airpocket-soundman/tab5-tang-primer20k-carrier/site/img/render_bottom.png

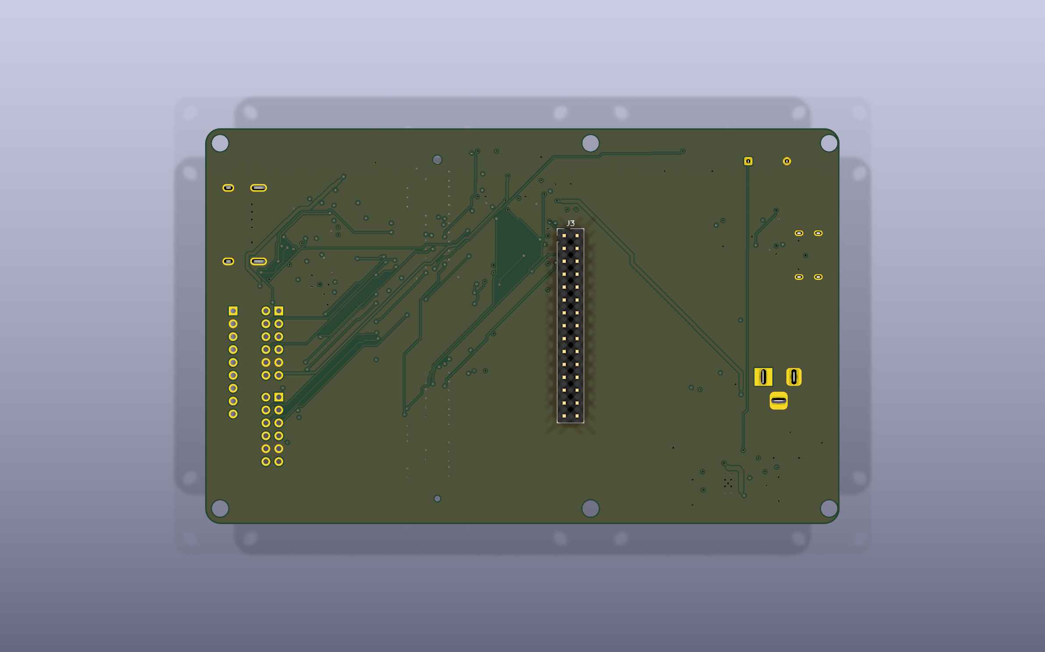
site/img/render_bottom.png
