airpocket-soundman/tab5-tang-primer20k-carrier/site/img/render_top_r2.png

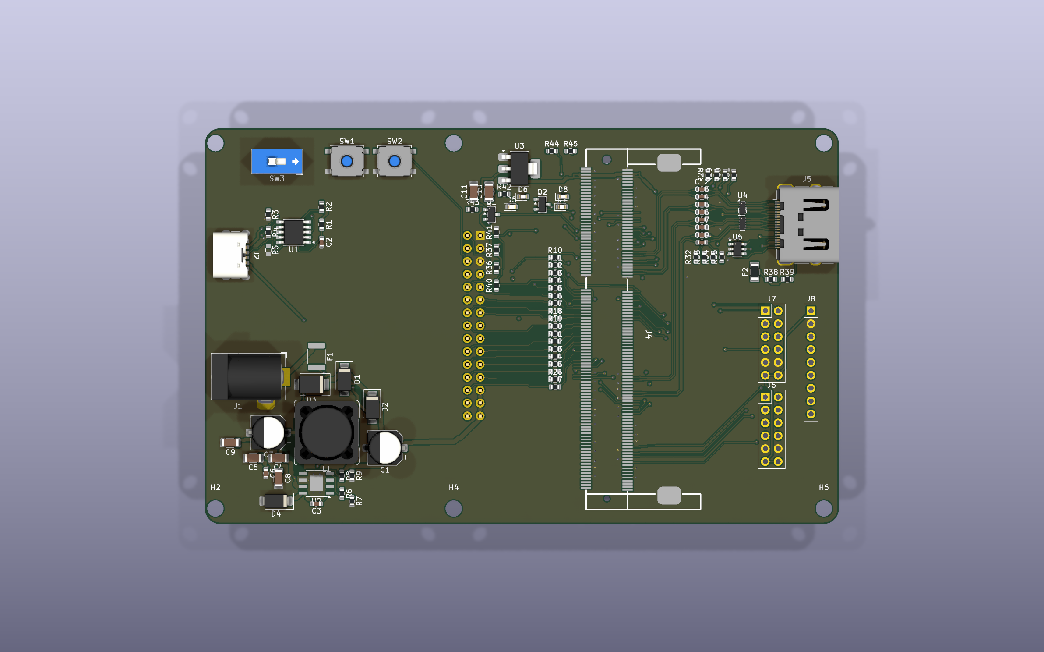
site/img/render_top_r2.png
