airpocket-soundman/tab5-tang-primer20k-carrier/spark/single-sided-r4/full/README.md

# Spark フル版：片面SMT・スイッチ省略 r4

2026-10-26。125×78mm、4層、HDMI・USB PD12V・バレル12Vを維持。
SMTは全て表面。J3（Tab5接続、LCSC C56496）は別購入・手はんだ、PCBA BOM/CPLから除外。
主電源SW3とFPGA専用停止SW3はどちらも搭載しない。外部給電が有効なら電源回路が動作する。

PCBA見積もり候補は101点・43行。J1/JP1等THTの実装受理は業者確認が必要。
U11/R53〜R58/C25/C26はr3の主電源追加部品であり、r4にはない。
部品はLCSC優先。Tab5、Tang Primer 20K Coreはユーザー購入。

設計側PCB DRC0、未接続0、ERCエラー0。ERC警告163件（ライブラリシンボル不一致160件＋孤立ピンラベル3件）。通信・電源の32項目適合、回路図ピン照合一致。
EasyEDA反映とEasyEDA内での実計算は完了。Full207ケース、Lite221ケース。両版PCB DRC0、回路図fatal0/warn13（件数のみ取得、未分類）。
製造業者の部品受理・配置プレビュー・DFMは未承認。コピーされた旧版の検証結果をr4の再計算結果として扱わない。

見積もりデータはdesign/manufacturing以下。BOM/CPLのJ3除外・集合一致を確認済み。
元設計、r2/r3、表面移設の試行は保存し、r4と混用しない。

設計側の電源過渡解析をr4で再実行。Full6件は6件完走・数値範囲内。Liteはスイッチ動作ケースを除く20件が完走し18件が数値範囲内。Liteの50mA負荷と低速LDOループ感度ケースは範囲外であり、通常のローカル3.3V負荷は10mA以内・外部3.3V負荷なしを前提とする。平均化電源モデルであり、物理・熱・実スイッチングの実証ではない。
