airpocket-soundman/tab5-tang-primer20k-carrier/spark/single-sided-r4/quotation-2026-10-26/README.txt

Stars / Spark r4：片面SMT、スイッチ省略。見積もり専用 2026-10-26

Full 125×78mm：4層、PCBA候補101点/43行。
Lite A 99×78mm：4層、PCBA候補103点/43行。
SMTは表面のみ。裏面SMT部品なし。
J3（Tab5用ピンヘッダー）はPCBAから除外。C56496をLCSC別購入し手はんだ。
J3の裏向き嵌合方向は維持。手はんだによる裏面THT取付は、両面SMTではない。
主電源スイッチと旧FPGA専用停止SW3はいずれも省略。
r3のU11/R53〜R58/C25/C26は非搭載ではなくこの設計に存在しない。

JLCPCBには各版の内側gerbers.zip、jlc-bom.csv、jlc-cpl.csvを一組でアップロード。
部品表のLCSC Part #列を部品番号列に明示的に割り当てる。自動マッチで変更された品番は未承認。
SMT片面、表面実装を指定。J1/JP1のTHTを含む全品の受理・工程は業者に確認する。
J1/JP1が実装不可なら同じLCSC部品の別購入・手はんだが必要。
Tab5、Tang Primer 20K Core、ケーブルはPCBA見積もりに含まない。
数量・板厚・銅厚・表面処理・送料・税はこの一式では確定しない。

両版で設計側PCB DRC0/未接続0、ERCエラー0、ERC警告はFull163件／Lite164件（ライブラリシンボル不一致160／161件＋孤立ピンラベル各3件）、通信・電源32項目適合。
EasyEDA反映・同側実計算完了（Full207/Lite221件）。両版PCB DRC0、回路図fatal0/warn13（未分類）。最終製造リリースではない。
r3両面実装の見積もり一式と公開済みの旧ファイルを混ぜないこと。
