airpocket-soundman/tab5-tang-primer20k-carrier/docs/reference/tang-primer-20k/Readme.txt

#####
For Tang_Primer_20K_Dock_Lite: Version 3710 & 3711 share the same schematic.
If you have the version 3710, please also refer to the schematic version 3711.
The new version contains a number of bug fixes.

#####
For Tang_Primer_20K_Dock:
Version 3714 an upgraded version with minor refinements.
Version 3710 & 3711 & 3712 & 3713 share the same schematic.
If you have the version 3710, 3711, 3712, 3713,  
please also refer to the schematic version 3713.
The new version contains a number of bug fixes.
The older version 3708 or 3709 is archived in the old folder.
