airpocket-soundman/tab5-tang-primer20k-carrier/spark/MAIN_POWER_REQUIREMENT.md

# 主電源仕様の訂正（2026-10-26）

ユーザー確認：必要なのはオルタネート式の主電源ON/OFF。外部給電だけを切り、Tab5の内蔵バッテリー動作は停止させない。FPGA専用停止スイッチは要求されていない。

## 対象

- フル125×78mm、廉価版A99×78mmの両方。
- USB PD12VとDCジャック12Vの両入力に対して有効。
- 入力の保護・逆流防止/OR合流後、Tab5 HVINとFPGA用降圧回路へ分岐する前を主電源の制御対象とする。
- 主電源ON：Tab5 HVINとCore用5V/キャリア局所3.3Vへ外部給電。
- 主電源OFF：上記への外部給電を停止。Tab5の内蔵バッテリーと本体電源操作は変更しない。
- 押すごとにON/OFF状態を保持するオルタネート動作。既存のDIPスイッチによるBUCK_EN接地は代用にならない。
- 独立したFPGA停止SW3は削除・置換対象。リセット/ユーザーボタンとBUS ARMは別機能として保持する。

## 変更時の確認

主電源の接点/電力スイッチは12V DC、Tab5+Coreの合計負荷、突入電流、接触抵抗、開閉寿命に適合させる。小信号スイッチの100mA等の定格をそのまま主電流に適用しない。LCSCを優先し、PCBA可否とメーカー図面によるランド/機構を照合する。

Tab5がバッテリーで動作しCoreが無給電の状態で、通信・側帯信号からFPGAへ逆給電しないことを再確認する。既存の電源監視・バス分離・ARMの安全側初期状態を維持する。USB-Cへの逆流防止も保持する。

KiCadで回路/基板変更とシミュレーション、EasyEDAへの反映、EasyEDA内で同条件再計算・照合の順序を維持する。以前のSW3停止試験を新しい主電源の検証済み結果として再利用しない。

Linux/GPU/外部メモリ研究の目的・独立ソフト/ビットストリーム・GPIO割当は維持。電源切替時の通信断はソフトウェア側の既存タイムアウト/リセット要求との整合を確認する。外部DDR3は透過的な主記憶増設ではない。

**状態：要求確定。公開中のepro2/BOMは旧SW3構成であり、この変更は未反映。新しい主電源の品番・配置・解析が確定するまで発注対象にしない。**
