airpocket-soundman/tab5-tang-primer20k-carrier/fpga/validation/npu-ddr-4e20-2026-11-07/report.md

# NPU DDR core diagnostic checkpoint (2026-11-07)

The integrated core wires the packet endpoint and DDR Conv loader through one held-toggle arbiter, unchanged MEMV1 bridge/adapter, and shared4KiB write/read staging RAMs. Only the Conv loader owns staging while conv_busy; the SYS endpoint serializes host commands and rejects overlapping work. Controller reset/PLLhold and physical DDR wrapper preserve the established MEMV1 design. Memory-ready synchronizes through2 SYS stages and256-cycle settle, resets loader/arbiter andUSERoperation state on loss, increments generation (physical reset only resets generation), and clears bound token. A3-SYS configuration reset initializes the framer even if physical reset remains high during FPGA SRAM configuration.

The pin-level test uses the actual framer/core/arbiter/bridge/adapter/RAM/kernel at SYS≈27MHz/USER≈99.56MHz and a native DDR model with correct APP_ROW_PAD1 inverse mapping and ready stalls.64 commands passed: max2032B write/1024B read CRC,16KiB row crossing, last16B of128MiB and overrun rejection, IC16+3 Conv DMA and complete INT32/guard validation, bad/truncated writes with no effects, memory-not-ready caps/status, token binding, calibration loss during host and Conv requests, stale partial rejection after rebind, fresh upload/recompute, generation preservation across ARM, and physical reset recovery. No DDR PHY or board behavior is inferred from simulation.

The first Gowin Education implementation fits:10366 logic,5779 registers,38/46 BSRAM,5/24 DSP. It generates USERcode4E20 and the .fs, but is **not timing-qualified**. With only the3 explicitly related clocks and no exceptions, reports show1408 setup/107 hold violations across vendor/internal resets, held metadata bundles and first CDC stages. Same-domain TNS is0, reported SYS Fmax42.333MHz andUSER109.382MHz. This is a diagnostic checkpoint, not sign-off.

First30 setup paths classify vendor internal12, our held-response11, our held-request7. First30 hold paths are vendor internal3, held-response26, first-sampler1. Recovery first30 include25 vendor reset boundaries,2 vendor internal,3 other CDC. Removal first30 are positive USER same-domain paths. Exact nodes/slacks are in timing-classification.json. No blanket asynchronous-clock waiver has been added. Held payloads have protocol-derived stability windows (response≥2SYS periods, request≥3USER periods) that may justify specific max-delay/hold exceptions after endpoint review; vendor reset/CDC requires separate review.

All8 tested RTL hashes match the implemented source snapshot (proof-source-match.json). Keep vendor encrypted source out of Git; record its pinned hash and reference instead. Programming and controlled128MiB/Conv hardware golden qualification are owned by the parent task and were not performed here.
