airpocket-soundman/tab5-tang-primer20k-carrier/spark/design/easyeda/schematic-netlist.txt

{
    "version": "2.0.0",
    "components": {
        "51bfc0e5166a1c40": {
            "props": {
                "Add into BOM": "yes",
                "Convert to PCB": "yes",
                "Name": "Connector_Barrel_Jack",
                "Device": "44e7ae05c9875e8f",
                "Designator": "J1",
                "Footprint": "60f63300c7161e95",
                "Value": "MJ-179PH",
                "UserDocLink": "",
                "Description": "",
                "ki_keywords": "",
                "ki_fp_filters": "",
                "Symbol": "a6304a09a2937aa2",
                "Comment": "Akizuki106568 manual assembly; center positive stabilized12V only; manufacturer slot drawing adapted; pad2/3 grounded",
                "Origin Footprint": "carrier:BarrelJack_MJ179PH_Akizuki106568",
                "Unique ID": "51bfc0e5166a1c40",
                "Manufacturer": "",
                "Manufacturer Part": "",
                "Supplier": "Akizuki",
                "Supplier Part": "1",
                "LCSC": "",
                "Group ID": "",
                "Channel ID": "$2ie37",
                "Reuse Block": "",
                "DeviceName": "Connector_Barrel_Jack",
                "FootprintName": "carrier:BarrelJack_MJ179PH_Akizuki106568"
            },
            "pinInfoMap": {
                "1": {
                    "name": "",
                    "number": "1",
                    "net": "DC_RAW",
                    "props": {
                        "Pin Number": "1"
                    }
                },
                "2": {
                    "name": "",
                    "number": "2",
                    "net": "GND",
                    "props": {
                        "Pin Number": "2"
                    }
                }
            }
        },
        "09f31a4987c8a883": {
            "props": {
                "Add into BOM": "yes",
                "Convert to PCB": "yes",
                "Name": "Device_Polyfuse",
                "Device": "4e1f7fc7f8494827",
                "Designator": "F1",
                "Footprint": "28b242f2aa997a49",
                "Value": "PTC 3A hold",
                "UserDocLink": "",
                "Description": "",
                "ki_keywords": "",
                "ki_fp_filters": "",
                "Symbol": "c382bbec9e75422f",
                "LCSC": "C47002391",
                "Origin Footprint": "Fuse:Fuse_1812_4532Metric",
                "Unique ID": "09f31a4987c8a883",
                "Manufacturer": "",
                "Manufacturer Part": "",
                "Supplier": "LCSC",
                "Supplier Part": "C47002391",
                "Comment": "",
                "Group ID": "",
                "Channel ID": "$2ie47",
                "Reuse Block": "",
                "DeviceName": "Device_Polyfuse",
                "FootprintName": "Fuse_1812_4532Metric"
            },
            "pinInfoMap": {
                "1": {
                    "name": "",
                    "number": "1",
                    "net": "DC_RAW",
                    "props": {
                        "Pin Number": "1"
                    }
                },
                "2": {
                    "name": "",
                    "number": "2",
                    "net": "DC_IN",
                    "props": {
                        "Pin Number": "2"
                    }
                }
            }
        },
        "6eb2f7ba7a12821c": {
            "props": {
                "Add into BOM": "yes",
                "Convert to PCB": "yes",
                "Name": "Device_D_Schottky",
                "Device": "d3ddc644d9a554ad",
                "Designator": "D1",
                "Footprint": "4ee42137ec565186",
                "Value": "SS54",
                "UserDocLink": "",
                "Description": "",
                "ki_keywords": "",
                "ki_fp_filters": "",
                "Symbol": "cfe2022f371c70b2",
                "LCSC": "C22452",
                "Comment": "reverse-polarity + OR (DC jack)",
                "Origin Footprint": "Diode_SMD:D_SMA",
                "Unique ID": "6eb2f7ba7a12821c",
                "Manufacturer": "",
                "Manufacturer Part": "",
                "Supplier": "LCSC",
                "Supplier Part": "C22452",
                "Group ID": "",
                "Channel ID": "$2ie57",
                "Reuse Block": "",
                "DeviceName": "Device_D_Schottky",
                "FootprintName": "D_SMA"
            },
            "pinInfoMap": {
                "1": {
                    "name": "K",
                    "number": "1",
                    "net": "VIN",
                    "props": {
                        "Pin Number": "1"
                    }
                },
                "2": {
                    "name": "A",
                    "number": "2",
                    "net": "DC_IN",
                    "props": {
                        "Pin Number": "2"
                    }
                }
            }
        },
        "cca08e5caf06c018": {
            "props": {
                "Add into BOM": "yes",
                "Convert to PCB": "yes",
                "Name": "Device_D_Schottky",
                "Device": "d3ddc644d9a554ad",
                "Designator": "D2",
                "Footprint": "4ee42137ec565186",
                "Value": "SS54",
                "UserDocLink": "",
                "Description": "",
                "ki_keywords": "",
                "ki_fp_filters": "",
                "Symbol": "cfe2022f371c70b2",
                "LCSC": "C22452",
                "Comment": "OR (USB-C PD)",
                "Origin Footprint": "Diode_SMD:D_SMA",
                "Unique ID": "cca08e5caf06c018",
                "Manufacturer": "",
                "Manufacturer Part": "",
                "Supplier": "LCSC",
                "Supplier Part": "C22452",
                "Group ID": "",
                "Channel ID": "$2ie68",
                "Reuse Block": "",
                "DeviceName": "Device_D_Schottky",
                "FootprintName": "D_SMA"
            },
            "pinInfoMap": {
                "1": {
                    "name": "K",
                    "number": "1",
                    "net": "VIN",
                    "props": {
                        "Pin Number": "1"
                    }
                },
                "2": {
                    "name": "A",
                    "number": "2",
                    "net": "VBUS_PD",
                    "props": {
                        "Pin Number": "2"
                    }
                }
            }
        },
        "81689f1d3303caec": {
            "props": {
                "Add into BOM": "yes",
                "Convert to PCB": "yes",
                "Name": "Device_D_TVS",
                "Device": "151271085e469eeb",
                "Designator": "D3",
                "Footprint": "fbf593d40eae07ec",
                "Value": "SMBJ15A",
                "UserDocLink": "",
                "Description": "",
                "ki_keywords": "",
                "ki_fp_filters": "",
                "Symbol": "69e249b4c76e0e9e",
                "LCSC": "C699013",
                "Comment": "YANGJIE 15V standoff, 24.4V specified clamp; regulated 12V PoC input only",
                "Origin Footprint": "Diode_SMD:D_SMB",
                "Unique ID": "81689f1d3303caec",
                "Manufacturer": "",
                "Manufacturer Part": "",
                "Supplier": "LCSC",
                "Supplier Part": "C699013",
                "Group ID": "",
                "Channel ID": "$2ie79",
                "Reuse Block": "",
                "DeviceName": "Device_D_TVS",
                "FootprintName": "D_SMB"
            },
            "pinInfoMap": {
                "1": {
                    "name": "A1",
                    "number": "1",
                    "net": "VIN",
                    "props": {
                        "Pin Number": "1"
                    }
                },
                "2": {
                    "name": "A2",
                    "number": "2",
                    "net": "GND",
                    "props": {
                        "Pin Number": "2"
                    }
                }
            }
        },
        "b4693cfd16d534cd": {
            "props": {
                "Add into BOM": "yes",
                "Convert to PCB": "yes",
                "Name": "Device_C_Polarized",
                "Device": "570abc226590f959",
                "Designator": "C1",
                "Footprint": "32cfff82c648e20e",
                "Value": "100u/35V",
                "UserDocLink": "",
                "Description": "",
                "ki_keywords": "",
                "ki_fp_filters": "",
                "Symbol": "c8039e3260078d75",
                "LCSC": "C2983388",
                "Origin Footprint": "Capacitor_SMD:CP_Elec_6.3x7.7",
                "Unique ID": "b4693cfd16d534cd",
                "Manufacturer": "",
                "Manufacturer Part": "",
                "Supplier": "LCSC",
                "Supplier Part": "C2983388",
                "Comment": "",
                "Group ID": "",
                "Channel ID": "$2ie90",
                "Reuse Block": "",
                "DeviceName": "Device_C_Polarized",
                "FootprintName": "CP_Elec_6.3x7.7"
            },
            "pinInfoMap": {
                "1": {
                    "name": "",
                    "number": "1",
                    "net": "VIN",
                    "props": {
                        "Pin Number": "1"
                    }
                },
                "2": {
                    "name": "",
                    "number": "2",
                    "net": "GND",
                    "props": {
                        "Pin Number": "2"
                    }
                }
            }
        },
        "1fb9863844ab5169": {
            "props": {
                "Add into BOM": "yes",
                "Convert to PCB": "yes",
                "Name": "Connector_USB_C_Receptacle_PowerOnly_6P",
                "Device": "6003b3d87a38ea01",
                "Designator": "J2",
                "Footprint": "c9dfdb5aba9e1038",
                "Value": "USB-C PD in",
                "UserDocLink": "",
                "Description": "",
                "ki_keywords": "",
                "ki_fp_filters": "",
                "Symbol": "84d8338b97269fd0",
                "LCSC": "C5246813",
                "Comment": "power-only USB-C 6P receptacle",
                "Origin Footprint": "Connector_USB:USB_C_Receptacle_GCT_USB4125-xx-x-0190_6P_TopMnt_Horizontal",
                "Unique ID": "1fb9863844ab5169",
                "Manufacturer": "",
                "Manufacturer Part": "",
                "Supplier": "LCSC",
                "Supplier Part": "C5246813",
                "Group ID": "",
                "Channel ID": "$2ie100",
                "Reuse Block": "",
                "DeviceName": "Connector_USB_C_Receptacle_PowerOnly_6P",
                "FootprintName": "USB_C_Receptacle_GCT_USB4125-xx-x-0190_6P_TopMnt_Horizontal"
            },
            "pinInfoMap": {
                "A5": {
                    "name": "CC1",
                    "number": "A5",
                    "net": "CC1",
                    "props": {
                        "Pin Number": "A5"
                    }
                },
                "A9": {
                    "name": "VBUS",
                    "number": "A9",
                    "net": "VBUS_PD",
                    "props": {
                        "Pin Number": "A9"
                    }
                },
                "A12": {
                    "name": "GND",
                    "number": "A12",
                    "net": "GND",
                    "props": {
                        "Pin Number": "A12"
                    }
                },
                "B5": {
                    "name": "CC2",
                    "number": "B5",
                    "net": "CC2",
                    "props": {
                        "Pin Number": "B5"
                    }
                },
                "B9": {
                    "name": "VBUS",
                    "number": "B9",
                    "net": "VBUS_PD",
                    "props": {
                        "Pin Number": "B9"
                    }
                },
                "B12": {
                    "name": "GND",
                    "number": "B12",
                    "net": "GND",
                    "props": {
                        "Pin Number": "B12"
                    }
                },
                "SH": {
                    "name": "SHIELD",
                    "number": "SH",
                    "net": "GND",
                    "props": {
                        "Pin Number": "SH"
                    }
                }
            }
        },
        "1bdc0ab44f99f92d": {
            "props": {
                "Add into BOM": "yes",
                "Convert to PCB": "yes",
                "Name": "Interface_USB_CH224K",
                "Device": "f4e13c3352c916ae",
                "Designator": "U1",
                "Value": "CH224K",
                "UserDocLink": "",
                "Description": "",
                "ki_keywords": "",
                "ki_fp_filters": "",
                "Origin Footprint": "Package_SO:SSOP-10-1EP_3.9x4.9mm_P1mm_EP2.1x3.3mm",
                "Symbol": "a7267d86b78a6465",
                "LCSC": "C970725",
                "Comment": "PD sink, 12V request: CFG1=0 CFG2=0 CFG3=1(internal PU)",
                "Unique ID": "1bdc0ab44f99f92d",
                "Manufacturer": "",
                "Manufacturer Part": "",
                "Supplier": "LCSC",
                "Supplier Part": "C970725",
                "Footprint": "530feb5bd26552e7",
                "Group ID": "",
                "Channel ID": "$2ie111",
                "Reuse Block": "",
                "DeviceName": "Interface_USB_CH224K",
                "FootprintName": "SSOP-10-1EP_3.9x4.9mm_P1mm_EP2.1x3.3mm"
            },
            "pinInfoMap": {
                "1": {
                    "name": "VDD",
                    "number": "1",
                    "net": "PD_VDD",
                    "props": {
                        "Pin Number": "1"
                    }
                },
                "2": {
                    "name": "CFG2",
                    "number": "2",
                    "net": "PD_CFG2",
                    "props": {
                        "Pin Number": "2"
                    }
                },
                "3": {
                    "name": "CFG3",
                    "number": "3",
                    "net": "PD_CFG3",
                    "props": {
                        "Pin Number": "3"
                    }
                },
                "4": {
                    "name": "DP",
                    "number": "4",
                    "net": "",
                    "props": {
                        "Pin Number": "4"
                    }
                },
                "5": {
                    "name": "DM",
                    "number": "5",
                    "net": "",
                    "props": {
                        "Pin Number": "5"
                    }
                },
                "6": {
                    "name": "CC2",
                    "number": "6",
                    "net": "CC2",
                    "props": {
                        "Pin Number": "6"
                    }
                },
                "7": {
                    "name": "CC1",
                    "number": "7",
                    "net": "CC1",
                    "props": {
                        "Pin Number": "7"
                    }
                },
                "8": {
                    "name": "VBUS",
                    "number": "8",
                    "net": "PD_VBUS_S",
                    "props": {
                        "Pin Number": "8"
                    }
                },
                "9": {
                    "name": "CFG1",
                    "number": "9",
                    "net": "PD_CFG1",
                    "props": {
                        "Pin Number": "9"
                    }
                },
                "10": {
                    "name": "PG",
                    "number": "10",
                    "net": "PD_PG",
                    "props": {
                        "Pin Number": "10"
                    }
                },
                "11": {
                    "name": "GND",
                    "number": "11",
                    "net": "GND",
                    "props": {
                        "Pin Number": "11"
                    }
                }
            }
        },
        "353b166cc2dee846": {
            "props": {
                "Add into BOM": "yes",
                "Convert to PCB": "yes",
                "Name": "Device_R",
                "Device": "dce15ae5d8c4adea",
                "Designator": "R1",
                "Footprint": "840d5114b71a38b1",
                "Value": "10k",
                "UserDocLink": "",
                "Description": "",
                "ki_keywords": "",
                "ki_fp_filters": "",
                "Symbol": "1a6aa3fb7f7fd24f",
                "LCSC": "C25804",
                "Origin Footprint": "Resistor_SMD:R_0603_1608Metric",
                "Unique ID": "353b166cc2dee846",
                "Manufacturer": "",
                "Manufacturer Part": "",
                "Supplier": "LCSC",
                "Supplier Part": "C25804",
                "Comment": "",
                "Group ID": "",
                "Channel ID": "$2ie122",
                "Reuse Block": "",
                "DeviceName": "Device_R",
                "FootprintName": "R_0603_1608Metric"
            },
            "pinInfoMap": {
                "1": {
                    "name": "",
                    "number": "1",
                    "net": "VBUS_PD",
                    "props": {
                        "Pin Number": "1"
                    }
                },
                "2": {
                    "name": "",
                    "number": "2",
                    "net": "PD_VDD",
                    "props": {
                        "Pin Number": "2"
                    }
                }
            }
        },
        "a2c5d49bc5dde298": {
            "props": {
                "Add into BOM": "yes",
                "Convert to PCB": "yes",
                "Name": "Device_C",
                "Device": "ce3f9b769b7a157b",
                "Designator": "C2",
                "Footprint": "6f3d185220f7d357",
                "Value": "1u/50V",
                "UserDocLink": "",
                "Description": "",
                "ki_keywords": "",
                "ki_fp_filters": "",
                "Symbol": "e542132018ff745e",
                "LCSC": "C15849",
                "Origin Footprint": "Capacitor_SMD:C_0603_1608Metric",
                "Unique ID": "a2c5d49bc5dde298",
                "Manufacturer": "",
                "Manufacturer Part": "",
                "Supplier": "LCSC",
                "Supplier Part": "C15849",
                "Comment": "",
                "Group ID": "",
                "Channel ID": "$2ie132",
                "Reuse Block": "",
                "DeviceName": "Device_C",
                "FootprintName": "C_0603_1608Metric"
            },
            "pinInfoMap": {
                "1": {
                    "name": "",
                    "number": "1",
                    "net": "PD_VDD",
                    "props": {
                        "Pin Number": "1"
                    }
                },
                "2": {
                    "name": "",
                    "number": "2",
                    "net": "GND",
                    "props": {
                        "Pin Number": "2"
                    }
                }
            }
        },
        "6f63fc6711cfa315": {
            "props": {
                "Add into BOM": "yes",
                "Convert to PCB": "yes",
                "Name": "Device_R",
                "Device": "dce15ae5d8c4adea",
                "Designator": "R2",
                "Footprint": "840d5114b71a38b1",
                "Value": "1k",
                "UserDocLink": "",
                "Description": "",
                "ki_keywords": "",
                "ki_fp_filters": "",
                "Symbol": "1a6aa3fb7f7fd24f",
                "LCSC": "C21190",
                "Origin Footprint": "Resistor_SMD:R_0603_1608Metric",
                "Unique ID": "6f63fc6711cfa315",
                "Manufacturer": "",
                "Manufacturer Part": "",
                "Supplier": "LCSC",
                "Supplier Part": "C21190",
                "Comment": "",
                "Group ID": "",
                "Channel ID": "$2ie142",
                "Reuse Block": "",
                "DeviceName": "Device_R",
                "FootprintName": "R_0603_1608Metric"
            },
            "pinInfoMap": {
                "1": {
                    "name": "",
                    "number": "1",
                    "net": "VBUS_PD",
                    "props": {
                        "Pin Number": "1"
                    }
                },
                "2": {
                    "name": "",
                    "number": "2",
                    "net": "PD_VBUS_S",
                    "props": {
                        "Pin Number": "2"
                    }
                }
            }
        },
        "fe89d0632cfce75f": {
            "props": {
                "Add into BOM": "yes",
                "Convert to PCB": "yes",
                "Name": "Device_R",
                "Device": "dce15ae5d8c4adea",
                "Designator": "R3",
                "Footprint": "840d5114b71a38b1",
                "Value": "0R",
                "UserDocLink": "",
                "Description": "",
                "ki_keywords": "",
                "ki_fp_filters": "",
                "Symbol": "1a6aa3fb7f7fd24f",
                "LCSC": "C21189",
                "Comment": "CFG1 low (fit)",
                "Origin Footprint": "Resistor_SMD:R_0603_1608Metric",
                "Unique ID": "fe89d0632cfce75f",
                "Manufacturer": "",
                "Manufacturer Part": "",
                "Supplier": "LCSC",
                "Supplier Part": "C21189",
                "Group ID": "",
                "Channel ID": "$2ie152",
                "Reuse Block": "",
                "DeviceName": "Device_R",
                "FootprintName": "R_0603_1608Metric"
            },
            "pinInfoMap": {
                "1": {
                    "name": "",
                    "number": "1",
                    "net": "PD_CFG1",
                    "props": {
                        "Pin Number": "1"
                    }
                },
                "2": {
                    "name": "",
                    "number": "2",
                    "net": "GND",
                    "props": {
                        "Pin Number": "2"
                    }
                }
            }
        },
        "fdc86a4b576d9e98": {
            "props": {
                "Add into BOM": "no",
                "Convert to PCB": "yes",
                "Name": "Device_R",
                "Device": "dce15ae5d8c4adea",
                "Designator": "R4",
                "Footprint": "840d5114b71a38b1",
                "Value": "0R",
                "UserDocLink": "",
                "Description": "",
                "ki_keywords": "",
                "ki_fp_filters": "",
                "Symbol": "1a6aa3fb7f7fd24f",
                "LCSC": "C21189",
                "Comment": "Must remain DNP: CFG3 internal pull-up for 12V request",
                "Origin Footprint": "Resistor_SMD:R_0603_1608Metric",
                "Unique ID": "fdc86a4b576d9e98",
                "Manufacturer": "",
                "Manufacturer Part": "",
                "Supplier": "LCSC",
                "Supplier Part": "C21189",
                "Group ID": "",
                "Channel ID": "$2ie163",
                "Reuse Block": "",
                "DeviceName": "Device_R",
                "FootprintName": "R_0603_1608Metric"
            },
            "pinInfoMap": {
                "1": {
                    "name": "",
                    "number": "1",
                    "net": "PD_CFG3",
                    "props": {
                        "Pin Number": "1"
                    }
                },
                "2": {
                    "name": "",
                    "number": "2",
                    "net": "GND",
                    "props": {
                        "Pin Number": "2"
                    }
                }
            }
        },
        "9cdd622c9eeecfe7": {
            "props": {
                "Add into BOM": "yes",
                "Convert to PCB": "yes",
                "Name": "Device_R",
                "Device": "dce15ae5d8c4adea",
                "Designator": "R5",
                "Footprint": "840d5114b71a38b1",
                "Value": "0R",
                "UserDocLink": "",
                "Description": "",
                "ki_keywords": "",
                "ki_fp_filters": "",
                "Symbol": "1a6aa3fb7f7fd24f",
                "LCSC": "C21189",
                "Comment": "Fitted: CFG2 low, CFG1 low, CFG3 high -> 12V",
                "Origin Footprint": "Resistor_SMD:R_0603_1608Metric",
                "Unique ID": "9cdd622c9eeecfe7",
                "Manufacturer": "",
                "Manufacturer Part": "",
                "Supplier": "LCSC",
                "Supplier Part": "C21189",
                "Group ID": "",
                "Channel ID": "$2ie174",
                "Reuse Block": "",
                "DeviceName": "Device_R",
                "FootprintName": "R_0603_1608Metric"
            },
            "pinInfoMap": {
                "1": {
                    "name": "",
                    "number": "1",
                    "net": "PD_CFG2",
                    "props": {
                        "Pin Number": "1"
                    }
                },
                "2": {
                    "name": "",
                    "number": "2",
                    "net": "GND",
                    "props": {
                        "Pin Number": "2"
                    }
                }
            }
        },
        "48f0ae2437312dae": {
            "props": {
                "Add into BOM": "yes",
                "Convert to PCB": "yes",
                "Name": "Regulator_Switching_TPS5430DDA",
                "Device": "3eb9113f27af965f",
                "Designator": "U2",
                "Value": "TPS5430DDAR",
                "UserDocLink": "",
                "Description": "",
                "ki_keywords": "",
                "ki_fp_filters": "",
                "Origin Footprint": "Package_SO:TI_SO-PowerPAD-8_ThermalVias",
                "Symbol": "860f7642b2115685",
                "LCSC": "C9864",
                "Unique ID": "48f0ae2437312dae",
                "Manufacturer": "",
                "Manufacturer Part": "",
                "Supplier": "LCSC",
                "Supplier Part": "C9864",
                "Footprint": "aba8afa3fc1c660b",
                "Comment": "",
                "Group ID": "",
                "Channel ID": "$2ie185",
                "Reuse Block": "",
                "DeviceName": "Regulator_Switching_TPS5430DDA",
                "FootprintName": "TI_SO-PowerPAD-8_ThermalVias"
            },
            "pinInfoMap": {
                "1": {
                    "name": "BOOT",
                    "number": "1",
                    "net": "BUCK_BOOT",
                    "props": {
                        "Pin Number": "1"
                    }
                },
                "2": {
                    "name": "NC",
                    "number": "2",
                    "net": "",
                    "props": {
                        "Pin Number": "2"
                    }
                },
                "3": {
                    "name": "NC",
                    "number": "3",
                    "net": "",
                    "props": {
                        "Pin Number": "3"
                    }
                },
                "4": {
                    "name": "VSENSE",
                    "number": "4",
                    "net": "BUCK_FB",
                    "props": {
                        "Pin Number": "4"
                    }
                },
                "5": {
                    "name": "EN",
                    "number": "5",
                    "net": "BUCK_EN",
                    "props": {
                        "Pin Number": "5"
                    }
                },
                "6": {
                    "name": "GND",
                    "number": "6",
                    "net": "GND",
                    "props": {
                        "Pin Number": "6"
                    }
                },
                "7": {
                    "name": "VIN",
                    "number": "7",
                    "net": "VIN",
                    "props": {
                        "Pin Number": "7"
                    }
                },
                "8": {
                    "name": "PH",
                    "number": "8",
                    "net": "BUCK_PH",
                    "props": {
                        "Pin Number": "8"
                    }
                },
                "9": {
                    "name": "GNDPAD",
                    "number": "9",
                    "net": "GND",
                    "props": {
                        "Pin Number": "9"
                    }
                }
            }
        },
        "cc82bf2c2e22e605": {
            "props": {
                "Add into BOM": "yes",
                "Convert to PCB": "yes",
                "Name": "Device_C",
                "Device": "ce3f9b769b7a157b",
                "Designator": "C3",
                "Footprint": "6f3d185220f7d357",
                "Value": "10n",
                "UserDocLink": "",
                "Description": "",
                "ki_keywords": "",
                "ki_fp_filters": "",
                "Symbol": "e542132018ff745e",
                "LCSC": "C57112",
                "Origin Footprint": "Capacitor_SMD:C_0603_1608Metric",
                "Unique ID": "cc82bf2c2e22e605",
                "Manufacturer": "",
                "Manufacturer Part": "",
                "Supplier": "LCSC",
                "Supplier Part": "C57112",
                "Comment": "",
                "Group ID": "",
                "Channel ID": "$2ie195",
                "Reuse Block": "",
                "DeviceName": "Device_C",
                "FootprintName": "C_0603_1608Metric"
            },
            "pinInfoMap": {
                "1": {
                    "name": "",
                    "number": "1",
                    "net": "BUCK_BOOT",
                    "props": {
                        "Pin Number": "1"
                    }
                },
                "2": {
                    "name": "",
                    "number": "2",
                    "net": "BUCK_PH",
                    "props": {
                        "Pin Number": "2"
                    }
                }
            }
        },
        "d450ceac7adb81c3": {
            "props": {
                "Add into BOM": "yes",
                "Convert to PCB": "yes",
                "Name": "Device_L",
                "Device": "4dd5693372706ba6",
                "Designator": "L1",
                "Footprint": "41f10aa4d5b7be1d",
                "Value": "15u/4A",
                "UserDocLink": "",
                "Description": "",
                "ki_keywords": "",
                "ki_fp_filters": "",
                "Symbol": "64ce33953119c3cd",
                "LCSC": "C2041333",
                "Origin Footprint": "Inductor_SMD:L_Bourns_SRR1260",
                "Unique ID": "d450ceac7adb81c3",
                "Manufacturer": "",
                "Manufacturer Part": "",
                "Supplier": "LCSC",
                "Supplier Part": "C2041333",
                "Comment": "",
                "Group ID": "",
                "Channel ID": "$2ie205",
                "Reuse Block": "",
                "DeviceName": "Device_L",
                "FootprintName": "L_Bourns_SRR1260"
            },
            "pinInfoMap": {
                "1": {
                    "name": "1",
                    "number": "1",
                    "net": "BUCK_PH",
                    "props": {
                        "Pin Number": "1"
                    }
                },
                "2": {
                    "name": "2",
                    "number": "2",
                    "net": "+5V",
                    "props": {
                        "Pin Number": "2"
                    }
                }
            }
        },
        "6a4368da87585c93": {
            "props": {
                "Add into BOM": "yes",
                "Convert to PCB": "yes",
                "Name": "Device_D_Schottky",
                "Device": "d3ddc644d9a554ad",
                "Designator": "D4",
                "Footprint": "4ee42137ec565186",
                "Value": "SS54",
                "UserDocLink": "",
                "Description": "",
                "ki_keywords": "",
                "ki_fp_filters": "",
                "Symbol": "cfe2022f371c70b2",
                "LCSC": "C22452",
                "Comment": "catch diode",
                "Origin Footprint": "Diode_SMD:D_SMA",
                "Unique ID": "6a4368da87585c93",
                "Manufacturer": "",
                "Manufacturer Part": "",
                "Supplier": "LCSC",
                "Supplier Part": "C22452",
                "Group ID": "",
                "Channel ID": "$2ie215",
                "Reuse Block": "",
                "DeviceName": "Device_D_Schottky",
                "FootprintName": "D_SMA"
            },
            "pinInfoMap": {
                "1": {
                    "name": "K",
                    "number": "1",
                    "net": "BUCK_PH",
                    "props": {
                        "Pin Number": "1"
                    }
                },
                "2": {
                    "name": "A",
                    "number": "2",
                    "net": "GND",
                    "props": {
                        "Pin Number": "2"
                    }
                }
            }
        },
        "e06ccd13940482ac": {
            "props": {
                "Add into BOM": "yes",
                "Convert to PCB": "yes",
                "Name": "Device_R",
                "Device": "dce15ae5d8c4adea",
                "Designator": "R6",
                "Footprint": "840d5114b71a38b1",
                "Value": "10k",
                "UserDocLink": "",
                "Description": "",
                "ki_keywords": "",
                "ki_fp_filters": "",
                "Symbol": "1a6aa3fb7f7fd24f",
                "LCSC": "C25804",
                "Origin Footprint": "Resistor_SMD:R_0603_1608Metric",
                "Unique ID": "e06ccd13940482ac",
                "Manufacturer": "",
                "Manufacturer Part": "",
                "Supplier": "LCSC",
                "Supplier Part": "C25804",
                "Comment": "",
                "Group ID": "",
                "Channel ID": "$2ie226",
                "Reuse Block": "",
                "DeviceName": "Device_R",
                "FootprintName": "R_0603_1608Metric"
            },
            "pinInfoMap": {
                "1": {
                    "name": "",
                    "number": "1",
                    "net": "+5V",
                    "props": {
                        "Pin Number": "1"
                    }
                },
                "2": {
                    "name": "",
                    "number": "2",
                    "net": "BUCK_FB",
                    "props": {
                        "Pin Number": "2"
                    }
                }
            }
        },
        "ba2c6d155e7fd301": {
            "props": {
                "Add into BOM": "yes",
                "Convert to PCB": "yes",
                "Name": "Device_R",
                "Device": "dce15ae5d8c4adea",
                "Designator": "R7",
                "Footprint": "840d5114b71a38b1",
                "Value": "3.24k",
                "UserDocLink": "",
                "Description": "",
                "ki_keywords": "",
                "ki_fp_filters": "",
                "Symbol": "1a6aa3fb7f7fd24f",
                "LCSC": "C22994",
                "Comment": "Vout = 1.221*(1+10k/3.24k) = 4.99V; R7 C22994 1%",
                "Origin Footprint": "Resistor_SMD:R_0603_1608Metric",
                "Unique ID": "ba2c6d155e7fd301",
                "Manufacturer": "",
                "Manufacturer Part": "",
                "Supplier": "LCSC",
                "Supplier Part": "C22994",
                "Group ID": "",
                "Channel ID": "$2ie236",
                "Reuse Block": "",
                "DeviceName": "Device_R",
                "FootprintName": "R_0603_1608Metric"
            },
            "pinInfoMap": {
                "1": {
                    "name": "",
                    "number": "1",
                    "net": "BUCK_FB",
                    "props": {
                        "Pin Number": "1"
                    }
                },
                "2": {
                    "name": "",
                    "number": "2",
                    "net": "GND",
                    "props": {
                        "Pin Number": "2"
                    }
                }
            }
        },
        "86d447fa2a9c8586": {
            "props": {
                "Add into BOM": "yes",
                "Convert to PCB": "yes",
                "Name": "Device_R",
                "Device": "dce15ae5d8c4adea",
                "Designator": "R8",
                "Footprint": "840d5114b71a38b1",
                "Value": "100k",
                "UserDocLink": "",
                "Description": "",
                "ki_keywords": "",
                "ki_fp_filters": "",
                "Symbol": "1a6aa3fb7f7fd24f",
                "LCSC": "C25803",
                "Origin Footprint": "Resistor_SMD:R_0603_1608Metric",
                "Unique ID": "86d447fa2a9c8586",
                "Manufacturer": "",
                "Manufacturer Part": "",
                "Supplier": "LCSC",
                "Supplier Part": "C25803",
                "Comment": "",
                "Group ID": "",
                "Channel ID": "$2ie247",
                "Reuse Block": "",
                "DeviceName": "Device_R",
                "FootprintName": "R_0603_1608Metric"
            },
            "pinInfoMap": {
                "1": {
                    "name": "",
                    "number": "1",
                    "net": "VIN",
                    "props": {
                        "Pin Number": "1"
                    }
                },
                "2": {
                    "name": "",
                    "number": "2",
                    "net": "BUCK_EN",
                    "props": {
                        "Pin Number": "2"
                    }
                }
            }
        },
        "1e1ffada38203b9e": {
            "props": {
                "Add into BOM": "yes",
                "Convert to PCB": "yes",
                "Name": "Device_R",
                "Device": "dce15ae5d8c4adea",
                "Designator": "R9",
                "Footprint": "840d5114b71a38b1",
                "Value": "15k",
                "UserDocLink": "",
                "Description": "",
                "ki_keywords": "",
                "ki_fp_filters": "",
                "Symbol": "1a6aa3fb7f7fd24f",
                "LCSC": "C22809",
                "Comment": "External EN divider ~9.4V threshold; stays off at default USB 5V/9V",
                "Origin Footprint": "Resistor_SMD:R_0603_1608Metric",
                "Unique ID": "1e1ffada38203b9e",
                "Manufacturer": "",
                "Manufacturer Part": "",
                "Supplier": "LCSC",
                "Supplier Part": "C22809",
                "Group ID": "",
                "Channel ID": "$2ie257",
                "Reuse Block": "",
                "DeviceName": "Device_R",
                "FootprintName": "R_0603_1608Metric"
            },
            "pinInfoMap": {
                "1": {
                    "name": "",
                    "number": "1",
                    "net": "BUCK_EN",
                    "props": {
                        "Pin Number": "1"
                    }
                },
                "2": {
                    "name": "",
                    "number": "2",
                    "net": "GND",
                    "props": {
                        "Pin Number": "2"
                    }
                }
            }
        },
        "3a68d3ddabf48558": {
            "props": {
                "Add into BOM": "yes",
                "Convert to PCB": "yes",
                "Name": "Device_C",
                "Device": "e2de8376d481116b",
                "Designator": "C4",
                "Footprint": "97ec37459fa64236",
                "Value": "10u/50V",
                "UserDocLink": "",
                "Description": "",
                "ki_keywords": "",
                "ki_fp_filters": "",
                "Symbol": "e542132018ff745e",
                "LCSC": "C13585",
                "Origin Footprint": "Capacitor_SMD:C_1206_3216Metric",
                "Unique ID": "3a68d3ddabf48558",
                "Manufacturer": "",
                "Manufacturer Part": "",
                "Supplier": "LCSC",
                "Supplier Part": "C13585",
                "Comment": "",
                "Group ID": "",
                "Channel ID": "$2ie268",
                "Reuse Block": "",
                "DeviceName": "Device_C",
                "FootprintName": "C_1206_3216Metric"
            },
            "pinInfoMap": {
                "1": {
                    "name": "",
                    "number": "1",
                    "net": "VIN",
                    "props": {
                        "Pin Number": "1"
                    }
                },
                "2": {
                    "name": "",
                    "number": "2",
                    "net": "GND",
                    "props": {
                        "Pin Number": "2"
                    }
                }
            }
        },
        "ddba3c46cf8b8e66": {
            "props": {
                "Add into BOM": "yes",
                "Convert to PCB": "yes",
                "Name": "Device_C",
                "Device": "e2de8376d481116b",
                "Designator": "C5",
                "Footprint": "97ec37459fa64236",
                "Value": "10u/50V",
                "UserDocLink": "",
                "Description": "",
                "ki_keywords": "",
                "ki_fp_filters": "",
                "Symbol": "e542132018ff745e",
                "LCSC": "C13585",
                "Origin Footprint": "Capacitor_SMD:C_1206_3216Metric",
                "Unique ID": "ddba3c46cf8b8e66",
                "Manufacturer": "",
                "Manufacturer Part": "",
                "Supplier": "LCSC",
                "Supplier Part": "C13585",
                "Comment": "",
                "Group ID": "",
                "Channel ID": "$2ie278",
                "Reuse Block": "",
                "DeviceName": "Device_C",
                "FootprintName": "C_1206_3216Metric"
            },
            "pinInfoMap": {
                "1": {
                    "name": "",
                    "number": "1",
                    "net": "VIN",
                    "props": {
                        "Pin Number": "1"
                    }
                },
                "2": {
                    "name": "",
                    "number": "2",
                    "net": "GND",
                    "props": {
                        "Pin Number": "2"
                    }
                }
            }
        },
        "ab4a8fe24fad9fe4": {
            "props": {
                "Add into BOM": "yes",
                "Convert to PCB": "yes",
                "Name": "Device_C",
                "Device": "ce3f9b769b7a157b",
                "Designator": "C6",
                "Footprint": "6f3d185220f7d357",
                "Value": "100n/50V",
                "UserDocLink": "",
                "Description": "",
                "ki_keywords": "",
                "ki_fp_filters": "",
                "Symbol": "e542132018ff745e",
                "LCSC": "C14663",
                "Origin Footprint": "Capacitor_SMD:C_0603_1608Metric",
                "Unique ID": "ab4a8fe24fad9fe4",
                "Manufacturer": "",
                "Manufacturer Part": "",
                "Supplier": "LCSC",
                "Supplier Part": "C14663",
                "Comment": "",
                "Group ID": "",
                "Channel ID": "$2ie288",
                "Reuse Block": "",
                "DeviceName": "Device_C",
                "FootprintName": "C_0603_1608Metric"
            },
            "pinInfoMap": {
                "1": {
                    "name": "",
                    "number": "1",
                    "net": "VIN",
                    "props": {
                        "Pin Number": "1"
                    }
                },
                "2": {
                    "name": "",
                    "number": "2",
                    "net": "GND",
                    "props": {
                        "Pin Number": "2"
                    }
                }
            }
        },
        "48d2dd422533522c": {
            "props": {
                "Add into BOM": "yes",
                "Convert to PCB": "yes",
                "Name": "Device_C_Polarized",
                "Device": "4136f69f9f5c1f34",
                "Designator": "C7",
                "Footprint": "a8a722055b3c5af7",
                "Value": "220u/10V POSCAP",
                "UserDocLink": "",
                "Description": "",
                "ki_keywords": "",
                "ki_fp_filters": "",
                "Symbol": "c8039e3260078d75",
                "LCSC": "C242173",
                "Comment": "Panasonic 10TPB220M, 220uF 10V ESR max40mohm; TI reference output capacitor",
                "Origin Footprint": "Capacitor_Tantalum_SMD:CP_EIA-7343-40_Kemet-Y",
                "Unique ID": "48d2dd422533522c",
                "Manufacturer": "",
                "Manufacturer Part": "",
                "Supplier": "LCSC",
                "Supplier Part": "C242173",
                "Group ID": "",
                "Channel ID": "$2ie298",
                "Reuse Block": "",
                "DeviceName": "Device_C_Polarized",
                "FootprintName": "CP_EIA-7343-40_Kemet-Y"
            },
            "pinInfoMap": {
                "1": {
                    "name": "",
                    "number": "1",
                    "net": "+5V",
                    "props": {
                        "Pin Number": "1"
                    }
                },
                "2": {
                    "name": "",
                    "number": "2",
                    "net": "GND",
                    "props": {
                        "Pin Number": "2"
                    }
                }
            }
        },
        "80f3708378e3d903": {
            "props": {
                "Add into BOM": "no",
                "Convert to PCB": "yes",
                "Name": "Device_C",
                "Device": "e2de8376d481116b",
                "Designator": "C8",
                "Footprint": "97ec37459fa64236",
                "Value": "47u/10V",
                "UserDocLink": "",
                "Description": "",
                "ki_keywords": "",
                "ki_fp_filters": "",
                "Symbol": "e542132018ff745e",
                "LCSC": "C96123",
                "Origin Footprint": "Capacitor_SMD:C_1206_3216Metric",
                "Unique ID": "80f3708378e3d903",
                "Manufacturer": "",
                "Manufacturer Part": "",
                "Supplier": "LCSC",
                "Supplier Part": "C96123",
                "Comment": "",
                "Group ID": "",
                "Channel ID": "$2ie309",
                "Reuse Block": "",
                "DeviceName": "Device_C",
                "FootprintName": "C_1206_3216Metric"
            },
            "pinInfoMap": {
                "1": {
                    "name": "",
                    "number": "1",
                    "net": "+5V",
                    "props": {
                        "Pin Number": "1"
                    }
                },
                "2": {
                    "name": "",
                    "number": "2",
                    "net": "GND",
                    "props": {
                        "Pin Number": "2"
                    }
                }
            }
        },
        "7ddfd2f632a8b17d": {
            "props": {
                "Add into BOM": "no",
                "Convert to PCB": "yes",
                "Name": "Device_C",
                "Device": "e2de8376d481116b",
                "Designator": "C9",
                "Footprint": "97ec37459fa64236",
                "Value": "47u/10V",
                "UserDocLink": "",
                "Description": "",
                "ki_keywords": "",
                "ki_fp_filters": "",
                "Symbol": "e542132018ff745e",
                "LCSC": "C96123",
                "Origin Footprint": "Capacitor_SMD:C_1206_3216Metric",
                "Unique ID": "7ddfd2f632a8b17d",
                "Manufacturer": "",
                "Manufacturer Part": "",
                "Supplier": "LCSC",
                "Supplier Part": "C96123",
                "Comment": "",
                "Group ID": "",
                "Channel ID": "$2ie319",
                "Reuse Block": "",
                "DeviceName": "Device_C",
                "FootprintName": "C_1206_3216Metric"
            },
            "pinInfoMap": {
                "1": {
                    "name": "",
                    "number": "1",
                    "net": "+5V",
                    "props": {
                        "Pin Number": "1"
                    }
                },
                "2": {
                    "name": "",
                    "number": "2",
                    "net": "GND",
                    "props": {
                        "Pin Number": "2"
                    }
                }
            }
        },
        "66797bcd97f4f6c2": {
            "props": {
                "Add into BOM": "yes",
                "Convert to PCB": "yes",
                "Name": "Regulator_Linear_AMS1117-3.3",
                "Device": "9ade793103da79fa",
                "Designator": "U3",
                "Value": "TLV1117LV33DCYR",
                "UserDocLink": "",
                "Description": "",
                "ki_keywords": "",
                "ki_fp_filters": "",
                "Origin Footprint": "Package_TO_SOT_SMD:SOT-223-3_TabPin2",
                "Symbol": "8436192d2714f167",
                "LCSC": "C15578",
                "Comment": "TI TLV1117LV33: ceramic-output stable, pin-compatible SOT-223",
                "Unique ID": "66797bcd97f4f6c2",
                "Manufacturer": "",
                "Manufacturer Part": "",
                "Supplier": "LCSC",
                "Supplier Part": "C15578",
                "Footprint": "bba72ce0ed319fc5",
                "Group ID": "",
                "Channel ID": "$2ie329",
                "Reuse Block": "",
                "DeviceName": "Regulator_Linear_AMS1117-3.3",
                "FootprintName": "SOT-223-3_TabPin2"
            },
            "pinInfoMap": {
                "1": {
                    "name": "GND",
                    "number": "1",
                    "net": "GND",
                    "props": {
                        "Pin Number": "1"
                    }
                },
                "2": {
                    "name": "VO",
                    "number": "2",
                    "net": "+3V3",
                    "props": {
                        "Pin Number": "2"
                    }
                },
                "3": {
                    "name": "VI",
                    "number": "3",
                    "net": "+5V",
                    "props": {
                        "Pin Number": "3"
                    }
                }
            }
        },
        "3e75135af30e0f04": {
            "props": {
                "Add into BOM": "yes",
                "Convert to PCB": "yes",
                "Name": "Device_C",
                "Device": "e2de8376d481116b",
                "Designator": "C10",
                "Footprint": "97ec37459fa64236",
                "Value": "10u/16V",
                "UserDocLink": "",
                "Description": "",
                "ki_keywords": "",
                "ki_fp_filters": "",
                "Symbol": "e542132018ff745e",
                "LCSC": "C13585",
                "Origin Footprint": "Capacitor_SMD:C_1206_3216Metric",
                "Unique ID": "3e75135af30e0f04",
                "Manufacturer": "",
                "Manufacturer Part": "",
                "Supplier": "LCSC",
                "Supplier Part": "C13585",
                "Comment": "",
                "Group ID": "",
                "Channel ID": "$2ie340",
                "Reuse Block": "",
                "DeviceName": "Device_C",
                "FootprintName": "C_1206_3216Metric"
            },
            "pinInfoMap": {
                "1": {
                    "name": "",
                    "number": "1",
                    "net": "+5V",
                    "props": {
                        "Pin Number": "1"
                    }
                },
                "2": {
                    "name": "",
                    "number": "2",
                    "net": "GND",
                    "props": {
                        "Pin Number": "2"
                    }
                }
            }
        },
        "20764de07767b3a1": {
            "props": {
                "Add into BOM": "yes",
                "Convert to PCB": "yes",
                "Name": "Device_C",
                "Device": "e2de8376d481116b",
                "Designator": "C11",
                "Footprint": "97ec37459fa64236",
                "Value": "22u/10V",
                "UserDocLink": "",
                "Description": "",
                "ki_keywords": "",
                "ki_fp_filters": "",
                "Symbol": "e542132018ff745e",
                "LCSC": "C12891",
                "Origin Footprint": "Capacitor_SMD:C_1206_3216Metric",
                "Unique ID": "20764de07767b3a1",
                "Manufacturer": "",
                "Manufacturer Part": "",
                "Supplier": "LCSC",
                "Supplier Part": "C12891",
                "Comment": "",
                "Group ID": "",
                "Channel ID": "$2ie350",
                "Reuse Block": "",
                "DeviceName": "Device_C",
                "FootprintName": "C_1206_3216Metric"
            },
            "pinInfoMap": {
                "1": {
                    "name": "",
                    "number": "1",
                    "net": "+3V3",
                    "props": {
                        "Pin Number": "1"
                    }
                },
                "2": {
                    "name": "",
                    "number": "2",
                    "net": "GND",
                    "props": {
                        "Pin Number": "2"
                    }
                }
            }
        },
        "bd3ee0abdb58119f": {
            "props": {
                "Add into BOM": "yes",
                "Convert to PCB": "yes",
                "Name": "Connector_Generic_Conn_02x15_Odd_Even",
                "Device": "6117c0ae8f3ebad9",
                "Designator": "J3",
                "Footprint": "99bab940c4f22b22",
                "Value": "M5-BUS (to Tab5)",
                "UserDocLink": "",
                "Description": "",
                "ki_keywords": "",
                "ki_fp_filters": "",
                "Symbol": "fe5ebfb932b901f4",
                "Comment": "User confirmed 2026-10-24: rear view, battery left, pin1 GND on left; mirrored-column footprint",
                "Origin Footprint": "carrier:PinHeader_2x15_Tab5_Bottom",
                "Unique ID": "bd3ee0abdb58119f",
                "Manufacturer": "",
                "Manufacturer Part": "",
                "Supplier": "Akizuki",
                "Supplier Part": "1",
                "LCSC": "",
                "Group ID": "",
                "Channel ID": "$2ie360",
                "Reuse Block": "",
                "DeviceName": "Connector_Generic_Conn_02x15_Odd_Even",
                "FootprintName": "PinHeader_2x15_Tab5_Bottom"
            },
            "pinInfoMap": {
                "1": {
                    "name": "Pin_1",
                    "number": "1",
                    "net": "GND",
                    "props": {
                        "Pin Number": "1"
                    }
                },
                "2": {
                    "name": "Pin_2",
                    "number": "2",
                    "net": "M_CLK",
                    "props": {
                        "Pin Number": "2"
                    }
                },
                "3": {
                    "name": "Pin_3",
                    "number": "3",
                    "net": "GND",
                    "props": {
                        "Pin Number": "3"
                    }
                },
                "4": {
                    "name": "Pin_4",
                    "number": "4",
                    "net": "M_AUX0",
                    "props": {
                        "Pin Number": "4"
                    }
                },
                "5": {
                    "name": "Pin_5",
                    "number": "5",
                    "net": "GND",
                    "props": {
                        "Pin Number": "5"
                    }
                },
                "6": {
                    "name": "Pin_6",
                    "number": "6",
                    "net": "TAB_RST",
                    "props": {
                        "Pin Number": "6"
                    }
                },
                "7": {
                    "name": "Pin_7",
                    "number": "7",
                    "net": "M_D0",
                    "props": {
                        "Pin Number": "7"
                    }
                },
                "8": {
                    "name": "Pin_8",
                    "number": "8",
                    "net": "M_RDY",
                    "props": {
                        "Pin Number": "8"
                    }
                },
                "9": {
                    "name": "Pin_9",
                    "number": "9",
                    "net": "M_D1",
                    "props": {
                        "Pin Number": "9"
                    }
                },
                "10": {
                    "name": "Pin_10",
                    "number": "10",
                    "net": "M_AUX1",
                    "props": {
                        "Pin Number": "10"
                    }
                },
                "11": {
                    "name": "Pin_11",
                    "number": "11",
                    "net": "M_D2",
                    "props": {
                        "Pin Number": "11"
                    }
                },
                "12": {
                    "name": "Pin_12",
                    "number": "12",
                    "net": "TAB_3V3",
                    "props": {
                        "Pin Number": "12"
                    }
                },
                "13": {
                    "name": "Pin_13",
                    "number": "13",
                    "net": "M_EXT38",
                    "props": {
                        "Pin Number": "13"
                    }
                },
                "14": {
                    "name": "Pin_14",
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
            "props": {
                "Add into BOM": "yes",
                "Convert to PCB": "yes",
                "Name": "Device_R",
                "Device": "dce15ae5d8c4adea",
                "Designator": "R10",
                "Footprint": "840d5114b71a38b1",
                "Value": "680R",
                "UserDocLink": "",
                "Description": "",
                "ki_keywords": "",
                "ki_fp_filters": "",
                "Symbol": "1a6aa3fb7f7fd24f",
                "LCSC": "C23228",
                "Comment": "Initial PoC1MHz; DATA setup/hold>=250ns; DIR deadtime>=500ns; weak drive/SLOW. New full-size routing must be re-evaluated.",
                "Origin Footprint": "Resistor_SMD:R_0603_1608Metric",
                "Unique ID": "41bc0941336b1513",
                "Manufacturer": "",
                "Manufacturer Part": "",
                "Supplier": "LCSC",
                "Supplier Part": "C23228",
                "Group ID": "",
                "Channel ID": "$2ie370",
                "Reuse Block": "",
                "DeviceName": "Device_R",
                "FootprintName": "R_0603_1608Metric"
            },
            "pinInfoMap": {
                "1": {
                    "name": "",
                    "number": "1",
                    "net": "ISO_CLK",
                    "props": {
                        "Pin Number": "1"
                    }
                },
                "2": {
                    "name": "",
                    "number": "2",
                    "net": "F_CLK",
                    "props": {
                        "Pin Number": "2"
                    }
                }
            }
        },
        "763cf8d5648cb4fd": {
            "props": {
                "Add into BOM": "yes",
                "Convert to PCB": "yes",
                "Name": "Device_R",
                "Device": "dce15ae5d8c4adea",
                "Designator": "R11",
                "Footprint": "840d5114b71a38b1",
                "Value": "680R",
                "UserDocLink": "",
                "Description": "",
                "ki_keywords": "",
                "ki_fp_filters": "",
                "Symbol": "1a6aa3fb7f7fd24f",
                "LCSC": "C23228",
                "Comment": "Initial PoC1MHz; DATA setup/hold>=250ns; DIR deadtime>=500ns; weak drive/SLOW. New full-size routing must be re-evaluated.",
                "Origin Footprint": "Resistor_SMD:R_0603_1608Metric",
                "Unique ID": "763cf8d5648cb4fd",
                "Manufacturer": "",
                "Manufacturer Part": "",
                "Supplier": "LCSC",
                "Supplier Part": "C23228",
                "Group ID": "",
                "Channel ID": "$2ie381",
                "Reuse Block": "",
                "DeviceName": "Device_R",
                "FootprintName": "R_0603_1608Metric"
            },
            "pinInfoMap": {
                "1": {
                    "name": "",
                    "number": "1",
                    "net": "ISO_AUX0",
                    "props": {
                        "Pin Number": "1"
                    }
                },
                "2": {
                    "name": "",
                    "number": "2",
                    "net": "F_AUX0",
                    "props": {
                        "Pin Number": "2"
                    }
                }
            }
        },
        "15ac9218146e0f4b": {
            "props": {
                "Add into BOM": "yes",
                "Convert to PCB": "yes",
                "Name": "Device_R",
                "Device": "dce15ae5d8c4adea",
                "Designator": "R12",
                "Footprint": "840d5114b71a38b1",
                "Value": "680R",
                "UserDocLink": "",
                "Description": "",
                "ki_keywords": "",
                "ki_fp_filters": "",
                "Symbol": "1a6aa3fb7f7fd24f",
                "LCSC": "C23228",
                "Comment": "Initial PoC1MHz; DATA setup/hold>=250ns; DIR deadtime>=500ns; weak drive/SLOW. New full-size routing must be re-evaluated.",
                "Origin Footprint": "Resistor_SMD:R_0603_1608Metric",
                "Unique ID": "15ac9218146e0f4b",
                "Manufacturer": "",
                "Manufacturer Part": "",
                "Supplier": "LCSC",
                "Supplier Part": "C23228",
                "Group ID": "",
                "Channel ID": "$2ie392",
                "Reuse Block": "",
                "DeviceName": "Device_R",
                "FootprintName": "R_0603_1608Metric"
            },
            "pinInfoMap": {
                "1": {
                    "name": "",
                    "number": "1",
                    "net": "ISO_RDY",
                    "props": {
                        "Pin Number": "1"
                    }
                },
                "2": {
                    "name": "",
                    "number": "2",
                    "net": "F_RDY",
                    "props": {
                        "Pin Number": "2"
                    }
                }
            }
        },
        "ff4077a9ca69db92": {
            "props": {
                "Add into BOM": "yes",
                "Convert to PCB": "yes",
                "Name": "Device_R",
                "Device": "dce15ae5d8c4adea",
                "Designator": "R13",
                "Footprint": "840d5114b71a38b1",
                "Value": "680R",
                "UserDocLink": "",
                "Description": "",
                "ki_keywords": "",
                "ki_fp_filters": "",
                "Symbol": "1a6aa3fb7f7fd24f",
                "LCSC": "C23228",
                "Comment": "Initial PoC1MHz; DATA setup/hold>=250ns; DIR deadtime>=500ns; weak drive/SLOW. New full-size routing must be re-evaluated.",
                "Origin Footprint": "Resistor_SMD:R_0603_1608Metric",
                "Unique ID": "ff4077a9ca69db92",
                "Manufacturer": "",
                "Manufacturer Part": "",
                "Supplier": "LCSC",
                "Supplier Part": "C23228",
                "Group ID": "",
                "Channel ID": "$2ie403",
                "Reuse Block": "",
                "DeviceName": "Device_R",
                "FootprintName": "R_0603_1608Metric"
            },
            "pinInfoMap": {
                "1": {
                    "name": "",
                    "number": "1",
                    "net": "ISO_D0",
                    "props": {
                        "Pin Number": "1"
                    }
                },
                "2": {
                    "name": "",
                    "number": "2",
                    "net": "F_D0",
                    "props": {
                        "Pin Number": "2"
                    }
                }
            }
        },
        "8b54177fc4d64d35": {
            "props": {
                "Add into BOM": "yes",
                "Convert to PCB": "yes",
                "Name": "Device_R",
                "Device": "dce15ae5d8c4adea",
                "Designator": "R14",
                "Footprint": "840d5114b71a38b1",
                "Value": "680R",
                "UserDocLink": "",
                "Description": "",
                "ki_keywords": "",
                "ki_fp_filters": "",
                "Symbol": "1a6aa3fb7f7fd24f",
                "LCSC": "C23228",
                "Comment": "Initial PoC1MHz; DATA setup/hold>=250ns; DIR deadtime>=500ns; weak drive/SLOW. New full-size routing must be re-evaluated.",
                "Origin Footprint": "Resistor_SMD:R_0603_1608Metric",
                "Unique ID": "8b54177fc4d64d35",
                "Manufacturer": "",
                "Manufacturer Part": "",
                "Supplier": "LCSC",
                "Supplier Part": "C23228",
                "Group ID": "",
                "Channel ID": "$2ie414",
                "Reuse Block": "",
                "DeviceName": "Device_R",
                "FootprintName": "R_0603_1608Metric"
            },
            "pinInfoMap": {
                "1": {
                    "name": "",
                    "number": "1",
                    "net": "ISO_AUX1",
                    "props": {
                        "Pin Number": "1"
                    }
                },
                "2": {
                    "name": "",
                    "number": "2",
                    "net": "F_AUX1",
                    "props": {
                        "Pin Number": "2"
                    }
                }
            }
        },
        "feece054417b9159": {
            "props": {
                "Add into BOM": "yes",
                "Convert to PCB": "yes",
                "Name": "Device_R",
                "Device": "dce15ae5d8c4adea",
                "Designator": "R15",
                "Footprint": "840d5114b71a38b1",
                "Value": "680R",
                "UserDocLink": "",
                "Description": "",
                "ki_keywords": "",
                "ki_fp_filters": "",
                "Symbol": "1a6aa3fb7f7fd24f",
                "LCSC": "C23228",
                "Comment": "Initial PoC1MHz; DATA setup/hold>=250ns; DIR deadtime>=500ns; weak drive/SLOW. New full-size routing must be re-evaluated.",
                "Origin Footprint": "Resistor_SMD:R_0603_1608Metric",
                "Unique ID": "feece054417b9159",
                "Manufacturer": "",
                "Manufacturer Part": "",
                "Supplier": "LCSC",
                "Supplier Part": "C23228",
                "Group ID": "",
                "Channel ID": "$2ie425",
                "Reuse Block": "",
                "DeviceName": "Device_R",
                "FootprintName": "R_0603_1608Metric"
            },
            "pinInfoMap": {
                "1": {
                    "name": "",
                    "number": "1",
                    "net": "ISO_D1",
                    "props": {
                        "Pin Number": "1"
                    }
                },
                "2": {
                    "name": "",
                    "number": "2",
                    "net": "F_D1",
                    "props": {
                        "Pin Number": "2"
                    }
                }
            }
        },
        "3c543c7c58e1cc80": {
            "props": {
                "Add into BOM": "yes",
                "Convert to PCB": "yes",
                "Name": "Device_R",
                "Device": "dce15ae5d8c4adea",
                "Designator": "R16",
                "Footprint": "840d5114b71a38b1",
                "Value": "680R",
                "UserDocLink": "",
                "Description": "",
                "ki_keywords": "",
                "ki_fp_filters": "",
                "Symbol": "1a6aa3fb7f7fd24f",
                "LCSC": "C23228",
                "Comment": "Initial PoC1MHz; DATA setup/hold>=250ns; DIR deadtime>=500ns; weak drive/SLOW. New full-size routing must be re-evaluated.",
                "Origin Footprint": "Resistor_SMD:R_0603_1608Metric",
                "Unique ID": "3c543c7c58e1cc80",
                "Manufacturer": "",
                "Manufacturer Part": "",
                "Supplier": "LCSC",
                "Supplier Part": "C23228",
                "Group ID": "",
                "Channel ID": "$2ie436",
                "Reuse Block": "",
                "DeviceName": "Device_R",
                "FootprintName": "R_0603_1608Metric"
            },
            "pinInfoMap": {
                "1": {
                    "name": "",
                    "number": "1",
                    "net": "ISO_D2",
                    "props": {
                        "Pin Number": "1"
                    }
                },
                "2": {
                    "name": "",
                    "number": "2",
                    "net": "F_D2",
                    "props": {
                        "Pin Number": "2"
                    }
                }
            }
        },
        "6346d187b4e0bc9c": {
            "props": {
                "Add into BOM": "no",
                "Convert to PCB": "yes",
                "Name": "Device_R",
                "Device": "dce15ae5d8c4adea",
                "Designator": "R17",
                "Footprint": "840d5114b71a38b1",
                "Value": "0R",
                "UserDocLink": "",
                "Description": "",
                "ki_keywords": "",
                "ki_fp_filters": "",
                "Symbol": "1a6aa3fb7f7fd24f",
                "LCSC": "C21189",
                "Comment": "16-bit extension (DNP): connects G37 to FPGA",
                "Origin Footprint": "Resistor_SMD:R_0603_1608Metric",
                "Unique ID": "6346d187b4e0bc9c",
                "Manufacturer": "",
                "Manufacturer Part": "",
                "Supplier": "LCSC",
                "Supplier Part": "C21189",
                "Group ID": "",
                "Channel ID": "$2ie447",
                "Reuse Block": "",
                "DeviceName": "Device_R",
                "FootprintName": "R_0603_1608Metric"
            },
            "pinInfoMap": {
                "1": {
                    "name": "",
                    "number": "1",
                    "net": "M_EXT37",
                    "props": {
                        "Pin Number": "1"
                    }
                },
                "2": {
                    "name": "",
                    "number": "2",
                    "net": "F_EXT37",
                    "props": {
                        "Pin Number": "2"
                    }
                }
            }
        },
        "5f673669f0d56d8f": {
            "props": {
                "Add into BOM": "no",
                "Convert to PCB": "yes",
                "Name": "Device_R",
                "Device": "dce15ae5d8c4adea",
                "Designator": "R18",
                "Footprint": "840d5114b71a38b1",
                "Value": "0R",
                "UserDocLink": "",
                "Description": "",
                "ki_keywords": "",
                "ki_fp_filters": "",
                "Symbol": "1a6aa3fb7f7fd24f",
                "LCSC": "C21189",
                "Comment": "16-bit extension (DNP): connects G38 to FPGA",
                "Origin Footprint": "Resistor_SMD:R_0603_1608Metric",
                "Unique ID": "5f673669f0d56d8f",
                "Manufacturer": "",
                "Manufacturer Part": "",
                "Supplier": "LCSC",
                "Supplier Part": "C21189",
                "Group ID": "",
                "Channel ID": "$2ie458",
                "Reuse Block": "",
                "DeviceName": "Device_R",
                "FootprintName": "R_0603_1608Metric"
            },
            "pinInfoMap": {
                "1": {
                    "name": "",
                    "number": "1",
                    "net": "M_EXT38",
                    "props": {
                        "Pin Number": "1"
                    }
                },
                "2": {
                    "name": "",
                    "number": "2",
                    "net": "F_EXT38",
                    "props": {
                        "Pin Number": "2"
                    }
                }
            }
        },
        "a32210a39874d8f8": {
            "props": {
                "Add into BOM": "yes",
                "Convert to PCB": "yes",
                "Name": "Device_R",
                "Device": "dce15ae5d8c4adea",
                "Designator": "R19",
                "Footprint": "840d5114b71a38b1",
                "Value": "680R",
                "UserDocLink": "",
                "Description": "",
                "ki_keywords": "",
                "ki_fp_filters": "",
                "Symbol": "1a6aa3fb7f7fd24f",
                "LCSC": "C23228",
                "Comment": "Initial PoC1MHz; DATA setup/hold>=250ns; DIR deadtime>=500ns; weak drive/SLOW. New full-size routing must be re-evaluated.",
                "Origin Footprint": "Resistor_SMD:R_0603_1608Metric",
                "Unique ID": "a32210a39874d8f8",
                "Manufacturer": "",
                "Manufacturer Part": "",
                "Supplier": "LCSC",
                "Supplier Part": "C23228",
                "Group ID": "",
                "Channel ID": "$2ie469",
                "Reuse Block": "",
                "DeviceName": "Device_R",
                "FootprintName": "R_0603_1608Metric"
            },
            "pinInfoMap": {
                "1": {
                    "name": "",
                    "number": "1",
                    "net": "ISO_AUX2",
                    "props": {
                        "Pin Number": "1"
                    }
                },
                "2": {
                    "name": "",
                    "number": "2",
                    "net": "F_AUX2",
                    "props": {
                        "Pin Number": "2"
                    }
                }
            }
        },
        "13e77c54ede4b306": {
            "props": {
                "Add into BOM": "yes",
                "Convert to PCB": "yes",
                "Name": "Device_R",
                "Device": "dce15ae5d8c4adea",
                "Designator": "R20",
                "Footprint": "840d5114b71a38b1",
                "Value": "680R",
                "UserDocLink": "",
                "Description": "",
                "ki_keywords": "",
                "ki_fp_filters": "",
                "Symbol": "1a6aa3fb7f7fd24f",
                "LCSC": "C23228",
                "Comment": "Initial PoC1MHz; DATA setup/hold>=250ns; DIR deadtime>=500ns; weak drive/SLOW. New full-size routing must be re-evaluated.",
                "Origin Footprint": "Resistor_SMD:R_0603_1608Metric",
                "Unique ID": "13e77c54ede4b306",
                "Manufacturer": "",
                "Manufacturer Part": "",
                "Supplier": "LCSC",
                "Supplier Part": "C23228",
                "Group ID": "",
                "Channel ID": "$2ie480",
                "Reuse Block": "",
                "DeviceName": "Device_R",
                "FootprintName": "R_0603_1608Metric"
            },
            "pinInfoMap": {
                "1": {
                    "name": "",
                    "number": "1",
                    "net": "ISO_AUX3",
                    "props": {
                        "Pin Number": "1"
                    }
                },
                "2": {
                    "name": "",
                    "number": "2",
                    "net": "F_AUX3",
                    "props": {
                        "Pin Number": "2"
                    }
                }
            }
        },
        "c77b08197b178948": {
            "props": {
                "Add into BOM": "yes",
                "Convert to PCB": "yes",
                "Name": "Device_R",
                "Device": "dce15ae5d8c4adea",
                "Designator": "R21",
                "Footprint": "840d5114b71a38b1",
                "Value": "680R",
                "UserDocLink": "",
                "Description": "",
                "ki_keywords": "",
                "ki_fp_filters": "",
                "Symbol": "1a6aa3fb7f7fd24f",
                "LCSC": "C23228",
                "Comment": "Initial PoC1MHz; DATA setup/hold>=250ns; DIR deadtime>=500ns; weak drive/SLOW. New full-size routing must be re-evaluated.",
                "Origin Footprint": "Resistor_SMD:R_0603_1608Metric",
                "Unique ID": "c77b08197b178948",
                "Manufacturer": "",
                "Manufacturer Part": "",
                "Supplier": "LCSC",
                "Supplier Part": "C23228",
                "Group ID": "",
                "Channel ID": "$2ie491",
                "Reuse Block": "",
                "DeviceName": "Device_R",
                "FootprintName": "R_0603_1608Metric"
            },
            "pinInfoMap": {
                "1": {
                    "name": "",
                    "number": "1",
                    "net": "ISO_D4",
                    "props": {
                        "Pin Number": "1"
                    }
                },
                "2": {
                    "name": "",
                    "number": "2",
                    "net": "F_D4",
                    "props": {
                        "Pin Number": "2"
                    }
                }
            }
        },
        "fa394caafc8878d8": {
            "props": {
                "Add into BOM": "yes",
                "Convert to PCB": "yes",
                "Name": "Device_R",
                "Device": "dce15ae5d8c4adea",
                "Designator": "R22",
                "Footprint": "840d5114b71a38b1",
                "Value": "680R",
                "UserDocLink": "",
                "Description": "",
                "ki_keywords": "",
                "ki_fp_filters": "",
                "Symbol": "1a6aa3fb7f7fd24f",
                "LCSC": "C23228",
                "Comment": "Initial PoC1MHz; DATA setup/hold>=250ns; DIR deadtime>=500ns; weak drive/SLOW. New full-size routing must be re-evaluated.",
                "Origin Footprint": "Resistor_SMD:R_0603_1608Metric",
                "Unique ID": "fa394caafc8878d8",
                "Manufacturer": "",
                "Manufacturer Part": "",
                "Supplier": "LCSC",
                "Supplier Part": "C23228",
                "Group ID": "",
                "Channel ID": "$2ie502",
                "Reuse Block": "",
                "DeviceName": "Device_R",
                "FootprintName": "R_0603_1608Metric"
            },
            "pinInfoMap": {
                "1": {
                    "name": "",
                    "number": "1",
                    "net": "ISO_D3",
                    "props": {
                        "Pin Number": "1"
                    }
                },
                "2": {
                    "name": "",
                    "number": "2",
                    "net": "F_D3",
                    "props": {
                        "Pin Number": "2"
                    }
                }
            }
        },
        "d92c635076b33213": {
            "props": {
                "Add into BOM": "yes",
                "Convert to PCB": "yes",
                "Name": "Device_R",
                "Device": "dce15ae5d8c4adea",
                "Designator": "R23",
                "Footprint": "840d5114b71a38b1",
                "Value": "680R",
                "UserDocLink": "",
                "Description": "",
                "ki_keywords": "",
                "ki_fp_filters": "",
                "Symbol": "1a6aa3fb7f7fd24f",
                "LCSC": "C23228",
                "Comment": "Initial PoC1MHz; DATA setup/hold>=250ns; DIR deadtime>=500ns; weak drive/SLOW. New full-size routing must be re-evaluated.",
                "Origin Footprint": "Resistor_SMD:R_0603_1608Metric",
                "Unique ID": "d92c635076b33213",
                "Manufacturer": "",
                "Manufacturer Part": "",
                "Supplier": "LCSC",
                "Supplier Part": "C23228",
                "Group ID": "",
                "Channel ID": "$2ie513",
                "Reuse Block": "",
                "DeviceName": "Device_R",
                "FootprintName": "R_0603_1608Metric"
            },
            "pinInfoMap": {
                "1": {
                    "name": "",
                    "number": "1",
                    "net": "ISO_D6",
                    "props": {
                        "Pin Number": "1"
                    }
                },
                "2": {
                    "name": "",
                    "number": "2",
                    "net": "F_D6",
                    "props": {
                        "Pin Number": "2"
                    }
                }
            }
        },
        "f7952e9f9cd6773b": {
            "props": {
                "Add into BOM": "yes",
                "Convert to PCB": "yes",
                "Name": "Device_R",
                "Device": "dce15ae5d8c4adea",
                "Designator": "R24",
                "Footprint": "840d5114b71a38b1",
                "Value": "680R",
                "UserDocLink": "",
                "Description": "",
                "ki_keywords": "",
                "ki_fp_filters": "",
                "Symbol": "1a6aa3fb7f7fd24f",
                "LCSC": "C23228",
                "Comment": "Initial PoC1MHz; DATA setup/hold>=250ns; DIR deadtime>=500ns; weak drive/SLOW. New full-size routing must be re-evaluated.",
                "Origin Footprint": "Resistor_SMD:R_0603_1608Metric",
                "Unique ID": "f7952e9f9cd6773b",
                "Manufacturer": "",
                "Manufacturer Part": "",
                "Supplier": "LCSC",
                "Supplier Part": "C23228",
                "Group ID": "",
                "Channel ID": "$2ie524",
                "Reuse Block": "",
                "DeviceName": "Device_R",
                "FootprintName": "R_0603_1608Metric"
            },
            "pinInfoMap": {
                "1": {
                    "name": "",
                    "number": "1",
                    "net": "ISO_D5",
                    "props": {
                        "Pin Number": "1"
                    }
                },
                "2": {
                    "name": "",
                    "number": "2",
                    "net": "F_D5",
                    "props": {
                        "Pin Number": "2"
                    }
                }
            }
        },
        "6f4c4beafd605d3e": {
            "props": {
                "Add into BOM": "no",
                "Convert to PCB": "yes",
                "Name": "Device_R",
                "Device": "dce15ae5d8c4adea",
                "Designator": "R25",
                "Footprint": "840d5114b71a38b1",
                "Value": "0R",
                "UserDocLink": "",
                "Description": "",
                "ki_keywords": "",
                "ki_fp_filters": "",
                "Symbol": "1a6aa3fb7f7fd24f",
                "LCSC": "C21189",
                "Comment": "16-bit extension (DNP): connects G35 to FPGA",
                "Origin Footprint": "Resistor_SMD:R_0603_1608Metric",
                "Unique ID": "6f4c4beafd605d3e",
                "Manufacturer": "",
                "Manufacturer Part": "",
                "Supplier": "LCSC",
                "Supplier Part": "C21189",
                "Group ID": "",
                "Channel ID": "$2ie535",
                "Reuse Block": "",
                "DeviceName": "Device_R",
                "FootprintName": "R_0603_1608Metric"
            },
            "pinInfoMap": {
                "1": {
                    "name": "",
                    "number": "1",
                    "net": "M_EXT35",
                    "props": {
                        "Pin Number": "1"
                    }
                },
                "2": {
                    "name": "",
                    "number": "2",
                    "net": "F_EXT35",
                    "props": {
                        "Pin Number": "2"
                    }
                }
            }
        },
        "09b823a69019dbbf": {
            "props": {
                "Add into BOM": "yes",
                "Convert to PCB": "yes",
                "Name": "Device_R",
                "Device": "dce15ae5d8c4adea",
                "Designator": "R26",
                "Footprint": "840d5114b71a38b1",
                "Value": "680R",
                "UserDocLink": "",
                "Description": "",
                "ki_keywords": "",
                "ki_fp_filters": "",
                "Symbol": "1a6aa3fb7f7fd24f",
                "LCSC": "C23228",
                "Comment": "Initial PoC1MHz; DATA setup/hold>=250ns; DIR deadtime>=500ns; weak drive/SLOW. New full-size routing must be re-evaluated.",
                "Origin Footprint": "Resistor_SMD:R_0603_1608Metric",
                "Unique ID": "09b823a69019dbbf",
                "Manufacturer": "",
                "Manufacturer Part": "",
                "Supplier": "LCSC",
                "Supplier Part": "C23228",
                "Group ID": "",
                "Channel ID": "$2ie546",
                "Reuse Block": "",
                "DeviceName": "Device_R",
                "FootprintName": "R_0603_1608Metric"
            },
            "pinInfoMap": {
                "1": {
                    "name": "",
                    "number": "1",
                    "net": "ISO_D7",
                    "props": {
                        "Pin Number": "1"
                    }
                },
                "2": {
                    "name": "",
                    "number": "2",
                    "net": "F_D7",
                    "props": {
                        "Pin Number": "2"
                    }
                }
            }
        },
        "28145adf450505d9": {
            "props": {
                "Add into BOM": "yes",
                "Convert to PCB": "yes",
                "Name": "Device_R",
                "Device": "dce15ae5d8c4adea",
                "Designator": "R27",
                "Footprint": "840d5114b71a38b1",
                "Value": "680R",
                "UserDocLink": "",
                "Description": "",
                "ki_keywords": "",
                "ki_fp_filters": "",
                "Symbol": "1a6aa3fb7f7fd24f",
                "LCSC": "C23228",
                "Comment": "Initial PoC1MHz; DATA setup/hold>=250ns; DIR deadtime>=500ns; weak drive/SLOW. New full-size routing must be re-evaluated.",
                "Origin Footprint": "Resistor_SMD:R_0603_1608Metric",
                "Unique ID": "28145adf450505d9",
                "Manufacturer": "",
                "Manufacturer Part": "",
                "Supplier": "LCSC",
                "Supplier Part": "C23228",
                "Group ID": "",
                "Channel ID": "$2ie557",
                "Reuse Block": "",
                "DeviceName": "Device_R",
                "FootprintName": "R_0603_1608Metric"
            },
            "pinInfoMap": {
                "1": {
                    "name": "",
                    "number": "1",
                    "net": "ISO_DIR",
                    "props": {
                        "Pin Number": "1"
                    }
                },
                "2": {
                    "name": "",
                    "number": "2",
                    "net": "F_DIR",
                    "props": {
                        "Pin Number": "2"
                    }
                }
            }
        },
        "7aadee231938cadd": {
            "props": {
                "Add into BOM": "yes",
                "Convert to PCB": "yes",
                "Name": "carrier_CORE_SODIMM_204",
                "Device": "d140a4ca5761c1b8",
                "Designator": "J4",
                "Value": "SOCKET XDAP-4042044-20401",
                "UserDocLink": "",
                "Description": "",
                "Origin Footprint": "carrier:DDR3_XDAP_4042044_20401",
                "Symbol": "e5fb635bce2fc6d3",
                "LCSC": "C22471982",
                "Comment": "PCBA mandatory; socket only, Core module supplied by user; confirm stock/fixture",
                "Unique ID": "7aadee231938cadd",
                "Manufacturer": "",
                "Manufacturer Part": "",
                "Supplier": "LCSC",
                "Supplier Part": "C22471982",
                "Footprint": "fbfc54e418ec90c6",
                "Group ID": "",
                "Channel ID": "$2ie568",
                "Reuse Block": "",
                "DeviceName": "carrier_CORE_SODIMM_204",
                "FootprintName": "DDR3_XDAP_4042044_20401"
            },
            "pinInfoMap": {
                "1": {
                    "name": "~",
                    "number": "1",
                    "net": "",
                    "props": {
                        "Pin Number": "1"
                    }
                },
                "2": {
                    "name": "GND",
                    "number": "2",
                    "net": "GND",
                    "props": {
                        "Pin Number": "2"
                    }
                },
                "3": {
                    "name": "GND",
                    "number": "3",
                    "net": "GND",
                    "props": {
                        "Pin Number": "3"
                    }
                },
                "4": {
                    "name": "+5V",
                    "number": "4",
                    "net": "+5V",
                    "props": {
                        "Pin Number": "4"
                    }
                },
                "5": {
                    "name": "+5V",
                    "number": "5",
                    "net": "+5V",
                    "props": {
                        "Pin Number": "5"
                    }
                },
                "6": {
                    "name": "+5V",
                    "number": "6",
                    "net": "+5V",
                    "props": {
                        "Pin Number": "6"
                    }
                },
                "7": {
                    "name": "+5V",
                    "number": "7",
                    "net": "+5V",
                    "props": {
                        "Pin Number": "7"
                    }
                },
                "8": {
                    "name": "GND",
                    "number": "8",
                    "net": "GND",
                    "props": {
                        "Pin Number": "8"
                    }
                },
                "9": {
                    "name": "GND",
                    "number": "9",
                    "net": "GND",
                    "props": {
                        "Pin Number": "9"
                    }
                },
                "10": {
                    "name": "~",
                    "number": "10",
                    "net": "",
                    "props": {
                        "Pin Number": "10"
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
                    }
                },
                "199": {
                    "name": "~",
                    "number": "199",
                    "net": "",
                    "props": {
                        "Pin Number": "199"
                    }
                },
                "200": {
                    "name": "~",
                    "number": "200",
                    "net": "",
                    "props": {
                        "Pin Number": "200"
                    }
                },
                "201": {
                    "name": "~",
                    "number": "201",
                    "net": "",
                    "props": {
                        "Pin Number": "201"
                    }
                },
                "202": {
                    "name": "~",
                    "number": "202",
                    "net": "",
                    "props": {
                        "Pin Number": "202"
                    }
                },
                "203": {
                    "name": "~",
                    "number": "203",
                    "net": "",
                    "props": {
                        "Pin Number": "203"
                    }
                },
                "204": {
                    "name": "~",
                    "number": "204",
                    "net": "",
                    "props": {
                        "Pin Number": "204"
                    }
                }
            }
        },
        "188f82074eb8ca32": {
            "props": {
                "Add into BOM": "yes",
                "Convert to PCB": "yes",
                "Name": "Connector_HDMI_A",
                "Device": "f808a2c671484bea",
                "Designator": "J5",
                "Footprint": "3c1de87666fa1f98",
                "Value": "HDMI OUT",
                "UserDocLink": "",
                "Description": "",
                "ki_keywords": "",
                "ki_fp_filters": "",
                "Symbol": "6d1242dbcf4b53dc",
                "LCSC": "C916313",
                "Comment": "MOLEX 2086581001; PCBA required including four through-hole shell tabs; no customer HDMI soldering. Confirm full connector assembly in supplier preview.",
                "Origin Footprint": "Connector_Video:HDMI_A_Molex_208658-1001_Horizontal",
                "Unique ID": "188f82074eb8ca32",
                "Manufacturer": "",
                "Manufacturer Part": "",
                "Supplier": "LCSC",
                "Supplier Part": "C916313",
                "Group ID": "",
                "Channel ID": "$2ie579",
                "Reuse Block": "",
                "DeviceName": "Connector_HDMI_A",
                "FootprintName": "HDMI_A_Molex_208658-1001_Horizontal"
            },
            "pinInfoMap": {
                "1": {
                    "name": "D2+",
                    "number": "1",
                    "net": "HDMI_D2P_C",
                    "props": {
                        "Pin Number": "1"
                    }
                },
                "2": {
                    "name": "D2S",
                    "number": "2",
                    "net": "GND",
                    "props": {
                        "Pin Number": "2"
                    }
                },
                "3": {
                    "name": "D2-",
                    "number": "3",
                    "net": "HDMI_D2N_C",
                    "props": {
                        "Pin Number": "3"
                    }
                },
                "4": {
                    "name": "D1+",
                    "number": "4",
                    "net": "HDMI_D1P_C",
                    "props": {
                        "Pin Number": "4"
                    }
                },
                "5": {
                    "name": "D1S",
                    "number": "5",
                    "net": "GND",
                    "props": {
                        "Pin Number": "5"
                    }
                },
                "6": {
                    "name": "D1-",
                    "number": "6",
                    "net": "HDMI_D1N_C",
                    "props": {
                        "Pin Number": "6"
                    }
                },
                "7": {
                    "name": "D0+",
                    "number": "7",
                    "net": "HDMI_D0P_C",
                    "props": {
                        "Pin Number": "7"
                    }
                },
                "8": {
                    "name": "D0S",
                    "number": "8",
                    "net": "GND",
                    "props": {
                        "Pin Number": "8"
                    }
                },
                "9": {
                    "name": "D0-",
                    "number": "9",
                    "net": "HDMI_D0N_C",
                    "props": {
                        "Pin Number": "9"
                    }
                },
                "10": {
                    "name": "CK+",
                    "number": "10",
                    "net": "HDMI_CKP_C",
                    "props": {
                        "Pin Number": "10"
                    }
                },
                "11": {
                    "name": "CKS",
                    "number": "11",
                    "net": "GND",
                    "props": {
                        "Pin Number": "11"
                    }
                },
                "12": {
                    "name": "CK-",
                    "number": "12",
                    "net": "HDMI_CKN_C",
                    "props": {
                        "Pin Number": "12"
                    }
                },
                "13": {
                    "name": "CEC",
                    "number": "13",
                    "net": "",
                    "props": {
                        "Pin Number": "13"
                    }
                },
                "14": {
                    "name": "UTILITY",
                    "number": "14",
                    "net": "",
                    "props": {
                        "Pin Number": "14"
                    }
                },
                "15": {
                    "name": "SCL",
                    "number": "15",
                    "net": "HDMI_SCL",
                    "props": {
                        "Pin Number": "15"
                    }
                },
                "16": {
                    "name": "SDA",
                    "number": "16",
                    "net": "HDMI_SDA",
                    "props": {
                        "Pin Number": "16"
                    }
                },
                "17": {
                    "name": "GND",
                    "number": "17",
                    "net": "GND",
                    "props": {
                        "Pin Number": "17"
                    }
                },
                "18": {
                    "name": "+5V",
                    "number": "18",
                    "net": "HDMI_5V",
                    "props": {
                        "Pin Number": "18"
                    }
                },
                "19": {
                    "name": "HPD",
                    "number": "19",
                    "net": "HDMI_HPD",
                    "props": {
                        "Pin Number": "19"
                    }
                },
                "SH": {
                    "name": "SH",
                    "number": "SH",
                    "net": "GND",
                    "props": {
                        "Pin Number": "SH"
                    }
                }
            }
        },
        "26a39bcafcc8ce7c": {
            "props": {
                "Add into BOM": "yes",
                "Convert to PCB": "yes",
                "Name": "Device_C",
                "Device": "80ad6ef38a551d91",
                "Designator": "C12",
                "Footprint": "54d616aeae33209b",
                "Value": "100n",
                "UserDocLink": "",
                "Description": "",
                "ki_keywords": "",
                "ki_fp_filters": "",
                "Symbol": "e542132018ff745e",
                "LCSC": "C1525",
                "Comment": "100nF AC coupling; low-profile 0402 under Core",
                "Origin Footprint": "Capacitor_SMD:C_0402_1005Metric",
                "Unique ID": "26a39bcafcc8ce7c",
                "Manufacturer": "",
                "Manufacturer Part": "",
                "Supplier": "LCSC",
                "Supplier Part": "C1525",
                "Group ID": "",
                "Channel ID": "$2ie590",
                "Reuse Block": "",
                "DeviceName": "Device_C",
                "FootprintName": "C_0402_1005Metric"
            },
            "pinInfoMap": {
                "1": {
                    "name": "",
                    "number": "1",
                    "net": "HDMI_D2P",
                    "props": {
                        "Pin Number": "1"
                    }
                },
                "2": {
                    "name": "",
                    "number": "2",
                    "net": "HDMI_D2P_C",
                    "props": {
                        "Pin Number": "2"
                    }
                }
            }
        },
        "d9f908b8ca857374": {
            "props": {
                "Add into BOM": "yes",
                "Convert to PCB": "yes",
                "Name": "Device_R",
                "Device": "dce15ae5d8c4adea",
                "Designator": "R28",
                "Footprint": "840d5114b71a38b1",
                "Value": "499R",
                "UserDocLink": "",
                "Description": "",
                "ki_keywords": "",
                "ki_fp_filters": "",
                "Symbol": "1a6aa3fb7f7fd24f",
                "LCSC": "C23065",
                "Origin Footprint": "Resistor_SMD:R_0603_1608Metric",
                "Unique ID": "d9f908b8ca857374",
                "Manufacturer": "",
                "Manufacturer Part": "",
                "Supplier": "LCSC",
                "Supplier Part": "C23065",
                "Comment": "",
                "Group ID": "",
                "Channel ID": "$2ie601",
                "Reuse Block": "",
                "DeviceName": "Device_R",
                "FootprintName": "R_0603_1608Metric"
            },
            "pinInfoMap": {
                "1": {
                    "name": "",
                    "number": "1",
                    "net": "HDMI_D2P_C",
                    "props": {
                        "Pin Number": "1"
                    }
                },
                "2": {
                    "name": "",
                    "number": "2",
                    "net": "GND",
                    "props": {
                        "Pin Number": "2"
                    }
                }
            }
        },
        "e7ba3aba9f9889c8": {
            "props": {
                "Add into BOM": "yes",
                "Convert to PCB": "yes",
                "Name": "Device_C",
                "Device": "80ad6ef38a551d91",
                "Designator": "C13",
                "Footprint": "54d616aeae33209b",
                "Value": "100n",
                "UserDocLink": "",
                "Description": "",
                "ki_keywords": "",
                "ki_fp_filters": "",
                "Symbol": "e542132018ff745e",
                "LCSC": "C1525",
                "Comment": "100nF AC coupling; low-profile 0402 under Core",
                "Origin Footprint": "Capacitor_SMD:C_0402_1005Metric",
                "Unique ID": "e7ba3aba9f9889c8",
                "Manufacturer": "",
                "Manufacturer Part": "",
                "Supplier": "LCSC",
                "Supplier Part": "C1525",
                "Group ID": "",
                "Channel ID": "$2ie611",
                "Reuse Block": "",
                "DeviceName": "Device_C",
                "FootprintName": "C_0402_1005Metric"
            },
            "pinInfoMap": {
                "1": {
                    "name": "",
                    "number": "1",
                    "net": "HDMI_D2N",
                    "props": {
                        "Pin Number": "1"
                    }
                },
                "2": {
                    "name": "",
                    "number": "2",
                    "net": "HDMI_D2N_C",
                    "props": {
                        "Pin Number": "2"
                    }
                }
            }
        },
        "9e71ce6b7342da3b": {
            "props": {
                "Add into BOM": "yes",
                "Convert to PCB": "yes",
                "Name": "Device_R",
                "Device": "dce15ae5d8c4adea",
                "Designator": "R29",
                "Footprint": "840d5114b71a38b1",
                "Value": "499R",
                "UserDocLink": "",
                "Description": "",
                "ki_keywords": "",
                "ki_fp_filters": "",
                "Symbol": "1a6aa3fb7f7fd24f",
                "LCSC": "C23065",
                "Origin Footprint": "Resistor_SMD:R_0603_1608Metric",
                "Unique ID": "9e71ce6b7342da3b",
                "Manufacturer": "",
                "Manufacturer Part": "",
                "Supplier": "LCSC",
                "Supplier Part": "C23065",
                "Comment": "",
                "Group ID": "",
                "Channel ID": "$2ie622",
                "Reuse Block": "",
                "DeviceName": "Device_R",
                "FootprintName": "R_0603_1608Metric"
            },
            "pinInfoMap": {
                "1": {
                    "name": "",
                    "number": "1",
                    "net": "HDMI_D2N_C",
                    "props": {
                        "Pin Number": "1"
                    }
                },
                "2": {
                    "name": "",
                    "number": "2",
                    "net": "GND",
                    "props": {
                        "Pin Number": "2"
                    }
                }
            }
        },
        "00361082df9d4549": {
            "props": {
                "Add into BOM": "yes",
                "Convert to PCB": "yes",
                "Name": "Device_C",
                "Device": "80ad6ef38a551d91",
                "Designator": "C14",
                "Footprint": "54d616aeae33209b",
                "Value": "100n",
                "UserDocLink": "",
                "Description": "",
                "ki_keywords": "",
                "ki_fp_filters": "",
                "Symbol": "e542132018ff745e",
                "LCSC": "C1525",
                "Comment": "100nF AC coupling; low-profile 0402 under Core",
                "Origin Footprint": "Capacitor_SMD:C_0402_1005Metric",
                "Unique ID": "00361082df9d4549",
                "Manufacturer": "",
                "Manufacturer Part": "",
                "Supplier": "LCSC",
                "Supplier Part": "C1525",
                "Group ID": "",
                "Channel ID": "$2ie632",
                "Reuse Block": "",
                "DeviceName": "Device_C",
                "FootprintName": "C_0402_1005Metric"
            },
            "pinInfoMap": {
                "1": {
                    "name": "",
                    "number": "1",
                    "net": "HDMI_D1P",
                    "props": {
                        "Pin Number": "1"
                    }
                },
                "2": {
                    "name": "",
                    "number": "2",
                    "net": "HDMI_D1P_C",
                    "props": {
                        "Pin Number": "2"
                    }
                }
            }
        },
        "8a972535593efa61": {
            "props": {
                "Add into BOM": "yes",
                "Convert to PCB": "yes",
                "Name": "Device_R",
                "Device": "0321cd83d4108517",
                "Designator": "R30",
                "Footprint": "4e6ea46832b30652",
                "Value": "499R",
                "UserDocLink": "",
                "Description": "",
                "ki_keywords": "",
                "ki_fp_filters": "",
                "Symbol": "1a6aa3fb7f7fd24f",
                "LCSC": "C4125",
                "Origin Footprint": "Resistor_SMD:R_0402_1005Metric",
                "Unique ID": "8a972535593efa61",
                "Manufacturer": "",
                "Manufacturer Part": "",
                "Supplier": "LCSC",
                "Supplier Part": "C4125",
                "Comment": "",
                "Group ID": "",
                "Channel ID": "$2ie643",
                "Reuse Block": "",
                "DeviceName": "Device_R",
                "FootprintName": "R_0402_1005Metric"
            },
            "pinInfoMap": {
                "1": {
                    "name": "",
                    "number": "1",
                    "net": "HDMI_D1P_C",
                    "props": {
                        "Pin Number": "1"
                    }
                },
                "2": {
                    "name": "",
                    "number": "2",
                    "net": "GND",
                    "props": {
                        "Pin Number": "2"
                    }
                }
            }
        },
        "86bb77bda672094d": {
            "props": {
                "Add into BOM": "yes",
                "Convert to PCB": "yes",
                "Name": "Device_C",
                "Device": "80ad6ef38a551d91",
                "Designator": "C15",
                "Footprint": "54d616aeae33209b",
                "Value": "100n",
                "UserDocLink": "",
                "Description": "",
                "ki_keywords": "",
                "ki_fp_filters": "",
                "Symbol": "e542132018ff745e",
                "LCSC": "C1525",
                "Comment": "100nF AC coupling; low-profile 0402 under Core",
                "Origin Footprint": "Capacitor_SMD:C_0402_1005Metric",
                "Unique ID": "86bb77bda672094d",
                "Manufacturer": "",
                "Manufacturer Part": "",
                "Supplier": "LCSC",
                "Supplier Part": "C1525",
                "Group ID": "",
                "Channel ID": "$2ie653",
                "Reuse Block": "",
                "DeviceName": "Device_C",
                "FootprintName": "C_0402_1005Metric"
            },
            "pinInfoMap": {
                "1": {
                    "name": "",
                    "number": "1",
                    "net": "HDMI_D1N",
                    "props": {
                        "Pin Number": "1"
                    }
                },
                "2": {
                    "name": "",
                    "number": "2",
                    "net": "HDMI_D1N_C",
                    "props": {
                        "Pin Number": "2"
                    }
                }
            }
        },
        "b304d0fb6138316f": {
            "props": {
                "Add into BOM": "yes",
                "Convert to PCB": "yes",
                "Name": "Device_R",
                "Device": "0321cd83d4108517",
                "Designator": "R31",
                "Footprint": "4e6ea46832b30652",
                "Value": "499R",
                "UserDocLink": "",
                "Description": "",
                "ki_keywords": "",
                "ki_fp_filters": "",
                "Symbol": "1a6aa3fb7f7fd24f",
                "LCSC": "C4125",
                "Origin Footprint": "Resistor_SMD:R_0402_1005Metric",
                "Unique ID": "b304d0fb6138316f",
                "Manufacturer": "",
                "Manufacturer Part": "",
                "Supplier": "LCSC",
                "Supplier Part": "C4125",
                "Comment": "",
                "Group ID": "",
                "Channel ID": "$2ie664",
                "Reuse Block": "",
                "DeviceName": "Device_R",
                "FootprintName": "R_0402_1005Metric"
            },
            "pinInfoMap": {
                "1": {
                    "name": "",
                    "number": "1",
                    "net": "HDMI_D1N_C",
                    "props": {
                        "Pin Number": "1"
                    }
                },
                "2": {
                    "name": "",
                    "number": "2",
                    "net": "GND",
                    "props": {
                        "Pin Number": "2"
                    }
                }
            }
        },
        "c8e923f96b539988": {
            "props": {
                "Add into BOM": "yes",
                "Convert to PCB": "yes",
                "Name": "Device_C",
                "Device": "80ad6ef38a551d91",
                "Designator": "C16",
                "Footprint": "54d616aeae33209b",
                "Value": "100n",
                "UserDocLink": "",
                "Description": "",
                "ki_keywords": "",
                "ki_fp_filters": "",
                "Symbol": "e542132018ff745e",
                "LCSC": "C1525",
                "Comment": "100nF AC coupling; low-profile 0402 under Core",
                "Origin Footprint": "Capacitor_SMD:C_0402_1005Metric",
                "Unique ID": "c8e923f96b539988",
                "Manufacturer": "",
                "Manufacturer Part": "",
                "Supplier": "LCSC",
                "Supplier Part": "C1525",
                "Group ID": "",
                "Channel ID": "$2ie674",
                "Reuse Block": "",
                "DeviceName": "Device_C",
                "FootprintName": "C_0402_1005Metric"
            },
            "pinInfoMap": {
                "1": {
                    "name": "",
                    "number": "1",
                    "net": "HDMI_D0P",
                    "props": {
                        "Pin Number": "1"
                    }
                },
                "2": {
                    "name": "",
                    "number": "2",
                    "net": "HDMI_D0P_C",
                    "props": {
                        "Pin Number": "2"
                    }
                }
            }
        },
        "94189e0415d5623f": {
            "props": {
                "Add into BOM": "yes",
                "Convert to PCB": "yes",
                "Name": "Device_R",
                "Device": "dce15ae5d8c4adea",
                "Designator": "R32",
                "Footprint": "840d5114b71a38b1",
                "Value": "499R",
                "UserDocLink": "",
                "Description": "",
                "ki_keywords": "",
                "ki_fp_filters": "",
                "Symbol": "1a6aa3fb7f7fd24f",
                "LCSC": "C23065",
                "Origin Footprint": "Resistor_SMD:R_0603_1608Metric",
                "Unique ID": "94189e0415d5623f",
                "Manufacturer": "",
                "Manufacturer Part": "",
                "Supplier": "LCSC",
                "Supplier Part": "C23065",
                "Comment": "",
                "Group ID": "",
                "Channel ID": "$2ie685",
                "Reuse Block": "",
                "DeviceName": "Device_R",
                "FootprintName": "R_0603_1608Metric"
            },
            "pinInfoMap": {
                "1": {
                    "name": "",
                    "number": "1",
                    "net": "HDMI_D0P_C",
                    "props": {
                        "Pin Number": "1"
                    }
                },
                "2": {
                    "name": "",
                    "number": "2",
                    "net": "GND",
                    "props": {
                        "Pin Number": "2"
                    }
                }
            }
        },
        "48700c84863a802e": {
            "props": {
                "Add into BOM": "yes",
                "Convert to PCB": "yes",
                "Name": "Device_C",
                "Device": "80ad6ef38a551d91",
                "Designator": "C17",
                "Footprint": "54d616aeae33209b",
                "Value": "100n",
                "UserDocLink": "",
                "Description": "",
                "ki_keywords": "",
                "ki_fp_filters": "",
                "Symbol": "e542132018ff745e",
                "LCSC": "C1525",
                "Comment": "100nF AC coupling; low-profile 0402 under Core",
                "Origin Footprint": "Capacitor_SMD:C_0402_1005Metric",
                "Unique ID": "48700c84863a802e",
                "Manufacturer": "",
                "Manufacturer Part": "",
                "Supplier": "LCSC",
                "Supplier Part": "C1525",
                "Group ID": "",
                "Channel ID": "$2ie695",
                "Reuse Block": "",
                "DeviceName": "Device_C",
                "FootprintName": "C_0402_1005Metric"
            },
            "pinInfoMap": {
                "1": {
                    "name": "",
                    "number": "1",
                    "net": "HDMI_D0N",
                    "props": {
                        "Pin Number": "1"
                    }
                },
                "2": {
                    "name": "",
                    "number": "2",
                    "net": "HDMI_D0N_C",
                    "props": {
                        "Pin Number": "2"
                    }
                }
            }
        },
        "e0ee0f05e2f0b4da": {
            "props": {
                "Add into BOM": "yes",
                "Convert to PCB": "yes",
                "Name": "Device_R",
                "Device": "dce15ae5d8c4adea",
                "Designator": "R33",
                "Footprint": "840d5114b71a38b1",
                "Value": "499R",
                "UserDocLink": "",
                "Description": "",
                "ki_keywords": "",
                "ki_fp_filters": "",
                "Symbol": "1a6aa3fb7f7fd24f",
                "LCSC": "C23065",
                "Origin Footprint": "Resistor_SMD:R_0603_1608Metric",
                "Unique ID": "e0ee0f05e2f0b4da",
                "Manufacturer": "",
                "Manufacturer Part": "",
                "Supplier": "LCSC",
                "Supplier Part": "C23065",
                "Comment": "",
                "Group ID": "",
                "Channel ID": "$2ie706",
                "Reuse Block": "",
                "DeviceName": "Device_R",
                "FootprintName": "R_0603_1608Metric"
            },
            "pinInfoMap": {
                "1": {
                    "name": "",
                    "number": "1",
                    "net": "HDMI_D0N_C",
                    "props": {
                        "Pin Number": "1"
                    }
                },
                "2": {
                    "name": "",
                    "number": "2",
                    "net": "GND",
                    "props": {
                        "Pin Number": "2"
                    }
                }
            }
        },
        "d9d0285421fe3ef0": {
            "props": {
                "Add into BOM": "yes",
                "Convert to PCB": "yes",
                "Name": "Device_C",
                "Device": "80ad6ef38a551d91",
                "Designator": "C18",
                "Footprint": "54d616aeae33209b",
                "Value": "100n",
                "UserDocLink": "",
                "Description": "",
                "ki_keywords": "",
                "ki_fp_filters": "",
                "Symbol": "e542132018ff745e",
                "LCSC": "C1525",
                "Comment": "100nF AC coupling; low-profile 0402 under Core",
                "Origin Footprint": "Capacitor_SMD:C_0402_1005Metric",
                "Unique ID": "d9d0285421fe3ef0",
                "Manufacturer": "",
                "Manufacturer Part": "",
                "Supplier": "LCSC",
                "Supplier Part": "C1525",
                "Group ID": "",
                "Channel ID": "$2ie716",
                "Reuse Block": "",
                "DeviceName": "Device_C",
                "FootprintName": "C_0402_1005Metric"
            },
            "pinInfoMap": {
                "1": {
                    "name": "",
                    "number": "1",
                    "net": "HDMI_CKP",
                    "props": {
                        "Pin Number": "1"
                    }
                },
                "2": {
                    "name": "",
                    "number": "2",
                    "net": "HDMI_CKP_C",
                    "props": {
                        "Pin Number": "2"
                    }
                }
            }
        },
        "c7fcac2dc179deab": {
            "props": {
                "Add into BOM": "yes",
                "Convert to PCB": "yes",
                "Name": "Device_R",
                "Device": "dce15ae5d8c4adea",
                "Designator": "R34",
                "Footprint": "840d5114b71a38b1",
                "Value": "499R",
                "UserDocLink": "",
                "Description": "",
                "ki_keywords": "",
                "ki_fp_filters": "",
                "Symbol": "1a6aa3fb7f7fd24f",
                "LCSC": "C23065",
                "Origin Footprint": "Resistor_SMD:R_0603_1608Metric",
                "Unique ID": "c7fcac2dc179deab",
                "Manufacturer": "",
                "Manufacturer Part": "",
                "Supplier": "LCSC",
                "Supplier Part": "C23065",
                "Comment": "",
                "Group ID": "",
                "Channel ID": "$2ie727",
                "Reuse Block": "",
                "DeviceName": "Device_R",
                "FootprintName": "R_0603_1608Metric"
            },
            "pinInfoMap": {
                "1": {
                    "name": "",
                    "number": "1",
                    "net": "HDMI_CKP_C",
                    "props": {
                        "Pin Number": "1"
                    }
                },
                "2": {
                    "name": "",
                    "number": "2",
                    "net": "GND",
                    "props": {
                        "Pin Number": "2"
                    }
                }
            }
        },
        "9b75bd895f0e39d2": {
            "props": {
                "Add into BOM": "yes",
                "Convert to PCB": "yes",
                "Name": "Device_C",
                "Device": "80ad6ef38a551d91",
                "Designator": "C19",
                "Footprint": "54d616aeae33209b",
                "Value": "100n",
                "UserDocLink": "",
                "Description": "",
                "ki_keywords": "",
                "ki_fp_filters": "",
                "Symbol": "e542132018ff745e",
                "LCSC": "C1525",
                "Comment": "100nF AC coupling; low-profile 0402 under Core",
                "Origin Footprint": "Capacitor_SMD:C_0402_1005Metric",
                "Unique ID": "9b75bd895f0e39d2",
                "Manufacturer": "",
                "Manufacturer Part": "",
                "Supplier": "LCSC",
                "Supplier Part": "C1525",
                "Group ID": "",
                "Channel ID": "$2ie737",
                "Reuse Block": "",
                "DeviceName": "Device_C",
                "FootprintName": "C_0402_1005Metric"
            },
            "pinInfoMap": {
                "1": {
                    "name": "",
                    "number": "1",
                    "net": "HDMI_CKN",
                    "props": {
                        "Pin Number": "1"
                    }
                },
                "2": {
                    "name": "",
                    "number": "2",
                    "net": "HDMI_CKN_C",
                    "props": {
                        "Pin Number": "2"
                    }
                }
            }
        },
        "ed5ed49cac6cc905": {
            "props": {
                "Add into BOM": "yes",
                "Convert to PCB": "yes",
                "Name": "Device_R",
                "Device": "dce15ae5d8c4adea",
                "Designator": "R35",
                "Footprint": "840d5114b71a38b1",
                "Value": "499R",
                "UserDocLink": "",
                "Description": "",
                "ki_keywords": "",
                "ki_fp_filters": "",
                "Symbol": "1a6aa3fb7f7fd24f",
                "LCSC": "C23065",
                "Origin Footprint": "Resistor_SMD:R_0603_1608Metric",
                "Unique ID": "ed5ed49cac6cc905",
                "Manufacturer": "",
                "Manufacturer Part": "",
                "Supplier": "LCSC",
                "Supplier Part": "C23065",
                "Comment": "",
                "Group ID": "",
                "Channel ID": "$2ie748",
                "Reuse Block": "",
                "DeviceName": "Device_R",
                "FootprintName": "R_0603_1608Metric"
            },
            "pinInfoMap": {
                "1": {
                    "name": "",
                    "number": "1",
                    "net": "HDMI_CKN_C",
                    "props": {
                        "Pin Number": "1"
                    }
                },
                "2": {
                    "name": "",
                    "number": "2",
                    "net": "GND",
                    "props": {
                        "Pin Number": "2"
                    }
                }
            }
        },
        "bac468049775df37": {
            "props": {
                "Add into BOM": "yes",
                "Convert to PCB": "yes",
                "Name": "carrier_RCLAMP0524P",
                "Device": "377772efd65c625c",
                "Designator": "U4",
                "Value": "RCLAMP0524P",
                "UserDocLink": "",
                "Description": "",
                "Origin Footprint": "carrier:DFN2510-10L_RCLAMP0524P",
                "Symbol": "13e1ce75e56fdcd5",
                "LCSC": "C293965",
                "Comment": "TMDS ESD array (DOWO DFN2510-10L): I/O 1,2,4,5, GND 3,8; the line is routed as continuous copper through strapped pads",
                "Unique ID": "bac468049775df37",
                "Manufacturer": "",
                "Manufacturer Part": "",
                "Supplier": "LCSC",
                "Supplier Part": "C293965",
                "Footprint": "093388a99cbe07a4",
                "Group ID": "",
                "Channel ID": "$2ie758",
                "Reuse Block": "",
                "DeviceName": "carrier_RCLAMP0524P",
                "FootprintName": "DFN2510-10L_RCLAMP0524P"
            },
            "pinInfoMap": {
                "1": {
                    "name": "IO1",
                    "number": "1",
                    "net": "HDMI_D2P_C",
                    "props": {
                        "Pin Number": "1"
                    }
                },
                "2": {
                    "name": "IO2",
                    "number": "2",
                    "net": "HDMI_D2N_C",
                    "props": {
                        "Pin Number": "2"
                    }
                },
                "3": {
                    "name": "GND",
                    "number": "3",
                    "net": "GND",
                    "props": {
                        "Pin Number": "3"
                    }
                },
                "4": {
                    "name": "IO3",
                    "number": "4",
                    "net": "HDMI_D1P_C",
                    "props": {
                        "Pin Number": "4"
                    }
                },
                "5": {
                    "name": "IO4",
                    "number": "5",
                    "net": "HDMI_D1N_C",
                    "props": {
                        "Pin Number": "5"
                    }
                },
                "6": {
                    "name": "NC",
                    "number": "6",
                    "net": "HDMI_D1N_C",
                    "props": {
                        "Pin Number": "6"
                    }
                },
                "7": {
                    "name": "NC",
                    "number": "7",
                    "net": "HDMI_D1P_C",
                    "props": {
                        "Pin Number": "7"
                    }
                },
                "8": {
                    "name": "GND",
                    "number": "8",
                    "net": "GND",
                    "props": {
                        "Pin Number": "8"
                    }
                },
                "9": {
                    "name": "NC",
                    "number": "9",
                    "net": "HDMI_D2N_C",
                    "props": {
                        "Pin Number": "9"
                    }
                },
                "10": {
                    "name": "NC",
                    "number": "10",
                    "net": "HDMI_D2P_C",
                    "props": {
                        "Pin Number": "10"
                    }
                }
            }
        },
        "adf583383e4d69d4": {
            "props": {
                "Add into BOM": "yes",
                "Convert to PCB": "yes",
                "Name": "carrier_RCLAMP0524P",
                "Device": "377772efd65c625c",
                "Designator": "U5",
                "Value": "RCLAMP0524P",
                "UserDocLink": "",
                "Description": "",
                "Origin Footprint": "carrier:DFN2510-10L_RCLAMP0524P",
                "Symbol": "13e1ce75e56fdcd5",
                "LCSC": "C293965",
                "Comment": "TMDS ESD array (DOWO DFN2510-10L): I/O 1,2,4,5, GND 3,8; the line is routed as continuous copper through strapped pads",
                "Unique ID": "adf583383e4d69d4",
                "Manufacturer": "",
                "Manufacturer Part": "",
                "Supplier": "LCSC",
                "Supplier Part": "C293965",
                "Footprint": "093388a99cbe07a4",
                "Group ID": "",
                "Channel ID": "$2ie769",
                "Reuse Block": "",
                "DeviceName": "carrier_RCLAMP0524P",
                "FootprintName": "DFN2510-10L_RCLAMP0524P"
            },
            "pinInfoMap": {
                "1": {
                    "name": "IO1",
                    "number": "1",
                    "net": "HDMI_D0P_C",
                    "props": {
                        "Pin Number": "1"
                    }
                },
                "2": {
                    "name": "IO2",
                    "number": "2",
                    "net": "HDMI_D0N_C",
                    "props": {
                        "Pin Number": "2"
                    }
                },
                "3": {
                    "name": "GND",
                    "number": "3",
                    "net": "GND",
                    "props": {
                        "Pin Number": "3"
                    }
                },
                "4": {
                    "name": "IO3",
                    "number": "4",
                    "net": "HDMI_CKP_C",
                    "props": {
                        "Pin Number": "4"
                    }
                },
                "5": {
                    "name": "IO4",
                    "number": "5",
                    "net": "HDMI_CKN_C",
                    "props": {
                        "Pin Number": "5"
                    }
                },
                "6": {
                    "name": "NC",
                    "number": "6",
                    "net": "HDMI_CKN_C",
                    "props": {
                        "Pin Number": "6"
                    }
                },
                "7": {
                    "name": "NC",
                    "number": "7",
                    "net": "HDMI_CKP_C",
                    "props": {
                        "Pin Number": "7"
                    }
                },
                "8": {
                    "name": "GND",
                    "number": "8",
                    "net": "GND",
                    "props": {
                        "Pin Number": "8"
                    }
                },
                "9": {
                    "name": "NC",
                    "number": "9",
                    "net": "HDMI_D0N_C",
                    "props": {
                        "Pin Number": "9"
                    }
                },
                "10": {
                    "name": "NC",
                    "number": "10",
                    "net": "HDMI_D0P_C",
                    "props": {
                        "Pin Number": "10"
                    }
                }
            }
        },
        "124c013cfc851acc": {
            "props": {
                "Add into BOM": "yes",
                "Convert to PCB": "yes",
                "Name": "carrier_RCLAMP0524P",
                "Device": "377772efd65c625c",
                "Designator": "U6",
                "Value": "RCLAMP0524P",
                "UserDocLink": "",
                "Description": "",
                "Origin Footprint": "carrier:DFN2510-10L_RCLAMP0524P",
                "Symbol": "13e1ce75e56fdcd5",
                "LCSC": "C293965",
                "Comment": "Independent ground-referenced ESD channels, no shared VCC steering; NC counterpart lands externally copper strapped",
                "Unique ID": "124c013cfc851acc",
                "Manufacturer": "",
                "Manufacturer Part": "",
                "Supplier": "LCSC",
                "Supplier Part": "C293965",
                "Footprint": "093388a99cbe07a4",
                "Group ID": "",
                "Channel ID": "$2ie780",
                "Reuse Block": "",
                "DeviceName": "carrier_RCLAMP0524P",
                "FootprintName": "DFN2510-10L_RCLAMP0524P"
            },
            "pinInfoMap": {
                "1": {
                    "name": "IO1",
                    "number": "1",
                    "net": "HDMI_SDA",
                    "props": {
                        "Pin Number": "1"
                    }
                },
                "2": {
                    "name": "IO2",
                    "number": "2",
                    "net": "HDMI_5V",
                    "props": {
                        "Pin Number": "2"
                    }
                },
                "3": {
                    "name": "GND",
                    "number": "3",
                    "net": "GND",
                    "props": {
                        "Pin Number": "3"
                    }
                },
                "4": {
                    "name": "IO3",
                    "number": "4",
                    "net": "HDMI_SCL",
                    "props": {
                        "Pin Number": "4"
                    }
                },
                "5": {
                    "name": "IO4",
                    "number": "5",
                    "net": "HDMI_HPD",
                    "props": {
                        "Pin Number": "5"
                    }
                },
                "6": {
                    "name": "NC",
                    "number": "6",
                    "net": "HDMI_HPD",
                    "props": {
                        "Pin Number": "6"
                    }
                },
                "7": {
                    "name": "NC",
                    "number": "7",
                    "net": "HDMI_SCL",
                    "props": {
                        "Pin Number": "7"
                    }
                },
                "8": {
                    "name": "GND",
                    "number": "8",
                    "net": "GND",
                    "props": {
                        "Pin Number": "8"
                    }
                },
                "9": {
                    "name": "NC",
                    "number": "9",
                    "net": "HDMI_5V",
                    "props": {
                        "Pin Number": "9"
                    }
                },
                "10": {
                    "name": "NC",
                    "number": "10",
                    "net": "HDMI_SDA",
                    "props": {
                        "Pin Number": "10"
                    }
                }
            }
        },
        "dce76cdd9f7f4243": {
            "props": {
                "Add into BOM": "yes",
                "Convert to PCB": "yes",
                "Name": "Device_Polyfuse",
                "Device": "bdeee2451ba7b267",
                "Designator": "F2",
                "Footprint": "a328ed0a74d50ff4",
                "Value": "PTC 500mA",
                "UserDocLink": "",
                "Description": "",
                "ki_keywords": "",
                "ki_fp_filters": "",
                "Symbol": "c382bbec9e75422f",
                "LCSC": "C315893",
                "Origin Footprint": "Fuse:Fuse_1206_3216Metric",
                "Unique ID": "dce76cdd9f7f4243",
                "Manufacturer": "",
                "Manufacturer Part": "",
                "Supplier": "LCSC",
                "Supplier Part": "C315893",
                "Comment": "",
                "Group ID": "",
                "Channel ID": "$2ie791",
                "Reuse Block": "",
                "DeviceName": "Device_Polyfuse",
                "FootprintName": "Fuse_1206_3216Metric"
            },
            "pinInfoMap": {
                "1": {
                    "name": "",
                    "number": "1",
                    "net": "+5V",
                    "props": {
                        "Pin Number": "1"
                    }
                },
                "2": {
                    "name": "",
                    "number": "2",
                    "net": "HDMI_5V",
                    "props": {
                        "Pin Number": "2"
                    }
                }
            }
        },
        "f76c01de5337d462": {
            "props": {
                "Add into BOM": "yes",
                "Convert to PCB": "yes",
                "Name": "Transistor_FET_2N7002",
                "Device": "c5fa771d650c604c",
                "Designator": "Q1",
                "Value": "2N7002",
                "UserDocLink": "",
                "Description": "",
                "ki_keywords": "",
                "Origin Footprint": "Package_TO_SOT_SMD:SOT-23",
                "Symbol": "a27019e8d6d9a301",
                "LCSC": "C8545",
                "Comment": "DDC level shifter (pin1=G pin2=S pin3=D)",
                "Unique ID": "f76c01de5337d462",
                "Manufacturer": "",
                "Manufacturer Part": "",
                "Supplier": "LCSC",
                "Supplier Part": "C8545",
                "Footprint": "0053beec1f9b605e",
                "Group ID": "",
                "Channel ID": "$2ie801",
                "Reuse Block": "",
                "DeviceName": "Transistor_FET_2N7002",
                "FootprintName": "SOT-23"
            },
            "pinInfoMap": {
                "1": {
                    "name": "G",
                    "number": "1",
                    "net": "+3V3",
                    "props": {
                        "Pin Number": "1"
                    }
                },
                "2": {
                    "name": "S",
                    "number": "2",
                    "net": "F_HSCL",
                    "props": {
                        "Pin Number": "2"
                    }
                },
                "3": {
                    "name": "D",
                    "number": "3",
                    "net": "HDMI_SCL",
                    "props": {
                        "Pin Number": "3"
                    }
                }
            }
        },
        "4c27cd76e8dbac26": {
            "props": {
                "Add into BOM": "yes",
                "Convert to PCB": "yes",
                "Name": "Transistor_FET_2N7002",
                "Device": "c5fa771d650c604c",
                "Designator": "Q2",
                "Value": "2N7002",
                "UserDocLink": "",
                "Description": "",
                "ki_keywords": "",
                "Origin Footprint": "Package_TO_SOT_SMD:SOT-23",
                "Symbol": "a27019e8d6d9a301",
                "LCSC": "C8545",
                "Unique ID": "4c27cd76e8dbac26",
                "Comment": "",
                "Manufacturer": "",
                "Manufacturer Part": "",
                "Supplier": "LCSC",
                "Supplier Part": "C8545",
                "Footprint": "0053beec1f9b605e",
                "Group ID": "",
                "Channel ID": "$2ie812",
                "Reuse Block": "",
                "DeviceName": "Transistor_FET_2N7002",
                "FootprintName": "SOT-23"
            },
            "pinInfoMap": {
                "1": {
                    "name": "G",
                    "number": "1",
                    "net": "+3V3",
                    "props": {
                        "Pin Number": "1"
                    }
                },
                "2": {
                    "name": "S",
                    "number": "2",
                    "net": "F_HSDA",
                    "props": {
                        "Pin Number": "2"
                    }
                },
                "3": {
                    "name": "D",
                    "number": "3",
                    "net": "HDMI_SDA",
                    "props": {
                        "Pin Number": "3"
                    }
                }
            }
        },
        "ee084f684bde39fa": {
            "props": {
                "Add into BOM": "yes",
                "Convert to PCB": "yes",
                "Name": "Device_R",
                "Device": "dce15ae5d8c4adea",
                "Designator": "R36",
                "Footprint": "840d5114b71a38b1",
                "Value": "10k",
                "UserDocLink": "",
                "Description": "",
                "ki_keywords": "",
                "ki_fp_filters": "",
                "Symbol": "1a6aa3fb7f7fd24f",
                "LCSC": "C25804",
                "Origin Footprint": "Resistor_SMD:R_0603_1608Metric",
                "Unique ID": "ee084f684bde39fa",
                "Manufacturer": "",
                "Manufacturer Part": "",
                "Supplier": "LCSC",
                "Supplier Part": "C25804",
                "Comment": "",
                "Group ID": "",
                "Channel ID": "$2ie822",
                "Reuse Block": "",
                "DeviceName": "Device_R",
                "FootprintName": "R_0603_1608Metric"
            },
            "pinInfoMap": {
                "1": {
                    "name": "",
                    "number": "1",
                    "net": "+3V3",
                    "props": {
                        "Pin Number": "1"
                    }
                },
                "2": {
                    "name": "",
                    "number": "2",
                    "net": "F_HSCL",
                    "props": {
                        "Pin Number": "2"
                    }
                }
            }
        },
        "0e69257913149112": {
            "props": {
                "Add into BOM": "yes",
                "Convert to PCB": "yes",
                "Name": "Device_R",
                "Device": "dce15ae5d8c4adea",
                "Designator": "R37",
                "Footprint": "840d5114b71a38b1",
                "Value": "10k",
                "UserDocLink": "",
                "Description": "",
                "ki_keywords": "",
                "ki_fp_filters": "",
                "Symbol": "1a6aa3fb7f7fd24f",
                "LCSC": "C25804",
                "Origin Footprint": "Resistor_SMD:R_0603_1608Metric",
                "Unique ID": "0e69257913149112",
                "Manufacturer": "",
                "Manufacturer Part": "",
                "Supplier": "LCSC",
                "Supplier Part": "C25804",
                "Comment": "",
                "Group ID": "",
                "Channel ID": "$2ie832",
                "Reuse Block": "",
                "DeviceName": "Device_R",
                "FootprintName": "R_0603_1608Metric"
            },
            "pinInfoMap": {
                "1": {
                    "name": "",
                    "number": "1",
                    "net": "+3V3",
                    "props": {
                        "Pin Number": "1"
                    }
                },
                "2": {
                    "name": "",
                    "number": "2",
                    "net": "F_HSDA",
                    "props": {
                        "Pin Number": "2"
                    }
                }
            }
        },
        "2eb3813281b987ab": {
            "props": {
                "Add into BOM": "yes",
                "Convert to PCB": "yes",
                "Name": "Device_R",
                "Device": "dce15ae5d8c4adea",
                "Designator": "R38",
                "Footprint": "840d5114b71a38b1",
                "Value": "2.2k",
                "UserDocLink": "",
                "Description": "",
                "ki_keywords": "",
                "ki_fp_filters": "",
                "Symbol": "1a6aa3fb7f7fd24f",
                "LCSC": "C4190",
                "Origin Footprint": "Resistor_SMD:R_0603_1608Metric",
                "Unique ID": "2eb3813281b987ab",
                "Manufacturer": "",
                "Manufacturer Part": "",
                "Supplier": "LCSC",
                "Supplier Part": "C4190",
                "Comment": "",
                "Group ID": "",
                "Channel ID": "$2ie842",
                "Reuse Block": "",
                "DeviceName": "Device_R",
                "FootprintName": "R_0603_1608Metric"
            },
            "pinInfoMap": {
                "1": {
                    "name": "",
                    "number": "1",
                    "net": "HDMI_5V",
                    "props": {
                        "Pin Number": "1"
                    }
                },
                "2": {
                    "name": "",
                    "number": "2",
                    "net": "HDMI_SCL",
                    "props": {
                        "Pin Number": "2"
                    }
                }
            }
        },
        "61aee2c7162d13e5": {
            "props": {
                "Add into BOM": "yes",
                "Convert to PCB": "yes",
                "Name": "Device_R",
                "Device": "dce15ae5d8c4adea",
                "Designator": "R39",
                "Footprint": "840d5114b71a38b1",
                "Value": "2.2k",
                "UserDocLink": "",
                "Description": "",
                "ki_keywords": "",
                "ki_fp_filters": "",
                "Symbol": "1a6aa3fb7f7fd24f",
                "LCSC": "C4190",
                "Origin Footprint": "Resistor_SMD:R_0603_1608Metric",
                "Unique ID": "61aee2c7162d13e5",
                "Manufacturer": "",
                "Manufacturer Part": "",
                "Supplier": "LCSC",
                "Supplier Part": "C4190",
                "Comment": "",
                "Group ID": "",
                "Channel ID": "$2ie852",
                "Reuse Block": "",
                "DeviceName": "Device_R",
                "FootprintName": "R_0603_1608Metric"
            },
            "pinInfoMap": {
                "1": {
                    "name": "",
                    "number": "1",
                    "net": "HDMI_5V",
                    "props": {
                        "Pin Number": "1"
                    }
                },
                "2": {
                    "name": "",
                    "number": "2",
                    "net": "HDMI_SDA",
                    "props": {
                        "Pin Number": "2"
                    }
                }
            }
        },
        "5d7d37af6db8001c": {
            "props": {
                "Add into BOM": "yes",
                "Convert to PCB": "yes",
                "Name": "Device_R",
                "Device": "dce15ae5d8c4adea",
                "Designator": "R40",
                "Footprint": "840d5114b71a38b1",
                "Value": "47k",
                "UserDocLink": "",
                "Description": "",
                "ki_keywords": "",
                "ki_fp_filters": "",
                "Symbol": "1a6aa3fb7f7fd24f",
                "LCSC": "C25819",
                "Origin Footprint": "Resistor_SMD:R_0603_1608Metric",
                "Unique ID": "5d7d37af6db8001c",
                "Manufacturer": "",
                "Manufacturer Part": "",
                "Supplier": "LCSC",
                "Supplier Part": "C25819",
                "Comment": "",
                "Group ID": "",
                "Channel ID": "$2ie862",
                "Reuse Block": "",
                "DeviceName": "Device_R",
                "FootprintName": "R_0603_1608Metric"
            },
            "pinInfoMap": {
                "1": {
                    "name": "",
                    "number": "1",
                    "net": "HDMI_HPD",
                    "props": {
                        "Pin Number": "1"
                    }
                },
                "2": {
                    "name": "",
                    "number": "2",
                    "net": "HPD_B",
                    "props": {
                        "Pin Number": "2"
                    }
                }
            }
        },
        "e262797b4e338b99": {
            "props": {
                "Add into BOM": "yes",
                "Convert to PCB": "yes",
                "Name": "Device_R",
                "Device": "dce15ae5d8c4adea",
                "Designator": "R41",
                "Footprint": "840d5114b71a38b1",
                "Value": "100k",
                "UserDocLink": "",
                "Description": "",
                "ki_keywords": "",
                "ki_fp_filters": "",
                "Symbol": "1a6aa3fb7f7fd24f",
                "LCSC": "C25803",
                "Origin Footprint": "Resistor_SMD:R_0603_1608Metric",
                "Unique ID": "e262797b4e338b99",
                "Manufacturer": "",
                "Manufacturer Part": "",
                "Supplier": "LCSC",
                "Supplier Part": "C25803",
                "Comment": "",
                "Group ID": "",
                "Channel ID": "$2ie872",
                "Reuse Block": "",
                "DeviceName": "Device_R",
                "FootprintName": "R_0603_1608Metric"
            },
            "pinInfoMap": {
                "1": {
                    "name": "",
                    "number": "1",
                    "net": "HPD_B",
                    "props": {
                        "Pin Number": "1"
                    }
                },
                "2": {
                    "name": "",
                    "number": "2",
                    "net": "GND",
                    "props": {
                        "Pin Number": "2"
                    }
                }
            }
        },
        "be1703a8306ee88a": {
            "props": {
                "Add into BOM": "no",
                "Convert to PCB": "yes",
                "Name": "Connector_Generic_Conn_02x06_Odd_Even",
                "Device": "8d22143d6372a5fd",
                "Designator": "J6",
                "Footprint": "2eb7b89d891135ec",
                "Value": "PMOD1",
                "UserDocLink": "",
                "Description": "",
                "ki_keywords": "",
                "ki_fp_filters": "",
                "Symbol": "736951769b91f623",
                "Comment": "2x6 PMOD-style, 3.3V. Pads only: pin header is hand-fitted later (DNP)",
                "Origin Footprint": "Connector_PinHeader_2.54mm:PinHeader_2x06_P2.54mm_Vertical",
                "Unique ID": "be1703a8306ee88a",
                "Manufacturer": "",
                "Manufacturer Part": "",
                "Supplier": "",
                "Supplier Part": "1",
                "LCSC": "",
                "Group ID": "",
                "Channel ID": "$2ie882",
                "Reuse Block": "",
                "DeviceName": "Connector_Generic_Conn_02x06_Odd_Even",
                "FootprintName": "PinHeader_2x06_P2.54mm_Vertical"
            },
            "pinInfoMap": {
                "1": {
                    "name": "Pin_1",
                    "number": "1",
                    "net": "P1_0",
                    "props": {
                        "Pin Number": "1"
                    }
                },
                "2": {
                    "name": "Pin_2",
                    "number": "2",
                    "net": "P1_4",
                    "props": {
                        "Pin Number": "2"
                    }
                },
                "3": {
                    "name": "Pin_3",
                    "number": "3",
                    "net": "P1_1",
                    "props": {
                        "Pin Number": "3"
                    }
                },
                "4": {
                    "name": "Pin_4",
                    "number": "4",
                    "net": "P1_5",
                    "props": {
                        "Pin Number": "4"
                    }
                },
                "5": {
                    "name": "Pin_5",
                    "number": "5",
                    "net": "P1_2",
                    "props": {
                        "Pin Number": "5"
                    }
                },
                "6": {
                    "name": "Pin_6",
                    "number": "6",
                    "net": "P1_6",
                    "props": {
                        "Pin Number": "6"
                    }
                },
                "7": {
                    "name": "Pin_7",
                    "number": "7",
                    "net": "P1_3",
                    "props": {
                        "Pin Number": "7"
                    }
                },
                "8": {
                    "name": "Pin_8",
                    "number": "8",
                    "net": "P1_7",
                    "props": {
                        "Pin Number": "8"
                    }
                },
                "9": {
                    "name": "Pin_9",
                    "number": "9",
                    "net": "GND",
                    "props": {
                        "Pin Number": "9"
                    }
                },
                "10": {
                    "name": "Pin_10",
                    "number": "10",
                    "net": "GND",
                    "props": {
                        "Pin Number": "10"
                    }
                },
                "11": {
                    "name": "Pin_11",
                    "number": "11",
                    "net": "+3V3",
                    "props": {
                        "Pin Number": "11"
                    }
                },
                "12": {
                    "name": "Pin_12",
                    "number": "12",
                    "net": "+3V3",
                    "props": {
                        "Pin Number": "12"
                    }
                }
            }
        },
        "adeb8d5268617f3b": {
            "props": {
                "Add into BOM": "no",
                "Convert to PCB": "yes",
                "Name": "Connector_Generic_Conn_02x06_Odd_Even",
                "Device": "8d22143d6372a5fd",
                "Designator": "J7",
                "Footprint": "2eb7b89d891135ec",
                "Value": "PMOD2",
                "UserDocLink": "",
                "Description": "",
                "ki_keywords": "",
                "ki_fp_filters": "",
                "Symbol": "736951769b91f623",
                "Comment": "2x6 PMOD-style, 3.3V. Pads only: pin header is hand-fitted later (DNP)",
                "Origin Footprint": "Connector_PinHeader_2.54mm:PinHeader_2x06_P2.54mm_Vertical",
                "Unique ID": "adeb8d5268617f3b",
                "Manufacturer": "",
                "Manufacturer Part": "",
                "Supplier": "",
                "Supplier Part": "1",
                "LCSC": "",
                "Group ID": "",
                "Channel ID": "$2ie892",
                "Reuse Block": "",
                "DeviceName": "Connector_Generic_Conn_02x06_Odd_Even",
                "FootprintName": "PinHeader_2x06_P2.54mm_Vertical"
            },
            "pinInfoMap": {
                "1": {
                    "name": "Pin_1",
                    "number": "1",
                    "net": "P2_0",
                    "props": {
                        "Pin Number": "1"
                    }
                },
                "2": {
                    "name": "Pin_2",
                    "number": "2",
                    "net": "P2_4",
                    "props": {
                        "Pin Number": "2"
                    }
                },
                "3": {
                    "name": "Pin_3",
                    "number": "3",
                    "net": "P2_1",
                    "props": {
                        "Pin Number": "3"
                    }
                },
                "4": {
                    "name": "Pin_4",
                    "number": "4",
                    "net": "P2_5",
                    "props": {
                        "Pin Number": "4"
                    }
                },
                "5": {
                    "name": "Pin_5",
                    "number": "5",
                    "net": "P2_2",
                    "props": {
                        "Pin Number": "5"
                    }
                },
                "6": {
                    "name": "Pin_6",
                    "number": "6",
                    "net": "P2_6",
                    "props": {
                        "Pin Number": "6"
                    }
                },
                "7": {
                    "name": "Pin_7",
                    "number": "7",
                    "net": "P2_3",
                    "props": {
                        "Pin Number": "7"
                    }
                },
                "8": {
                    "name": "Pin_8",
                    "number": "8",
                    "net": "P2_7",
                    "props": {
                        "Pin Number": "8"
                    }
                },
                "9": {
                    "name": "Pin_9",
                    "number": "9",
                    "net": "GND",
                    "props": {
                        "Pin Number": "9"
                    }
                },
                "10": {
                    "name": "Pin_10",
                    "number": "10",
                    "net": "GND",
                    "props": {
                        "Pin Number": "10"
                    }
                },
                "11": {
                    "name": "Pin_11",
                    "number": "11",
                    "net": "+3V3",
                    "props": {
                        "Pin Number": "11"
                    }
                },
                "12": {
                    "name": "Pin_12",
                    "number": "12",
                    "net": "+3V3",
                    "props": {
                        "Pin Number": "12"
                    }
                }
            }
        },
        "3520350cb8a16ddf": {
            "props": {
                "Add into BOM": "yes",
                "Convert to PCB": "yes",
                "Name": "Device_R",
                "Device": "dce15ae5d8c4adea",
                "Designator": "R42",
                "Footprint": "840d5114b71a38b1",
                "Value": "1k",
                "UserDocLink": "",
                "Description": "",
                "ki_keywords": "",
                "ki_fp_filters": "",
                "Symbol": "1a6aa3fb7f7fd24f",
                "LCSC": "C21190",
                "Origin Footprint": "Resistor_SMD:R_0603_1608Metric",
                "Unique ID": "3520350cb8a16ddf",
                "Manufacturer": "",
                "Manufacturer Part": "",
                "Supplier": "LCSC",
                "Supplier Part": "C21190",
                "Comment": "",
                "Group ID": "",
                "Channel ID": "$2ie902",
                "Reuse Block": "",
                "DeviceName": "Device_R",
                "FootprintName": "R_0603_1608Metric"
            },
            "pinInfoMap": {
                "1": {
                    "name": "",
                    "number": "1",
                    "net": "F_LED0",
                    "props": {
                        "Pin Number": "1"
                    }
                },
                "2": {
                    "name": "",
                    "number": "2",
                    "net": "LED0_A",
                    "props": {
                        "Pin Number": "2"
                    }
                }
            }
        },
        "aa27cf4c2f614704": {
            "props": {
                "Add into BOM": "yes",
                "Convert to PCB": "yes",
                "Name": "Device_LED",
                "Device": "3534cf68855993ec",
                "Designator": "D5",
                "Footprint": "c4db38d9333cd4a8",
                "Value": "LED",
                "UserDocLink": "",
                "Description": "",
                "Sim.Pins": "",
                "ki_keywords": "",
                "ki_fp_filters": "",
                "Symbol": "c925bb8d865ba2bd",
                "LCSC": "C2286",
                "Origin Footprint": "LED_SMD:LED_0603_1608Metric",
                "Unique ID": "aa27cf4c2f614704",
                "Manufacturer": "",
                "Manufacturer Part": "",
                "Supplier": "LCSC",
                "Supplier Part": "C2286",
                "Comment": "",
                "Group ID": "",
                "Channel ID": "$2ie912",
                "Reuse Block": "",
                "DeviceName": "Device_LED",
                "FootprintName": "LED_0603_1608Metric"
            },
            "pinInfoMap": {
                "1": {
                    "name": "K",
                    "number": "1",
                    "net": "GND",
                    "props": {
                        "Pin Number": "1"
                    }
                },
                "2": {
                    "name": "A",
                    "number": "2",
                    "net": "LED0_A",
                    "props": {
                        "Pin Number": "2"
                    }
                }
            }
        },
        "1ad54b734ffff27e": {
            "props": {
                "Add into BOM": "yes",
                "Convert to PCB": "yes",
                "Name": "Device_R",
                "Device": "dce15ae5d8c4adea",
                "Designator": "R43",
                "Footprint": "840d5114b71a38b1",
                "Value": "1k",
                "UserDocLink": "",
                "Description": "",
                "ki_keywords": "",
                "ki_fp_filters": "",
                "Symbol": "1a6aa3fb7f7fd24f",
                "LCSC": "C21190",
                "Origin Footprint": "Resistor_SMD:R_0603_1608Metric",
                "Unique ID": "1ad54b734ffff27e",
                "Manufacturer": "",
                "Manufacturer Part": "",
                "Supplier": "LCSC",
                "Supplier Part": "C21190",
                "Comment": "",
                "Group ID": "",
                "Channel ID": "$2ie922",
                "Reuse Block": "",
                "DeviceName": "Device_R",
                "FootprintName": "R_0603_1608Metric"
            },
            "pinInfoMap": {
                "1": {
                    "name": "",
                    "number": "1",
                    "net": "F_LED1",
                    "props": {
                        "Pin Number": "1"
                    }
                },
                "2": {
                    "name": "",
                    "number": "2",
                    "net": "LED1_A",
                    "props": {
                        "Pin Number": "2"
                    }
                }
            }
        },
        "0b466d7a0d9696a1": {
            "props": {
                "Add into BOM": "yes",
                "Convert to PCB": "yes",
                "Name": "Device_LED",
                "Device": "3534cf68855993ec",
                "Designator": "D6",
                "Footprint": "c4db38d9333cd4a8",
                "Value": "LED",
                "UserDocLink": "",
                "Description": "",
                "Sim.Pins": "",
                "ki_keywords": "",
                "ki_fp_filters": "",
                "Symbol": "c925bb8d865ba2bd",
                "LCSC": "C2286",
                "Origin Footprint": "LED_SMD:LED_0603_1608Metric",
                "Unique ID": "0b466d7a0d9696a1",
                "Manufacturer": "",
                "Manufacturer Part": "",
                "Supplier": "LCSC",
                "Supplier Part": "C2286",
                "Comment": "",
                "Group ID": "",
                "Channel ID": "$2ie932",
                "Reuse Block": "",
                "DeviceName": "Device_LED",
                "FootprintName": "LED_0603_1608Metric"
            },
            "pinInfoMap": {
                "1": {
                    "name": "K",
                    "number": "1",
                    "net": "GND",
                    "props": {
                        "Pin Number": "1"
                    }
                },
                "2": {
                    "name": "A",
                    "number": "2",
                    "net": "LED1_A",
                    "props": {
                        "Pin Number": "2"
                    }
                }
            }
        },
        "3f1747bc7cd0165c": {
            "props": {
                "Add into BOM": "yes",
                "Convert to PCB": "yes",
                "Name": "Device_R",
                "Device": "dce15ae5d8c4adea",
                "Designator": "R44",
                "Footprint": "840d5114b71a38b1",
                "Value": "1k",
                "UserDocLink": "",
                "Description": "",
                "ki_keywords": "",
                "ki_fp_filters": "",
                "Symbol": "1a6aa3fb7f7fd24f",
                "LCSC": "C21190",
                "Origin Footprint": "Resistor_SMD:R_0603_1608Metric",
                "Unique ID": "3f1747bc7cd0165c",
                "Manufacturer": "",
                "Manufacturer Part": "",
                "Supplier": "LCSC",
                "Supplier Part": "C21190",
                "Comment": "",
                "Group ID": "",
                "Channel ID": "$2ie942",
                "Reuse Block": "",
                "DeviceName": "Device_R",
                "FootprintName": "R_0603_1608Metric"
            },
            "pinInfoMap": {
                "1": {
                    "name": "",
                    "number": "1",
                    "net": "F_LED2",
                    "props": {
                        "Pin Number": "1"
                    }
                },
                "2": {
                    "name": "",
                    "number": "2",
                    "net": "LED2_A",
                    "props": {
                        "Pin Number": "2"
                    }
                }
            }
        },
        "61ba849a9213f6b6": {
            "props": {
                "Add into BOM": "yes",
                "Convert to PCB": "yes",
                "Name": "Device_LED",
                "Device": "3534cf68855993ec",
                "Designator": "D7",
                "Footprint": "c4db38d9333cd4a8",
                "Value": "LED",
                "UserDocLink": "",
                "Description": "",
                "Sim.Pins": "",
                "ki_keywords": "",
                "ki_fp_filters": "",
                "Symbol": "c925bb8d865ba2bd",
                "LCSC": "C2286",
                "Origin Footprint": "LED_SMD:LED_0603_1608Metric",
                "Unique ID": "61ba849a9213f6b6",
                "Manufacturer": "",
                "Manufacturer Part": "",
                "Supplier": "LCSC",
                "Supplier Part": "C2286",
                "Comment": "",
                "Group ID": "",
                "Channel ID": "$2ie952",
                "Reuse Block": "",
                "DeviceName": "Device_LED",
                "FootprintName": "LED_0603_1608Metric"
            },
            "pinInfoMap": {
                "1": {
                    "name": "K",
                    "number": "1",
                    "net": "GND",
                    "props": {
                        "Pin Number": "1"
                    }
                },
                "2": {
                    "name": "A",
                    "number": "2",
                    "net": "LED2_A",
                    "props": {
                        "Pin Number": "2"
                    }
                }
            }
        },
        "fe3640da4f52432f": {
            "props": {
                "Add into BOM": "yes",
                "Convert to PCB": "yes",
                "Name": "Device_R",
                "Device": "dce15ae5d8c4adea",
                "Designator": "R45",
                "Footprint": "840d5114b71a38b1",
                "Value": "1k",
                "UserDocLink": "",
                "Description": "",
                "ki_keywords": "",
                "ki_fp_filters": "",
                "Symbol": "1a6aa3fb7f7fd24f",
                "LCSC": "C21190",
                "Origin Footprint": "Resistor_SMD:R_0603_1608Metric",
                "Unique ID": "fe3640da4f52432f",
                "Manufacturer": "",
                "Manufacturer Part": "",
                "Supplier": "LCSC",
                "Supplier Part": "C21190",
                "Comment": "",
                "Group ID": "",
                "Channel ID": "$2ie962",
                "Reuse Block": "",
                "DeviceName": "Device_R",
                "FootprintName": "R_0603_1608Metric"
            },
            "pinInfoMap": {
                "1": {
                    "name": "",
                    "number": "1",
                    "net": "F_LED3",
                    "props": {
                        "Pin Number": "1"
                    }
                },
                "2": {
                    "name": "",
                    "number": "2",
                    "net": "LED3_A",
                    "props": {
                        "Pin Number": "2"
                    }
                }
            }
        },
        "d726a396729c3148": {
            "props": {
                "Add into BOM": "yes",
                "Convert to PCB": "yes",
                "Name": "Device_LED",
                "Device": "3534cf68855993ec",
                "Designator": "D8",
                "Footprint": "c4db38d9333cd4a8",
                "Value": "LED",
                "UserDocLink": "",
                "Description": "",
                "Sim.Pins": "",
                "ki_keywords": "",
                "ki_fp_filters": "",
                "Symbol": "c925bb8d865ba2bd",
                "LCSC": "C2286",
                "Origin Footprint": "LED_SMD:LED_0603_1608Metric",
                "Unique ID": "d726a396729c3148",
                "Manufacturer": "",
                "Manufacturer Part": "",
                "Supplier": "LCSC",
                "Supplier Part": "C2286",
                "Comment": "",
                "Group ID": "",
                "Channel ID": "$2ie972",
                "Reuse Block": "",
                "DeviceName": "Device_LED",
                "FootprintName": "LED_0603_1608Metric"
            },
            "pinInfoMap": {
                "1": {
                    "name": "K",
                    "number": "1",
                    "net": "GND",
                    "props": {
                        "Pin Number": "1"
                    }
                },
                "2": {
                    "name": "A",
                    "number": "2",
                    "net": "LED3_A",
                    "props": {
                        "Pin Number": "2"
                    }
                }
            }
        },
        "c39dab7994ba8bcb": {
            "props": {
                "Add into BOM": "yes",
                "Convert to PCB": "yes",
                "Name": "Switch_SW_Push",
                "Device": "0ea6fc68aff78d13",
                "Designator": "SW1",
                "Footprint": "b6a370204b09708a",
                "Value": "TS-1102S-B-D-B",
                "UserDocLink": "",
                "Description": "",
                "ki_keywords": "",
                "Symbol": "138c6a4349212977",
                "LCSC": "C480272",
                "Comment": "PCBA SMT; XKB C480272 H5.5mm; manufacturer12x5.9mm lands; confirm contact grouping and mechanical fit in assembly preview",
                "Origin Footprint": "carrier:SW_XKB_TS1102S_C480272",
                "Unique ID": "c39dab7994ba8bcb",
                "Manufacturer": "",
                "Manufacturer Part": "",
                "Supplier": "LCSC",
                "Supplier Part": "C480272",
                "Group ID": "",
                "Channel ID": "$2ie982",
                "Reuse Block": "",
                "DeviceName": "Switch_SW_Push",
                "FootprintName": "carrier:SW_XKB_TS1102S_C480272"
            },
            "pinInfoMap": {
                "1": {
                    "name": "1",
                    "number": "1",
                    "net": "F_BTN0",
                    "props": {
                        "Pin Number": "1"
                    }
                },
                "2": {
                    "name": "2",
                    "number": "2",
                    "net": "GND",
                    "props": {
                        "Pin Number": "2"
                    }
                }
            }
        },
        "5cf9f4a776b330ee": {
            "props": {
                "Add into BOM": "yes",
                "Convert to PCB": "yes",
                "Name": "Switch_SW_Push",
                "Device": "0ea6fc68aff78d13",
                "Designator": "SW2",
                "Footprint": "b6a370204b09708a",
                "Value": "TS-1102S-B-D-B",
                "UserDocLink": "",
                "Description": "",
                "ki_keywords": "",
                "Symbol": "138c6a4349212977",
                "LCSC": "C480272",
                "Comment": "PCBA SMT; XKB C480272 H5.5mm; manufacturer12x5.9mm lands; confirm contact grouping and mechanical fit in assembly preview",
                "Origin Footprint": "carrier:SW_XKB_TS1102S_C480272",
                "Unique ID": "5cf9f4a776b330ee",
                "Manufacturer": "",
                "Manufacturer Part": "",
                "Supplier": "LCSC",
                "Supplier Part": "C480272",
                "Group ID": "",
                "Channel ID": "$2ie993",
                "Reuse Block": "",
                "DeviceName": "Switch_SW_Push",
                "FootprintName": "carrier:SW_XKB_TS1102S_C480272"
            },
            "pinInfoMap": {
                "1": {
                    "name": "1",
                    "number": "1",
                    "net": "TAB_RST",
                    "props": {
                        "Pin Number": "1"
                    }
                },
                "2": {
                    "name": "2",
                    "number": "2",
                    "net": "GND",
                    "props": {
                        "Pin Number": "2"
                    }
                }
            }
        },
        "2f7d3d657bff299d": {
            "props": {
                "Add into BOM": "yes",
                "Convert to PCB": "yes",
                "Name": "Switch_SW_DIP_x02",
                "Device": "2b81f478099cc7f2",
                "Designator": "SW3",
                "Footprint": "92866978dfd9f852",
                "Value": "KSD22",
                "UserDocLink": "",
                "Description": "",
                "ki_keywords": "",
                "ki_fp_filters": "",
                "Symbol": "8363c9a792119534",
                "Comment": "Akizuki108922 manual assembly; local logical poles1-4/2-3, second pole NC; closed first pole stops FPGA power, open runs. Not a load power switch.",
                "Origin Footprint": "carrier:SW_OTAX_KSD22_Akizuki108922",
                "Unique ID": "2f7d3d657bff299d",
                "Manufacturer": "",
                "Manufacturer Part": "",
                "Supplier": "Akizuki",
                "Supplier Part": "1",
                "LCSC": "",
                "Group ID": "",
                "Channel ID": "$2ie1004",
                "Reuse Block": "",
                "DeviceName": "Switch_SW_DIP_x02",
                "FootprintName": "carrier:SW_OTAX_KSD22_Akizuki108922"
            },
            "pinInfoMap": {
                "1": {
                    "name": "",
                    "number": "1",
                    "net": "BUCK_EN",
                    "props": {
                        "Pin Number": "1"
                    }
                },
                "2": {
                    "name": "",
                    "number": "2",
                    "net": "",
                    "props": {
                        "Pin Number": "2"
                    }
                },
                "3": {
                    "name": "",
                    "number": "3",
                    "net": "",
                    "props": {
                        "Pin Number": "3"
                    }
                },
                "4": {
                    "name": "",
                    "number": "4",
                    "net": "GND",
                    "props": {
                        "Pin Number": "4"
                    }
                }
            }
        },
        "5c2e899d33916bcd": {
            "props": {
                "Add into BOM": "no",
                "Convert to PCB": "yes",
                "Name": "Connector_Generic_Conn_01x09",
                "Device": "423c3be88280e7f2",
                "Designator": "J8",
                "Footprint": "ef635161a1783f83",
                "Value": "GPIO pads",
                "UserDocLink": "",
                "Description": "",
                "ki_keywords": "",
                "ki_fp_filters": "",
                "Symbol": "dbd1cff496725850",
                "Comment": "spare FPGA I/O (3.3V, bank 7): pads only, hand-fit a header or wires later",
                "Origin Footprint": "Connector_PinHeader_2.54mm:PinHeader_1x09_P2.54mm_Vertical",
                "Unique ID": "5c2e899d33916bcd",
                "Manufacturer": "",
                "Manufacturer Part": "",
                "Supplier": "",
                "Supplier Part": "1",
                "LCSC": "",
                "Group ID": "",
                "Channel ID": "$2ie1014",
                "Reuse Block": "",
                "DeviceName": "Connector_Generic_Conn_01x09",
                "FootprintName": "PinHeader_1x09_P2.54mm_Vertical"
            },
            "pinInfoMap": {
                "1": {
                    "name": "Pin_1",
                    "number": "1",
                    "net": "+3V3",
                    "props": {
                        "Pin Number": "1"
                    }
                },
                "2": {
                    "name": "Pin_2",
                    "number": "2",
                    "net": "GND",
                    "props": {
                        "Pin Number": "2"
                    }
                },
                "3": {
                    "name": "Pin_3",
                    "number": "3",
                    "net": "GPIO0",
                    "props": {
                        "Pin Number": "3"
                    }
                },
                "4": {
                    "name": "Pin_4",
                    "number": "4",
                    "net": "GPIO1",
                    "props": {
                        "Pin Number": "4"
                    }
                },
                "5": {
                    "name": "Pin_5",
                    "number": "5",
                    "net": "GPIO2",
                    "props": {
                        "Pin Number": "5"
                    }
                },
                "6": {
                    "name": "Pin_6",
                    "number": "6",
                    "net": "GPIO3",
                    "props": {
                        "Pin Number": "6"
                    }
                },
                "7": {
                    "name": "Pin_7",
                    "number": "7",
                    "net": "GPIO4",
                    "props": {
                        "Pin Number": "7"
                    }
                },
                "8": {
                    "name": "Pin_8",
                    "number": "8",
                    "net": "GPIO5",
                    "props": {
                        "Pin Number": "8"
                    }
                },
                "9": {
                    "name": "Pin_9",
                    "number": "9",
                    "net": "GPIO6",
                    "props": {
                        "Pin Number": "9"
                    }
                }
            }
        },
        "42baa21c67f8a3af": {
            "props": {
                "Add into BOM": "no",
                "Convert to PCB": "yes",
                "Name": "Mechanical_MountingHole",
                "Device": "ff6797d8e34ee6cf",
                "Designator": "H1",
                "Footprint": "f2382a3a65e883d1",
                "Value": "M3",
                "UserDocLink": "",
                "Description": "",
                "ki_keywords": "",
                "ki_fp_filters": "",
                "Symbol": "fbf1bfb48cd14bfd",
                "Origin Footprint": "MountingHole:MountingHole_3.2mm_M3",
                "Unique ID": "42baa21c67f8a3af",
                "Manufacturer": "",
                "Manufacturer Part": "",
                "Supplier": "",
                "Supplier Part": "1",
                "LCSC": "",
                "Comment": "",
                "Group ID": "",
                "Channel ID": "$2ie1024",
                "Reuse Block": "",
                "DeviceName": "Mechanical_MountingHole",
                "FootprintName": "MountingHole_3.2mm_M3"
            },
            "pinInfoMap": {}
        },
        "b7e18a508253e952": {
            "props": {
                "Add into BOM": "no",
                "Convert to PCB": "yes",
                "Name": "Mechanical_MountingHole",
                "Device": "ff6797d8e34ee6cf",
                "Designator": "H2",
                "Footprint": "f2382a3a65e883d1",
                "Value": "M3",
                "UserDocLink": "",
                "Description": "",
                "ki_keywords": "",
                "ki_fp_filters": "",
                "Symbol": "fbf1bfb48cd14bfd",
                "Origin Footprint": "MountingHole:MountingHole_3.2mm_M3",
                "Unique ID": "b7e18a508253e952",
                "Manufacturer": "",
                "Manufacturer Part": "",
                "Supplier": "",
                "Supplier Part": "1",
                "LCSC": "",
                "Comment": "",
                "Group ID": "",
                "Channel ID": "$2ie1033",
                "Reuse Block": "",
                "DeviceName": "Mechanical_MountingHole",
                "FootprintName": "MountingHole_3.2mm_M3"
            },
            "pinInfoMap": {}
        },
        "0c3ab7284e9cbe73": {
            "props": {
                "Add into BOM": "no",
                "Convert to PCB": "yes",
                "Name": "Mechanical_MountingHole",
                "Device": "ff6797d8e34ee6cf",
                "Designator": "H3",
                "Footprint": "f2382a3a65e883d1",
                "Value": "M3",
                "UserDocLink": "",
                "Description": "",
                "ki_keywords": "",
                "ki_fp_filters": "",
                "Symbol": "fbf1bfb48cd14bfd",
                "Origin Footprint": "MountingHole:MountingHole_3.2mm_M3",
                "Unique ID": "0c3ab7284e9cbe73",
                "Manufacturer": "",
                "Manufacturer Part": "",
                "Supplier": "",
                "Supplier Part": "1",
                "LCSC": "",
                "Comment": "",
                "Group ID": "",
                "Channel ID": "$2ie1042",
                "Reuse Block": "",
                "DeviceName": "Mechanical_MountingHole",
                "FootprintName": "MountingHole_3.2mm_M3"
            },
            "pinInfoMap": {}
        },
        "a89bd88a2d6d819d": {
            "props": {
                "Add into BOM": "no",
                "Convert to PCB": "yes",
                "Name": "Mechanical_MountingHole",
                "Device": "ff6797d8e34ee6cf",
                "Designator": "H4",
                "Footprint": "f2382a3a65e883d1",
                "Value": "M3",
                "UserDocLink": "",
                "Description": "",
                "ki_keywords": "",
                "ki_fp_filters": "",
                "Symbol": "fbf1bfb48cd14bfd",
                "Origin Footprint": "MountingHole:MountingHole_3.2mm_M3",
                "Unique ID": "a89bd88a2d6d819d",
                "Manufacturer": "",
                "Manufacturer Part": "",
                "Supplier": "",
                "Supplier Part": "1",
                "LCSC": "",
                "Comment": "",
                "Group ID": "",
                "Channel ID": "$2ie1051",
                "Reuse Block": "",
                "DeviceName": "Mechanical_MountingHole",
                "FootprintName": "MountingHole_3.2mm_M3"
            },
            "pinInfoMap": {}
        },
        "4dda69b6b957e2c3": {
            "props": {
                "Add into BOM": "no",
                "Convert to PCB": "yes",
                "Name": "Mechanical_MountingHole",
                "Device": "ff6797d8e34ee6cf",
                "Designator": "H5",
                "Footprint": "f2382a3a65e883d1",
                "Value": "M3",
                "UserDocLink": "",
                "Description": "",
                "ki_keywords": "",
                "ki_fp_filters": "",
                "Symbol": "fbf1bfb48cd14bfd",
                "Origin Footprint": "MountingHole:MountingHole_3.2mm_M3",
                "Unique ID": "4dda69b6b957e2c3",
                "Manufacturer": "",
                "Manufacturer Part": "",
                "Supplier": "",
                "Supplier Part": "1",
                "LCSC": "",
                "Comment": "",
                "Group ID": "",
                "Channel ID": "$2ie1060",
                "Reuse Block": "",
                "DeviceName": "Mechanical_MountingHole",
                "FootprintName": "MountingHole_3.2mm_M3"
            },
            "pinInfoMap": {}
        },
        "6434c3db7291b230": {
            "props": {
                "Add into BOM": "no",
                "Convert to PCB": "yes",
                "Name": "Mechanical_MountingHole",
                "Device": "ff6797d8e34ee6cf",
                "Designator": "H6",
                "Footprint": "f2382a3a65e883d1",
                "Value": "M3",
                "UserDocLink": "",
                "Description": "",
                "ki_keywords": "",
                "ki_fp_filters": "",
                "Symbol": "fbf1bfb48cd14bfd",
                "Origin Footprint": "MountingHole:MountingHole_3.2mm_M3",
                "Unique ID": "6434c3db7291b230",
                "Manufacturer": "",
                "Manufacturer Part": "",
                "Supplier": "",
                "Supplier Part": "1",
                "LCSC": "",
                "Comment": "",
                "Group ID": "",
                "Channel ID": "$2ie1069",
                "Reuse Block": "",
                "DeviceName": "Mechanical_MountingHole",
                "FootprintName": "MountingHole_3.2mm_M3"
            },
            "pinInfoMap": {}
        },
        "4ec783ed4741de1f": {
            "props": {
                "Add into BOM": "yes",
                "Convert to PCB": "yes",
                "Name": "carrier_SN74CB3Q3245",
                "Device": "e3ac1cf8f4001451",
                "Designator": "U7",
                "Value": "SN74CB3Q3245PWR",
                "UserDocLink": "",
                "Description": "",
                "ki_keywords": "",
                "ki_fp_filters": "",
                "Origin Footprint": "Package_SO:TSSOP-20_4.4x6.5mm_P0.65mm",
                "Symbol": "d4a9fdb35c70c187",
                "LCSC": "C470961",
                "Comment": "Ioff protected 8-bit passive bus switch; OE pulled high by default",
                "Unique ID": "4ec783ed4741de1f",
                "Manufacturer": "",
                "Manufacturer Part": "",
                "Supplier": "LCSC",
                "Supplier Part": "C470961",
                "Footprint": "02a93bd6fb50955c",
                "Group ID": "",
                "Channel ID": "$2ie1078",
                "Reuse Block": "",
                "DeviceName": "carrier_SN74CB3Q3245",
                "FootprintName": "TSSOP-20_4.4x6.5mm_P0.65mm"
            },
            "pinInfoMap": {
                "1": {
                    "name": "NC",
                    "number": "1",
                    "net": "",
                    "props": {
                        "Pin Number": "1"
                    }
                },
                "2": {
                    "name": "A1",
                    "number": "2",
                    "net": "M_CLK",
                    "props": {
                        "Pin Number": "2"
                    }
                },
                "3": {
                    "name": "A2",
                    "number": "3",
                    "net": "M_AUX0",
                    "props": {
                        "Pin Number": "3"
                    }
                },
                "4": {
                    "name": "A3",
                    "number": "4",
                    "net": "M_RDY",
                    "props": {
                        "Pin Number": "4"
                    }
                },
                "5": {
                    "name": "A4",
                    "number": "5",
                    "net": "M_D0",
                    "props": {
                        "Pin Number": "5"
                    }
                },
                "6": {
                    "name": "A5",
                    "number": "6",
                    "net": "M_AUX1",
                    "props": {
                        "Pin Number": "6"
                    }
                },
                "7": {
                    "name": "A6",
                    "number": "7",
                    "net": "M_D1",
                    "props": {
                        "Pin Number": "7"
                    }
                },
                "8": {
                    "name": "A7",
                    "number": "8",
                    "net": "M_D2",
                    "props": {
                        "Pin Number": "8"
                    }
                },
                "9": {
                    "name": "A8",
                    "number": "9",
                    "net": "M_AUX2",
                    "props": {
                        "Pin Number": "9"
                    }
                },
                "10": {
                    "name": "GND",
                    "number": "10",
                    "net": "GND",
                    "props": {
                        "Pin Number": "10"
                    }
                },
                "11": {
                    "name": "B8",
                    "number": "11",
                    "net": "ISO_AUX2",
                    "props": {
                        "Pin Number": "11"
                    }
                },
                "12": {
                    "name": "B7",
                    "number": "12",
                    "net": "ISO_D2",
                    "props": {
                        "Pin Number": "12"
                    }
                },
                "13": {
                    "name": "B6",
                    "number": "13",
                    "net": "ISO_D1",
                    "props": {
                        "Pin Number": "13"
                    }
                },
                "14": {
                    "name": "B5",
                    "number": "14",
                    "net": "ISO_AUX1",
                    "props": {
                        "Pin Number": "14"
                    }
                },
                "15": {
                    "name": "B4",
                    "number": "15",
                    "net": "ISO_D0",
                    "props": {
                        "Pin Number": "15"
                    }
                },
                "16": {
                    "name": "B3",
                    "number": "16",
                    "net": "ISO_RDY",
                    "props": {
                        "Pin Number": "16"
                    }
                },
                "17": {
                    "name": "B2",
                    "number": "17",
                    "net": "ISO_AUX0",
                    "props": {
                        "Pin Number": "17"
                    }
                },
                "18": {
                    "name": "B1",
                    "number": "18",
                    "net": "ISO_CLK",
                    "props": {
                        "Pin Number": "18"
                    }
                },
                "19": {
                    "name": "~OE~",
                    "number": "19",
                    "net": "BUS_OE_N",
                    "props": {
                        "Pin Number": "19"
                    }
                },
                "20": {
                    "name": "VCC",
                    "number": "20",
                    "net": "+3V3",
                    "props": {
                        "Pin Number": "20"
                    }
                }
            }
        },
        "97d7532320e593d5": {
            "props": {
                "Add into BOM": "yes",
                "Convert to PCB": "yes",
                "Name": "Device_C",
                "Device": "ce3f9b769b7a157b",
                "Designator": "C20",
                "Footprint": "6f3d185220f7d357",
                "Value": "100n",
                "UserDocLink": "",
                "Description": "",
                "ki_keywords": "",
                "ki_fp_filters": "",
                "Symbol": "e542132018ff745e",
                "LCSC": "C14663",
                "Origin Footprint": "Capacitor_SMD:C_0603_1608Metric",
                "Unique ID": "97d7532320e593d5",
                "Manufacturer": "",
                "Manufacturer Part": "",
                "Supplier": "LCSC",
                "Supplier Part": "C14663",
                "Comment": "",
                "Group ID": "",
                "Channel ID": "$2ie1089",
                "Reuse Block": "",
                "DeviceName": "Device_C",
                "FootprintName": "C_0603_1608Metric"
            },
            "pinInfoMap": {
                "1": {
                    "name": "",
                    "number": "1",
                    "net": "+3V3",
                    "props": {
                        "Pin Number": "1"
                    }
                },
                "2": {
                    "name": "",
                    "number": "2",
                    "net": "GND",
                    "props": {
                        "Pin Number": "2"
                    }
                }
            }
        },
        "484e3008dca2bfa8": {
            "props": {
                "Add into BOM": "yes",
                "Convert to PCB": "yes",
                "Name": "carrier_SN74CB3Q3245",
                "Device": "e3ac1cf8f4001451",
                "Designator": "U8",
                "Value": "SN74CB3Q3245PWR",
                "UserDocLink": "",
                "Description": "",
                "ki_keywords": "",
                "ki_fp_filters": "",
                "Origin Footprint": "Package_SO:TSSOP-20_4.4x6.5mm_P0.65mm",
                "Symbol": "d4a9fdb35c70c187",
                "LCSC": "C470961",
                "Comment": "Ioff protected 8-bit passive bus switch; OE pulled high by default",
                "Unique ID": "484e3008dca2bfa8",
                "Manufacturer": "",
                "Manufacturer Part": "",
                "Supplier": "LCSC",
                "Supplier Part": "C470961",
                "Footprint": "02a93bd6fb50955c",
                "Group ID": "",
                "Channel ID": "$2ie1099",
                "Reuse Block": "",
                "DeviceName": "carrier_SN74CB3Q3245",
                "FootprintName": "TSSOP-20_4.4x6.5mm_P0.65mm"
            },
            "pinInfoMap": {
                "1": {
                    "name": "NC",
                    "number": "1",
                    "net": "",
                    "props": {
                        "Pin Number": "1"
                    }
                },
                "2": {
                    "name": "A1",
                    "number": "2",
                    "net": "M_AUX3",
                    "props": {
                        "Pin Number": "2"
                    }
                },
                "3": {
                    "name": "A2",
                    "number": "3",
                    "net": "M_D4",
                    "props": {
                        "Pin Number": "3"
                    }
                },
                "4": {
                    "name": "A3",
                    "number": "4",
                    "net": "M_D3",
                    "props": {
                        "Pin Number": "4"
                    }
                },
                "5": {
                    "name": "A4",
                    "number": "5",
                    "net": "M_D6",
                    "props": {
                        "Pin Number": "5"
                    }
                },
                "6": {
                    "name": "A5",
                    "number": "6",
                    "net": "M_D5",
                    "props": {
                        "Pin Number": "6"
                    }
                },
                "7": {
                    "name": "A6",
                    "number": "7",
                    "net": "M_D7",
                    "props": {
                        "Pin Number": "7"
                    }
                },
                "8": {
                    "name": "A7",
                    "number": "8",
                    "net": "M_DIR",
                    "props": {
                        "Pin Number": "8"
                    }
                },
                "9": {
                    "name": "A8",
                    "number": "9",
                    "net": "",
                    "props": {
                        "Pin Number": "9"
                    }
                },
                "10": {
                    "name": "GND",
                    "number": "10",
                    "net": "GND",
                    "props": {
                        "Pin Number": "10"
                    }
                },
                "11": {
                    "name": "B8",
                    "number": "11",
                    "net": "",
                    "props": {
                        "Pin Number": "11"
                    }
                },
                "12": {
                    "name": "B7",
                    "number": "12",
                    "net": "ISO_DIR",
                    "props": {
                        "Pin Number": "12"
                    }
                },
                "13": {
                    "name": "B6",
                    "number": "13",
                    "net": "ISO_D7",
                    "props": {
                        "Pin Number": "13"
                    }
                },
                "14": {
                    "name": "B5",
                    "number": "14",
                    "net": "ISO_D5",
                    "props": {
                        "Pin Number": "14"
                    }
                },
                "15": {
                    "name": "B4",
                    "number": "15",
                    "net": "ISO_D6",
                    "props": {
                        "Pin Number": "15"
                    }
                },
                "16": {
                    "name": "B3",
                    "number": "16",
                    "net": "ISO_D3",
                    "props": {
                        "Pin Number": "16"
                    }
                },
                "17": {
                    "name": "B2",
                    "number": "17",
                    "net": "ISO_D4",
                    "props": {
                        "Pin Number": "17"
                    }
                },
                "18": {
                    "name": "B1",
                    "number": "18",
                    "net": "ISO_AUX3",
                    "props": {
                        "Pin Number": "18"
                    }
                },
                "19": {
                    "name": "~OE~",
                    "number": "19",
                    "net": "BUS_OE_N",
                    "props": {
                        "Pin Number": "19"
                    }
                },
                "20": {
                    "name": "VCC",
                    "number": "20",
                    "net": "+3V3",
                    "props": {
                        "Pin Number": "20"
                    }
                }
            }
        },
        "0259cc883dd91c7a": {
            "props": {
                "Add into BOM": "yes",
                "Convert to PCB": "yes",
                "Name": "Device_C",
                "Device": "ce3f9b769b7a157b",
                "Designator": "C21",
                "Footprint": "6f3d185220f7d357",
                "Value": "100n",
                "UserDocLink": "",
                "Description": "",
                "ki_keywords": "",
                "ki_fp_filters": "",
                "Symbol": "e542132018ff745e",
                "LCSC": "C14663",
                "Origin Footprint": "Capacitor_SMD:C_0603_1608Metric",
                "Unique ID": "0259cc883dd91c7a",
                "Manufacturer": "",
                "Manufacturer Part": "",
                "Supplier": "LCSC",
                "Supplier Part": "C14663",
                "Comment": "",
                "Group ID": "",
                "Channel ID": "$2ie1110",
                "Reuse Block": "",
                "DeviceName": "Device_C",
                "FootprintName": "C_0603_1608Metric"
            },
            "pinInfoMap": {
                "1": {
                    "name": "",
                    "number": "1",
                    "net": "+3V3",
                    "props": {
                        "Pin Number": "1"
                    }
                },
                "2": {
                    "name": "",
                    "number": "2",
                    "net": "GND",
                    "props": {
                        "Pin Number": "2"
                    }
                }
            }
        },
        "2dbbb3175ebf36d7": {
            "props": {
                "Add into BOM": "yes",
                "Convert to PCB": "yes",
                "Name": "Power_Supervisor_TPS3839DBZ",
                "Device": "7cbedc7226c6b4ab",
                "Designator": "U9",
                "Value": "TPS3839G33DBZR",
                "UserDocLink": "",
                "Description": "",
                "ki_keywords": "",
                "ki_fp_filters": "",
                "Origin Footprint": "Package_TO_SOT_SMD:SOT-23",
                "Symbol": "d96fb6d9bc567782",
                "LCSC": "C485802",
                "Comment": "3.08V / 4.38V supervisor, 200ms typical release delay",
                "Unique ID": "2dbbb3175ebf36d7",
                "Manufacturer": "",
                "Manufacturer Part": "",
                "Supplier": "LCSC",
                "Supplier Part": "C485802",
                "Footprint": "0053beec1f9b605e",
                "Group ID": "",
                "Channel ID": "$2ie1120",
                "Reuse Block": "",
                "DeviceName": "Power_Supervisor_TPS3839DBZ",
                "FootprintName": "SOT-23"
            },
            "pinInfoMap": {
                "1": {
                    "name": "GND",
                    "number": "1",
                    "net": "GND",
                    "props": {
                        "Pin Number": "1"
                    }
                },
                "2": {
                    "name": "~RESET~",
                    "number": "2",
                    "net": "TAB_PGOOD",
                    "props": {
                        "Pin Number": "2"
                    }
                },
                "3": {
                    "name": "VDD",
                    "number": "3",
                    "net": "TAB_3V3",
                    "props": {
                        "Pin Number": "3"
                    }
                }
            }
        },
        "7f35450ac3171d20": {
            "props": {
                "Add into BOM": "yes",
                "Convert to PCB": "yes",
                "Name": "Device_C",
                "Device": "ce3f9b769b7a157b",
                "Designator": "C22",
                "Footprint": "6f3d185220f7d357",
                "Value": "100n",
                "UserDocLink": "",
                "Description": "",
                "ki_keywords": "",
                "ki_fp_filters": "",
                "Symbol": "e542132018ff745e",
                "LCSC": "C14663",
                "Origin Footprint": "Capacitor_SMD:C_0603_1608Metric",
                "Unique ID": "7f35450ac3171d20",
                "Manufacturer": "",
                "Manufacturer Part": "",
                "Supplier": "LCSC",
                "Supplier Part": "C14663",
                "Comment": "",
                "Group ID": "",
                "Channel ID": "$2ie1131",
                "Reuse Block": "",
                "DeviceName": "Device_C",
                "FootprintName": "C_0603_1608Metric"
            },
            "pinInfoMap": {
                "1": {
                    "name": "",
                    "number": "1",
                    "net": "TAB_3V3",
                    "props": {
                        "Pin Number": "1"
                    }
                },
                "2": {
                    "name": "",
                    "number": "2",
                    "net": "GND",
                    "props": {
                        "Pin Number": "2"
                    }
                }
            }
        },
        "c69de7c088414df5": {
            "props": {
                "Add into BOM": "yes",
                "Convert to PCB": "yes",
                "Name": "Power_Supervisor_TPS3839DBZ",
                "Device": "7cbedc7226c6b4ab",
                "Designator": "U10",
                "Value": "TPS3839K50DBZR",
                "UserDocLink": "",
                "Description": "",
                "ki_keywords": "",
                "ki_fp_filters": "",
                "Origin Footprint": "Package_TO_SOT_SMD:SOT-23",
                "Symbol": "d96fb6d9bc567782",
                "LCSC": "C702204",
                "Comment": "3.08V / 4.38V supervisor, 200ms typical release delay",
                "Unique ID": "c69de7c088414df5",
                "Manufacturer": "",
                "Manufacturer Part": "",
                "Supplier": "LCSC",
                "Supplier Part": "C702204",
                "Footprint": "0053beec1f9b605e",
                "Group ID": "",
                "Channel ID": "$2ie1141",
                "Reuse Block": "",
                "DeviceName": "Power_Supervisor_TPS3839DBZ",
                "FootprintName": "SOT-23"
            },
            "pinInfoMap": {
                "1": {
                    "name": "GND",
                    "number": "1",
                    "net": "GND",
                    "props": {
                        "Pin Number": "1"
                    }
                },
                "2": {
                    "name": "~RESET~",
                    "number": "2",
                    "net": "CORE_PGOOD",
                    "props": {
                        "Pin Number": "2"
                    }
                },
                "3": {
                    "name": "VDD",
                    "number": "3",
                    "net": "+5V",
                    "props": {
                        "Pin Number": "3"
                    }
                }
            }
        },
        "8bc5c1e1749a19fa": {
            "props": {
                "Add into BOM": "yes",
                "Convert to PCB": "yes",
                "Name": "Device_C",
                "Device": "ce3f9b769b7a157b",
                "Designator": "C23",
                "Footprint": "6f3d185220f7d357",
                "Value": "100n",
                "UserDocLink": "",
                "Description": "",
                "ki_keywords": "",
                "ki_fp_filters": "",
                "Symbol": "e542132018ff745e",
                "LCSC": "C14663",
                "Origin Footprint": "Capacitor_SMD:C_0603_1608Metric",
                "Unique ID": "8bc5c1e1749a19fa",
                "Manufacturer": "",
                "Manufacturer Part": "",
                "Supplier": "LCSC",
                "Supplier Part": "C14663",
                "Comment": "",
                "Group ID": "",
                "Channel ID": "$2ie1152",
                "Reuse Block": "",
                "DeviceName": "Device_C",
                "FootprintName": "C_0603_1608Metric"
            },
            "pinInfoMap": {
                "1": {
                    "name": "",
                    "number": "1",
                    "net": "+5V",
                    "props": {
                        "Pin Number": "1"
                    }
                },
                "2": {
                    "name": "",
                    "number": "2",
                    "net": "GND",
                    "props": {
                        "Pin Number": "2"
                    }
                }
            }
        },
        "4fe8deccf3ecd12b": {
            "props": {
                "Add into BOM": "yes",
                "Convert to PCB": "yes",
                "Name": "Connector_Generic_Conn_01x02",
                "Device": "a4c5f2e12c5dd624",
                "Designator": "JP1",
                "Footprint": "70f4f5fcb23ea21a",
                "Value": "BUS ARM (open by default)",
                "UserDocLink": "",
                "Description": "",
                "ki_keywords": "",
                "ki_fp_filters": "",
                "Symbol": "5af65e52a68eae03",
                "Comment": "Fit shunt only after firmware GPIO ownership has been checked",
                "Origin Footprint": "Connector_PinHeader_2.54mm:PinHeader_1x02_P2.54mm_Vertical",
                "Unique ID": "4fe8deccf3ecd12b",
                "Manufacturer": "",
                "Manufacturer Part": "",
                "Supplier": "Akizuki",
                "Supplier Part": "1",
                "LCSC": "",
                "Group ID": "",
                "Channel ID": "$2ie1162",
                "Reuse Block": "",
                "DeviceName": "Connector_Generic_Conn_01x02",
                "FootprintName": "PinHeader_1x02_P2.54mm_Vertical"
            },
            "pinInfoMap": {
                "1": {
                    "name": "Pin_1",
                    "number": "1",
                    "net": "TAB_PGOOD",
                    "props": {
                        "Pin Number": "1"
                    }
                },
                "2": {
                    "name": "Pin_2",
                    "number": "2",
                    "net": "BUS_ARM",
                    "props": {
                        "Pin Number": "2"
                    }
                }
            }
        },
        "200f6e823ef85d95": {
            "props": {
                "Add into BOM": "yes",
                "Convert to PCB": "yes",
                "Name": "Transistor_FET_2N7002",
                "Device": "c5fa771d650c604c",
                "Designator": "Q3",
                "Value": "2N7002",
                "UserDocLink": "",
                "Description": "",
                "ki_keywords": "",
                "Origin Footprint": "Package_TO_SOT_SMD:SOT-23",
                "Symbol": "a27019e8d6d9a301",
                "LCSC": "C8545",
                "Unique ID": "200f6e823ef85d95",
                "Comment": "",
                "Manufacturer": "",
                "Manufacturer Part": "",
                "Supplier": "LCSC",
                "Supplier Part": "C8545",
                "Footprint": "0053beec1f9b605e",
                "Group ID": "",
                "Channel ID": "$2ie1172",
                "Reuse Block": "",
                "DeviceName": "Transistor_FET_2N7002",
                "FootprintName": "SOT-23"
            },
            "pinInfoMap": {
                "1": {
                    "name": "G",
                    "number": "1",
                    "net": "BUS_ARM",
                    "props": {
                        "Pin Number": "1"
                    }
                },
                "2": {
                    "name": "S",
                    "number": "2",
                    "net": "BUS_OE_MID",
                    "props": {
                        "Pin Number": "2"
                    }
                },
                "3": {
                    "name": "D",
                    "number": "3",
                    "net": "BUS_OE_N",
                    "props": {
                        "Pin Number": "3"
                    }
                }
            }
        },
        "2147c8f490bf262b": {
            "props": {
                "Add into BOM": "yes",
                "Convert to PCB": "yes",
                "Name": "Transistor_FET_2N7002",
                "Device": "c5fa771d650c604c",
                "Designator": "Q4",
                "Value": "2N7002",
                "UserDocLink": "",
                "Description": "",
                "ki_keywords": "",
                "Origin Footprint": "Package_TO_SOT_SMD:SOT-23",
                "Symbol": "a27019e8d6d9a301",
                "LCSC": "C8545",
                "Unique ID": "2147c8f490bf262b",
                "Comment": "",
                "Manufacturer": "",
                "Manufacturer Part": "",
                "Supplier": "LCSC",
                "Supplier Part": "C8545",
                "Footprint": "0053beec1f9b605e",
                "Group ID": "",
                "Channel ID": "$2ie1182",
                "Reuse Block": "",
                "DeviceName": "Transistor_FET_2N7002",
                "FootprintName": "SOT-23"
            },
            "pinInfoMap": {
                "1": {
                    "name": "G",
                    "number": "1",
                    "net": "CORE_PGOOD",
                    "props": {
                        "Pin Number": "1"
                    }
                },
                "2": {
                    "name": "S",
                    "number": "2",
                    "net": "GND",
                    "props": {
                        "Pin Number": "2"
                    }
                },
                "3": {
                    "name": "D",
                    "number": "3",
                    "net": "BUS_OE_MID",
                    "props": {
                        "Pin Number": "3"
                    }
                }
            }
        },
        "9e0eccf13a6f31a8": {
            "props": {
                "Add into BOM": "yes",
                "Convert to PCB": "yes",
                "Name": "Device_R",
                "Device": "dce15ae5d8c4adea",
                "Designator": "R46",
                "Footprint": "840d5114b71a38b1",
                "Value": "22k",
                "UserDocLink": "",
                "Description": "",
                "ki_keywords": "",
                "ki_fp_filters": "",
                "Symbol": "1a6aa3fb7f7fd24f",
                "LCSC": "C31850",
                "Origin Footprint": "Resistor_SMD:R_0603_1608Metric",
                "Unique ID": "9e0eccf13a6f31a8",
                "Manufacturer": "",
                "Manufacturer Part": "",
                "Supplier": "LCSC",
                "Supplier Part": "C31850",
                "Comment": "",
                "Group ID": "",
                "Channel ID": "$2ie1192",
                "Reuse Block": "",
                "DeviceName": "Device_R",
                "FootprintName": "R_0603_1608Metric"
            },
            "pinInfoMap": {
                "1": {
                    "name": "",
                    "number": "1",
                    "net": "+3V3",
                    "props": {
                        "Pin Number": "1"
                    }
                },
                "2": {
                    "name": "",
                    "number": "2",
                    "net": "BUS_OE_N",
                    "props": {
                        "Pin Number": "2"
                    }
                }
            }
        },
        "1887dacec97403d3": {
            "props": {
                "Add into BOM": "yes",
                "Convert to PCB": "yes",
                "Name": "Device_R",
                "Device": "dce15ae5d8c4adea",
                "Designator": "R47",
                "Footprint": "840d5114b71a38b1",
                "Value": "100k",
                "UserDocLink": "",
                "Description": "",
                "ki_keywords": "",
                "ki_fp_filters": "",
                "Symbol": "1a6aa3fb7f7fd24f",
                "LCSC": "C25803",
                "Origin Footprint": "Resistor_SMD:R_0603_1608Metric",
                "Unique ID": "1887dacec97403d3",
                "Manufacturer": "",
                "Manufacturer Part": "",
                "Supplier": "LCSC",
                "Supplier Part": "C25803",
                "Comment": "",
                "Group ID": "",
                "Channel ID": "$2ie1202",
                "Reuse Block": "",
                "DeviceName": "Device_R",
                "FootprintName": "R_0603_1608Metric"
            },
            "pinInfoMap": {
                "1": {
                    "name": "",
                    "number": "1",
                    "net": "BUS_ARM",
                    "props": {
                        "Pin Number": "1"
                    }
                },
                "2": {
                    "name": "",
                    "number": "2",
                    "net": "GND",
                    "props": {
                        "Pin Number": "2"
                    }
                }
            }
        },
        "e174b74f1d9ac547": {
            "props": {
                "Add into BOM": "yes",
                "Convert to PCB": "yes",
                "Name": "Device_R",
                "Device": "dce15ae5d8c4adea",
                "Designator": "R48",
                "Footprint": "840d5114b71a38b1",
                "Value": "100k",
                "UserDocLink": "",
                "Description": "",
                "ki_keywords": "",
                "ki_fp_filters": "",
                "Symbol": "1a6aa3fb7f7fd24f",
                "LCSC": "C25803",
                "Origin Footprint": "Resistor_SMD:R_0603_1608Metric",
                "Unique ID": "e174b74f1d9ac547",
                "Manufacturer": "",
                "Manufacturer Part": "",
                "Supplier": "LCSC",
                "Supplier Part": "C25803",
                "Comment": "",
                "Group ID": "",
                "Channel ID": "$2ie1212",
                "Reuse Block": "",
                "DeviceName": "Device_R",
                "FootprintName": "R_0603_1608Metric"
            },
            "pinInfoMap": {
                "1": {
                    "name": "",
                    "number": "1",
                    "net": "CORE_PGOOD",
                    "props": {
                        "Pin Number": "1"
                    }
                },
                "2": {
                    "name": "",
                    "number": "2",
                    "net": "GND",
                    "props": {
                        "Pin Number": "2"
                    }
                }
            }
        },
        "c2db9f210f8adeb4": {
            "props": {
                "Add into BOM": "yes",
                "Convert to PCB": "yes",
                "Name": "Transistor_BJT_MMBT3904",
                "Device": "940aa97c7a5dec6c",
                "Designator": "Q5",
                "Value": "MMBT3904",
                "UserDocLink": "",
                "Description": "",
                "Sim.Device": "",
                "Sim.Pins": "",
                "ki_keywords": "",
                "Origin Footprint": "Package_TO_SOT_SMD:SOT-23",
                "Symbol": "c5a57aa8147574f0",
                "LCSC": "C20526",
                "Comment": "Active-low HPD; input only, invert and debounce >=10ms; R52 limits off-bank charge injection, no hotplug guarantee",
                "Unique ID": "c2db9f210f8adeb4",
                "Manufacturer": "",
                "Manufacturer Part": "",
                "Supplier": "LCSC",
                "Supplier Part": "C20526",
                "Footprint": "0053beec1f9b605e",
                "Group ID": "",
                "Channel ID": "$2ie1222",
                "Reuse Block": "",
                "DeviceName": "Transistor_BJT_MMBT3904",
                "FootprintName": "SOT-23"
            },
            "pinInfoMap": {
                "1": {
                    "name": "B",
                    "number": "1",
                    "net": "HPD_B",
                    "props": {
                        "Pin Number": "1"
                    }
                },
                "2": {
                    "name": "E",
                    "number": "2",
                    "net": "GND",
                    "props": {
                        "Pin Number": "2"
                    }
                },
                "3": {
                    "name": "C",
                    "number": "3",
                    "net": "HPD_BUF",
                    "props": {
                        "Pin Number": "3"
                    }
                }
            }
        },
        "f8fa280bb9d4afdb": {
            "props": {
                "Add into BOM": "yes",
                "Convert to PCB": "yes",
                "Name": "Device_R",
                "Device": "dce15ae5d8c4adea",
                "Designator": "R51",
                "Footprint": "840d5114b71a38b1",
                "Value": "47k",
                "UserDocLink": "",
                "Description": "",
                "ki_keywords": "",
                "ki_fp_filters": "",
                "Symbol": "1a6aa3fb7f7fd24f",
                "LCSC": "C25819",
                "Comment": "Active-low HPD; input only, invert and debounce >=10ms; R52 limits off-bank charge injection, no hotplug guarantee",
                "Origin Footprint": "Resistor_SMD:R_0603_1608Metric",
                "Unique ID": "f8fa280bb9d4afdb",
                "Manufacturer": "",
                "Manufacturer Part": "",
                "Supplier": "LCSC",
                "Supplier Part": "C25819",
                "Group ID": "",
                "Channel ID": "$2ie1233",
                "Reuse Block": "",
                "DeviceName": "Device_R",
                "FootprintName": "R_0603_1608Metric"
            },
            "pinInfoMap": {
                "1": {
                    "name": "",
                    "number": "1",
                    "net": "+3V3",
                    "props": {
                        "Pin Number": "1"
                    }
                },
                "2": {
                    "name": "",
                    "number": "2",
                    "net": "HPD_BUF",
                    "props": {
                        "Pin Number": "2"
                    }
                }
            }
        },
        "780e728bcbe3c478": {
            "props": {
                "Add into BOM": "yes",
                "Convert to PCB": "yes",
                "Name": "Device_R",
                "Device": "dce15ae5d8c4adea",
                "Designator": "R52",
                "Footprint": "840d5114b71a38b1",
                "Value": "10k",
                "UserDocLink": "",
                "Description": "",
                "ki_keywords": "",
                "ki_fp_filters": "",
                "Symbol": "1a6aa3fb7f7fd24f",
                "LCSC": "C25804",
                "Comment": "Active-low HPD; input only, invert and debounce >=10ms; R52 limits off-bank charge injection, no hotplug guarantee",
                "Origin Footprint": "Resistor_SMD:R_0603_1608Metric",
                "Unique ID": "780e728bcbe3c478",
                "Manufacturer": "",
                "Manufacturer Part": "",
                "Supplier": "LCSC",
                "Supplier Part": "C25804",
                "Group ID": "",
                "Channel ID": "$2ie1244",
                "Reuse Block": "",
                "DeviceName": "Device_R",
                "FootprintName": "R_0603_1608Metric"
            },
            "pinInfoMap": {
                "1": {
                    "name": "",
                    "number": "1",
                    "net": "HPD_BUF",
                    "props": {
                        "Pin Number": "1"
                    }
                },
                "2": {
                    "name": "",
                    "number": "2",
                    "net": "F_HPD",
                    "props": {
                        "Pin Number": "2"
                    }
                }
            }
        },
        "7c674fedd66d7165": {
            "props": {
                "Add into BOM": "yes",
                "Convert to PCB": "yes",
                "Name": "Device_C",
                "Device": "ce3f9b769b7a157b",
                "Designator": "C24",
                "Footprint": "6f3d185220f7d357",
                "Value": "100n",
                "UserDocLink": "",
                "Description": "",
                "ki_keywords": "",
                "ki_fp_filters": "",
                "Symbol": "e542132018ff745e",
                "LCSC": "C14663",
                "Comment": "Active-low HPD; input only, invert and debounce >=10ms; R52 limits off-bank charge injection, no hotplug guarantee",
                "Origin Footprint": "Capacitor_SMD:C_0603_1608Metric",
                "Unique ID": "7c674fedd66d7165",
                "Manufacturer": "",
                "Manufacturer Part": "",
                "Supplier": "LCSC",
                "Supplier Part": "C14663",
                "Group ID": "",
                "Channel ID": "$2ie1255",
                "Reuse Block": "",
                "DeviceName": "Device_C",
                "FootprintName": "C_0603_1608Metric"
            },
            "pinInfoMap": {
                "1": {
                    "name": "",
                    "number": "1",
                    "net": "HPD_BUF",
                    "props": {
                        "Pin Number": "1"
                    }
                },
                "2": {
                    "name": "",
                    "number": "2",
                    "net": "GND",
                    "props": {
                        "Pin Number": "2"
                    }
                }
            }
        }
    },
    "designRule": {
        "trackPhysics": {
            "copperThickness1oz": {
                "name": "copperThickness1oz",
                "isDefault": true,
                "unit": "mm",
                "strokeValue": {
                    "common": {
                        "min": 0.127,
                        "max": 2.54,
                        "default": 0.254
                    }
                }
            },
            "copperThickness2oz": {
                "name": "copperThickness2oz",
                "isDefault": false,
                "unit": "mm",
                "strokeValue": {
                    "common": {
                        "min": 0.203,
                        "max": 2.54,
                        "default": 0.254
                    }
                }
            }
        },
        "netRule": {
            "DC_RAW": {
                "net": "DC_RAW",
                "ruleMap": {
                    "TrackPhysics": ""
                }
            },
            "GND": {
                "net": "GND",
                "ruleMap": {
                    "TrackPhysics": ""
                }
            },
            "DC_IN": {
                "net": "DC_IN",
                "ruleMap": {
                    "TrackPhysics": ""
                }
            },
            "VIN": {
                "net": "VIN",
                "ruleMap": {
                    "TrackPhysics": ""
                }
            },
            "VBUS_PD": {
                "net": "VBUS_PD",
                "ruleMap": {
                    "TrackPhysics": ""
                }
            },
            "CC1": {
                "net": "CC1",
                "ruleMap": {
                    "TrackPhysics": ""
                }
            },
            "CC2": {
                "net": "CC2",
                "ruleMap": {
                    "TrackPhysics": ""
                }
            },
            "PD_VDD": {
                "net": "PD_VDD",
                "ruleMap": {
                    "TrackPhysics": ""
                }
            },
            "PD_CFG2": {
                "net": "PD_CFG2",
                "ruleMap": {
                    "TrackPhysics": ""
                }
            },
            "PD_CFG3": {
                "net": "PD_CFG3",
                "ruleMap": {
                    "TrackPhysics": ""
                }
            },
            "PD_VBUS_S": {
                "net": "PD_VBUS_S",
                "ruleMap": {
                    "TrackPhysics": ""
                }
            },
            "PD_CFG1": {
                "net": "PD_CFG1",
                "ruleMap": {
                    "TrackPhysics": ""
                }
            },
            "PD_PG": {
                "net": "PD_PG",
                "ruleMap": {
                    "TrackPhysics": ""
                }
            },
            "BUCK_BOOT": {
                "net": "BUCK_BOOT",
                "ruleMap": {
                    "TrackPhysics": ""
                }
            },
            "BUCK_FB": {
                "net": "BUCK_FB",
                "ruleMap": {
                    "TrackPhysics": ""
                }
            },
            "BUCK_EN": {
                "net": "BUCK_EN",
                "ruleMap": {
                    "TrackPhysics": ""
                }
            },
            "BUCK_PH": {
                "net": "BUCK_PH",
                "ruleMap": {
                    "TrackPhysics": ""
                }
            },
            "+5V": {
                "net": "+5V",
                "ruleMap": {
                    "TrackPhysics": ""
                }
            },
            "+3V3": {
                "net": "+3V3",
                "ruleMap": {
                    "TrackPhysics": ""
                }
            },
            "M_CLK": {
                "net": "M_CLK",
                "ruleMap": {
                    "TrackPhysics": ""
                }
            },
            "M_AUX0": {
                "net": "M_AUX0",
                "ruleMap": {
                    "TrackPhysics": ""
                }
            },
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
                "net": "HDMI_5V",
                "ruleMap": {
                    "TrackPhysics": ""
                }
            },
            "HDMI_HPD": {
                "net": "HDMI_HPD",
                "ruleMap": {
                    "TrackPhysics": ""
                }
            },
            "HPD_B": {
                "net": "HPD_B",
                "ruleMap": {
                    "TrackPhysics": ""
                }
            },
            "LED0_A": {
                "net": "LED0_A",
                "ruleMap": {
                    "TrackPhysics": ""
                }
            },
            "LED1_A": {
                "net": "LED1_A",
                "ruleMap": {
                    "TrackPhysics": ""
                }
            },
            "LED2_A": {
                "net": "LED2_A",
                "ruleMap": {
                    "TrackPhysics": ""
                }
            },
            "LED3_A": {
                "net": "LED3_A",
                "ruleMap": {
                    "TrackPhysics": ""
                }
            },
            "BUS_OE_N": {
                "net": "BUS_OE_N",
                "ruleMap": {
                    "TrackPhysics": ""
                }
            },
            "TAB_PGOOD": {
                "net": "TAB_PGOOD",
                "ruleMap": {
                    "TrackPhysics": ""
                }
            },
            "CORE_PGOOD": {
                "net": "CORE_PGOOD",
                "ruleMap": {
                    "TrackPhysics": ""
                }
            },
            "BUS_ARM": {
                "net": "BUS_ARM",
                "ruleMap": {
                    "TrackPhysics": ""
                }
            },
            "BUS_OE_MID": {
                "net": "BUS_OE_MID",
                "ruleMap": {
                    "TrackPhysics": ""
                }
            },
            "HPD_BUF": {
                "net": "HPD_BUF",
                "ruleMap": {
                    "TrackPhysics": ""
                }
            }
        }
    },
    "differentialPair": {},
    "netClass": {},
    "equalLengthNetGroup": {}
}
