airpocket-soundman/tab5-tang-primer20k-carrier/spark/lcsc-lite-a/design/easyeda/schematic-netlist.txt

{
    "version": "2.0.0",
    "components": {
        "51bfc0e5166a1c40": {
            "props": {
                "Add into BOM": "yes",
                "Convert to PCB": "yes",
                "Name": "Connector_Barrel_Jack",
                "Device": "862f151d03c1fbf0",
                "Designator": "J1",
                "Footprint": "4ee42137ec565186",
                "Value": "DC-005-5A-2.0",
                "UserDocLink": "",
                "Description": "",
                "ki_keywords": "",
                "ki_fp_filters": "",
                "Symbol": "3c0563bbbba26127",
                "LCSC": "C381116",
                "Comment": "LCSC/JLC wave-solder candidate; stabilized12V center positive; XKB drawing A1; actual plug fit pending.",
                "Origin Footprint": "carrier:BarrelJack_XKB_C381116",
                "Unique ID": "51bfc0e5166a1c40",
                "Manufacturer": "",
                "Manufacturer Part": "",
                "Supplier": "LCSC",
                "Supplier Part": "C381116",
                "Group ID": "",
                "Channel ID": "$2ie37",
                "Reuse Block": "",
                "DeviceName": "Connector_Barrel_Jack",
                "FootprintName": ""
            },
            "pinInfoMap": {
                "1": {
                    "name": "",
                    "number": "1",
                    "net": "DC_RAW",
                    "props": {
                        "Pin Number": "1"
                    }
                },
                "2": {
                    "name": "",
                    "number": "2",
                    "net": "GND",
                    "props": {
                        "Pin Number": "2"
                    }
                }
            }
        },
        "09f31a4987c8a883": {
            "props": {
                "Add into BOM": "yes",
                "Convert to PCB": "yes",
                "Name": "Device_Polyfuse",
                "Device": "95a54720ae1b5189",
                "Designator": "F1",
                "Footprint": "c5c3dbc7f1f36107",
                "Value": "PTC 3A hold",
                "UserDocLink": "",
                "Description": "",
                "ki_keywords": "",
                "ki_fp_filters": "",
                "Symbol": "cf0d6468d29abfde",
                "LCSC": "C47002391",
                "Origin Footprint": "Fuse:Fuse_1812_4532Metric",
                "Unique ID": "09f31a4987c8a883",
                "Manufacturer": "",
                "Manufacturer Part": "",
                "Supplier": "LCSC",
                "Supplier Part": "C47002391",
                "Comment": "",
                "Group ID": "",
                "Channel ID": "$2ie48",
                "Reuse Block": "",
                "DeviceName": "Device_Polyfuse",
                "FootprintName": ""
            },
            "pinInfoMap": {
                "1": {
                    "name": "",
                    "number": "1",
                    "net": "DC_RAW",
                    "props": {
                        "Pin Number": "1"
                    }
                },
                "2": {
                    "name": "",
                    "number": "2",
                    "net": "DC_IN",
                    "props": {
                        "Pin Number": "2"
                    }
                }
            }
        },
        "6eb2f7ba7a12821c": {
            "props": {
                "Add into BOM": "yes",
                "Convert to PCB": "yes",
                "Name": "Device_D_Schottky",
                "Device": "dd92a8eb8c09e9ce",
                "Designator": "D1",
                "Footprint": "fbfc54e418ec90c6",
                "Value": "SS54",
                "UserDocLink": "",
                "Description": "",
                "ki_keywords": "",
                "ki_fp_filters": "",
                "Symbol": "a06d08477ba03a8f",
                "LCSC": "C22452",
                "Comment": "reverse-polarity + OR (DC jack)",
                "Origin Footprint": "Diode_SMD:D_SMA",
                "Unique ID": "6eb2f7ba7a12821c",
                "Manufacturer": "",
                "Manufacturer Part": "",
                "Supplier": "LCSC",
                "Supplier Part": "C22452",
                "Group ID": "",
                "Channel ID": "$2ie58",
                "Reuse Block": "",
                "DeviceName": "Device_D_Schottky",
                "FootprintName": ""
            },
            "pinInfoMap": {
                "1": {
                    "name": "K",
                    "number": "1",
                    "net": "VIN",
                    "props": {
                        "Pin Number": "1"
                    }
                },
                "2": {
                    "name": "A",
                    "number": "2",
                    "net": "DC_IN",
                    "props": {
                        "Pin Number": "2"
                    }
                }
            }
        },
        "cca08e5caf06c018": {
            "props": {
                "Add into BOM": "yes",
                "Convert to PCB": "yes",
                "Name": "Device_D_Schottky",
                "Device": "dd92a8eb8c09e9ce",
                "Designator": "D2",
                "Footprint": "fbfc54e418ec90c6",
                "Value": "SS54",
                "UserDocLink": "",
                "Description": "",
                "ki_keywords": "",
                "ki_fp_filters": "",
                "Symbol": "a06d08477ba03a8f",
                "LCSC": "C22452",
                "Comment": "OR (USB-C PD)",
                "Origin Footprint": "Diode_SMD:D_SMA",
                "Unique ID": "cca08e5caf06c018",
                "Manufacturer": "",
                "Manufacturer Part": "",
                "Supplier": "LCSC",
                "Supplier Part": "C22452",
                "Group ID": "",
                "Channel ID": "$2ie69",
                "Reuse Block": "",
                "DeviceName": "Device_D_Schottky",
                "FootprintName": ""
            },
            "pinInfoMap": {
                "1": {
                    "name": "K",
                    "number": "1",
                    "net": "VIN",
                    "props": {
                        "Pin Number": "1"
                    }
                },
                "2": {
                    "name": "A",
                    "number": "2",
                    "net": "VBUS_PD",
                    "props": {
                        "Pin Number": "2"
                    }
                }
            }
        },
        "81689f1d3303caec": {
            "props": {
                "Add into BOM": "yes",
                "Convert to PCB": "yes",
                "Name": "Device_D_TVS",
                "Device": "7a09f6d310541666",
                "Designator": "D3",
                "Footprint": "3c1de87666fa1f98",
                "Value": "SMBJ15A",
                "UserDocLink": "",
                "Description": "",
                "ki_keywords": "",
                "ki_fp_filters": "",
                "Symbol": "c9120501c068baa9",
                "LCSC": "C699013",
                "Comment": "YANGJIE 15V standoff, 24.4V specified clamp; regulated 12V PoC input only",
                "Origin Footprint": "Diode_SMD:D_SMB",
                "Unique ID": "81689f1d3303caec",
                "Manufacturer": "",
                "Manufacturer Part": "",
                "Supplier": "LCSC",
                "Supplier Part": "C699013",
                "Group ID": "",
                "Channel ID": "$2ie80",
                "Reuse Block": "",
                "DeviceName": "Device_D_TVS",
                "FootprintName": ""
            },
            "pinInfoMap": {
                "1": {
                    "name": "A1",
                    "number": "1",
                    "net": "VIN",
                    "props": {
                        "Pin Number": "1"
                    }
                },
                "2": {
                    "name": "A2",
                    "number": "2",
                    "net": "GND",
                    "props": {
                        "Pin Number": "2"
                    }
                }
            }
        },
        "b4693cfd16d534cd": {
            "props": {
                "Add into BOM": "yes",
                "Convert to PCB": "yes",
                "Name": "Device_C_Polarized",
                "Device": "f7400a66cc9c75be",
                "Designator": "C1",
                "Footprint": "bba72ce0ed319fc5",
                "Value": "100u/35V",
                "UserDocLink": "",
                "Description": "",
                "ki_keywords": "",
                "ki_fp_filters": "",
                "Symbol": "6a9cae473b642193",
                "LCSC": "C2983388",
                "Origin Footprint": "Capacitor_SMD:CP_Elec_6.3x7.7",
                "Unique ID": "b4693cfd16d534cd",
                "Manufacturer": "",
                "Manufacturer Part": "",
                "Supplier": "LCSC",
                "Supplier Part": "C2983388",
                "Comment": "",
                "Group ID": "",
                "Channel ID": "$2ie91",
                "Reuse Block": "",
                "DeviceName": "Device_C_Polarized",
                "FootprintName": ""
            },
            "pinInfoMap": {
                "1": {
                    "name": "",
                    "number": "1",
                    "net": "VIN",
                    "props": {
                        "Pin Number": "1"
                    }
                },
                "2": {
                    "name": "",
                    "number": "2",
                    "net": "GND",
                    "props": {
                        "Pin Number": "2"
                    }
                }
            }
        },
        "1fb9863844ab5169": {
            "props": {
                "Add into BOM": "yes",
                "Convert to PCB": "yes",
                "Name": "Connector_USB_C_Receptacle_PowerOnly_6P",
                "Device": "4c023161f7259f14",
                "Designator": "J2",
                "Footprint": "3df54365c32f8022",
                "Value": "USB-C PD in",
                "UserDocLink": "",
                "Description": "",
                "ki_keywords": "",
                "ki_fp_filters": "",
                "Symbol": "326ae8e8ffd38493",
                "LCSC": "C5246813",
                "Comment": "power-only USB-C 6P receptacle",
                "Origin Footprint": "Connector_USB:USB_C_Receptacle_GCT_USB4125-xx-x-0190_6P_TopMnt_Horizontal",
                "Unique ID": "1fb9863844ab5169",
                "Manufacturer": "",
                "Manufacturer Part": "",
                "Supplier": "LCSC",
                "Supplier Part": "C5246813",
                "Group ID": "",
                "Channel ID": "$2ie101",
                "Reuse Block": "",
                "DeviceName": "Connector_USB_C_Receptacle_PowerOnly_6P",
                "FootprintName": ""
            },
            "pinInfoMap": {
                "A5": {
                    "name": "CC1",
                    "number": "A5",
                    "net": "CC1",
                    "props": {
                        "Pin Number": "A5"
                    }
                },
                "A9": {
                    "name": "VBUS",
                    "number": "A9",
                    "net": "VBUS_PD",
                    "props": {
                        "Pin Number": "A9"
                    }
                },
                "A12": {
                    "name": "GND",
                    "number": "A12",
                    "net": "GND",
                    "props": {
                        "Pin Number": "A12"
                    }
                },
                "B5": {
                    "name": "CC2",
                    "number": "B5",
                    "net": "CC2",
                    "props": {
                        "Pin Number": "B5"
                    }
                },
                "B9": {
                    "name": "VBUS",
                    "number": "B9",
                    "net": "VBUS_PD",
                    "props": {
                        "Pin Number": "B9"
                    }
                },
                "B12": {
                    "name": "GND",
                    "number": "B12",
                    "net": "GND",
                    "props": {
                        "Pin Number": "B12"
                    }
                },
                "SH": {
                    "name": "SHIELD",
                    "number": "SH",
                    "net": "GND",
                    "props": {
                        "Pin Number": "SH"
                    }
                }
            }
        },
        "1bdc0ab44f99f92d": {
            "props": {
                "Add into BOM": "yes",
                "Convert to PCB": "yes",
                "Name": "Interface_USB_CH224K",
                "Device": "d56e8c5bc29d454f",
                "Designator": "U1",
                "Value": "CH224K",
                "UserDocLink": "",
                "Description": "",
                "ki_keywords": "",
                "ki_fp_filters": "",
                "Origin Footprint": "Package_SO:SSOP-10-1EP_3.9x4.9mm_P1mm_EP2.1x3.3mm",
                "Symbol": "f23b648fd187166e",
                "LCSC": "C970725",
                "Comment": "PD sink, 12V request: CFG1=0 CFG2=0 CFG3=1(internal PU)",
                "Unique ID": "1bdc0ab44f99f92d",
                "Manufacturer": "",
                "Manufacturer Part": "",
                "Supplier": "LCSC",
                "Supplier Part": "C970725",
                "Footprint": "7ccc08febcc03fef",
                "Group ID": "",
                "Channel ID": "$2ie112",
                "Reuse Block": "",
                "DeviceName": "Interface_USB_CH224K",
                "FootprintName": ""
            },
            "pinInfoMap": {
                "1": {
                    "name": "VDD",
                    "number": "1",
                    "net": "PD_VDD",
                    "props": {
                        "Pin Number": "1"
                    }
                },
                "2": {
                    "name": "CFG2",
                    "number": "2",
                    "net": "PD_CFG2",
                    "props": {
                        "Pin Number": "2"
                    }
                },
                "3": {
                    "name": "CFG3",
                    "number": "3",
                    "net": "PD_CFG3",
                    "props": {
                        "Pin Number": "3"
                    }
                },
                "4": {
                    "name": "DP",
                    "number": "4",
                    "net": "",
                    "props": {
                        "Pin Number": "4"
                    }
                },
                "5": {
                    "name": "DM",
                    "number": "5",
                    "net": "",
                    "props": {
                        "Pin Number": "5"
                    }
                },
                "6": {
                    "name": "CC2",
                    "number": "6",
                    "net": "CC2",
                    "props": {
                        "Pin Number": "6"
                    }
                },
                "7": {
                    "name": "CC1",
                    "number": "7",
                    "net": "CC1",
                    "props": {
                        "Pin Number": "7"
                    }
                },
                "8": {
                    "name": "VBUS",
                    "number": "8",
                    "net": "PD_VBUS_S",
                    "props": {
                        "Pin Number": "8"
                    }
                },
                "9": {
                    "name": "CFG1",
                    "number": "9",
                    "net": "PD_CFG1",
                    "props": {
                        "Pin Number": "9"
                    }
                },
                "10": {
                    "name": "PG",
                    "number": "10",
                    "net": "PD_PG",
                    "props": {
                        "Pin Number": "10"
                    }
                },
                "11": {
                    "name": "GND",
                    "number": "11",
                    "net": "GND",
                    "props": {
                        "Pin Number": "11"
                    }
                }
            }
        },
        "353b166cc2dee846": {
            "props": {
                "Add into BOM": "yes",
                "Convert to PCB": "yes",
                "Name": "Device_R",
                "Device": "a97793246ea6c736",
                "Designator": "R1",
                "Footprint": "0053beec1f9b605e",
                "Value": "10k",
                "UserDocLink": "",
                "Description": "",
                "ki_keywords": "",
                "ki_fp_filters": "",
                "Symbol": "39525148de9e2e86",
                "LCSC": "C25804",
                "Origin Footprint": "Resistor_SMD:R_0603_1608Metric",
                "Unique ID": "353b166cc2dee846",
                "Manufacturer": "",
                "Manufacturer Part": "",
                "Supplier": "LCSC",
                "Supplier Part": "C25804",
                "Comment": "",
                "Group ID": "",
                "Channel ID": "$2ie123",
                "Reuse Block": "",
                "DeviceName": "Device_R",
                "FootprintName": ""
            },
            "pinInfoMap": {
                "1": {
                    "name": "",
                    "number": "1",
                    "net": "VBUS_PD",
                    "props": {
                        "Pin Number": "1"
                    }
                },
                "2": {
                    "name": "",
                    "number": "2",
                    "net": "PD_VDD",
                    "props": {
                        "Pin Number": "2"
                    }
                }
            }
        },
        "a2c5d49bc5dde298": {
            "props": {
                "Add into BOM": "yes",
                "Convert to PCB": "yes",
                "Name": "Device_C",
                "Device": "473c964471ccd458",
                "Designator": "C2",
                "Footprint": "530feb5bd26552e7",
                "Value": "1u/50V",
                "UserDocLink": "",
                "Description": "",
                "ki_keywords": "",
                "ki_fp_filters": "",
                "Symbol": "ab503096c520ae9c",
                "LCSC": "C15849",
                "Origin Footprint": "Capacitor_SMD:C_0603_1608Metric",
                "Unique ID": "a2c5d49bc5dde298",
                "Manufacturer": "",
                "Manufacturer Part": "",
                "Supplier": "LCSC",
                "Supplier Part": "C15849",
                "Comment": "",
                "Group ID": "",
                "Channel ID": "$2ie133",
                "Reuse Block": "",
                "DeviceName": "Device_C",
                "FootprintName": ""
            },
            "pinInfoMap": {
                "1": {
                    "name": "",
                    "number": "1",
                    "net": "PD_VDD",
                    "props": {
                        "Pin Number": "1"
                    }
                },
                "2": {
                    "name": "",
                    "number": "2",
                    "net": "GND",
                    "props": {
                        "Pin Number": "2"
                    }
                }
            }
        },
        "6f63fc6711cfa315": {
            "props": {
                "Add into BOM": "yes",
                "Convert to PCB": "yes",
                "Name": "Device_R",
                "Device": "a97793246ea6c736",
                "Designator": "R2",
                "Footprint": "0053beec1f9b605e",
                "Value": "1k",
                "UserDocLink": "",
                "Description": "",
                "ki_keywords": "",
                "ki_fp_filters": "",
                "Symbol": "39525148de9e2e86",
                "LCSC": "C21190",
                "Origin Footprint": "Resistor_SMD:R_0603_1608Metric",
                "Unique ID": "6f63fc6711cfa315",
                "Manufacturer": "",
                "Manufacturer Part": "",
                "Supplier": "LCSC",
                "Supplier Part": "C21190",
                "Comment": "",
                "Group ID": "",
                "Channel ID": "$2ie143",
                "Reuse Block": "",
                "DeviceName": "Device_R",
                "FootprintName": ""
            },
            "pinInfoMap": {
                "1": {
                    "name": "",
                    "number": "1",
                    "net": "VBUS_PD",
                    "props": {
                        "Pin Number": "1"
                    }
                },
                "2": {
                    "name": "",
                    "number": "2",
                    "net": "PD_VBUS_S",
                    "props": {
                        "Pin Number": "2"
                    }
                }
            }
        },
        "fe89d0632cfce75f": {
            "props": {
                "Add into BOM": "yes",
                "Convert to PCB": "yes",
                "Name": "Device_R",
                "Device": "a97793246ea6c736",
                "Designator": "R3",
                "Footprint": "0053beec1f9b605e",
                "Value": "0R",
                "UserDocLink": "",
                "Description": "",
                "ki_keywords": "",
                "ki_fp_filters": "",
                "Symbol": "39525148de9e2e86",
                "LCSC": "C21189",
                "Comment": "CFG1 low (fit)",
                "Origin Footprint": "Resistor_SMD:R_0603_1608Metric",
                "Unique ID": "fe89d0632cfce75f",
                "Manufacturer": "",
                "Manufacturer Part": "",
                "Supplier": "LCSC",
                "Supplier Part": "C21189",
                "Group ID": "",
                "Channel ID": "$2ie153",
                "Reuse Block": "",
                "DeviceName": "Device_R",
                "FootprintName": ""
            },
            "pinInfoMap": {
                "1": {
                    "name": "",
                    "number": "1",
                    "net": "PD_CFG1",
                    "props": {
                        "Pin Number": "1"
                    }
                },
                "2": {
                    "name": "",
                    "number": "2",
                    "net": "GND",
                    "props": {
                        "Pin Number": "2"
                    }
                }
            }
        },
        "fdc86a4b576d9e98": {
            "props": {
                "Add into BOM": "no",
                "Convert to PCB": "yes",
                "Name": "Device_R",
                "Device": "a97793246ea6c736",
                "Designator": "R4",
                "Footprint": "840d5114b71a38b1",
                "Value": "0R",
                "UserDocLink": "",
                "Description": "",
                "ki_keywords": "",
                "ki_fp_filters": "",
                "Symbol": "39525148de9e2e86",
                "LCSC": "C21189",
                "Comment": "Must remain DNP: CFG3 internal pull-up for 12V request",
                "Origin Footprint": "Resistor_SMD:R_0603_1608Metric",
                "Unique ID": "fdc86a4b576d9e98",
                "Manufacturer": "",
                "Manufacturer Part": "",
                "Supplier": "LCSC",
                "Supplier Part": "C21189",
                "Group ID": "",
                "Channel ID": "$2ie164",
                "Reuse Block": "",
                "DeviceName": "Device_R",
                "FootprintName": ""
            },
            "pinInfoMap": {
                "1": {
                    "name": "",
                    "number": "1",
                    "net": "PD_CFG3",
                    "props": {
                        "Pin Number": "1"
                    }
                },
                "2": {
                    "name": "",
                    "number": "2",
                    "net": "GND",
                    "props": {
                        "Pin Number": "2"
                    }
                }
            }
        },
        "9cdd622c9eeecfe7": {
            "props": {
                "Add into BOM": "yes",
                "Convert to PCB": "yes",
                "Name": "Device_R",
                "Device": "a97793246ea6c736",
                "Designator": "R5",
                "Footprint": "0053beec1f9b605e",
                "Value": "0R",
                "UserDocLink": "",
                "Description": "",
                "ki_keywords": "",
                "ki_fp_filters": "",
                "Symbol": "39525148de9e2e86",
                "LCSC": "C21189",
                "Comment": "Fitted: CFG2 low, CFG1 low, CFG3 high -> 12V",
                "Origin Footprint": "Resistor_SMD:R_0603_1608Metric",
                "Unique ID": "9cdd622c9eeecfe7",
                "Manufacturer": "",
                "Manufacturer Part": "",
                "Supplier": "LCSC",
                "Supplier Part": "C21189",
                "Group ID": "",
                "Channel ID": "$2ie175",
                "Reuse Block": "",
                "DeviceName": "Device_R",
                "FootprintName": ""
            },
            "pinInfoMap": {
                "1": {
                    "name": "",
                    "number": "1",
                    "net": "PD_CFG2",
                    "props": {
                        "Pin Number": "1"
                    }
                },
                "2": {
                    "name": "",
                    "number": "2",
                    "net": "GND",
                    "props": {
                        "Pin Number": "2"
                    }
                }
            }
        },
        "48f0ae2437312dae": {
            "props": {
                "Add into BOM": "yes",
                "Convert to PCB": "yes",
                "Name": "Regulator_Switching_TPS5430DDA",
                "Device": "582a7af7c0977a5b",
                "Designator": "U2",
                "Value": "TPS5430DDAR",
                "UserDocLink": "",
                "Description": "",
                "ki_keywords": "",
                "ki_fp_filters": "",
                "Origin Footprint": "Package_SO:TI_SO-PowerPAD-8_ThermalVias",
                "Symbol": "92d412882a960e86",
                "LCSC": "C9864",
                "Unique ID": "48f0ae2437312dae",
                "Manufacturer": "",
                "Manufacturer Part": "",
                "Supplier": "LCSC",
                "Supplier Part": "C9864",
                "Footprint": "029edec69c75e6d9",
                "Comment": "",
                "Group ID": "",
                "Channel ID": "$2ie186",
                "Reuse Block": "",
                "DeviceName": "Regulator_Switching_TPS5430DDA",
                "FootprintName": ""
            },
            "pinInfoMap": {
                "1": {
                    "name": "BOOT",
                    "number": "1",
                    "net": "BUCK_BOOT",
                    "props": {
                        "Pin Number": "1"
                    }
                },
                "2": {
                    "name": "NC",
                    "number": "2",
                    "net": "",
                    "props": {
                        "Pin Number": "2"
                    }
                },
                "3": {
                    "name": "NC",
                    "number": "3",
                    "net": "",
                    "props": {
                        "Pin Number": "3"
                    }
                },
                "4": {
                    "name": "VSENSE",
                    "number": "4",
                    "net": "BUCK_FB",
                    "props": {
                        "Pin Number": "4"
                    }
                },
                "5": {
                    "name": "EN",
                    "number": "5",
                    "net": "BUCK_EN",
                    "props": {
                        "Pin Number": "5"
                    }
                },
                "6": {
                    "name": "GND",
                    "number": "6",
                    "net": "GND",
                    "props": {
                        "Pin Number": "6"
                    }
                },
                "7": {
                    "name": "VIN",
                    "number": "7",
                    "net": "VIN",
                    "props": {
                        "Pin Number": "7"
                    }
                },
                "8": {
                    "name": "PH",
                    "number": "8",
                    "net": "BUCK_PH",
                    "props": {
                        "Pin Number": "8"
                    }
                },
                "9": {
                    "name": "GNDPAD",
                    "number": "9",
                    "net": "GND",
                    "props": {
                        "Pin Number": "9"
                    }
                }
            }
        },
        "cc82bf2c2e22e605": {
            "props": {
                "Add into BOM": "yes",
                "Convert to PCB": "yes",
                "Name": "Device_C",
                "Device": "473c964471ccd458",
                "Designator": "C3",
                "Footprint": "530feb5bd26552e7",
                "Value": "10n",
                "UserDocLink": "",
                "Description": "",
                "ki_keywords": "",
                "ki_fp_filters": "",
                "Symbol": "ab503096c520ae9c",
                "LCSC": "C57112",
                "Origin Footprint": "Capacitor_SMD:C_0603_1608Metric",
                "Unique ID": "cc82bf2c2e22e605",
                "Manufacturer": "",
                "Manufacturer Part": "",
                "Supplier": "LCSC",
                "Supplier Part": "C57112",
                "Comment": "",
                "Group ID": "",
                "Channel ID": "$2ie196",
                "Reuse Block": "",
                "DeviceName": "Device_C",
                "FootprintName": ""
            },
            "pinInfoMap": {
                "1": {
                    "name": "",
                    "number": "1",
                    "net": "BUCK_BOOT",
                    "props": {
                        "Pin Number": "1"
                    }
                },
                "2": {
                    "name": "",
                    "number": "2",
                    "net": "BUCK_PH",
                    "props": {
                        "Pin Number": "2"
                    }
                }
            }
        },
        "d450ceac7adb81c3": {
            "props": {
                "Add into BOM": "yes",
                "Convert to PCB": "yes",
                "Name": "Device_L",
                "Device": "b40b9a74952bb32b",
                "Designator": "L1",
                "Footprint": "97ec37459fa64236",
                "Value": "15u MS1040-150M",
                "UserDocLink": "",
                "Description": "",
                "ki_keywords": "",
                "ki_fp_filters": "",
                "Symbol": "5173208219b29a92",
                "LCSC": "C380054",
                "Origin Footprint": "carrier:L_COILMX_MS1040",
                "Unique ID": "d450ceac7adb81c3",
                "Manufacturer": "",
                "Manufacturer Part": "",
                "Supplier": "LCSC",
                "Supplier Part": "C380054",
                "Comment": "",
                "Group ID": "",
                "Channel ID": "$2ie206",
                "Reuse Block": "",
                "DeviceName": "Device_L",
                "FootprintName": ""
            },
            "pinInfoMap": {
                "1": {
                    "name": "1",
                    "number": "1",
                    "net": "BUCK_PH",
                    "props": {
                        "Pin Number": "1"
                    }
                },
                "2": {
                    "name": "2",
                    "number": "2",
                    "net": "+5V",
                    "props": {
                        "Pin Number": "2"
                    }
                }
            }
        },
        "6a4368da87585c93": {
            "props": {
                "Add into BOM": "yes",
                "Convert to PCB": "yes",
                "Name": "Device_D_Schottky",
                "Device": "dd92a8eb8c09e9ce",
                "Designator": "D4",
                "Footprint": "fbfc54e418ec90c6",
                "Value": "SS54",
                "UserDocLink": "",
                "Description": "",
                "ki_keywords": "",
                "ki_fp_filters": "",
                "Symbol": "a06d08477ba03a8f",
                "LCSC": "C22452",
                "Comment": "catch diode",
                "Origin Footprint": "Diode_SMD:D_SMA",
                "Unique ID": "6a4368da87585c93",
                "Manufacturer": "",
                "Manufacturer Part": "",
                "Supplier": "LCSC",
                "Supplier Part": "C22452",
                "Group ID": "",
                "Channel ID": "$2ie216",
                "Reuse Block": "",
                "DeviceName": "Device_D_Schottky",
                "FootprintName": ""
            },
            "pinInfoMap": {
                "1": {
                    "name": "K",
                    "number": "1",
                    "net": "BUCK_PH",
                    "props": {
                        "Pin Number": "1"
                    }
                },
                "2": {
                    "name": "A",
                    "number": "2",
                    "net": "GND",
                    "props": {
                        "Pin Number": "2"
                    }
                }
            }
        },
        "e06ccd13940482ac": {
            "props": {
                "Add into BOM": "yes",
                "Convert to PCB": "yes",
                "Name": "Device_R",
                "Device": "a97793246ea6c736",
                "Designator": "R6",
                "Footprint": "0053beec1f9b605e",
                "Value": "10k",
                "UserDocLink": "",
                "Description": "",
                "ki_keywords": "",
                "ki_fp_filters": "",
                "Symbol": "39525148de9e2e86",
                "LCSC": "C25804",
                "Origin Footprint": "Resistor_SMD:R_0603_1608Metric",
                "Unique ID": "e06ccd13940482ac",
                "Manufacturer": "",
                "Manufacturer Part": "",
                "Supplier": "LCSC",
                "Supplier Part": "C25804",
                "Comment": "",
                "Group ID": "",
                "Channel ID": "$2ie227",
                "Reuse Block": "",
                "DeviceName": "Device_R",
                "FootprintName": ""
            },
            "pinInfoMap": {
                "1": {
                    "name": "",
                    "number": "1",
                    "net": "+5V",
                    "props": {
                        "Pin Number": "1"
                    }
                },
                "2": {
                    "name": "",
                    "number": "2",
                    "net": "BUCK_FB",
                    "props": {
                        "Pin Number": "2"
                    }
                }
            }
        },
        "ba2c6d155e7fd301": {
            "props": {
                "Add into BOM": "yes",
                "Convert to PCB": "yes",
                "Name": "Device_R",
                "Device": "a97793246ea6c736",
                "Designator": "R7",
                "Footprint": "840d5114b71a38b1",
                "Value": "3.3k",
                "UserDocLink": "",
                "Description": "",
                "ki_keywords": "",
                "ki_fp_filters": "",
                "Symbol": "39525148de9e2e86",
                "LCSC": "C22978",
                "Comment": "3.3k parallel (100k+100k): Req 3246.433 ohm, nominal buck 4.982V",
                "Origin Footprint": "Resistor_SMD:R_0603_1608Metric",
                "Unique ID": "ba2c6d155e7fd301",
                "Manufacturer": "",
                "Manufacturer Part": "",
                "Supplier": "LCSC",
                "Supplier Part": "C22978",
                "Group ID": "",
                "Channel ID": "$2ie237",
                "Reuse Block": "",
                "DeviceName": "Device_R",
                "FootprintName": ""
            },
            "pinInfoMap": {
                "1": {
                    "name": "",
                    "number": "1",
                    "net": "BUCK_FB",
                    "props": {
                        "Pin Number": "1"
                    }
                },
                "2": {
                    "name": "",
                    "number": "2",
                    "net": "GND",
                    "props": {
                        "Pin Number": "2"
                    }
                }
            }
        },
        "86d447fa2a9c8586": {
            "props": {
                "Add into BOM": "yes",
                "Convert to PCB": "yes",
                "Name": "Device_R",
                "Device": "a97793246ea6c736",
                "Designator": "R8",
                "Footprint": "0053beec1f9b605e",
                "Value": "100k",
                "UserDocLink": "",
                "Description": "",
                "ki_keywords": "",
                "ki_fp_filters": "",
                "Symbol": "39525148de9e2e86",
                "LCSC": "C25803",
                "Origin Footprint": "Resistor_SMD:R_0603_1608Metric",
                "Unique ID": "86d447fa2a9c8586",
                "Manufacturer": "",
                "Manufacturer Part": "",
                "Supplier": "LCSC",
                "Supplier Part": "C25803",
                "Comment": "",
                "Group ID": "",
                "Channel ID": "$2ie248",
                "Reuse Block": "",
                "DeviceName": "Device_R",
                "FootprintName": ""
            },
            "pinInfoMap": {
                "1": {
                    "name": "",
                    "number": "1",
                    "net": "VIN",
                    "props": {
                        "Pin Number": "1"
                    }
                },
                "2": {
                    "name": "",
                    "number": "2",
                    "net": "BUCK_EN",
                    "props": {
                        "Pin Number": "2"
                    }
                }
            }
        },
        "1e1ffada38203b9e": {
            "props": {
                "Add into BOM": "yes",
                "Convert to PCB": "yes",
                "Name": "Device_R",
                "Device": "a97793246ea6c736",
                "Designator": "R9",
                "Footprint": "0053beec1f9b605e",
                "Value": "15k",
                "UserDocLink": "",
                "Description": "",
                "ki_keywords": "",
                "ki_fp_filters": "",
                "Symbol": "39525148de9e2e86",
                "LCSC": "C22809",
                "Comment": "External EN divider ~9.4V threshold; stays off at default USB 5V/9V",
                "Origin Footprint": "Resistor_SMD:R_0603_1608Metric",
                "Unique ID": "1e1ffada38203b9e",
                "Manufacturer": "",
                "Manufacturer Part": "",
                "Supplier": "LCSC",
                "Supplier Part": "C22809",
                "Group ID": "",
                "Channel ID": "$2ie258",
                "Reuse Block": "",
                "DeviceName": "Device_R",
                "FootprintName": ""
            },
            "pinInfoMap": {
                "1": {
                    "name": "",
                    "number": "1",
                    "net": "BUCK_EN",
                    "props": {
                        "Pin Number": "1"
                    }
                },
                "2": {
                    "name": "",
                    "number": "2",
                    "net": "GND",
                    "props": {
                        "Pin Number": "2"
                    }
                }
            }
        },
        "3a68d3ddabf48558": {
            "props": {
                "Add into BOM": "yes",
                "Convert to PCB": "yes",
                "Name": "Device_C",
                "Device": "7ab8921c883b569b",
                "Designator": "C4",
                "Footprint": "02a93bd6fb50955c",
                "Value": "10u/50V",
                "UserDocLink": "",
                "Description": "",
                "ki_keywords": "",
                "ki_fp_filters": "",
                "Symbol": "ab503096c520ae9c",
                "LCSC": "C13585",
                "Origin Footprint": "Capacitor_SMD:C_1206_3216Metric",
                "Unique ID": "3a68d3ddabf48558",
                "Manufacturer": "",
                "Manufacturer Part": "",
                "Supplier": "LCSC",
                "Supplier Part": "C13585",
                "Comment": "",
                "Group ID": "",
                "Channel ID": "$2ie269",
                "Reuse Block": "",
                "DeviceName": "Device_C",
                "FootprintName": ""
            },
            "pinInfoMap": {
                "1": {
                    "name": "",
                    "number": "1",
                    "net": "VIN",
                    "props": {
                        "Pin Number": "1"
                    }
                },
                "2": {
                    "name": "",
                    "number": "2",
                    "net": "GND",
                    "props": {
                        "Pin Number": "2"
                    }
                }
            }
        },
        "ddba3c46cf8b8e66": {
            "props": {
                "Add into BOM": "yes",
                "Convert to PCB": "yes",
                "Name": "Device_C",
                "Device": "7ab8921c883b569b",
                "Designator": "C5",
                "Footprint": "ef635161a1783f83",
                "Value": "10u/50V",
                "UserDocLink": "",
                "Description": "",
                "ki_keywords": "",
                "ki_fp_filters": "",
                "Symbol": "ab503096c520ae9c",
                "LCSC": "C13585",
                "Origin Footprint": "Capacitor_SMD:C_1206_3216Metric",
                "Unique ID": "ddba3c46cf8b8e66",
                "Manufacturer": "",
                "Manufacturer Part": "",
                "Supplier": "LCSC",
                "Supplier Part": "C13585",
                "Comment": "",
                "Group ID": "",
                "Channel ID": "$2ie279",
                "Reuse Block": "",
                "DeviceName": "Device_C",
                "FootprintName": ""
            },
            "pinInfoMap": {
                "1": {
                    "name": "",
                    "number": "1",
                    "net": "VIN",
                    "props": {
                        "Pin Number": "1"
                    }
                },
                "2": {
                    "name": "",
                    "number": "2",
                    "net": "GND",
                    "props": {
                        "Pin Number": "2"
                    }
                }
            }
        },
        "ab4a8fe24fad9fe4": {
            "props": {
                "Add into BOM": "yes",
                "Convert to PCB": "yes",
                "Name": "Device_C",
                "Device": "473c964471ccd458",
                "Designator": "C6",
                "Footprint": "530feb5bd26552e7",
                "Value": "100n/50V",
                "UserDocLink": "",
                "Description": "",
                "ki_keywords": "",
                "ki_fp_filters": "",
                "Symbol": "ab503096c520ae9c",
                "LCSC": "C14663",
                "Origin Footprint": "Capacitor_SMD:C_0603_1608Metric",
                "Unique ID": "ab4a8fe24fad9fe4",
                "Manufacturer": "",
                "Manufacturer Part": "",
                "Supplier": "LCSC",
                "Supplier Part": "C14663",
                "Comment": "",
                "Group ID": "",
                "Channel ID": "$2ie289",
                "Reuse Block": "",
                "DeviceName": "Device_C",
                "FootprintName": ""
            },
            "pinInfoMap": {
                "1": {
                    "name": "",
                    "number": "1",
                    "net": "VIN",
                    "props": {
                        "Pin Number": "1"
                    }
                },
                "2": {
                    "name": "",
                    "number": "2",
                    "net": "GND",
                    "props": {
                        "Pin Number": "2"
                    }
                }
            }
        },
        "48d2dd422533522c": {
            "props": {
                "Add into BOM": "yes",
                "Convert to PCB": "yes",
                "Name": "Device_C_Polarized",
                "Device": "96c1146475a069e4",
                "Designator": "C7",
                "Footprint": "26088700070e789c",
                "Value": "220u/10V POSCAP",
                "UserDocLink": "",
                "Description": "",
                "ki_keywords": "",
                "ki_fp_filters": "",
                "Symbol": "6a9cae473b642193",
                "LCSC": "C242173",
                "Comment": "Panasonic 10TPB220M, 220uF 10V ESR max40mohm; TI reference output capacitor",
                "Origin Footprint": "Capacitor_Tantalum_SMD:CP_EIA-7343-40_Kemet-Y",
                "Unique ID": "48d2dd422533522c",
                "Manufacturer": "",
                "Manufacturer Part": "",
                "Supplier": "LCSC",
                "Supplier Part": "C242173",
                "Group ID": "",
                "Channel ID": "$2ie299",
                "Reuse Block": "",
                "DeviceName": "Device_C_Polarized",
                "FootprintName": ""
            },
            "pinInfoMap": {
                "1": {
                    "name": "",
                    "number": "1",
                    "net": "+5V",
                    "props": {
                        "Pin Number": "1"
                    }
                },
                "2": {
                    "name": "",
                    "number": "2",
                    "net": "GND",
                    "props": {
                        "Pin Number": "2"
                    }
                }
            }
        },
        "80f3708378e3d903": {
            "props": {
                "Add into BOM": "no",
                "Convert to PCB": "yes",
                "Name": "Device_C",
                "Device": "7ab8921c883b569b",
                "Designator": "C8",
                "Footprint": "02a93bd6fb50955c",
                "Value": "47u/10V",
                "UserDocLink": "",
                "Description": "",
                "ki_keywords": "",
                "ki_fp_filters": "",
                "Symbol": "ab503096c520ae9c",
                "LCSC": "C96123",
                "Origin Footprint": "Capacitor_SMD:C_1206_3216Metric",
                "Unique ID": "80f3708378e3d903",
                "Manufacturer": "",
                "Manufacturer Part": "",
                "Supplier": "LCSC",
                "Supplier Part": "C96123",
                "Comment": "",
                "Group ID": "",
                "Channel ID": "$2ie310",
                "Reuse Block": "",
                "DeviceName": "Device_C",
                "FootprintName": ""
            },
            "pinInfoMap": {
                "1": {
                    "name": "",
                    "number": "1",
                    "net": "+5V",
                    "props": {
                        "Pin Number": "1"
                    }
                },
                "2": {
                    "name": "",
                    "number": "2",
                    "net": "GND",
                    "props": {
                        "Pin Number": "2"
                    }
                }
            }
        },
        "7ddfd2f632a8b17d": {
            "props": {
                "Add into BOM": "no",
                "Convert to PCB": "yes",
                "Name": "Device_C",
                "Device": "7ab8921c883b569b",
                "Designator": "C9",
                "Footprint": "02a93bd6fb50955c",
                "Value": "47u/10V",
                "UserDocLink": "",
                "Description": "",
                "ki_keywords": "",
                "ki_fp_filters": "",
                "Symbol": "ab503096c520ae9c",
                "LCSC": "C96123",
                "Origin Footprint": "Capacitor_SMD:C_1206_3216Metric",
                "Unique ID": "7ddfd2f632a8b17d",
                "Manufacturer": "",
                "Manufacturer Part": "",
                "Supplier": "LCSC",
                "Supplier Part": "C96123",
                "Comment": "",
                "Group ID": "",
                "Channel ID": "$2ie320",
                "Reuse Block": "",
                "DeviceName": "Device_C",
                "FootprintName": ""
            },
            "pinInfoMap": {
                "1": {
                    "name": "",
                    "number": "1",
                    "net": "+5V",
                    "props": {
                        "Pin Number": "1"
                    }
                },
                "2": {
                    "name": "",
                    "number": "2",
                    "net": "GND",
                    "props": {
                        "Pin Number": "2"
                    }
                }
            }
        },
        "66797bcd97f4f6c2": {
            "props": {
                "Add into BOM": "yes",
                "Convert to PCB": "yes",
                "Name": "Regulator_Linear_XC6206PxxxMR",
                "Device": "5ed4305352aca178",
                "Designator": "U3",
                "Value": "XC6206P332MR-G",
                "UserDocLink": "",
                "Description": "",
                "ki_keywords": "",
                "ki_fp_filters": "",
                "Origin Footprint": "Package_TO_SOT_SMD:SOT-23",
                "Symbol": "be6f014fffe36af0",
                "LCSC": "C5446",
                "Comment": "3.3V local logic only; no external 3V3 loads; design limit 50mA",
                "Unique ID": "66797bcd97f4f6c2",
                "Manufacturer": "",
                "Manufacturer Part": "",
                "Supplier": "LCSC",
                "Supplier Part": "C5446",
                "Footprint": "b6a370204b09708a",
                "Group ID": "",
                "Channel ID": "$2ie330",
                "Reuse Block": "",
                "DeviceName": "Regulator_Linear_XC6206PxxxMR",
                "FootprintName": ""
            },
            "pinInfoMap": {
                "1": {
                    "name": "GND",
                    "number": "1",
                    "net": "GND",
                    "props": {
                        "Pin Number": "1"
                    }
                },
                "2": {
                    "name": "VO",
                    "number": "2",
                    "net": "+3V3",
                    "props": {
                        "Pin Number": "2"
                    }
                },
                "3": {
                    "name": "VI",
                    "number": "3",
                    "net": "+5V",
                    "props": {
                        "Pin Number": "3"
                    }
                }
            }
        },
        "3e75135af30e0f04": {
            "props": {
                "Add into BOM": "yes",
                "Convert to PCB": "yes",
                "Name": "Device_C",
                "Device": "7ab8921c883b569b",
                "Designator": "C10",
                "Footprint": "02a93bd6fb50955c",
                "Value": "10u/16V",
                "UserDocLink": "",
                "Description": "",
                "ki_keywords": "",
                "ki_fp_filters": "",
                "Symbol": "ab503096c520ae9c",
                "LCSC": "C13585",
                "Origin Footprint": "Capacitor_SMD:C_1206_3216Metric",
                "Unique ID": "3e75135af30e0f04",
                "Manufacturer": "",
                "Manufacturer Part": "",
                "Supplier": "LCSC",
                "Supplier Part": "C13585",
                "Comment": "",
                "Group ID": "",
                "Channel ID": "$2ie341",
                "Reuse Block": "",
                "DeviceName": "Device_C",
                "FootprintName": ""
            },
            "pinInfoMap": {
                "1": {
                    "name": "",
                    "number": "1",
                    "net": "+5V",
                    "props": {
                        "Pin Number": "1"
                    }
                },
                "2": {
                    "name": "",
                    "number": "2",
                    "net": "GND",
                    "props": {
                        "Pin Number": "2"
                    }
                }
            }
        },
        "20764de07767b3a1": {
            "props": {
                "Add into BOM": "yes",
                "Convert to PCB": "yes",
                "Name": "Device_C",
                "Device": "7ab8921c883b569b",
                "Designator": "C11",
                "Footprint": "02a93bd6fb50955c",
                "Value": "22u/10V",
                "UserDocLink": "",
                "Description": "",
                "ki_keywords": "",
                "ki_fp_filters": "",
                "Symbol": "ab503096c520ae9c",
                "LCSC": "C12891",
                "Origin Footprint": "Capacitor_SMD:C_1206_3216Metric",
                "Unique ID": "20764de07767b3a1",
                "Manufacturer": "",
                "Manufacturer Part": "",
                "Supplier": "LCSC",
                "Supplier Part": "C12891",
                "Comment": "",
                "Group ID": "",
                "Channel ID": "$2ie351",
                "Reuse Block": "",
                "DeviceName": "Device_C",
                "FootprintName": ""
            },
            "pinInfoMap": {
                "1": {
                    "name": "",
                    "number": "1",
                    "net": "+3V3",
                    "props": {
                        "Pin Number": "1"
                    }
                },
                "2": {
                    "name": "",
                    "number": "2",
                    "net": "GND",
                    "props": {
                        "Pin Number": "2"
                    }
                }
            }
        },
        "bd3ee0abdb58119f": {
            "props": {
                "Add into BOM": "yes",
                "Convert to PCB": "yes",
                "Name": "Connector_Generic_Conn_02x15_Odd_Even",
                "Device": "68c3218396bbe90d",
                "Designator": "J3",
                "Footprint": "e8c1ed82eae21c7c",
                "Value": "2.54-2*15P",
                "UserDocLink": "",
                "Description": "",
                "ki_keywords": "",
                "ki_fp_filters": "",
                "Symbol": "4b98b40c8e329859",
                "LCSC": "C56496",
                "Comment": "Bottom2x15 male; LCSC/JLC wave-solder candidate;6mm mating,3mm tails,2.54mm insulator. Preserve mirrored pinout; physical fit pending.",
                "Origin Footprint": "carrier:PinHeader_2x15_Tab5_Bottom",
                "Unique ID": "bd3ee0abdb58119f",
                "Manufacturer": "",
                "Manufacturer Part": "",
                "Supplier": "LCSC",
                "Supplier Part": "C56496",
                "Group ID": "",
                "Channel ID": "$2ie361",
                "Reuse Block": "",
                "DeviceName": "Connector_Generic_Conn_02x15_Odd_Even",
                "FootprintName": ""
            },
            "pinInfoMap": {
                "1": {
                    "name": "Pin_1",
                    "number": "1",
                    "net": "GND",
                    "props": {
                        "Pin Number": "1"
                    }
                },
                "2": {
                    "name": "Pin_2",
                    "number": "2",
                    "net": "M_CLK",
                    "props": {
                        "Pin Number": "2"
                    }
                },
                "3": {
                    "name": "Pin_3",
                    "number": "3",
                    "net": "GND",
                    "props": {
                        "Pin Number": "3"
                    }
                },
                "4": {
                    "name": "Pin_4",
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
                    "number": "21",
                    "net": "M_D5",
                    "props": {
                        "Pin Number": "21"
                    }
                },
                "22": {
                    "name": "Pin_22",
                    "number": "22",
                    "net": "M_D6",
                    "props": {
                        "Pin Number": "22"
                    }
                },
                "23": {
                    "name": "Pin_23",
                    "number": "23",
                    "net": "M_D7",
                    "props": {
                        "Pin Number": "23"
                    }
                },
                "24": {
                    "name": "Pin_24",
                    "number": "24",
                    "net": "M_EXT35",
                    "props": {
                        "Pin Number": "24"
                    }
                },
                "25": {
                    "name": "Pin_25",
                    "number": "25",
                    "net": "VIN",
                    "props": {
                        "Pin Number": "25"
                    }
                },
                "26": {
                    "name": "Pin_26",
                    "number": "26",
                    "net": "M_DIR",
                    "props": {
                        "Pin Number": "26"
                    }
                },
                "27": {
                    "name": "Pin_27",
                    "number": "27",
                    "net": "VIN",
                    "props": {
                        "Pin Number": "27"
                    }
                },
                "28": {
                    "name": "Pin_28",
                    "number": "28",
                    "net": "",
                    "props": {
                        "Pin Number": "28"
                    }
                },
                "29": {
                    "name": "Pin_29",
                    "number": "29",
                    "net": "VIN",
                    "props": {
                        "Pin Number": "29"
                    }
                },
                "30": {
                    "name": "Pin_30",
                    "number": "30",
                    "net": "",
                    "props": {
                        "Pin Number": "30"
                    }
                }
            }
        },
        "41bc0941336b1513": {
            "props": {
                "Add into BOM": "yes",
                "Convert to PCB": "yes",
                "Name": "Device_R",
                "Device": "a97793246ea6c736",
                "Designator": "R10",
                "Footprint": "0053beec1f9b605e",
                "Value": "680R",
                "UserDocLink": "",
                "Description": "",
                "ki_keywords": "",
                "ki_fp_filters": "",
                "Symbol": "39525148de9e2e86",
                "LCSC": "C23228",
                "Comment": "PoC 1MHz, 680ohm series damping; >=250ns DATA setup/hold, weak drive/SLOW; qualified distributed-RLC sensitivity",
                "Origin Footprint": "Resistor_SMD:R_0603_1608Metric",
                "Unique ID": "41bc0941336b1513",
                "Manufacturer": "",
                "Manufacturer Part": "",
                "Supplier": "LCSC",
                "Supplier Part": "C23228",
                "Group ID": "",
                "Channel ID": "$2ie372",
                "Reuse Block": "",
                "DeviceName": "Device_R",
                "FootprintName": ""
            },
            "pinInfoMap": {
                "1": {
                    "name": "",
                    "number": "1",
                    "net": "ISO_CLK",
                    "props": {
                        "Pin Number": "1"
                    }
                },
                "2": {
                    "name": "",
                    "number": "2",
                    "net": "F_CLK",
                    "props": {
                        "Pin Number": "2"
                    }
                }
            }
        },
        "763cf8d5648cb4fd": {
            "props": {
                "Add into BOM": "yes",
                "Convert to PCB": "yes",
                "Name": "Device_R",
                "Device": "a97793246ea6c736",
                "Designator": "R11",
                "Footprint": "f2382a3a65e883d1",
                "Value": "680R",
                "UserDocLink": "",
                "Description": "",
                "ki_keywords": "",
                "ki_fp_filters": "",
                "Symbol": "39525148de9e2e86",
                "LCSC": "C23228",
                "Comment": "PoC 1MHz, 680ohm series damping; >=250ns DATA setup/hold, weak drive/SLOW; qualified distributed-RLC sensitivity",
                "Origin Footprint": "Resistor_SMD:R_0603_1608Metric",
                "Unique ID": "763cf8d5648cb4fd",
                "Manufacturer": "",
                "Manufacturer Part": "",
                "Supplier": "LCSC",
                "Supplier Part": "C23228",
                "Group ID": "",
                "Channel ID": "$2ie383",
                "Reuse Block": "",
                "DeviceName": "Device_R",
                "FootprintName": ""
            },
            "pinInfoMap": {
                "1": {
                    "name": "",
                    "number": "1",
                    "net": "ISO_AUX0",
                    "props": {
                        "Pin Number": "1"
                    }
                },
                "2": {
                    "name": "",
                    "number": "2",
                    "net": "F_AUX0",
                    "props": {
                        "Pin Number": "2"
                    }
                }
            }
        },
        "15ac9218146e0f4b": {
            "props": {
                "Add into BOM": "yes",
                "Convert to PCB": "yes",
                "Name": "Device_R",
                "Device": "a97793246ea6c736",
                "Designator": "R12",
                "Footprint": "f2382a3a65e883d1",
                "Value": "680R",
                "UserDocLink": "",
                "Description": "",
                "ki_keywords": "",
                "ki_fp_filters": "",
                "Symbol": "39525148de9e2e86",
                "LCSC": "C23228",
                "Comment": "PoC 1MHz, 680ohm series damping; >=250ns DATA setup/hold, weak drive/SLOW; qualified distributed-RLC sensitivity",
                "Origin Footprint": "Resistor_SMD:R_0603_1608Metric",
                "Unique ID": "15ac9218146e0f4b",
                "Manufacturer": "",
                "Manufacturer Part": "",
                "Supplier": "LCSC",
                "Supplier Part": "C23228",
                "Group ID": "",
                "Channel ID": "$2ie394",
                "Reuse Block": "",
                "DeviceName": "Device_R",
                "FootprintName": ""
            },
            "pinInfoMap": {
                "1": {
                    "name": "",
                    "number": "1",
                    "net": "ISO_RDY",
                    "props": {
                        "Pin Number": "1"
                    }
                },
                "2": {
                    "name": "",
                    "number": "2",
                    "net": "F_RDY",
                    "props": {
                        "Pin Number": "2"
                    }
                }
            }
        },
        "ff4077a9ca69db92": {
            "props": {
                "Add into BOM": "yes",
                "Convert to PCB": "yes",
                "Name": "Device_R",
                "Device": "a97793246ea6c736",
                "Designator": "R13",
                "Footprint": "f2382a3a65e883d1",
                "Value": "680R",
                "UserDocLink": "",
                "Description": "",
                "ki_keywords": "",
                "ki_fp_filters": "",
                "Symbol": "39525148de9e2e86",
                "LCSC": "C23228",
                "Comment": "PoC 1MHz, 680ohm series damping; >=250ns DATA setup/hold, weak drive/SLOW; qualified distributed-RLC sensitivity",
                "Origin Footprint": "Resistor_SMD:R_0603_1608Metric",
                "Unique ID": "ff4077a9ca69db92",
                "Manufacturer": "",
                "Manufacturer Part": "",
                "Supplier": "LCSC",
                "Supplier Part": "C23228",
                "Group ID": "",
                "Channel ID": "$2ie405",
                "Reuse Block": "",
                "DeviceName": "Device_R",
                "FootprintName": ""
            },
            "pinInfoMap": {
                "1": {
                    "name": "",
                    "number": "1",
                    "net": "ISO_D0",
                    "props": {
                        "Pin Number": "1"
                    }
                },
                "2": {
                    "name": "",
                    "number": "2",
                    "net": "F_D0",
                    "props": {
                        "Pin Number": "2"
                    }
                }
            }
        },
        "8b54177fc4d64d35": {
            "props": {
                "Add into BOM": "yes",
                "Convert to PCB": "yes",
                "Name": "Device_R",
                "Device": "a97793246ea6c736",
                "Designator": "R14",
                "Footprint": "f2382a3a65e883d1",
                "Value": "680R",
                "UserDocLink": "",
                "Description": "",
                "ki_keywords": "",
                "ki_fp_filters": "",
                "Symbol": "39525148de9e2e86",
                "LCSC": "C23228",
                "Comment": "PoC 1MHz, 680ohm series damping; >=250ns DATA setup/hold, weak drive/SLOW; qualified distributed-RLC sensitivity",
                "Origin Footprint": "Resistor_SMD:R_0603_1608Metric",
                "Unique ID": "8b54177fc4d64d35",
                "Manufacturer": "",
                "Manufacturer Part": "",
                "Supplier": "LCSC",
                "Supplier Part": "C23228",
                "Group ID": "",
                "Channel ID": "$2ie416",
                "Reuse Block": "",
                "DeviceName": "Device_R",
                "FootprintName": ""
            },
            "pinInfoMap": {
                "1": {
                    "name": "",
                    "number": "1",
                    "net": "ISO_AUX1",
                    "props": {
                        "Pin Number": "1"
                    }
                },
                "2": {
                    "name": "",
                    "number": "2",
                    "net": "F_AUX1",
                    "props": {
                        "Pin Number": "2"
                    }
                }
            }
        },
        "feece054417b9159": {
            "props": {
                "Add into BOM": "yes",
                "Convert to PCB": "yes",
                "Name": "Device_R",
                "Device": "a97793246ea6c736",
                "Designator": "R15",
                "Footprint": "f2382a3a65e883d1",
                "Value": "680R",
                "UserDocLink": "",
                "Description": "",
                "ki_keywords": "",
                "ki_fp_filters": "",
                "Symbol": "39525148de9e2e86",
                "LCSC": "C23228",
                "Comment": "PoC 1MHz, 680ohm series damping; >=250ns DATA setup/hold, weak drive/SLOW; qualified distributed-RLC sensitivity",
                "Origin Footprint": "Resistor_SMD:R_0603_1608Metric",
                "Unique ID": "feece054417b9159",
                "Manufacturer": "",
                "Manufacturer Part": "",
                "Supplier": "LCSC",
                "Supplier Part": "C23228",
                "Group ID": "",
                "Channel ID": "$2ie427",
                "Reuse Block": "",
                "DeviceName": "Device_R",
                "FootprintName": ""
            },
            "pinInfoMap": {
                "1": {
                    "name": "",
                    "number": "1",
                    "net": "ISO_D1",
                    "props": {
                        "Pin Number": "1"
                    }
                },
                "2": {
                    "name": "",
                    "number": "2",
                    "net": "F_D1",
                    "props": {
                        "Pin Number": "2"
                    }
                }
            }
        },
        "3c543c7c58e1cc80": {
            "props": {
                "Add into BOM": "yes",
                "Convert to PCB": "yes",
                "Name": "Device_R",
                "Device": "a97793246ea6c736",
                "Designator": "R16",
                "Footprint": "f2382a3a65e883d1",
                "Value": "680R",
                "UserDocLink": "",
                "Description": "",
                "ki_keywords": "",
                "ki_fp_filters": "",
                "Symbol": "39525148de9e2e86",
                "LCSC": "C23228",
                "Comment": "PoC 1MHz, 680ohm series damping; >=250ns DATA setup/hold, weak drive/SLOW; qualified distributed-RLC sensitivity",
                "Origin Footprint": "Resistor_SMD:R_0603_1608Metric",
                "Unique ID": "3c543c7c58e1cc80",
                "Manufacturer": "",
                "Manufacturer Part": "",
                "Supplier": "LCSC",
                "Supplier Part": "C23228",
                "Group ID": "",
                "Channel ID": "$2ie438",
                "Reuse Block": "",
                "DeviceName": "Device_R",
                "FootprintName": ""
            },
            "pinInfoMap": {
                "1": {
                    "name": "",
                    "number": "1",
                    "net": "ISO_D2",
                    "props": {
                        "Pin Number": "1"
                    }
                },
                "2": {
                    "name": "",
                    "number": "2",
                    "net": "F_D2",
                    "props": {
                        "Pin Number": "2"
                    }
                }
            }
        },
        "6346d187b4e0bc9c": {
            "props": {
                "Add into BOM": "no",
                "Convert to PCB": "yes",
                "Name": "Device_R",
                "Device": "a97793246ea6c736",
                "Designator": "R17",
                "Footprint": "f2382a3a65e883d1",
                "Value": "0R",
                "UserDocLink": "",
                "Description": "",
                "ki_keywords": "",
                "ki_fp_filters": "",
                "Symbol": "39525148de9e2e86",
                "LCSC": "C21189",
                "Comment": "16-bit extension (DNP): connects G37 to FPGA",
                "Origin Footprint": "Resistor_SMD:R_0603_1608Metric",
                "Unique ID": "6346d187b4e0bc9c",
                "Manufacturer": "",
                "Manufacturer Part": "",
                "Supplier": "LCSC",
                "Supplier Part": "C21189",
                "Group ID": "",
                "Channel ID": "$2ie449",
                "Reuse Block": "",
                "DeviceName": "Device_R",
                "FootprintName": ""
            },
            "pinInfoMap": {
                "1": {
                    "name": "",
                    "number": "1",
                    "net": "M_EXT37",
                    "props": {
                        "Pin Number": "1"
                    }
                },
                "2": {
                    "name": "",
                    "number": "2",
                    "net": "F_EXT37",
                    "props": {
                        "Pin Number": "2"
                    }
                }
            }
        },
        "5f673669f0d56d8f": {
            "props": {
                "Add into BOM": "no",
                "Convert to PCB": "yes",
                "Name": "Device_R",
                "Device": "a97793246ea6c736",
                "Designator": "R18",
                "Footprint": "f2382a3a65e883d1",
                "Value": "0R",
                "UserDocLink": "",
                "Description": "",
                "ki_keywords": "",
                "ki_fp_filters": "",
                "Symbol": "39525148de9e2e86",
                "LCSC": "C21189",
                "Comment": "16-bit extension (DNP): connects G38 to FPGA",
                "Origin Footprint": "Resistor_SMD:R_0603_1608Metric",
                "Unique ID": "5f673669f0d56d8f",
                "Manufacturer": "",
                "Manufacturer Part": "",
                "Supplier": "LCSC",
                "Supplier Part": "C21189",
                "Group ID": "",
                "Channel ID": "$2ie460",
                "Reuse Block": "",
                "DeviceName": "Device_R",
                "FootprintName": ""
            },
            "pinInfoMap": {
                "1": {
                    "name": "",
                    "number": "1",
                    "net": "M_EXT38",
                    "props": {
                        "Pin Number": "1"
                    }
                },
                "2": {
                    "name": "",
                    "number": "2",
                    "net": "F_EXT38",
                    "props": {
                        "Pin Number": "2"
                    }
                }
            }
        },
        "a32210a39874d8f8": {
            "props": {
                "Add into BOM": "yes",
                "Convert to PCB": "yes",
                "Name": "Device_R",
                "Device": "a97793246ea6c736",
                "Designator": "R19",
                "Footprint": "f2382a3a65e883d1",
                "Value": "680R",
                "UserDocLink": "",
                "Description": "",
                "ki_keywords": "",
                "ki_fp_filters": "",
                "Symbol": "39525148de9e2e86",
                "LCSC": "C23228",
                "Comment": "PoC 1MHz, 680ohm series damping; >=250ns DATA setup/hold, weak drive/SLOW; qualified distributed-RLC sensitivity",
                "Origin Footprint": "Resistor_SMD:R_0603_1608Metric",
                "Unique ID": "a32210a39874d8f8",
                "Manufacturer": "",
                "Manufacturer Part": "",
                "Supplier": "LCSC",
                "Supplier Part": "C23228",
                "Group ID": "",
                "Channel ID": "$2ie471",
                "Reuse Block": "",
                "DeviceName": "Device_R",
                "FootprintName": ""
            },
            "pinInfoMap": {
                "1": {
                    "name": "",
                    "number": "1",
                    "net": "ISO_AUX2",
                    "props": {
                        "Pin Number": "1"
                    }
                },
                "2": {
                    "name": "",
                    "number": "2",
                    "net": "F_AUX2",
                    "props": {
                        "Pin Number": "2"
                    }
                }
            }
        },
        "13e77c54ede4b306": {
            "props": {
                "Add into BOM": "yes",
                "Convert to PCB": "yes",
                "Name": "Device_R",
                "Device": "a97793246ea6c736",
                "Designator": "R20",
                "Footprint": "f2382a3a65e883d1",
                "Value": "680R",
                "UserDocLink": "",
                "Description": "",
                "ki_keywords": "",
                "ki_fp_filters": "",
                "Symbol": "39525148de9e2e86",
                "LCSC": "C23228",
                "Comment": "PoC 1MHz, 680ohm series damping; >=250ns DATA setup/hold, weak drive/SLOW; qualified distributed-RLC sensitivity",
                "Origin Footprint": "Resistor_SMD:R_0603_1608Metric",
                "Unique ID": "13e77c54ede4b306",
                "Manufacturer": "",
                "Manufacturer Part": "",
                "Supplier": "LCSC",
                "Supplier Part": "C23228",
                "Group ID": "",
                "Channel ID": "$2ie482",
                "Reuse Block": "",
                "DeviceName": "Device_R",
                "FootprintName": ""
            },
            "pinInfoMap": {
                "1": {
                    "name": "",
                    "number": "1",
                    "net": "ISO_AUX3",
                    "props": {
                        "Pin Number": "1"
                    }
                },
                "2": {
                    "name": "",
                    "number": "2",
                    "net": "F_AUX3",
                    "props": {
                        "Pin Number": "2"
                    }
                }
            }
        },
        "c77b08197b178948": {
            "props": {
                "Add into BOM": "yes",
                "Convert to PCB": "yes",
                "Name": "Device_R",
                "Device": "a97793246ea6c736",
                "Designator": "R21",
                "Footprint": "f2382a3a65e883d1",
                "Value": "680R",
                "UserDocLink": "",
                "Description": "",
                "ki_keywords": "",
                "ki_fp_filters": "",
                "Symbol": "39525148de9e2e86",
                "LCSC": "C23228",
                "Comment": "PoC 1MHz, 680ohm series damping; >=250ns DATA setup/hold, weak drive/SLOW; qualified distributed-RLC sensitivity",
                "Origin Footprint": "Resistor_SMD:R_0603_1608Metric",
                "Unique ID": "c77b08197b178948",
                "Manufacturer": "",
                "Manufacturer Part": "",
                "Supplier": "LCSC",
                "Supplier Part": "C23228",
                "Group ID": "",
                "Channel ID": "$2ie493",
                "Reuse Block": "",
                "DeviceName": "Device_R",
                "FootprintName": ""
            },
            "pinInfoMap": {
                "1": {
                    "name": "",
                    "number": "1",
                    "net": "ISO_D4",
                    "props": {
                        "Pin Number": "1"
                    }
                },
                "2": {
                    "name": "",
                    "number": "2",
                    "net": "F_D4",
                    "props": {
                        "Pin Number": "2"
                    }
                }
            }
        },
        "fa394caafc8878d8": {
            "props": {
                "Add into BOM": "yes",
                "Convert to PCB": "yes",
                "Name": "Device_R",
                "Device": "a97793246ea6c736",
                "Designator": "R22",
                "Footprint": "f2382a3a65e883d1",
                "Value": "680R",
                "UserDocLink": "",
                "Description": "",
                "ki_keywords": "",
                "ki_fp_filters": "",
                "Symbol": "39525148de9e2e86",
                "LCSC": "C23228",
                "Comment": "PoC 1MHz, 680ohm series damping; >=250ns DATA setup/hold, weak drive/SLOW; qualified distributed-RLC sensitivity",
                "Origin Footprint": "Resistor_SMD:R_0603_1608Metric",
                "Unique ID": "fa394caafc8878d8",
                "Manufacturer": "",
                "Manufacturer Part": "",
                "Supplier": "LCSC",
                "Supplier Part": "C23228",
                "Group ID": "",
                "Channel ID": "$2ie504",
                "Reuse Block": "",
                "DeviceName": "Device_R",
                "FootprintName": ""
            },
            "pinInfoMap": {
                "1": {
                    "name": "",
                    "number": "1",
                    "net": "ISO_D3",
                    "props": {
                        "Pin Number": "1"
                    }
                },
                "2": {
                    "name": "",
                    "number": "2",
                    "net": "F_D3",
                    "props": {
                        "Pin Number": "2"
                    }
                }
            }
        },
        "d92c635076b33213": {
            "props": {
                "Add into BOM": "yes",
                "Convert to PCB": "yes",
                "Name": "Device_R",
                "Device": "a97793246ea6c736",
                "Designator": "R23",
                "Footprint": "f2382a3a65e883d1",
                "Value": "680R",
                "UserDocLink": "",
                "Description": "",
                "ki_keywords": "",
                "ki_fp_filters": "",
                "Symbol": "39525148de9e2e86",
                "LCSC": "C23228",
                "Comment": "PoC 1MHz, 680ohm series damping; >=250ns DATA setup/hold, weak drive/SLOW; qualified distributed-RLC sensitivity",
                "Origin Footprint": "Resistor_SMD:R_0603_1608Metric",
                "Unique ID": "d92c635076b33213",
                "Manufacturer": "",
                "Manufacturer Part": "",
                "Supplier": "LCSC",
                "Supplier Part": "C23228",
                "Group ID": "",
                "Channel ID": "$2ie515",
                "Reuse Block": "",
                "DeviceName": "Device_R",
                "FootprintName": ""
            },
            "pinInfoMap": {
                "1": {
                    "name": "",
                    "number": "1",
                    "net": "ISO_D6",
                    "props": {
                        "Pin Number": "1"
                    }
                },
                "2": {
                    "name": "",
                    "number": "2",
                    "net": "F_D6",
                    "props": {
                        "Pin Number": "2"
                    }
                }
            }
        },
        "f7952e9f9cd6773b": {
            "props": {
                "Add into BOM": "yes",
                "Convert to PCB": "yes",
                "Name": "Device_R",
                "Device": "a97793246ea6c736",
                "Designator": "R24",
                "Footprint": "f2382a3a65e883d1",
                "Value": "680R",
                "UserDocLink": "",
                "Description": "",
                "ki_keywords": "",
                "ki_fp_filters": "",
                "Symbol": "39525148de9e2e86",
                "LCSC": "C23228",
                "Comment": "PoC 1MHz, 680ohm series damping; >=250ns DATA setup/hold, weak drive/SLOW; qualified distributed-RLC sensitivity",
                "Origin Footprint": "Resistor_SMD:R_0603_1608Metric",
                "Unique ID": "f7952e9f9cd6773b",
                "Manufacturer": "",
                "Manufacturer Part": "",
                "Supplier": "LCSC",
                "Supplier Part": "C23228",
                "Group ID": "",
                "Channel ID": "$2ie526",
                "Reuse Block": "",
                "DeviceName": "Device_R",
                "FootprintName": ""
            },
            "pinInfoMap": {
                "1": {
                    "name": "",
                    "number": "1",
                    "net": "ISO_D5",
                    "props": {
                        "Pin Number": "1"
                    }
                },
                "2": {
                    "name": "",
                    "number": "2",
                    "net": "F_D5",
                    "props": {
                        "Pin Number": "2"
                    }
                }
            }
        },
        "6f4c4beafd605d3e": {
            "props": {
                "Add into BOM": "no",
                "Convert to PCB": "yes",
                "Name": "Device_R",
                "Device": "a97793246ea6c736",
                "Designator": "R25",
                "Footprint": "f2382a3a65e883d1",
                "Value": "0R",
                "UserDocLink": "",
                "Description": "",
                "ki_keywords": "",
                "ki_fp_filters": "",
                "Symbol": "39525148de9e2e86",
                "LCSC": "C21189",
                "Comment": "16-bit extension (DNP): connects G35 to FPGA",
                "Origin Footprint": "Resistor_SMD:R_0603_1608Metric",
                "Unique ID": "6f4c4beafd605d3e",
                "Manufacturer": "",
                "Manufacturer Part": "",
                "Supplier": "LCSC",
                "Supplier Part": "C21189",
                "Group ID": "",
                "Channel ID": "$2ie537",
                "Reuse Block": "",
                "DeviceName": "Device_R",
                "FootprintName": ""
            },
            "pinInfoMap": {
                "1": {
                    "name": "",
                    "number": "1",
                    "net": "M_EXT35",
                    "props": {
                        "Pin Number": "1"
                    }
                },
                "2": {
                    "name": "",
                    "number": "2",
                    "net": "F_EXT35",
                    "props": {
                        "Pin Number": "2"
                    }
                }
            }
        },
        "09b823a69019dbbf": {
            "props": {
                "Add into BOM": "yes",
                "Convert to PCB": "yes",
                "Name": "Device_R",
                "Device": "a97793246ea6c736",
                "Designator": "R26",
                "Footprint": "f2382a3a65e883d1",
                "Value": "680R",
                "UserDocLink": "",
                "Description": "",
                "ki_keywords": "",
                "ki_fp_filters": "",
                "Symbol": "39525148de9e2e86",
                "LCSC": "C23228",
                "Comment": "PoC 1MHz, 680ohm series damping; >=250ns DATA setup/hold, weak drive/SLOW; qualified distributed-RLC sensitivity",
                "Origin Footprint": "Resistor_SMD:R_0603_1608Metric",
                "Unique ID": "09b823a69019dbbf",
                "Manufacturer": "",
                "Manufacturer Part": "",
                "Supplier": "LCSC",
                "Supplier Part": "C23228",
                "Group ID": "",
                "Channel ID": "$2ie548",
                "Reuse Block": "",
                "DeviceName": "Device_R",
                "FootprintName": ""
            },
            "pinInfoMap": {
                "1": {
                    "name": "",
                    "number": "1",
                    "net": "ISO_D7",
                    "props": {
                        "Pin Number": "1"
                    }
                },
                "2": {
                    "name": "",
                    "number": "2",
                    "net": "F_D7",
                    "props": {
                        "Pin Number": "2"
                    }
                }
            }
        },
        "28145adf450505d9": {
            "props": {
                "Add into BOM": "yes",
                "Convert to PCB": "yes",
                "Name": "Device_R",
                "Device": "a97793246ea6c736",
                "Designator": "R27",
                "Footprint": "0053beec1f9b605e",
                "Value": "680R",
                "UserDocLink": "",
                "Description": "",
                "ki_keywords": "",
                "ki_fp_filters": "",
                "Symbol": "39525148de9e2e86",
                "LCSC": "C23228",
                "Comment": "PoC 1MHz, 680ohm series damping; >=250ns DATA setup/hold, weak drive/SLOW; qualified distributed-RLC sensitivity",
                "Origin Footprint": "Resistor_SMD:R_0603_1608Metric",
                "Unique ID": "28145adf450505d9",
                "Manufacturer": "",
                "Manufacturer Part": "",
                "Supplier": "LCSC",
                "Supplier Part": "C23228",
                "Group ID": "",
                "Channel ID": "$2ie559",
                "Reuse Block": "",
                "DeviceName": "Device_R",
                "FootprintName": ""
            },
            "pinInfoMap": {
                "1": {
                    "name": "",
                    "number": "1",
                    "net": "ISO_DIR",
                    "props": {
                        "Pin Number": "1"
                    }
                },
                "2": {
                    "name": "",
                    "number": "2",
                    "net": "F_DIR",
                    "props": {
                        "Pin Number": "2"
                    }
                }
            }
        },
        "7aadee231938cadd": {
            "props": {
                "Add into BOM": "yes",
                "Convert to PCB": "yes",
                "Name": "carrier_CORE_SODIMM_204",
                "Device": "07ecea96c78fb618",
                "Designator": "J4",
                "Value": "SOCKET XDAP-4042044-20401",
                "UserDocLink": "",
                "Description": "",
                "Origin Footprint": "carrier:DDR3_XDAP_4042044_20401",
                "Symbol": "3527a300169b1f96",
                "LCSC": "C22471982",
                "Comment": "PCBA required; socket only, user supplies Tang Primer 20K Core module",
                "Unique ID": "7aadee231938cadd",
                "Manufacturer": "",
                "Manufacturer Part": "",
                "Supplier": "LCSC",
                "Supplier Part": "C22471982",
                "Footprint": "a8a722055b3c5af7",
                "Group ID": "",
                "Channel ID": "$2ie570",
                "Reuse Block": "",
                "DeviceName": "carrier_CORE_SODIMM_204",
                "FootprintName": ""
            },
            "pinInfoMap": {
                "1": {
                    "name": "~",
                    "number": "1",
                    "net": "",
                    "props": {
                        "Pin Number": "1"
                    }
                },
                "2": {
                    "name": "GND",
                    "number": "2",
                    "net": "GND",
                    "props": {
                        "Pin Number": "2"
                    }
                },
                "3": {
                    "name": "GND",
                    "number": "3",
                    "net": "GND",
                    "props": {
                        "Pin Number": "3"
                    }
                },
                "4": {
                    "name": "+5V",
                    "number": "4",
                    "net": "+5V",
                    "props": {
                        "Pin Number": "4"
                    }
                },
                "5": {
                    "name": "+5V",
                    "number": "5",
                    "net": "+5V",
                    "props": {
                        "Pin Number": "5"
                    }
                },
                "6": {
                    "name": "+5V",
                    "number": "6",
                    "net": "+5V",
                    "props": {
                        "Pin Number": "6"
                    }
                },
                "7": {
                    "name": "+5V",
                    "number": "7",
                    "net": "+5V",
                    "props": {
                        "Pin Number": "7"
                    }
                },
                "8": {
                    "name": "GND",
                    "number": "8",
                    "net": "GND",
                    "props": {
                        "Pin Number": "8"
                    }
                },
                "9": {
                    "name": "GND",
                    "number": "9",
                    "net": "GND",
                    "props": {
                        "Pin Number": "9"
                    }
                },
                "10": {
                    "name": "~",
                    "number": "10",
                    "net": "",
                    "props": {
                        "Pin Number": "10"
                    }
                },
                "11": {
                    "name": "~",
                    "number": "11",
                    "net": "",
                    "props": {
                        "Pin Number": "11"
                    }
                },
                "12": {
                    "name": "~",
                    "number": "12",
                    "net": "",
                    "props": {
                        "Pin Number": "12"
                    }
                },
                "13": {
                    "name": "GND",
                    "number": "13",
                    "net": "GND",
                    "props": {
                        "Pin Number": "13"
                    }
                },
                "14": {
                    "name": "GND",
                    "number": "14",
                    "net": "GND",
                    "props": {
                        "Pin Number": "14"
                    }
                },
                "15": {
                    "name": "~",
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
                },
                "203": {
                    "name": "~",
                    "number": "203",
                    "net": "",
                    "props": {
                        "Pin Number": "203"
                    }
                },
                "204": {
                    "name": "~",
                    "number": "204",
                    "net": "",
                    "props": {
                        "Pin Number": "204"
                    }
                }
            }
        },
        "188f82074eb8ca32": {
            "props": {
                "Add into BOM": "yes",
                "Convert to PCB": "yes",
                "Name": "Connector_HDMI_A",
                "Device": "23580520dac4db6f",
                "Designator": "J5",
                "Footprint": "54d616aeae33209b",
                "Value": "HDMI OUT",
                "UserDocLink": "",
                "Description": "",
                "ki_keywords": "",
                "ki_fp_filters": "",
                "Symbol": "79b93e0f0a9cf3ce",
                "LCSC": "C916313",
                "Comment": "MOLEX 2086581001; PCBA required including four through-hole shell tabs; no customer HDMI soldering. Confirm full connector assembly in supplier preview.",
                "Origin Footprint": "Connector_Video:HDMI_A_Molex_208658-1001_Horizontal",
                "Unique ID": "188f82074eb8ca32",
                "Manufacturer": "",
                "Manufacturer Part": "",
                "Supplier": "LCSC",
                "Supplier Part": "C916313",
                "Group ID": "",
                "Channel ID": "$2ie581",
                "Reuse Block": "",
                "DeviceName": "Connector_HDMI_A",
                "FootprintName": ""
            },
            "pinInfoMap": {
                "1": {
                    "name": "D2+",
                    "number": "1",
                    "net": "HDMI_D2P_C",
                    "props": {
                        "Pin Number": "1"
                    }
                },
                "2": {
                    "name": "D2S",
                    "number": "2",
                    "net": "GND",
                    "props": {
                        "Pin Number": "2"
                    }
                },
                "3": {
                    "name": "D2-",
                    "number": "3",
                    "net": "HDMI_D2N_C",
                    "props": {
                        "Pin Number": "3"
                    }
                },
                "4": {
                    "name": "D1+",
                    "number": "4",
                    "net": "HDMI_D1P_C",
                    "props": {
                        "Pin Number": "4"
                    }
                },
                "5": {
                    "name": "D1S",
                    "number": "5",
                    "net": "GND",
                    "props": {
                        "Pin Number": "5"
                    }
                },
                "6": {
                    "name": "D1-",
                    "number": "6",
                    "net": "HDMI_D1N_C",
                    "props": {
                        "Pin Number": "6"
                    }
                },
                "7": {
                    "name": "D0+",
                    "number": "7",
                    "net": "HDMI_D0P_C",
                    "props": {
                        "Pin Number": "7"
                    }
                },
                "8": {
                    "name": "D0S",
                    "number": "8",
                    "net": "GND",
                    "props": {
                        "Pin Number": "8"
                    }
                },
                "9": {
                    "name": "D0-",
                    "number": "9",
                    "net": "HDMI_D0N_C",
                    "props": {
                        "Pin Number": "9"
                    }
                },
                "10": {
                    "name": "CK+",
                    "number": "10",
                    "net": "HDMI_CKP_C",
                    "props": {
                        "Pin Number": "10"
                    }
                },
                "11": {
                    "name": "CKS",
                    "number": "11",
                    "net": "GND",
                    "props": {
                        "Pin Number": "11"
                    }
                },
                "12": {
                    "name": "CK-",
                    "number": "12",
                    "net": "HDMI_CKN_C",
                    "props": {
                        "Pin Number": "12"
                    }
                },
                "13": {
                    "name": "CEC",
                    "number": "13",
                    "net": "",
                    "props": {
                        "Pin Number": "13"
                    }
                },
                "14": {
                    "name": "UTILITY",
                    "number": "14",
                    "net": "",
                    "props": {
                        "Pin Number": "14"
                    }
                },
                "15": {
                    "name": "SCL",
                    "number": "15",
                    "net": "HDMI_SCL",
                    "props": {
                        "Pin Number": "15"
                    }
                },
                "16": {
                    "name": "SDA",
                    "number": "16",
                    "net": "HDMI_SDA",
                    "props": {
                        "Pin Number": "16"
                    }
                },
                "17": {
                    "name": "GND",
                    "number": "17",
                    "net": "GND",
                    "props": {
                        "Pin Number": "17"
                    }
                },
                "18": {
                    "name": "+5V",
                    "number": "18",
                    "net": "HDMI_5V",
                    "props": {
                        "Pin Number": "18"
                    }
                },
                "19": {
                    "name": "HPD",
                    "number": "19",
                    "net": "HDMI_HPD",
                    "props": {
                        "Pin Number": "19"
                    }
                },
                "SH": {
                    "name": "SH",
                    "number": "SH",
                    "net": "GND",
                    "props": {
                        "Pin Number": "SH"
                    }
                }
            }
        },
        "26a39bcafcc8ce7c": {
            "props": {
                "Add into BOM": "yes",
                "Convert to PCB": "yes",
                "Name": "Device_C",
                "Device": "0c75d77cb9383693",
                "Designator": "C12",
                "Footprint": "92866978dfd9f852",
                "Value": "100n",
                "UserDocLink": "",
                "Description": "",
                "ki_keywords": "",
                "ki_fp_filters": "",
                "Symbol": "ab503096c520ae9c",
                "LCSC": "C1525",
                "Comment": "100nF AC coupling; low-profile 0402 under Core",
                "Origin Footprint": "Capacitor_SMD:C_0402_1005Metric",
                "Unique ID": "26a39bcafcc8ce7c",
                "Manufacturer": "",
                "Manufacturer Part": "",
                "Supplier": "LCSC",
                "Supplier Part": "C1525",
                "Group ID": "",
                "Channel ID": "$2ie592",
                "Reuse Block": "",
                "DeviceName": "Device_C",
                "FootprintName": ""
            },
            "pinInfoMap": {
                "1": {
                    "name": "",
                    "number": "1",
                    "net": "HDMI_D2P",
                    "props": {
                        "Pin Number": "1"
                    }
                },
                "2": {
                    "name": "",
                    "number": "2",
                    "net": "HDMI_D2P_C",
                    "props": {
                        "Pin Number": "2"
                    }
                }
            }
        },
        "d9f908b8ca857374": {
            "props": {
                "Add into BOM": "yes",
                "Convert to PCB": "yes",
                "Name": "Device_R",
                "Device": "a97793246ea6c736",
                "Designator": "R28",
                "Footprint": "840d5114b71a38b1",
                "Value": "510R",
                "UserDocLink": "",
                "Description": "",
                "ki_keywords": "",
                "ki_fp_filters": "",
                "Symbol": "39525148de9e2e86",
                "LCSC": "C23193",
                "Comment": "Basic 510 ohm; +2.2% vs 499; unchanged HDMI branch geometry",
                "Origin Footprint": "Resistor_SMD:R_0603_1608Metric",
                "Unique ID": "d9f908b8ca857374",
                "Manufacturer": "",
                "Manufacturer Part": "",
                "Supplier": "LCSC",
                "Supplier Part": "C23193",
                "Group ID": "",
                "Channel ID": "$2ie603",
                "Reuse Block": "",
                "DeviceName": "Device_R",
                "FootprintName": ""
            },
            "pinInfoMap": {
                "1": {
                    "name": "",
                    "number": "1",
                    "net": "HDMI_D2P_C",
                    "props": {
                        "Pin Number": "1"
                    }
                },
                "2": {
                    "name": "",
                    "number": "2",
                    "net": "GND",
                    "props": {
                        "Pin Number": "2"
                    }
                }
            }
        },
        "e7ba3aba9f9889c8": {
            "props": {
                "Add into BOM": "yes",
                "Convert to PCB": "yes",
                "Name": "Device_C",
                "Device": "0c75d77cb9383693",
                "Designator": "C13",
                "Footprint": "92866978dfd9f852",
                "Value": "100n",
                "UserDocLink": "",
                "Description": "",
                "ki_keywords": "",
                "ki_fp_filters": "",
                "Symbol": "ab503096c520ae9c",
                "LCSC": "C1525",
                "Comment": "100nF AC coupling; low-profile 0402 under Core",
                "Origin Footprint": "Capacitor_SMD:C_0402_1005Metric",
                "Unique ID": "e7ba3aba9f9889c8",
                "Manufacturer": "",
                "Manufacturer Part": "",
                "Supplier": "LCSC",
                "Supplier Part": "C1525",
                "Group ID": "",
                "Channel ID": "$2ie614",
                "Reuse Block": "",
                "DeviceName": "Device_C",
                "FootprintName": ""
            },
            "pinInfoMap": {
                "1": {
                    "name": "",
                    "number": "1",
                    "net": "HDMI_D2N",
                    "props": {
                        "Pin Number": "1"
                    }
                },
                "2": {
                    "name": "",
                    "number": "2",
                    "net": "HDMI_D2N_C",
                    "props": {
                        "Pin Number": "2"
                    }
                }
            }
        },
        "9e71ce6b7342da3b": {
            "props": {
                "Add into BOM": "yes",
                "Convert to PCB": "yes",
                "Name": "Device_R",
                "Device": "a97793246ea6c736",
                "Designator": "R29",
                "Footprint": "0053beec1f9b605e",
                "Value": "510R",
                "UserDocLink": "",
                "Description": "",
                "ki_keywords": "",
                "ki_fp_filters": "",
                "Symbol": "39525148de9e2e86",
                "LCSC": "C23193",
                "Comment": "Basic 510 ohm; +2.2% vs 499; unchanged HDMI branch geometry",
                "Origin Footprint": "Resistor_SMD:R_0603_1608Metric",
                "Unique ID": "9e71ce6b7342da3b",
                "Manufacturer": "",
                "Manufacturer Part": "",
                "Supplier": "LCSC",
                "Supplier Part": "C23193",
                "Group ID": "",
                "Channel ID": "$2ie625",
                "Reuse Block": "",
                "DeviceName": "Device_R",
                "FootprintName": ""
            },
            "pinInfoMap": {
                "1": {
                    "name": "",
                    "number": "1",
                    "net": "HDMI_D2N_C",
                    "props": {
                        "Pin Number": "1"
                    }
                },
                "2": {
                    "name": "",
                    "number": "2",
                    "net": "GND",
                    "props": {
                        "Pin Number": "2"
                    }
                }
            }
        },
        "00361082df9d4549": {
            "props": {
                "Add into BOM": "yes",
                "Convert to PCB": "yes",
                "Name": "Device_C",
                "Device": "0c75d77cb9383693",
                "Designator": "C14",
                "Footprint": "92866978dfd9f852",
                "Value": "100n",
                "UserDocLink": "",
                "Description": "",
                "ki_keywords": "",
                "ki_fp_filters": "",
                "Symbol": "ab503096c520ae9c",
                "LCSC": "C1525",
                "Comment": "100nF AC coupling; low-profile 0402 under Core",
                "Origin Footprint": "Capacitor_SMD:C_0402_1005Metric",
                "Unique ID": "00361082df9d4549",
                "Manufacturer": "",
                "Manufacturer Part": "",
                "Supplier": "LCSC",
                "Supplier Part": "C1525",
                "Group ID": "",
                "Channel ID": "$2ie636",
                "Reuse Block": "",
                "DeviceName": "Device_C",
                "FootprintName": ""
            },
            "pinInfoMap": {
                "1": {
                    "name": "",
                    "number": "1",
                    "net": "HDMI_D1P",
                    "props": {
                        "Pin Number": "1"
                    }
                },
                "2": {
                    "name": "",
                    "number": "2",
                    "net": "HDMI_D1P_C",
                    "props": {
                        "Pin Number": "2"
                    }
                }
            }
        },
        "8a972535593efa61": {
            "props": {
                "Add into BOM": "yes",
                "Convert to PCB": "yes",
                "Name": "Device_R",
                "Device": "d7e2c1e1574855d2",
                "Designator": "R30",
                "Footprint": "6f3d185220f7d357",
                "Value": "510R",
                "UserDocLink": "",
                "Description": "",
                "ki_keywords": "",
                "ki_fp_filters": "",
                "Symbol": "39525148de9e2e86",
                "LCSC": "C25123",
                "Comment": "Basic 510 ohm; +2.2% vs 499; unchanged HDMI branch geometry",
                "Origin Footprint": "Resistor_SMD:R_0402_1005Metric",
                "Unique ID": "8a972535593efa61",
                "Manufacturer": "",
                "Manufacturer Part": "",
                "Supplier": "LCSC",
                "Supplier Part": "C25123",
                "Group ID": "",
                "Channel ID": "$2ie647",
                "Reuse Block": "",
                "DeviceName": "Device_R",
                "FootprintName": ""
            },
            "pinInfoMap": {
                "1": {
                    "name": "",
                    "number": "1",
                    "net": "HDMI_D1P_C",
                    "props": {
                        "Pin Number": "1"
                    }
                },
                "2": {
                    "name": "",
                    "number": "2",
                    "net": "GND",
                    "props": {
                        "Pin Number": "2"
                    }
                }
            }
        },
        "86bb77bda672094d": {
            "props": {
                "Add into BOM": "yes",
                "Convert to PCB": "yes",
                "Name": "Device_C",
                "Device": "0c75d77cb9383693",
                "Designator": "C15",
                "Footprint": "92866978dfd9f852",
                "Value": "100n",
                "UserDocLink": "",
                "Description": "",
                "ki_keywords": "",
                "ki_fp_filters": "",
                "Symbol": "ab503096c520ae9c",
                "LCSC": "C1525",
                "Comment": "100nF AC coupling; low-profile 0402 under Core",
                "Origin Footprint": "Capacitor_SMD:C_0402_1005Metric",
                "Unique ID": "86bb77bda672094d",
                "Manufacturer": "",
                "Manufacturer Part": "",
                "Supplier": "LCSC",
                "Supplier Part": "C1525",
                "Group ID": "",
                "Channel ID": "$2ie658",
                "Reuse Block": "",
                "DeviceName": "Device_C",
                "FootprintName": ""
            },
            "pinInfoMap": {
                "1": {
                    "name": "",
                    "number": "1",
                    "net": "HDMI_D1N",
                    "props": {
                        "Pin Number": "1"
                    }
                },
                "2": {
                    "name": "",
                    "number": "2",
                    "net": "HDMI_D1N_C",
                    "props": {
                        "Pin Number": "2"
                    }
                }
            }
        },
        "b304d0fb6138316f": {
            "props": {
                "Add into BOM": "yes",
                "Convert to PCB": "yes",
                "Name": "Device_R",
                "Device": "d7e2c1e1574855d2",
                "Designator": "R31",
                "Footprint": "6f3d185220f7d357",
                "Value": "510R",
                "UserDocLink": "",
                "Description": "",
                "ki_keywords": "",
                "ki_fp_filters": "",
                "Symbol": "39525148de9e2e86",
                "LCSC": "C25123",
                "Comment": "Basic 510 ohm; +2.2% vs 499; unchanged HDMI branch geometry",
                "Origin Footprint": "Resistor_SMD:R_0402_1005Metric",
                "Unique ID": "b304d0fb6138316f",
                "Manufacturer": "",
                "Manufacturer Part": "",
                "Supplier": "LCSC",
                "Supplier Part": "C25123",
                "Group ID": "",
                "Channel ID": "$2ie669",
                "Reuse Block": "",
                "DeviceName": "Device_R",
                "FootprintName": ""
            },
            "pinInfoMap": {
                "1": {
                    "name": "",
                    "number": "1",
                    "net": "HDMI_D1N_C",
                    "props": {
                        "Pin Number": "1"
                    }
                },
                "2": {
                    "name": "",
                    "number": "2",
                    "net": "GND",
                    "props": {
                        "Pin Number": "2"
                    }
                }
            }
        },
        "c8e923f96b539988": {
            "props": {
                "Add into BOM": "yes",
                "Convert to PCB": "yes",
                "Name": "Device_C",
                "Device": "0c75d77cb9383693",
                "Designator": "C16",
                "Footprint": "92866978dfd9f852",
                "Value": "100n",
                "UserDocLink": "",
                "Description": "",
                "ki_keywords": "",
                "ki_fp_filters": "",
                "Symbol": "ab503096c520ae9c",
                "LCSC": "C1525",
                "Comment": "100nF AC coupling; low-profile 0402 under Core",
                "Origin Footprint": "Capacitor_SMD:C_0402_1005Metric",
                "Unique ID": "c8e923f96b539988",
                "Manufacturer": "",
                "Manufacturer Part": "",
                "Supplier": "LCSC",
                "Supplier Part": "C1525",
                "Group ID": "",
                "Channel ID": "$2ie680",
                "Reuse Block": "",
                "DeviceName": "Device_C",
                "FootprintName": ""
            },
            "pinInfoMap": {
                "1": {
                    "name": "",
                    "number": "1",
                    "net": "HDMI_D0P",
                    "props": {
                        "Pin Number": "1"
                    }
                },
                "2": {
                    "name": "",
                    "number": "2",
                    "net": "HDMI_D0P_C",
                    "props": {
                        "Pin Number": "2"
                    }
                }
            }
        },
        "94189e0415d5623f": {
            "props": {
                "Add into BOM": "yes",
                "Convert to PCB": "yes",
                "Name": "Device_R",
                "Device": "a97793246ea6c736",
                "Designator": "R32",
                "Footprint": "840d5114b71a38b1",
                "Value": "510R",
                "UserDocLink": "",
                "Description": "",
                "ki_keywords": "",
                "ki_fp_filters": "",
                "Symbol": "39525148de9e2e86",
                "LCSC": "C23193",
                "Comment": "Basic 510 ohm; +2.2% vs 499; unchanged HDMI branch geometry",
                "Origin Footprint": "Resistor_SMD:R_0603_1608Metric",
                "Unique ID": "94189e0415d5623f",
                "Manufacturer": "",
                "Manufacturer Part": "",
                "Supplier": "LCSC",
                "Supplier Part": "C23193",
                "Group ID": "",
                "Channel ID": "$2ie691",
                "Reuse Block": "",
                "DeviceName": "Device_R",
                "FootprintName": ""
            },
            "pinInfoMap": {
                "1": {
                    "name": "",
                    "number": "1",
                    "net": "HDMI_D0P_C",
                    "props": {
                        "Pin Number": "1"
                    }
                },
                "2": {
                    "name": "",
                    "number": "2",
                    "net": "GND",
                    "props": {
                        "Pin Number": "2"
                    }
                }
            }
        },
        "48700c84863a802e": {
            "props": {
                "Add into BOM": "yes",
                "Convert to PCB": "yes",
                "Name": "Device_C",
                "Device": "0c75d77cb9383693",
                "Designator": "C17",
                "Footprint": "92866978dfd9f852",
                "Value": "100n",
                "UserDocLink": "",
                "Description": "",
                "ki_keywords": "",
                "ki_fp_filters": "",
                "Symbol": "ab503096c520ae9c",
                "LCSC": "C1525",
                "Comment": "100nF AC coupling; low-profile 0402 under Core",
                "Origin Footprint": "Capacitor_SMD:C_0402_1005Metric",
                "Unique ID": "48700c84863a802e",
                "Manufacturer": "",
                "Manufacturer Part": "",
                "Supplier": "LCSC",
                "Supplier Part": "C1525",
                "Group ID": "",
                "Channel ID": "$2ie702",
                "Reuse Block": "",
                "DeviceName": "Device_C",
                "FootprintName": ""
            },
            "pinInfoMap": {
                "1": {
                    "name": "",
                    "number": "1",
                    "net": "HDMI_D0N",
                    "props": {
                        "Pin Number": "1"
                    }
                },
                "2": {
                    "name": "",
                    "number": "2",
                    "net": "HDMI_D0N_C",
                    "props": {
                        "Pin Number": "2"
                    }
                }
            }
        },
        "e0ee0f05e2f0b4da": {
            "props": {
                "Add into BOM": "yes",
                "Convert to PCB": "yes",
                "Name": "Device_R",
                "Device": "a97793246ea6c736",
                "Designator": "R33",
                "Footprint": "840d5114b71a38b1",
                "Value": "510R",
                "UserDocLink": "",
                "Description": "",
                "ki_keywords": "",
                "ki_fp_filters": "",
                "Symbol": "39525148de9e2e86",
                "LCSC": "C23193",
                "Comment": "Basic 510 ohm; +2.2% vs 499; unchanged HDMI branch geometry",
                "Origin Footprint": "Resistor_SMD:R_0603_1608Metric",
                "Unique ID": "e0ee0f05e2f0b4da",
                "Manufacturer": "",
                "Manufacturer Part": "",
                "Supplier": "LCSC",
                "Supplier Part": "C23193",
                "Group ID": "",
                "Channel ID": "$2ie713",
                "Reuse Block": "",
                "DeviceName": "Device_R",
                "FootprintName": ""
            },
            "pinInfoMap": {
                "1": {
                    "name": "",
                    "number": "1",
                    "net": "HDMI_D0N_C",
                    "props": {
                        "Pin Number": "1"
                    }
                },
                "2": {
                    "name": "",
                    "number": "2",
                    "net": "GND",
                    "props": {
                        "Pin Number": "2"
                    }
                }
            }
        },
        "d9d0285421fe3ef0": {
            "props": {
                "Add into BOM": "yes",
                "Convert to PCB": "yes",
                "Name": "Device_C",
                "Device": "0c75d77cb9383693",
                "Designator": "C18",
                "Footprint": "92866978dfd9f852",
                "Value": "100n",
                "UserDocLink": "",
                "Description": "",
                "ki_keywords": "",
                "ki_fp_filters": "",
                "Symbol": "ab503096c520ae9c",
                "LCSC": "C1525",
                "Comment": "100nF AC coupling; low-profile 0402 under Core",
                "Origin Footprint": "Capacitor_SMD:C_0402_1005Metric",
                "Unique ID": "d9d0285421fe3ef0",
                "Manufacturer": "",
                "Manufacturer Part": "",
                "Supplier": "LCSC",
                "Supplier Part": "C1525",
                "Group ID": "",
                "Channel ID": "$2ie724",
                "Reuse Block": "",
                "DeviceName": "Device_C",
                "FootprintName": ""
            },
            "pinInfoMap": {
                "1": {
                    "name": "",
                    "number": "1",
                    "net": "HDMI_CKP",
                    "props": {
                        "Pin Number": "1"
                    }
                },
                "2": {
                    "name": "",
                    "number": "2",
                    "net": "HDMI_CKP_C",
                    "props": {
                        "Pin Number": "2"
                    }
                }
            }
        },
        "c7fcac2dc179deab": {
            "props": {
                "Add into BOM": "yes",
                "Convert to PCB": "yes",
                "Name": "Device_R",
                "Device": "a97793246ea6c736",
                "Designator": "R34",
                "Footprint": "840d5114b71a38b1",
                "Value": "510R",
                "UserDocLink": "",
                "Description": "",
                "ki_keywords": "",
                "ki_fp_filters": "",
                "Symbol": "39525148de9e2e86",
                "LCSC": "C23193",
                "Comment": "Basic 510 ohm; +2.2% vs 499; unchanged HDMI branch geometry",
                "Origin Footprint": "Resistor_SMD:R_0603_1608Metric",
                "Unique ID": "c7fcac2dc179deab",
                "Manufacturer": "",
                "Manufacturer Part": "",
                "Supplier": "LCSC",
                "Supplier Part": "C23193",
                "Group ID": "",
                "Channel ID": "$2ie735",
                "Reuse Block": "",
                "DeviceName": "Device_R",
                "FootprintName": ""
            },
            "pinInfoMap": {
                "1": {
                    "name": "",
                    "number": "1",
                    "net": "HDMI_CKP_C",
                    "props": {
                        "Pin Number": "1"
                    }
                },
                "2": {
                    "name": "",
                    "number": "2",
                    "net": "GND",
                    "props": {
                        "Pin Number": "2"
                    }
                }
            }
        },
        "9b75bd895f0e39d2": {
            "props": {
                "Add into BOM": "yes",
                "Convert to PCB": "yes",
                "Name": "Device_C",
                "Device": "0c75d77cb9383693",
                "Designator": "C19",
                "Footprint": "92866978dfd9f852",
                "Value": "100n",
                "UserDocLink": "",
                "Description": "",
                "ki_keywords": "",
                "ki_fp_filters": "",
                "Symbol": "ab503096c520ae9c",
                "LCSC": "C1525",
                "Comment": "100nF AC coupling; low-profile 0402 under Core",
                "Origin Footprint": "Capacitor_SMD:C_0402_1005Metric",
                "Unique ID": "9b75bd895f0e39d2",
                "Manufacturer": "",
                "Manufacturer Part": "",
                "Supplier": "LCSC",
                "Supplier Part": "C1525",
                "Group ID": "",
                "Channel ID": "$2ie746",
                "Reuse Block": "",
                "DeviceName": "Device_C",
                "FootprintName": ""
            },
            "pinInfoMap": {
                "1": {
                    "name": "",
                    "number": "1",
                    "net": "HDMI_CKN",
                    "props": {
                        "Pin Number": "1"
                    }
                },
                "2": {
                    "name": "",
                    "number": "2",
                    "net": "HDMI_CKN_C",
                    "props": {
                        "Pin Number": "2"
                    }
                }
            }
        },
        "ed5ed49cac6cc905": {
            "props": {
                "Add into BOM": "yes",
                "Convert to PCB": "yes",
                "Name": "Device_R",
                "Device": "a97793246ea6c736",
                "Designator": "R35",
                "Footprint": "0053beec1f9b605e",
                "Value": "510R",
                "UserDocLink": "",
                "Description": "",
                "ki_keywords": "",
                "ki_fp_filters": "",
                "Symbol": "39525148de9e2e86",
                "LCSC": "C23193",
                "Comment": "Basic 510 ohm; +2.2% vs 499; unchanged HDMI branch geometry",
                "Origin Footprint": "Resistor_SMD:R_0603_1608Metric",
                "Unique ID": "ed5ed49cac6cc905",
                "Manufacturer": "",
                "Manufacturer Part": "",
                "Supplier": "LCSC",
                "Supplier Part": "C23193",
                "Group ID": "",
                "Channel ID": "$2ie757",
                "Reuse Block": "",
                "DeviceName": "Device_R",
                "FootprintName": ""
            },
            "pinInfoMap": {
                "1": {
                    "name": "",
                    "number": "1",
                    "net": "HDMI_CKN_C",
                    "props": {
                        "Pin Number": "1"
                    }
                },
                "2": {
                    "name": "",
                    "number": "2",
                    "net": "GND",
                    "props": {
                        "Pin Number": "2"
                    }
                }
            }
        },
        "bac468049775df37": {
            "props": {
                "Add into BOM": "yes",
                "Convert to PCB": "yes",
                "Name": "carrier_RCLAMP0524P",
                "Device": "662982a61c6a0514",
                "Designator": "U4",
                "Value": "RCLAMP0524P",
                "UserDocLink": "",
                "Description": "",
                "Origin Footprint": "carrier:DFN2510-10L_RCLAMP0524P",
                "Symbol": "d502df33dc2eaf9b",
                "LCSC": "C293965",
                "Comment": "TMDS ESD array (DOWO DFN2510-10L): I/O 1,2,4,5, GND 3,8; the line is routed as continuous copper through strapped pads",
                "Unique ID": "bac468049775df37",
                "Manufacturer": "",
                "Manufacturer Part": "",
                "Supplier": "LCSC",
                "Supplier Part": "C293965",
                "Footprint": "99bab940c4f22b22",
                "Group ID": "",
                "Channel ID": "$2ie768",
                "Reuse Block": "",
                "DeviceName": "carrier_RCLAMP0524P",
                "FootprintName": ""
            },
            "pinInfoMap": {
                "1": {
                    "name": "IO1",
                    "number": "1",
                    "net": "HDMI_D2P_C",
                    "props": {
                        "Pin Number": "1"
                    }
                },
                "2": {
                    "name": "IO2",
                    "number": "2",
                    "net": "HDMI_D2N_C",
                    "props": {
                        "Pin Number": "2"
                    }
                },
                "3": {
                    "name": "GND",
                    "number": "3",
                    "net": "GND",
                    "props": {
                        "Pin Number": "3"
                    }
                },
                "4": {
                    "name": "IO3",
                    "number": "4",
                    "net": "HDMI_D1P_C",
                    "props": {
                        "Pin Number": "4"
                    }
                },
                "5": {
                    "name": "IO4",
                    "number": "5",
                    "net": "HDMI_D1N_C",
                    "props": {
                        "Pin Number": "5"
                    }
                },
                "6": {
                    "name": "NC",
                    "number": "6",
                    "net": "HDMI_D1N_C",
                    "props": {
                        "Pin Number": "6"
                    }
                },
                "7": {
                    "name": "NC",
                    "number": "7",
                    "net": "HDMI_D1P_C",
                    "props": {
                        "Pin Number": "7"
                    }
                },
                "8": {
                    "name": "GND",
                    "number": "8",
                    "net": "GND",
                    "props": {
                        "Pin Number": "8"
                    }
                },
                "9": {
                    "name": "NC",
                    "number": "9",
                    "net": "HDMI_D2N_C",
                    "props": {
                        "Pin Number": "9"
                    }
                },
                "10": {
                    "name": "NC",
                    "number": "10",
                    "net": "HDMI_D2P_C",
                    "props": {
                        "Pin Number": "10"
                    }
                }
            }
        },
        "adf583383e4d69d4": {
            "props": {
                "Add into BOM": "yes",
                "Convert to PCB": "yes",
                "Name": "carrier_RCLAMP0524P",
                "Device": "662982a61c6a0514",
                "Designator": "U5",
                "Value": "RCLAMP0524P",
                "UserDocLink": "",
                "Description": "",
                "Origin Footprint": "carrier:DFN2510-10L_RCLAMP0524P",
                "Symbol": "d502df33dc2eaf9b",
                "LCSC": "C293965",
                "Comment": "TMDS ESD array (DOWO DFN2510-10L): I/O 1,2,4,5, GND 3,8; the line is routed as continuous copper through strapped pads",
                "Unique ID": "adf583383e4d69d4",
                "Manufacturer": "",
                "Manufacturer Part": "",
                "Supplier": "LCSC",
                "Supplier Part": "C293965",
                "Footprint": "99bab940c4f22b22",
                "Group ID": "",
                "Channel ID": "$2ie779",
                "Reuse Block": "",
                "DeviceName": "carrier_RCLAMP0524P",
                "FootprintName": ""
            },
            "pinInfoMap": {
                "1": {
                    "name": "IO1",
                    "number": "1",
                    "net": "HDMI_D0P_C",
                    "props": {
                        "Pin Number": "1"
                    }
                },
                "2": {
                    "name": "IO2",
                    "number": "2",
                    "net": "HDMI_D0N_C",
                    "props": {
                        "Pin Number": "2"
                    }
                },
                "3": {
                    "name": "GND",
                    "number": "3",
                    "net": "GND",
                    "props": {
                        "Pin Number": "3"
                    }
                },
                "4": {
                    "name": "IO3",
                    "number": "4",
                    "net": "HDMI_CKP_C",
                    "props": {
                        "Pin Number": "4"
                    }
                },
                "5": {
                    "name": "IO4",
                    "number": "5",
                    "net": "HDMI_CKN_C",
                    "props": {
                        "Pin Number": "5"
                    }
                },
                "6": {
                    "name": "NC",
                    "number": "6",
                    "net": "HDMI_CKN_C",
                    "props": {
                        "Pin Number": "6"
                    }
                },
                "7": {
                    "name": "NC",
                    "number": "7",
                    "net": "HDMI_CKP_C",
                    "props": {
                        "Pin Number": "7"
                    }
                },
                "8": {
                    "name": "GND",
                    "number": "8",
                    "net": "GND",
                    "props": {
                        "Pin Number": "8"
                    }
                },
                "9": {
                    "name": "NC",
                    "number": "9",
                    "net": "HDMI_D0N_C",
                    "props": {
                        "Pin Number": "9"
                    }
                },
                "10": {
                    "name": "NC",
                    "number": "10",
                    "net": "HDMI_D0P_C",
                    "props": {
                        "Pin Number": "10"
                    }
                }
            }
        },
        "124c013cfc851acc": {
            "props": {
                "Add into BOM": "yes",
                "Convert to PCB": "yes",
                "Name": "carrier_RCLAMP0524P",
                "Device": "662982a61c6a0514",
                "Designator": "U6",
                "Value": "RCLAMP0524P",
                "UserDocLink": "",
                "Description": "",
                "Origin Footprint": "carrier:DFN2510-10L_RCLAMP0524P",
                "Symbol": "d502df33dc2eaf9b",
                "LCSC": "C293965",
                "Comment": "Independent ground-referenced ESD channels, no shared VCC steering; NC counterpart lands externally copper strapped",
                "Unique ID": "124c013cfc851acc",
                "Manufacturer": "",
                "Manufacturer Part": "",
                "Supplier": "LCSC",
                "Supplier Part": "C293965",
                "Footprint": "99bab940c4f22b22",
                "Group ID": "",
                "Channel ID": "$2ie790",
                "Reuse Block": "",
                "DeviceName": "carrier_RCLAMP0524P",
                "FootprintName": ""
            },
            "pinInfoMap": {
                "1": {
                    "name": "IO1",
                    "number": "1",
                    "net": "HDMI_SDA",
                    "props": {
                        "Pin Number": "1"
                    }
                },
                "2": {
                    "name": "IO2",
                    "number": "2",
                    "net": "HDMI_5V",
                    "props": {
                        "Pin Number": "2"
                    }
                },
                "3": {
                    "name": "GND",
                    "number": "3",
                    "net": "GND",
                    "props": {
                        "Pin Number": "3"
                    }
                },
                "4": {
                    "name": "IO3",
                    "number": "4",
                    "net": "HDMI_SCL",
                    "props": {
                        "Pin Number": "4"
                    }
                },
                "5": {
                    "name": "IO4",
                    "number": "5",
                    "net": "HDMI_HPD",
                    "props": {
                        "Pin Number": "5"
                    }
                },
                "6": {
                    "name": "NC",
                    "number": "6",
                    "net": "HDMI_HPD",
                    "props": {
                        "Pin Number": "6"
                    }
                },
                "7": {
                    "name": "NC",
                    "number": "7",
                    "net": "HDMI_SCL",
                    "props": {
                        "Pin Number": "7"
                    }
                },
                "8": {
                    "name": "GND",
                    "number": "8",
                    "net": "GND",
                    "props": {
                        "Pin Number": "8"
                    }
                },
                "9": {
                    "name": "NC",
                    "number": "9",
                    "net": "HDMI_5V",
                    "props": {
                        "Pin Number": "9"
                    }
                },
                "10": {
                    "name": "NC",
                    "number": "10",
                    "net": "HDMI_SDA",
                    "props": {
                        "Pin Number": "10"
                    }
                }
            }
        },
        "dce76cdd9f7f4243": {
            "props": {
                "Add into BOM": "yes",
                "Convert to PCB": "yes",
                "Name": "Device_Polyfuse",
                "Device": "a915e46ce1f54d7d",
                "Designator": "F2",
                "Footprint": "093388a99cbe07a4",
                "Value": "PTC 500mA",
                "UserDocLink": "",
                "Description": "",
                "ki_keywords": "",
                "ki_fp_filters": "",
                "Symbol": "cf0d6468d29abfde",
                "LCSC": "C315893",
                "Origin Footprint": "Fuse:Fuse_1206_3216Metric",
                "Unique ID": "dce76cdd9f7f4243",
                "Manufacturer": "",
                "Manufacturer Part": "",
                "Supplier": "LCSC",
                "Supplier Part": "C315893",
                "Comment": "",
                "Group ID": "",
                "Channel ID": "$2ie801",
                "Reuse Block": "",
                "DeviceName": "Device_Polyfuse",
                "FootprintName": ""
            },
            "pinInfoMap": {
                "1": {
                    "name": "",
                    "number": "1",
                    "net": "+5V",
                    "props": {
                        "Pin Number": "1"
                    }
                },
                "2": {
                    "name": "",
                    "number": "2",
                    "net": "HDMI_5V",
                    "props": {
                        "Pin Number": "2"
                    }
                }
            }
        },
        "f76c01de5337d462": {
            "props": {
                "Add into BOM": "yes",
                "Convert to PCB": "yes",
                "Name": "Transistor_FET_2N7002",
                "Device": "e0f04eb4579b2031",
                "Designator": "Q1",
                "Value": "2N7002",
                "UserDocLink": "",
                "Description": "",
                "ki_keywords": "",
                "Origin Footprint": "Package_TO_SOT_SMD:SOT-23",
                "Symbol": "d1109e68a4e34a7a",
                "LCSC": "C8545",
                "Comment": "DDC level shifter (pin1=G pin2=S pin3=D)",
                "Unique ID": "f76c01de5337d462",
                "Manufacturer": "",
                "Manufacturer Part": "",
                "Supplier": "LCSC",
                "Supplier Part": "C8545",
                "Footprint": "b6a370204b09708a",
                "Group ID": "",
                "Channel ID": "$2ie811",
                "Reuse Block": "",
                "DeviceName": "Transistor_FET_2N7002",
                "FootprintName": ""
            },
            "pinInfoMap": {
                "1": {
                    "name": "G",
                    "number": "1",
                    "net": "+3V3",
                    "props": {
                        "Pin Number": "1"
                    }
                },
                "2": {
                    "name": "S",
                    "number": "2",
                    "net": "F_HSCL",
                    "props": {
                        "Pin Number": "2"
                    }
                },
                "3": {
                    "name": "D",
                    "number": "3",
                    "net": "HDMI_SCL",
                    "props": {
                        "Pin Number": "3"
                    }
                }
            }
        },
        "4c27cd76e8dbac26": {
            "props": {
                "Add into BOM": "yes",
                "Convert to PCB": "yes",
                "Name": "Transistor_FET_2N7002",
                "Device": "e0f04eb4579b2031",
                "Designator": "Q2",
                "Value": "2N7002",
                "UserDocLink": "",
                "Description": "",
                "ki_keywords": "",
                "Origin Footprint": "Package_TO_SOT_SMD:SOT-23",
                "Symbol": "d1109e68a4e34a7a",
                "LCSC": "C8545",
                "Unique ID": "4c27cd76e8dbac26",
                "Comment": "",
                "Manufacturer": "",
                "Manufacturer Part": "",
                "Supplier": "LCSC",
                "Supplier Part": "C8545",
                "Footprint": "b6a370204b09708a",
                "Group ID": "",
                "Channel ID": "$2ie822",
                "Reuse Block": "",
                "DeviceName": "Transistor_FET_2N7002",
                "FootprintName": ""
            },
            "pinInfoMap": {
                "1": {
                    "name": "G",
                    "number": "1",
                    "net": "+3V3",
                    "props": {
                        "Pin Number": "1"
                    }
                },
                "2": {
                    "name": "S",
                    "number": "2",
                    "net": "F_HSDA",
                    "props": {
                        "Pin Number": "2"
                    }
                },
                "3": {
                    "name": "D",
                    "number": "3",
                    "net": "HDMI_SDA",
                    "props": {
                        "Pin Number": "3"
                    }
                }
            }
        },
        "ee084f684bde39fa": {
            "props": {
                "Add into BOM": "yes",
                "Convert to PCB": "yes",
                "Name": "Device_R",
                "Device": "a97793246ea6c736",
                "Designator": "R36",
                "Footprint": "0053beec1f9b605e",
                "Value": "10k",
                "UserDocLink": "",
                "Description": "",
                "ki_keywords": "",
                "ki_fp_filters": "",
                "Symbol": "39525148de9e2e86",
                "LCSC": "C25804",
                "Origin Footprint": "Resistor_SMD:R_0603_1608Metric",
                "Unique ID": "ee084f684bde39fa",
                "Manufacturer": "",
                "Manufacturer Part": "",
                "Supplier": "LCSC",
                "Supplier Part": "C25804",
                "Comment": "",
                "Group ID": "",
                "Channel ID": "$2ie832",
                "Reuse Block": "",
                "DeviceName": "Device_R",
                "FootprintName": ""
            },
            "pinInfoMap": {
                "1": {
                    "name": "",
                    "number": "1",
                    "net": "+3V3",
                    "props": {
                        "Pin Number": "1"
                    }
                },
                "2": {
                    "name": "",
                    "number": "2",
                    "net": "F_HSCL",
                    "props": {
                        "Pin Number": "2"
                    }
                }
            }
        },
        "0e69257913149112": {
            "props": {
                "Add into BOM": "yes",
                "Convert to PCB": "yes",
                "Name": "Device_R",
                "Device": "a97793246ea6c736",
                "Designator": "R37",
                "Footprint": "0053beec1f9b605e",
                "Value": "10k",
                "UserDocLink": "",
                "Description": "",
                "ki_keywords": "",
                "ki_fp_filters": "",
                "Symbol": "39525148de9e2e86",
                "LCSC": "C25804",
                "Origin Footprint": "Resistor_SMD:R_0603_1608Metric",
                "Unique ID": "0e69257913149112",
                "Manufacturer": "",
                "Manufacturer Part": "",
                "Supplier": "LCSC",
                "Supplier Part": "C25804",
                "Comment": "",
                "Group ID": "",
                "Channel ID": "$2ie842",
                "Reuse Block": "",
                "DeviceName": "Device_R",
                "FootprintName": ""
            },
            "pinInfoMap": {
                "1": {
                    "name": "",
                    "number": "1",
                    "net": "+3V3",
                    "props": {
                        "Pin Number": "1"
                    }
                },
                "2": {
                    "name": "",
                    "number": "2",
                    "net": "F_HSDA",
                    "props": {
                        "Pin Number": "2"
                    }
                }
            }
        },
        "2eb3813281b987ab": {
            "props": {
                "Add into BOM": "yes",
                "Convert to PCB": "yes",
                "Name": "Device_R",
                "Device": "a97793246ea6c736",
                "Designator": "R38",
                "Footprint": "0053beec1f9b605e",
                "Value": "2.2k",
                "UserDocLink": "",
                "Description": "",
                "ki_keywords": "",
                "ki_fp_filters": "",
                "Symbol": "39525148de9e2e86",
                "LCSC": "C4190",
                "Origin Footprint": "Resistor_SMD:R_0603_1608Metric",
                "Unique ID": "2eb3813281b987ab",
                "Manufacturer": "",
                "Manufacturer Part": "",
                "Supplier": "LCSC",
                "Supplier Part": "C4190",
                "Comment": "",
                "Group ID": "",
                "Channel ID": "$2ie852",
                "Reuse Block": "",
                "DeviceName": "Device_R",
                "FootprintName": ""
            },
            "pinInfoMap": {
                "1": {
                    "name": "",
                    "number": "1",
                    "net": "HDMI_5V",
                    "props": {
                        "Pin Number": "1"
                    }
                },
                "2": {
                    "name": "",
                    "number": "2",
                    "net": "HDMI_SCL",
                    "props": {
                        "Pin Number": "2"
                    }
                }
            }
        },
        "61aee2c7162d13e5": {
            "props": {
                "Add into BOM": "yes",
                "Convert to PCB": "yes",
                "Name": "Device_R",
                "Device": "a97793246ea6c736",
                "Designator": "R39",
                "Footprint": "0053beec1f9b605e",
                "Value": "2.2k",
                "UserDocLink": "",
                "Description": "",
                "ki_keywords": "",
                "ki_fp_filters": "",
                "Symbol": "39525148de9e2e86",
                "LCSC": "C4190",
                "Origin Footprint": "Resistor_SMD:R_0603_1608Metric",
                "Unique ID": "61aee2c7162d13e5",
                "Manufacturer": "",
                "Manufacturer Part": "",
                "Supplier": "LCSC",
                "Supplier Part": "C4190",
                "Comment": "",
                "Group ID": "",
                "Channel ID": "$2ie862",
                "Reuse Block": "",
                "DeviceName": "Device_R",
                "FootprintName": ""
            },
            "pinInfoMap": {
                "1": {
                    "name": "",
                    "number": "1",
                    "net": "HDMI_5V",
                    "props": {
                        "Pin Number": "1"
                    }
                },
                "2": {
                    "name": "",
                    "number": "2",
                    "net": "HDMI_SDA",
                    "props": {
                        "Pin Number": "2"
                    }
                }
            }
        },
        "5d7d37af6db8001c": {
            "props": {
                "Add into BOM": "yes",
                "Convert to PCB": "yes",
                "Name": "Device_R",
                "Device": "a97793246ea6c736",
                "Designator": "R40",
                "Footprint": "0053beec1f9b605e",
                "Value": "47k",
                "UserDocLink": "",
                "Description": "",
                "ki_keywords": "",
                "ki_fp_filters": "",
                "Symbol": "39525148de9e2e86",
                "LCSC": "C25819",
                "Origin Footprint": "Resistor_SMD:R_0603_1608Metric",
                "Unique ID": "5d7d37af6db8001c",
                "Manufacturer": "",
                "Manufacturer Part": "",
                "Supplier": "LCSC",
                "Supplier Part": "C25819",
                "Comment": "",
                "Group ID": "",
                "Channel ID": "$2ie872",
                "Reuse Block": "",
                "DeviceName": "Device_R",
                "FootprintName": ""
            },
            "pinInfoMap": {
                "1": {
                    "name": "",
                    "number": "1",
                    "net": "HDMI_HPD",
                    "props": {
                        "Pin Number": "1"
                    }
                },
                "2": {
                    "name": "",
                    "number": "2",
                    "net": "HPD_B",
                    "props": {
                        "Pin Number": "2"
                    }
                }
            }
        },
        "e262797b4e338b99": {
            "props": {
                "Add into BOM": "yes",
                "Convert to PCB": "yes",
                "Name": "Device_R",
                "Device": "a97793246ea6c736",
                "Designator": "R41",
                "Footprint": "0053beec1f9b605e",
                "Value": "100k",
                "UserDocLink": "",
                "Description": "",
                "ki_keywords": "",
                "ki_fp_filters": "",
                "Symbol": "39525148de9e2e86",
                "LCSC": "C25803",
                "Origin Footprint": "Resistor_SMD:R_0603_1608Metric",
                "Unique ID": "e262797b4e338b99",
                "Manufacturer": "",
                "Manufacturer Part": "",
                "Supplier": "LCSC",
                "Supplier Part": "C25803",
                "Comment": "",
                "Group ID": "",
                "Channel ID": "$2ie882",
                "Reuse Block": "",
                "DeviceName": "Device_R",
                "FootprintName": ""
            },
            "pinInfoMap": {
                "1": {
                    "name": "",
                    "number": "1",
                    "net": "HPD_B",
                    "props": {
                        "Pin Number": "1"
                    }
                },
                "2": {
                    "name": "",
                    "number": "2",
                    "net": "GND",
                    "props": {
                        "Pin Number": "2"
                    }
                }
            }
        },
        "be1703a8306ee88a": {
            "props": {
                "Add into BOM": "no",
                "Convert to PCB": "yes",
                "Name": "Connector_Generic_Conn_02x06_Odd_Even",
                "Device": "c2e1c8b242838553",
                "Designator": "J6",
                "Footprint": "c9dfdb5aba9e1038",
                "Value": "PMOD1",
                "UserDocLink": "",
                "Description": "",
                "ki_keywords": "",
                "ki_fp_filters": "",
                "Symbol": "48dbfcfc896d8280",
                "Comment": "2x6 PMOD-style, 3.3V. Pads only: pin header is hand-fitted later (DNP)",
                "Origin Footprint": "Connector_PinHeader_2.54mm:PinHeader_2x06_P2.54mm_Vertical",
                "Unique ID": "be1703a8306ee88a",
                "Manufacturer": "",
                "Manufacturer Part": "",
                "Supplier": "",
                "Supplier Part": "1",
                "LCSC": "",
                "Group ID": "",
                "Channel ID": "$2ie892",
                "Reuse Block": "",
                "DeviceName": "Connector_Generic_Conn_02x06_Odd_Even",
                "FootprintName": ""
            },
            "pinInfoMap": {
                "1": {
                    "name": "Pin_1",
                    "number": "1",
                    "net": "P1_0",
                    "props": {
                        "Pin Number": "1"
                    }
                },
                "2": {
                    "name": "Pin_2",
                    "number": "2",
                    "net": "P1_4",
                    "props": {
                        "Pin Number": "2"
                    }
                },
                "3": {
                    "name": "Pin_3",
                    "number": "3",
                    "net": "P1_1",
                    "props": {
                        "Pin Number": "3"
                    }
                },
                "4": {
                    "name": "Pin_4",
                    "number": "4",
                    "net": "P1_5",
                    "props": {
                        "Pin Number": "4"
                    }
                },
                "5": {
                    "name": "Pin_5",
                    "number": "5",
                    "net": "P1_2",
                    "props": {
                        "Pin Number": "5"
                    }
                },
                "6": {
                    "name": "Pin_6",
                    "number": "6",
                    "net": "P1_6",
                    "props": {
                        "Pin Number": "6"
                    }
                },
                "7": {
                    "name": "Pin_7",
                    "number": "7",
                    "net": "P1_3",
                    "props": {
                        "Pin Number": "7"
                    }
                },
                "8": {
                    "name": "Pin_8",
                    "number": "8",
                    "net": "P1_7",
                    "props": {
                        "Pin Number": "8"
                    }
                },
                "9": {
                    "name": "Pin_9",
                    "number": "9",
                    "net": "GND",
                    "props": {
                        "Pin Number": "9"
                    }
                },
                "10": {
                    "name": "Pin_10",
                    "number": "10",
                    "net": "GND",
                    "props": {
                        "Pin Number": "10"
                    }
                },
                "11": {
                    "name": "Pin_11",
                    "number": "11",
                    "net": "+3V3",
                    "props": {
                        "Pin Number": "11"
                    }
                },
                "12": {
                    "name": "Pin_12",
                    "number": "12",
                    "net": "+3V3",
                    "props": {
                        "Pin Number": "12"
                    }
                }
            }
        },
        "adeb8d5268617f3b": {
            "props": {
                "Add into BOM": "no",
                "Convert to PCB": "yes",
                "Name": "Connector_Generic_Conn_02x06_Odd_Even",
                "Device": "c2e1c8b242838553",
                "Designator": "J7",
                "Footprint": "a328ed0a74d50ff4",
                "Value": "PMOD2",
                "UserDocLink": "",
                "Description": "",
                "ki_keywords": "",
                "ki_fp_filters": "",
                "Symbol": "48dbfcfc896d8280",
                "Comment": "2x6 PMOD-style, 3.3V. Pads only: pin header is hand-fitted later (DNP)",
                "Origin Footprint": "Connector_PinHeader_2.54mm:PinHeader_2x06_P2.54mm_Vertical",
                "Unique ID": "adeb8d5268617f3b",
                "Manufacturer": "",
                "Manufacturer Part": "",
                "Supplier": "",
                "Supplier Part": "1",
                "LCSC": "",
                "Group ID": "",
                "Channel ID": "$2ie902",
                "Reuse Block": "",
                "DeviceName": "Connector_Generic_Conn_02x06_Odd_Even",
                "FootprintName": ""
            },
            "pinInfoMap": {
                "1": {
                    "name": "Pin_1",
                    "number": "1",
                    "net": "P2_0",
                    "props": {
                        "Pin Number": "1"
                    }
                },
                "2": {
                    "name": "Pin_2",
                    "number": "2",
                    "net": "P2_4",
                    "props": {
                        "Pin Number": "2"
                    }
                },
                "3": {
                    "name": "Pin_3",
                    "number": "3",
                    "net": "P2_1",
                    "props": {
                        "Pin Number": "3"
                    }
                },
                "4": {
                    "name": "Pin_4",
                    "number": "4",
                    "net": "P2_5",
                    "props": {
                        "Pin Number": "4"
                    }
                },
                "5": {
                    "name": "Pin_5",
                    "number": "5",
                    "net": "P2_2",
                    "props": {
                        "Pin Number": "5"
                    }
                },
                "6": {
                    "name": "Pin_6",
                    "number": "6",
                    "net": "P2_6",
                    "props": {
                        "Pin Number": "6"
                    }
                },
                "7": {
                    "name": "Pin_7",
                    "number": "7",
                    "net": "P2_3",
                    "props": {
                        "Pin Number": "7"
                    }
                },
                "8": {
                    "name": "Pin_8",
                    "number": "8",
                    "net": "P2_7",
                    "props": {
                        "Pin Number": "8"
                    }
                },
                "9": {
                    "name": "Pin_9",
                    "number": "9",
                    "net": "GND",
                    "props": {
                        "Pin Number": "9"
                    }
                },
                "10": {
                    "name": "Pin_10",
                    "number": "10",
                    "net": "GND",
                    "props": {
                        "Pin Number": "10"
                    }
                },
                "11": {
                    "name": "Pin_11",
                    "number": "11",
                    "net": "+3V3",
                    "props": {
                        "Pin Number": "11"
                    }
                },
                "12": {
                    "name": "Pin_12",
                    "number": "12",
                    "net": "+3V3",
                    "props": {
                        "Pin Number": "12"
                    }
                }
            }
        },
        "3520350cb8a16ddf": {
            "props": {
                "Add into BOM": "yes",
                "Convert to PCB": "yes",
                "Name": "Device_R",
                "Device": "a97793246ea6c736",
                "Designator": "R42",
                "Footprint": "840d5114b71a38b1",
                "Value": "1k",
                "UserDocLink": "",
                "Description": "",
                "ki_keywords": "",
                "ki_fp_filters": "",
                "Symbol": "39525148de9e2e86",
                "LCSC": "C21190",
                "Origin Footprint": "Resistor_SMD:R_0603_1608Metric",
                "Unique ID": "3520350cb8a16ddf",
                "Manufacturer": "",
                "Manufacturer Part": "",
                "Supplier": "LCSC",
                "Supplier Part": "C21190",
                "Comment": "",
                "Group ID": "",
                "Channel ID": "$2ie912",
                "Reuse Block": "",
                "DeviceName": "Device_R",
                "FootprintName": ""
            },
            "pinInfoMap": {
                "1": {
                    "name": "",
                    "number": "1",
                    "net": "F_LED0",
                    "props": {
                        "Pin Number": "1"
                    }
                },
                "2": {
                    "name": "",
                    "number": "2",
                    "net": "LED0_A",
                    "props": {
                        "Pin Number": "2"
                    }
                }
            }
        },
        "aa27cf4c2f614704": {
            "props": {
                "Add into BOM": "yes",
                "Convert to PCB": "yes",
                "Name": "Device_LED",
                "Device": "e9c4f89f11ede94c",
                "Designator": "D5",
                "Footprint": "2eb7b89d891135ec",
                "Value": "LED",
                "UserDocLink": "",
                "Description": "",
                "Sim.Pins": "",
                "ki_keywords": "",
                "ki_fp_filters": "",
                "Symbol": "931fc02699206e06",
                "LCSC": "C2286",
                "Origin Footprint": "LED_SMD:LED_0603_1608Metric",
                "Unique ID": "aa27cf4c2f614704",
                "Manufacturer": "",
                "Manufacturer Part": "",
                "Supplier": "LCSC",
                "Supplier Part": "C2286",
                "Comment": "",
                "Group ID": "",
                "Channel ID": "$2ie922",
                "Reuse Block": "",
                "DeviceName": "Device_LED",
                "FootprintName": ""
            },
            "pinInfoMap": {
                "1": {
                    "name": "K",
                    "number": "1",
                    "net": "GND",
                    "props": {
                        "Pin Number": "1"
                    }
                },
                "2": {
                    "name": "A",
                    "number": "2",
                    "net": "LED0_A",
                    "props": {
                        "Pin Number": "2"
                    }
                }
            }
        },
        "1ad54b734ffff27e": {
            "props": {
                "Add into BOM": "yes",
                "Convert to PCB": "yes",
                "Name": "Device_R",
                "Device": "a97793246ea6c736",
                "Designator": "R43",
                "Footprint": "840d5114b71a38b1",
                "Value": "1k",
                "UserDocLink": "",
                "Description": "",
                "ki_keywords": "",
                "ki_fp_filters": "",
                "Symbol": "39525148de9e2e86",
                "LCSC": "C21190",
                "Origin Footprint": "Resistor_SMD:R_0603_1608Metric",
                "Unique ID": "1ad54b734ffff27e",
                "Manufacturer": "",
                "Manufacturer Part": "",
                "Supplier": "LCSC",
                "Supplier Part": "C21190",
                "Comment": "",
                "Group ID": "",
                "Channel ID": "$2ie932",
                "Reuse Block": "",
                "DeviceName": "Device_R",
                "FootprintName": ""
            },
            "pinInfoMap": {
                "1": {
                    "name": "",
                    "number": "1",
                    "net": "F_LED1",
                    "props": {
                        "Pin Number": "1"
                    }
                },
                "2": {
                    "name": "",
                    "number": "2",
                    "net": "LED1_A",
                    "props": {
                        "Pin Number": "2"
                    }
                }
            }
        },
        "0b466d7a0d9696a1": {
            "props": {
                "Add into BOM": "yes",
                "Convert to PCB": "yes",
                "Name": "Device_LED",
                "Device": "e9c4f89f11ede94c",
                "Designator": "D6",
                "Footprint": "2eb7b89d891135ec",
                "Value": "LED",
                "UserDocLink": "",
                "Description": "",
                "Sim.Pins": "",
                "ki_keywords": "",
                "ki_fp_filters": "",
                "Symbol": "931fc02699206e06",
                "LCSC": "C2286",
                "Origin Footprint": "LED_SMD:LED_0603_1608Metric",
                "Unique ID": "0b466d7a0d9696a1",
                "Manufacturer": "",
                "Manufacturer Part": "",
                "Supplier": "LCSC",
                "Supplier Part": "C2286",
                "Comment": "",
                "Group ID": "",
                "Channel ID": "$2ie942",
                "Reuse Block": "",
                "DeviceName": "Device_LED",
                "FootprintName": ""
            },
            "pinInfoMap": {
                "1": {
                    "name": "K",
                    "number": "1",
                    "net": "GND",
                    "props": {
                        "Pin Number": "1"
                    }
                },
                "2": {
                    "name": "A",
                    "number": "2",
                    "net": "LED1_A",
                    "props": {
                        "Pin Number": "2"
                    }
                }
            }
        },
        "3f1747bc7cd0165c": {
            "props": {
                "Add into BOM": "yes",
                "Convert to PCB": "yes",
                "Name": "Device_R",
                "Device": "a97793246ea6c736",
                "Designator": "R44",
                "Footprint": "840d5114b71a38b1",
                "Value": "1k",
                "UserDocLink": "",
                "Description": "",
                "ki_keywords": "",
                "ki_fp_filters": "",
                "Symbol": "39525148de9e2e86",
                "LCSC": "C21190",
                "Origin Footprint": "Resistor_SMD:R_0603_1608Metric",
                "Unique ID": "3f1747bc7cd0165c",
                "Manufacturer": "",
                "Manufacturer Part": "",
                "Supplier": "LCSC",
                "Supplier Part": "C21190",
                "Comment": "",
                "Group ID": "",
                "Channel ID": "$2ie952",
                "Reuse Block": "",
                "DeviceName": "Device_R",
                "FootprintName": ""
            },
            "pinInfoMap": {
                "1": {
                    "name": "",
                    "number": "1",
                    "net": "F_LED2",
                    "props": {
                        "Pin Number": "1"
                    }
                },
                "2": {
                    "name": "",
                    "number": "2",
                    "net": "LED2_A",
                    "props": {
                        "Pin Number": "2"
                    }
                }
            }
        },
        "61ba849a9213f6b6": {
            "props": {
                "Add into BOM": "yes",
                "Convert to PCB": "yes",
                "Name": "Device_LED",
                "Device": "e9c4f89f11ede94c",
                "Designator": "D7",
                "Footprint": "2eb7b89d891135ec",
                "Value": "LED",
                "UserDocLink": "",
                "Description": "",
                "Sim.Pins": "",
                "ki_keywords": "",
                "ki_fp_filters": "",
                "Symbol": "931fc02699206e06",
                "LCSC": "C2286",
                "Origin Footprint": "LED_SMD:LED_0603_1608Metric",
                "Unique ID": "61ba849a9213f6b6",
                "Manufacturer": "",
                "Manufacturer Part": "",
                "Supplier": "LCSC",
                "Supplier Part": "C2286",
                "Comment": "",
                "Group ID": "",
                "Channel ID": "$2ie962",
                "Reuse Block": "",
                "DeviceName": "Device_LED",
                "FootprintName": ""
            },
            "pinInfoMap": {
                "1": {
                    "name": "K",
                    "number": "1",
                    "net": "GND",
                    "props": {
                        "Pin Number": "1"
                    }
                },
                "2": {
                    "name": "A",
                    "number": "2",
                    "net": "LED2_A",
                    "props": {
                        "Pin Number": "2"
                    }
                }
            }
        },
        "fe3640da4f52432f": {
            "props": {
                "Add into BOM": "yes",
                "Convert to PCB": "yes",
                "Name": "Device_R",
                "Device": "a97793246ea6c736",
                "Designator": "R45",
                "Footprint": "0053beec1f9b605e",
                "Value": "1k",
                "UserDocLink": "",
                "Description": "",
                "ki_keywords": "",
                "ki_fp_filters": "",
                "Symbol": "39525148de9e2e86",
                "LCSC": "C21190",
                "Origin Footprint": "Resistor_SMD:R_0603_1608Metric",
                "Unique ID": "fe3640da4f52432f",
                "Manufacturer": "",
                "Manufacturer Part": "",
                "Supplier": "LCSC",
                "Supplier Part": "C21190",
                "Comment": "",
                "Group ID": "",
                "Channel ID": "$2ie972",
                "Reuse Block": "",
                "DeviceName": "Device_R",
                "FootprintName": ""
            },
            "pinInfoMap": {
                "1": {
                    "name": "",
                    "number": "1",
                    "net": "F_LED3",
                    "props": {
                        "Pin Number": "1"
                    }
                },
                "2": {
                    "name": "",
                    "number": "2",
                    "net": "LED3_A",
                    "props": {
                        "Pin Number": "2"
                    }
                }
            }
        },
        "d726a396729c3148": {
            "props": {
                "Add into BOM": "yes",
                "Convert to PCB": "yes",
                "Name": "Device_LED",
                "Device": "e9c4f89f11ede94c",
                "Designator": "D8",
                "Footprint": "60f63300c7161e95",
                "Value": "LED",
                "UserDocLink": "",
                "Description": "",
                "Sim.Pins": "",
                "ki_keywords": "",
                "ki_fp_filters": "",
                "Symbol": "931fc02699206e06",
                "LCSC": "C2286",
                "Origin Footprint": "LED_SMD:LED_0603_1608Metric",
                "Unique ID": "d726a396729c3148",
                "Manufacturer": "",
                "Manufacturer Part": "",
                "Supplier": "LCSC",
                "Supplier Part": "C2286",
                "Comment": "",
                "Group ID": "",
                "Channel ID": "$2ie982",
                "Reuse Block": "",
                "DeviceName": "Device_LED",
                "FootprintName": ""
            },
            "pinInfoMap": {
                "1": {
                    "name": "K",
                    "number": "1",
                    "net": "GND",
                    "props": {
                        "Pin Number": "1"
                    }
                },
                "2": {
                    "name": "A",
                    "number": "2",
                    "net": "LED3_A",
                    "props": {
                        "Pin Number": "2"
                    }
                }
            }
        },
        "c39dab7994ba8bcb": {
            "props": {
                "Add into BOM": "yes",
                "Convert to PCB": "yes",
                "Name": "Switch_SW_Push",
                "Device": "b83cd3110063c7a1",
                "Designator": "SW1",
                "Footprint": "41f10aa4d5b7be1d",
                "Value": "TS-1187A-B-A-B",
                "UserDocLink": "",
                "Description": "",
                "ki_keywords": "",
                "Symbol": "365f0d2ec177bf48",
                "LCSC": "C318884",
                "Comment": "LCSC/JLC SMT;H1.5mm; custom footprint90deg relative to datasheet: A/B common contacts on CAD left numbered1, C/D on right numbered2. Manufacturer rotation preview required.",
                "Origin Footprint": "carrier:SW_XKB_TS1187A_C318884",
                "Unique ID": "c39dab7994ba8bcb",
                "Manufacturer": "",
                "Manufacturer Part": "",
                "Supplier": "LCSC",
                "Supplier Part": "C318884",
                "Group ID": "",
                "Channel ID": "$2ie992",
                "Reuse Block": "",
                "DeviceName": "Switch_SW_Push",
                "FootprintName": ""
            },
            "pinInfoMap": {
                "1": {
                    "name": "1",
                    "number": "1",
                    "net": "F_BTN0",
                    "props": {
                        "Pin Number": "1"
                    }
                },
                "2": {
                    "name": "2",
                    "number": "2",
                    "net": "GND",
                    "props": {
                        "Pin Number": "2"
                    }
                }
            }
        },
        "5cf9f4a776b330ee": {
            "props": {
                "Add into BOM": "yes",
                "Convert to PCB": "yes",
                "Name": "Switch_SW_Push",
                "Device": "b83cd3110063c7a1",
                "Designator": "SW2",
                "Footprint": "41f10aa4d5b7be1d",
                "Value": "TS-1187A-B-A-B",
                "UserDocLink": "",
                "Description": "",
                "ki_keywords": "",
                "Symbol": "365f0d2ec177bf48",
                "LCSC": "C318884",
                "Comment": "LCSC/JLC SMT;H1.5mm; custom footprint90deg relative to datasheet: A/B common contacts on CAD left numbered1, C/D on right numbered2. Manufacturer rotation preview required.",
                "Origin Footprint": "carrier:SW_XKB_TS1187A_C318884",
                "Unique ID": "5cf9f4a776b330ee",
                "Manufacturer": "",
                "Manufacturer Part": "",
                "Supplier": "LCSC",
                "Supplier Part": "C318884",
                "Group ID": "",
                "Channel ID": "$2ie1003",
                "Reuse Block": "",
                "DeviceName": "Switch_SW_Push",
                "FootprintName": ""
            },
            "pinInfoMap": {
                "1": {
                    "name": "1",
                    "number": "1",
                    "net": "TAB_RST",
                    "props": {
                        "Pin Number": "1"
                    }
                },
                "2": {
                    "name": "2",
                    "number": "2",
                    "net": "GND",
                    "props": {
                        "Pin Number": "2"
                    }
                }
            }
        },
        "2f7d3d657bff299d": {
            "props": {
                "Add into BOM": "yes",
                "Convert to PCB": "yes",
                "Name": "Switch_SW_DIP_x02",
                "Device": "bda7b013bc4879d5",
                "Designator": "SW3",
                "Footprint": "c4db38d9333cd4a8",
                "Value": "DS-02BLP",
                "UserDocLink": "",
                "Description": "",
                "ki_keywords": "",
                "ki_fp_filters": "",
                "Symbol": "05a41a72068ddde2",
                "LCSC": "C692500",
                "Comment": "LCSC/JLC wave-solder candidate; first physical pole only; localCAD1-4, supplier diagram1-3. Both OFF initially=FPGA runs.",
                "Origin Footprint": "carrier:SW_XKB_DS02BLP_C692500",
                "Unique ID": "2f7d3d657bff299d",
                "Manufacturer": "",
                "Manufacturer Part": "",
                "Supplier": "LCSC",
                "Supplier Part": "C692500",
                "Group ID": "",
                "Channel ID": "$2ie1014",
                "Reuse Block": "",
                "DeviceName": "Switch_SW_DIP_x02",
                "FootprintName": ""
            },
            "pinInfoMap": {
                "1": {
                    "name": "",
                    "number": "1",
                    "net": "BUCK_EN",
                    "props": {
                        "Pin Number": "1"
                    }
                },
                "2": {
                    "name": "",
                    "number": "2",
                    "net": "",
                    "props": {
                        "Pin Number": "2"
                    }
                },
                "3": {
                    "name": "",
                    "number": "3",
                    "net": "",
                    "props": {
                        "Pin Number": "3"
                    }
                },
                "4": {
                    "name": "",
                    "number": "4",
                    "net": "GND",
                    "props": {
                        "Pin Number": "4"
                    }
                }
            }
        },
        "5c2e899d33916bcd": {
            "props": {
                "Add into BOM": "no",
                "Convert to PCB": "yes",
                "Name": "Connector_Generic_Conn_01x09",
                "Device": "6e685824e480c80e",
                "Designator": "J8",
                "Footprint": "4e6ea46832b30652",
                "Value": "GPIO pads",
                "UserDocLink": "",
                "Description": "",
                "ki_keywords": "",
                "ki_fp_filters": "",
                "Symbol": "f152dd446c449e54",
                "Comment": "spare FPGA I/O (3.3V, bank 7): pads only, hand-fit a header or wires later",
                "Origin Footprint": "Connector_PinHeader_2.54mm:PinHeader_1x09_P2.54mm_Vertical",
                "Unique ID": "5c2e899d33916bcd",
                "Manufacturer": "",
                "Manufacturer Part": "",
                "Supplier": "",
                "Supplier Part": "1",
                "LCSC": "",
                "Group ID": "",
                "Channel ID": "$2ie1025",
                "Reuse Block": "",
                "DeviceName": "Connector_Generic_Conn_01x09",
                "FootprintName": ""
            },
            "pinInfoMap": {
                "1": {
                    "name": "Pin_1",
                    "number": "1",
                    "net": "+3V3",
                    "props": {
                        "Pin Number": "1"
                    }
                },
                "2": {
                    "name": "Pin_2",
                    "number": "2",
                    "net": "GND",
                    "props": {
                        "Pin Number": "2"
                    }
                },
                "3": {
                    "name": "Pin_3",
                    "number": "3",
                    "net": "GPIO0",
                    "props": {
                        "Pin Number": "3"
                    }
                },
                "4": {
                    "name": "Pin_4",
                    "number": "4",
                    "net": "GPIO1",
                    "props": {
                        "Pin Number": "4"
                    }
                },
                "5": {
                    "name": "Pin_5",
                    "number": "5",
                    "net": "GPIO2",
                    "props": {
                        "Pin Number": "5"
                    }
                },
                "6": {
                    "name": "Pin_6",
                    "number": "6",
                    "net": "GPIO3",
                    "props": {
                        "Pin Number": "6"
                    }
                },
                "7": {
                    "name": "Pin_7",
                    "number": "7",
                    "net": "GPIO4",
                    "props": {
                        "Pin Number": "7"
                    }
                },
                "8": {
                    "name": "Pin_8",
                    "number": "8",
                    "net": "GPIO5",
                    "props": {
                        "Pin Number": "8"
                    }
                },
                "9": {
                    "name": "Pin_9",
                    "number": "9",
                    "net": "GPIO6",
                    "props": {
                        "Pin Number": "9"
                    }
                }
            }
        },
        "0c3ab7284e9cbe73": {
            "props": {
                "Add into BOM": "no",
                "Convert to PCB": "yes",
                "Name": "Mechanical_MountingHole",
                "Device": "5958087f1c0a9016",
                "Designator": "H3",
                "Footprint": "70f4f5fcb23ea21a",
                "Value": "M3",
                "UserDocLink": "",
                "Description": "",
                "ki_keywords": "",
                "ki_fp_filters": "",
                "Symbol": "c8fd7c17f3d69737",
                "Origin Footprint": "MountingHole:MountingHole_3.2mm_M3",
                "Unique ID": "0c3ab7284e9cbe73",
                "Manufacturer": "",
                "Manufacturer Part": "",
                "Supplier": "",
                "Supplier Part": "1",
                "LCSC": "",
                "Comment": "",
                "Group ID": "",
                "Channel ID": "$2ie1035",
                "Reuse Block": "",
                "DeviceName": "Mechanical_MountingHole",
                "FootprintName": ""
            },
            "pinInfoMap": {}
        },
        "a89bd88a2d6d819d": {
            "props": {
                "Add into BOM": "no",
                "Convert to PCB": "yes",
                "Name": "Mechanical_MountingHole",
                "Device": "5958087f1c0a9016",
                "Designator": "H4",
                "Footprint": "70f4f5fcb23ea21a",
                "Value": "M3",
                "UserDocLink": "",
                "Description": "",
                "ki_keywords": "",
                "ki_fp_filters": "",
                "Symbol": "c8fd7c17f3d69737",
                "Origin Footprint": "MountingHole:MountingHole_3.2mm_M3",
                "Unique ID": "a89bd88a2d6d819d",
                "Manufacturer": "",
                "Manufacturer Part": "",
                "Supplier": "",
                "Supplier Part": "1",
                "LCSC": "",
                "Comment": "",
                "Group ID": "",
                "Channel ID": "$2ie1044",
                "Reuse Block": "",
                "DeviceName": "Mechanical_MountingHole",
                "FootprintName": ""
            },
            "pinInfoMap": {}
        },
        "4dda69b6b957e2c3": {
            "props": {
                "Add into BOM": "no",
                "Convert to PCB": "yes",
                "Name": "Mechanical_MountingHole",
                "Device": "5958087f1c0a9016",
                "Designator": "H5",
                "Footprint": "70f4f5fcb23ea21a",
                "Value": "M3",
                "UserDocLink": "",
                "Description": "",
                "ki_keywords": "",
                "ki_fp_filters": "",
                "Symbol": "c8fd7c17f3d69737",
                "Origin Footprint": "MountingHole:MountingHole_3.2mm_M3",
                "Unique ID": "4dda69b6b957e2c3",
                "Manufacturer": "",
                "Manufacturer Part": "",
                "Supplier": "",
                "Supplier Part": "1",
                "LCSC": "",
                "Comment": "",
                "Group ID": "",
                "Channel ID": "$2ie1053",
                "Reuse Block": "",
                "DeviceName": "Mechanical_MountingHole",
                "FootprintName": ""
            },
            "pinInfoMap": {}
        },
        "6434c3db7291b230": {
            "props": {
                "Add into BOM": "no",
                "Convert to PCB": "yes",
                "Name": "Mechanical_MountingHole",
                "Device": "5958087f1c0a9016",
                "Designator": "H6",
                "Footprint": "70f4f5fcb23ea21a",
                "Value": "M3",
                "UserDocLink": "",
                "Description": "",
                "ki_keywords": "",
                "ki_fp_filters": "",
                "Symbol": "c8fd7c17f3d69737",
                "Origin Footprint": "MountingHole:MountingHole_3.2mm_M3",
                "Unique ID": "6434c3db7291b230",
                "Manufacturer": "",
                "Manufacturer Part": "",
                "Supplier": "",
                "Supplier Part": "1",
                "LCSC": "",
                "Comment": "",
                "Group ID": "",
                "Channel ID": "$2ie1062",
                "Reuse Block": "",
                "DeviceName": "Mechanical_MountingHole",
                "FootprintName": ""
            },
            "pinInfoMap": {}
        },
        "4ec783ed4741de1f": {
            "props": {
                "Add into BOM": "yes",
                "Convert to PCB": "yes",
                "Name": "carrier_SN74CB3Q3245",
                "Device": "3e01ddaad5d51619",
                "Designator": "U7",
                "Value": "SN74CB3Q3245PWR",
                "UserDocLink": "",
                "Description": "",
                "ki_keywords": "",
                "ki_fp_filters": "",
                "Origin Footprint": "Package_SO:TSSOP-20_4.4x6.5mm_P0.65mm",
                "Symbol": "b1af5c630e66bb8f",
                "LCSC": "C470961",
                "Comment": "Ioff protected 8-bit passive bus switch; OE pulled high by default",
                "Unique ID": "4ec783ed4741de1f",
                "Manufacturer": "",
                "Manufacturer Part": "",
                "Supplier": "LCSC",
                "Supplier Part": "C470961",
                "Footprint": "aba8afa3fc1c660b",
                "Group ID": "",
                "Channel ID": "$2ie1071",
                "Reuse Block": "",
                "DeviceName": "carrier_SN74CB3Q3245",
                "FootprintName": ""
            },
            "pinInfoMap": {
                "1": {
                    "name": "NC",
                    "number": "1",
                    "net": "",
                    "props": {
                        "Pin Number": "1"
                    }
                },
                "2": {
                    "name": "A1",
                    "number": "2",
                    "net": "M_CLK",
                    "props": {
                        "Pin Number": "2"
                    }
                },
                "3": {
                    "name": "A2",
                    "number": "3",
                    "net": "M_AUX0",
                    "props": {
                        "Pin Number": "3"
                    }
                },
                "4": {
                    "name": "A3",
                    "number": "4",
                    "net": "M_RDY",
                    "props": {
                        "Pin Number": "4"
                    }
                },
                "5": {
                    "name": "A4",
                    "number": "5",
                    "net": "M_D0",
                    "props": {
                        "Pin Number": "5"
                    }
                },
                "6": {
                    "name": "A5",
                    "number": "6",
                    "net": "M_AUX1",
                    "props": {
                        "Pin Number": "6"
                    }
                },
                "7": {
                    "name": "A6",
                    "number": "7",
                    "net": "M_D1",
                    "props": {
                        "Pin Number": "7"
                    }
                },
                "8": {
                    "name": "A7",
                    "number": "8",
                    "net": "M_D2",
                    "props": {
                        "Pin Number": "8"
                    }
                },
                "9": {
                    "name": "A8",
                    "number": "9",
                    "net": "M_AUX2",
                    "props": {
                        "Pin Number": "9"
                    }
                },
                "10": {
                    "name": "GND",
                    "number": "10",
                    "net": "GND",
                    "props": {
                        "Pin Number": "10"
                    }
                },
                "11": {
                    "name": "B8",
                    "number": "11",
                    "net": "ISO_AUX2",
                    "props": {
                        "Pin Number": "11"
                    }
                },
                "12": {
                    "name": "B7",
                    "number": "12",
                    "net": "ISO_D2",
                    "props": {
                        "Pin Number": "12"
                    }
                },
                "13": {
                    "name": "B6",
                    "number": "13",
                    "net": "ISO_D1",
                    "props": {
                        "Pin Number": "13"
                    }
                },
                "14": {
                    "name": "B5",
                    "number": "14",
                    "net": "ISO_AUX1",
                    "props": {
                        "Pin Number": "14"
                    }
                },
                "15": {
                    "name": "B4",
                    "number": "15",
                    "net": "ISO_D0",
                    "props": {
                        "Pin Number": "15"
                    }
                },
                "16": {
                    "name": "B3",
                    "number": "16",
                    "net": "ISO_RDY",
                    "props": {
                        "Pin Number": "16"
                    }
                },
                "17": {
                    "name": "B2",
                    "number": "17",
                    "net": "ISO_AUX0",
                    "props": {
                        "Pin Number": "17"
                    }
                },
                "18": {
                    "name": "B1",
                    "number": "18",
                    "net": "ISO_CLK",
                    "props": {
                        "Pin Number": "18"
                    }
                },
                "19": {
                    "name": "~OE~",
                    "number": "19",
                    "net": "BUS_OE_N",
                    "props": {
                        "Pin Number": "19"
                    }
                },
                "20": {
                    "name": "VCC",
                    "number": "20",
                    "net": "+3V3",
                    "props": {
                        "Pin Number": "20"
                    }
                }
            }
        },
        "97d7532320e593d5": {
            "props": {
                "Add into BOM": "yes",
                "Convert to PCB": "yes",
                "Name": "Device_C",
                "Device": "473c964471ccd458",
                "Designator": "C20",
                "Footprint": "28b242f2aa997a49",
                "Value": "100n",
                "UserDocLink": "",
                "Description": "",
                "ki_keywords": "",
                "ki_fp_filters": "",
                "Symbol": "ab503096c520ae9c",
                "LCSC": "C14663",
                "Origin Footprint": "Capacitor_SMD:C_0603_1608Metric",
                "Unique ID": "97d7532320e593d5",
                "Manufacturer": "",
                "Manufacturer Part": "",
                "Supplier": "LCSC",
                "Supplier Part": "C14663",
                "Comment": "",
                "Group ID": "",
                "Channel ID": "$2ie1082",
                "Reuse Block": "",
                "DeviceName": "Device_C",
                "FootprintName": ""
            },
            "pinInfoMap": {
                "1": {
                    "name": "",
                    "number": "1",
                    "net": "+3V3",
                    "props": {
                        "Pin Number": "1"
                    }
                },
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
