airpocket-soundman/tab5-tang-primer20k-carrier/site/img/evaluation/mechanical/lite-a-dual-clearance.png

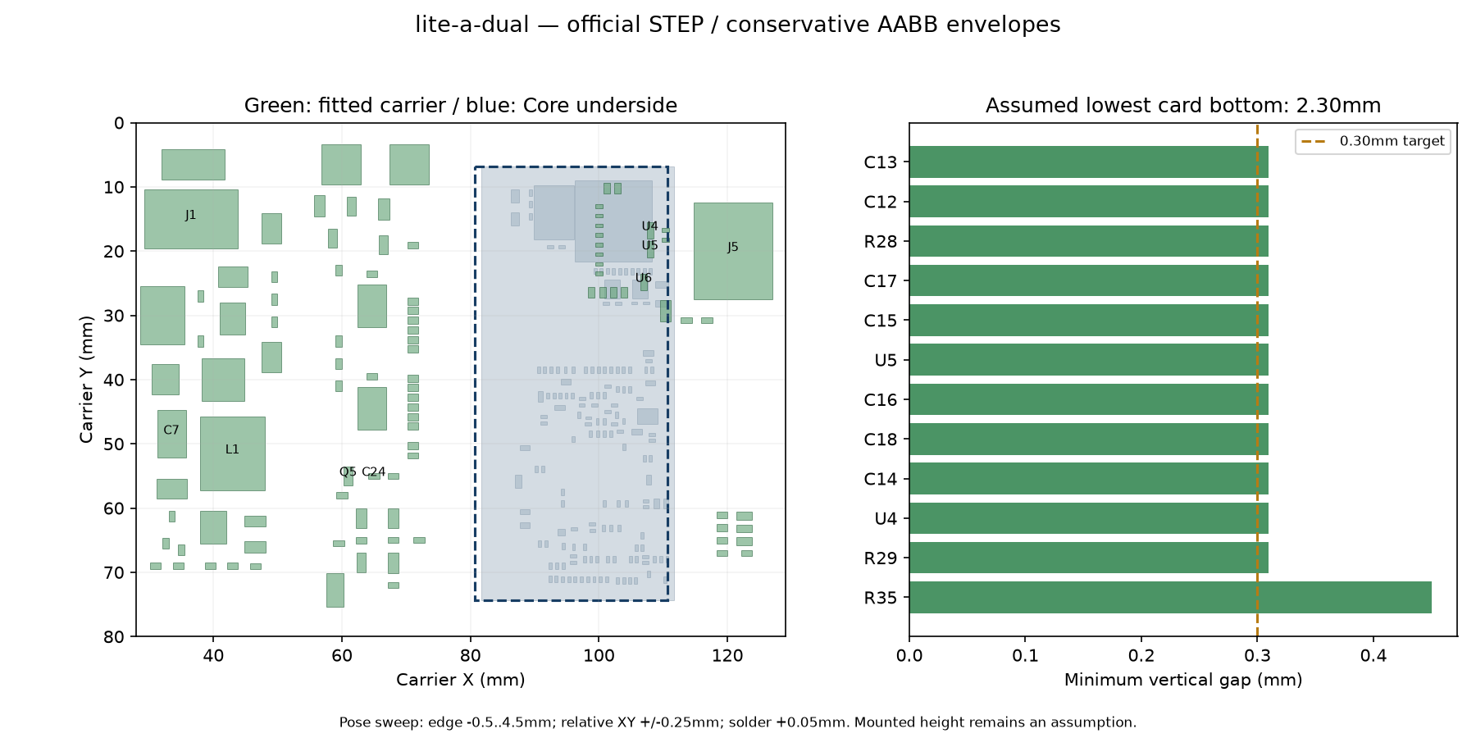
site/img/evaluation/mechanical/lite-a-dual-clearance.png
