airpocket-soundman/tab5-tang-primer20k-carrier/site/img/sim_compare_r3.png

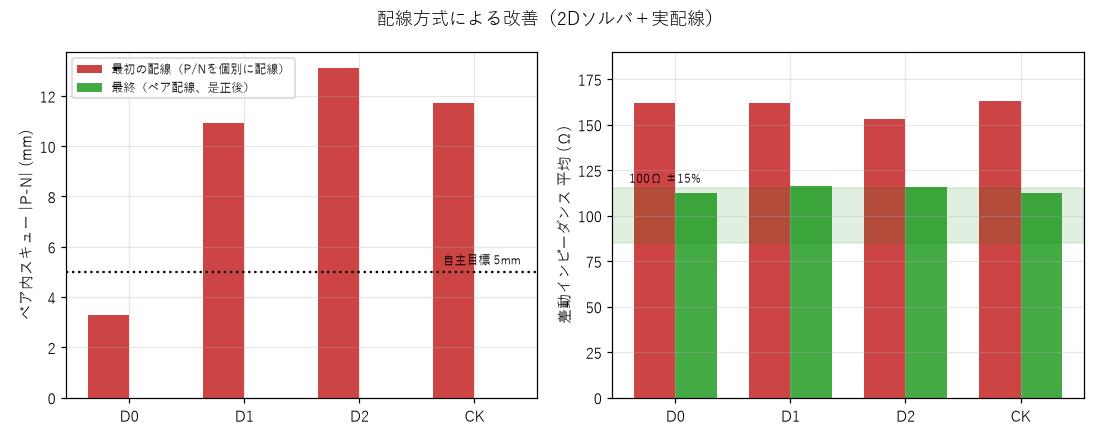
site/img/sim_compare_r3.png
