airpocket-soundman/tab5-tang-primer20k-carrier/site/img/sim_route.png

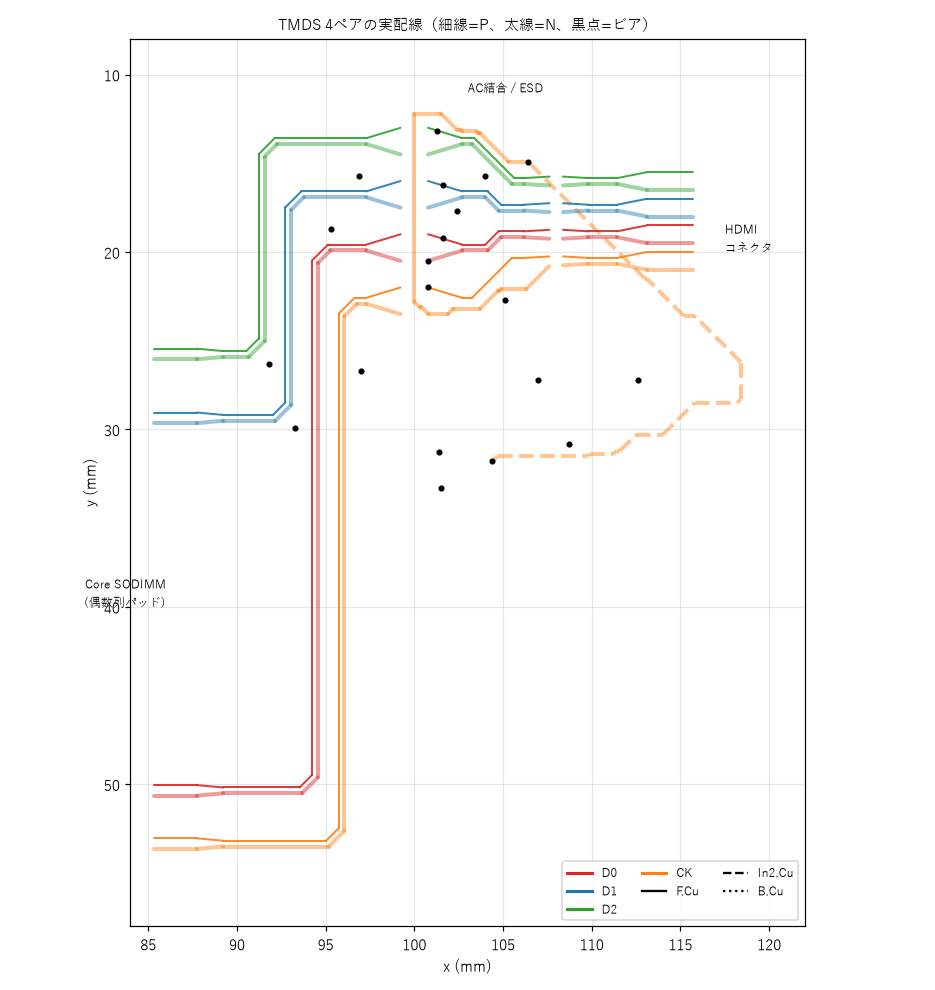
site/img/sim_route.png
