airpocket-soundman/tab5-tang-primer20k-carrier/site/img/sim_sparam_r2.png

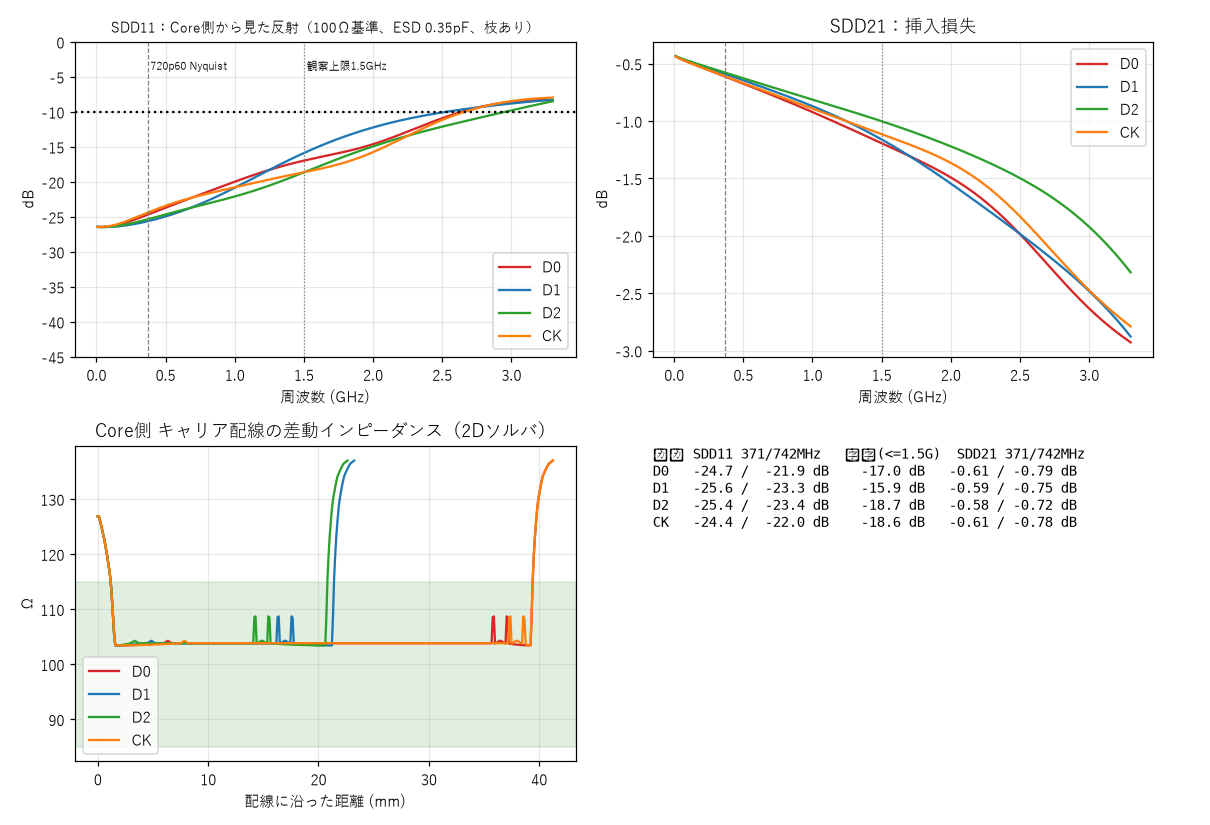
site/img/sim_sparam_r2.png
