airpocket-soundman/tab5-tang-primer20k-carrier/spark/application/coupon-evidence/2026-10-26-full-1852/03-pcba-price-breakdown-loading.png

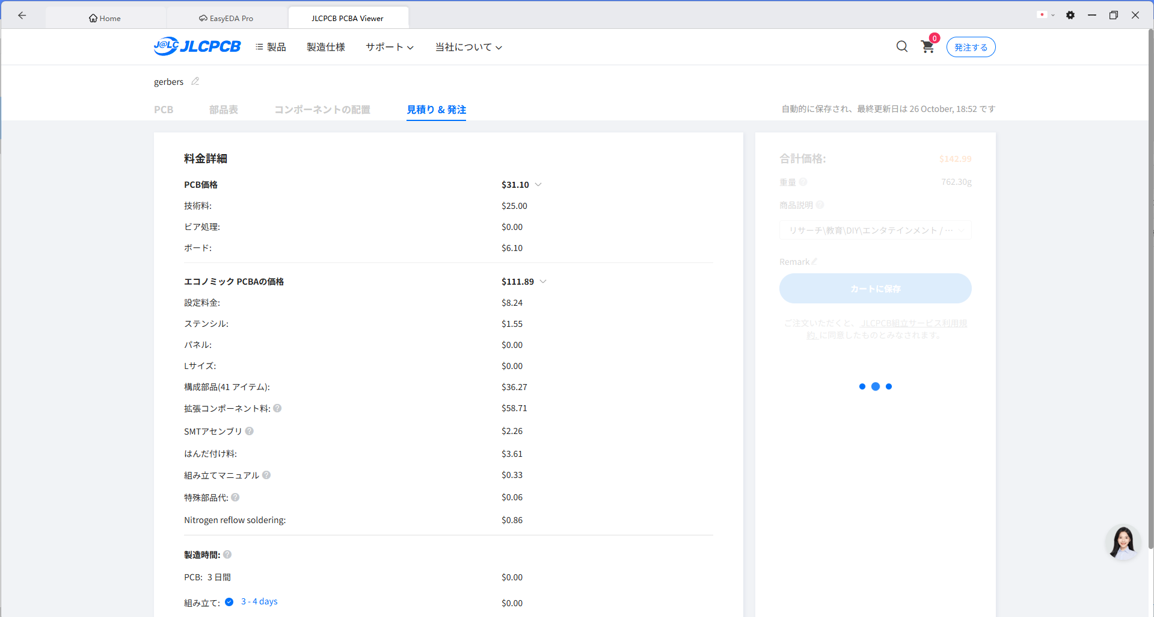
spark/application/coupon-evidence/2026-10-26-full-1852/03-pcba-price-breakdown-loading.png
