airpocket-soundman/tab5-tang-primer20k-carrier/spark/design/layout.png

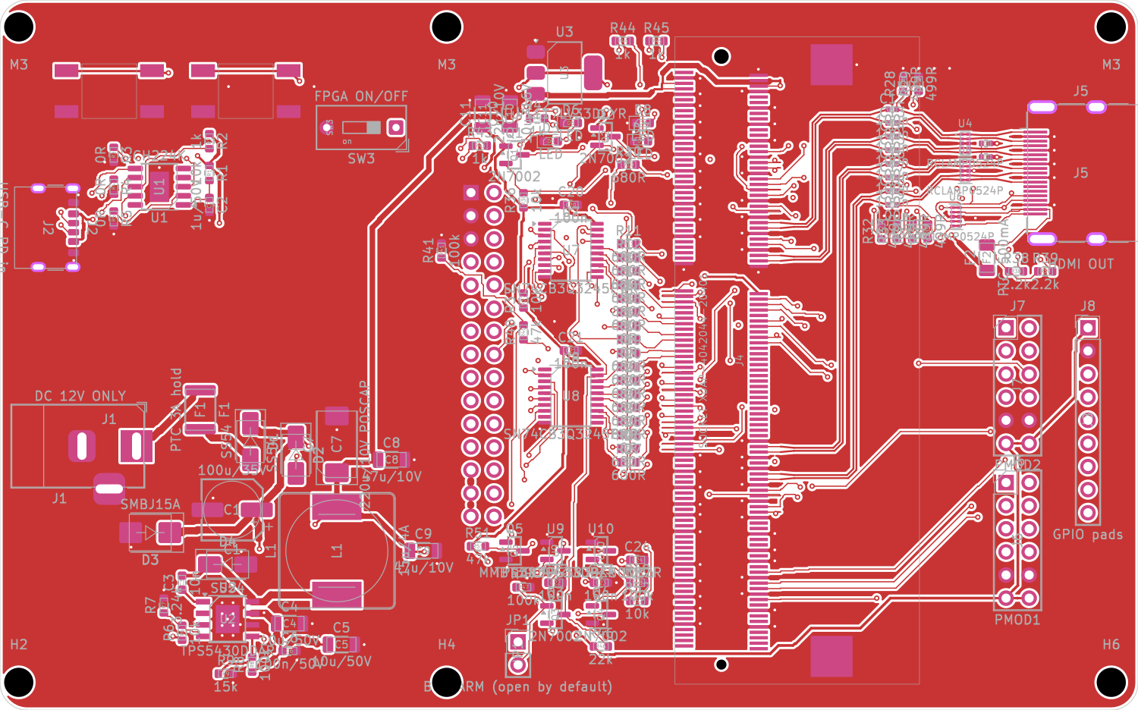
spark/design/layout.png
