airpocket-soundman/tab5-tang-primer20k-carrier/spark/simulation/easyeda-wasm/power-waveform-comparison.png

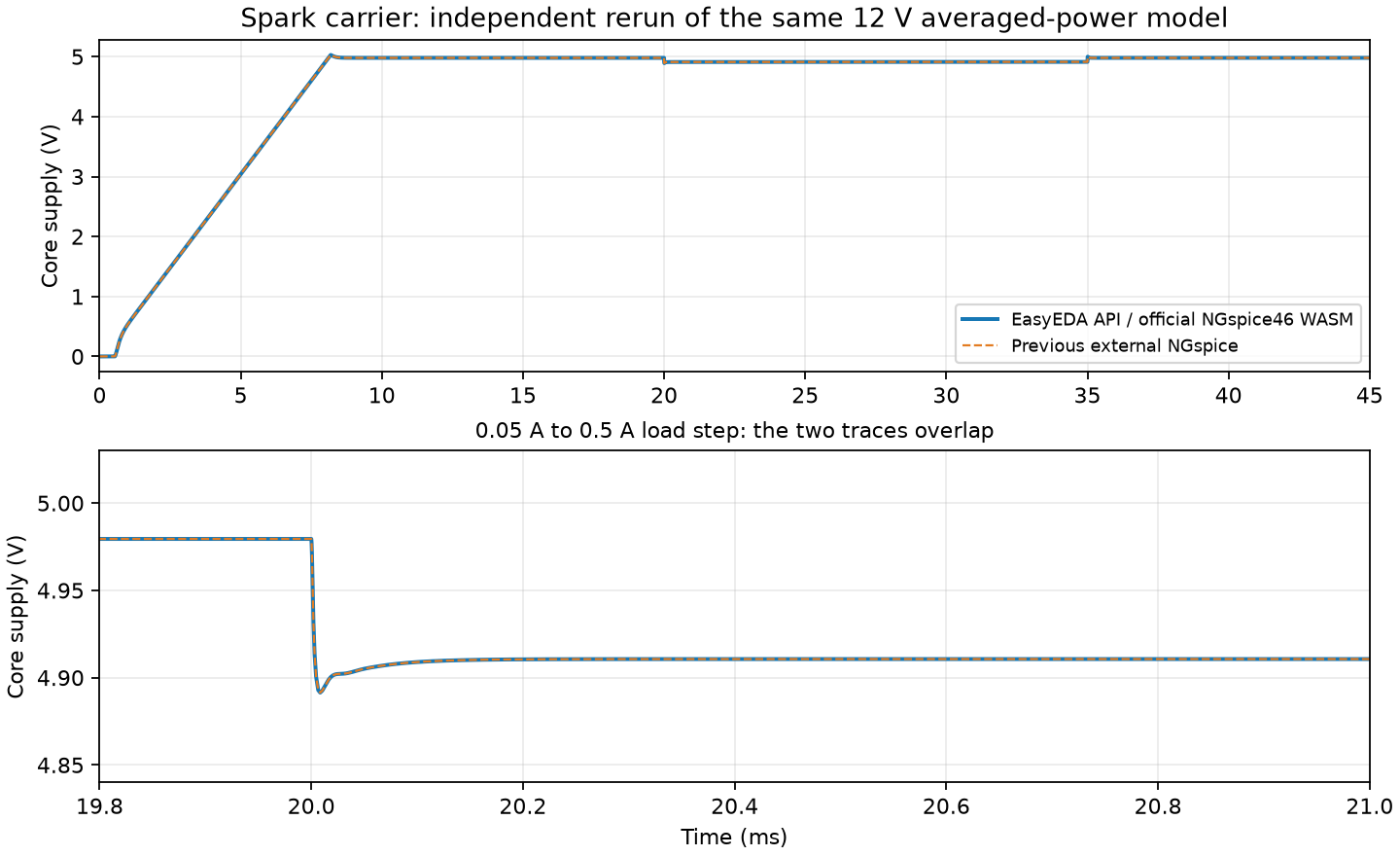
spark/simulation/easyeda-wasm/power-waveform-comparison.png
