airpocket-soundman/tab5-tang-primer20k-carrier/variants/simulation/hdmi/ddr_nc_loading.png

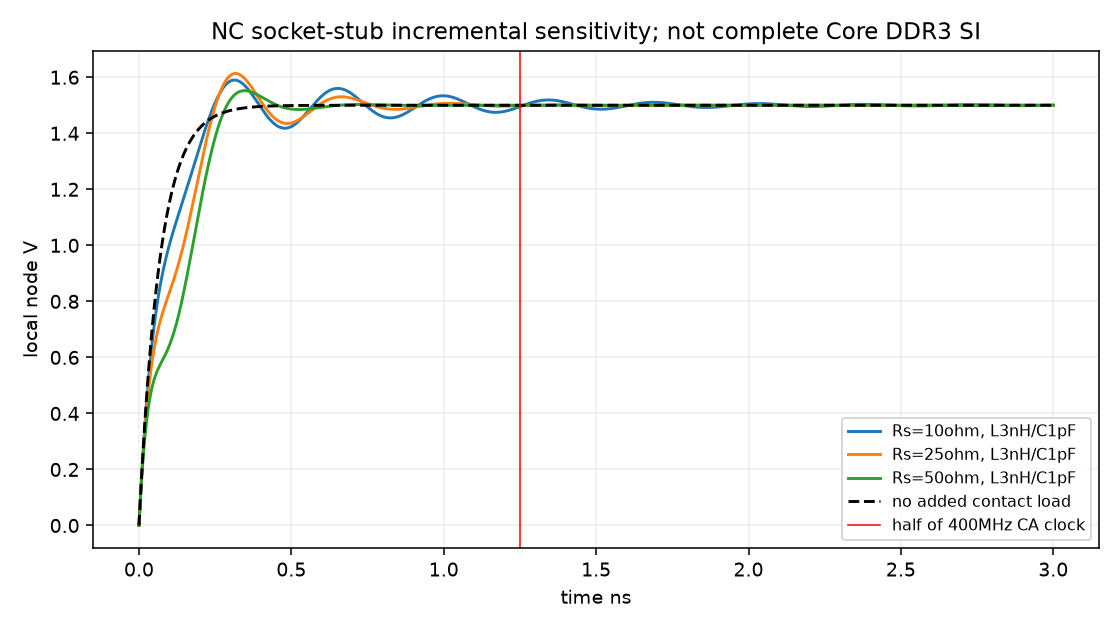
variants/simulation/hdmi/ddr_nc_loading.png
