airpocket-soundman/tab5-tang-primer20k-carrier/variants/simulation/hdmi/hpd/hpd_transient.png

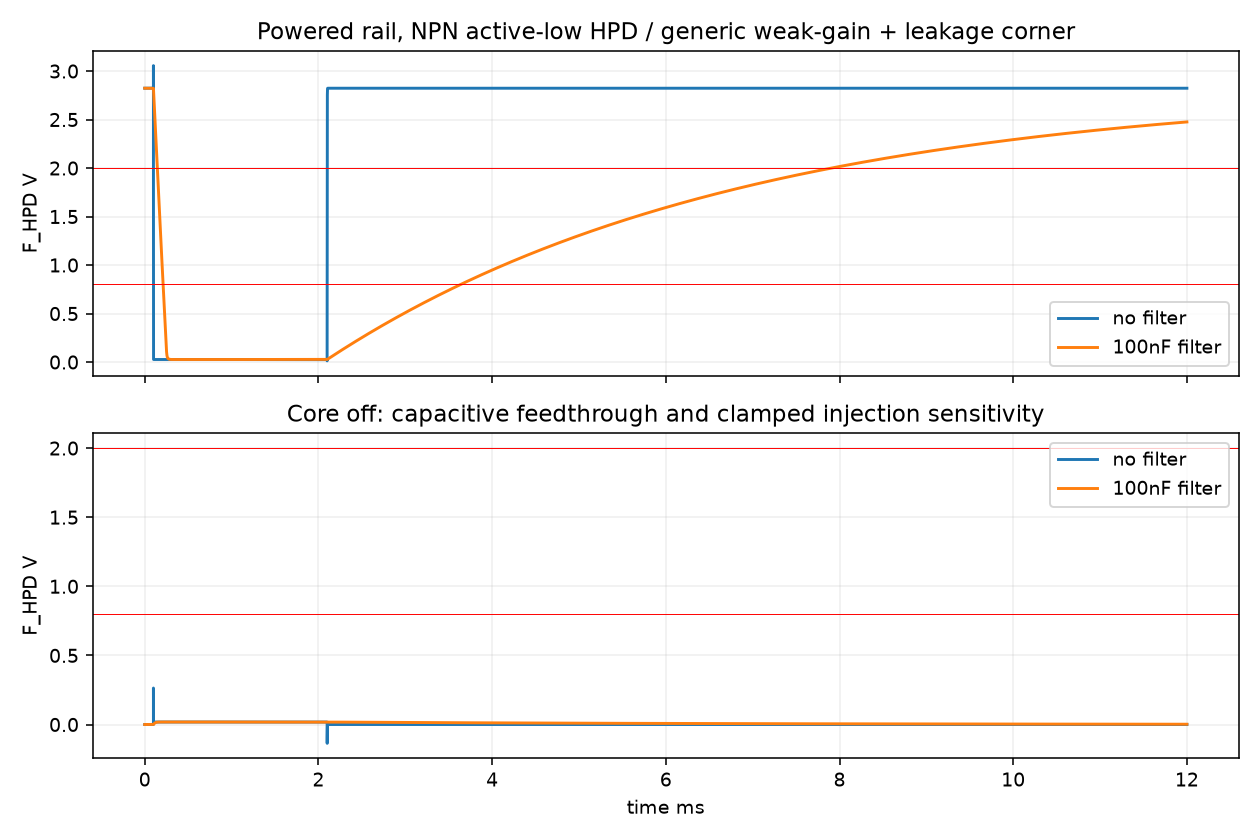
variants/simulation/hdmi/hpd/hpd_transient.png
