airpocket-soundman/tab5-tang-primer20k-carrier/variants/simulation/parallel/lite-a-dual-damping.png

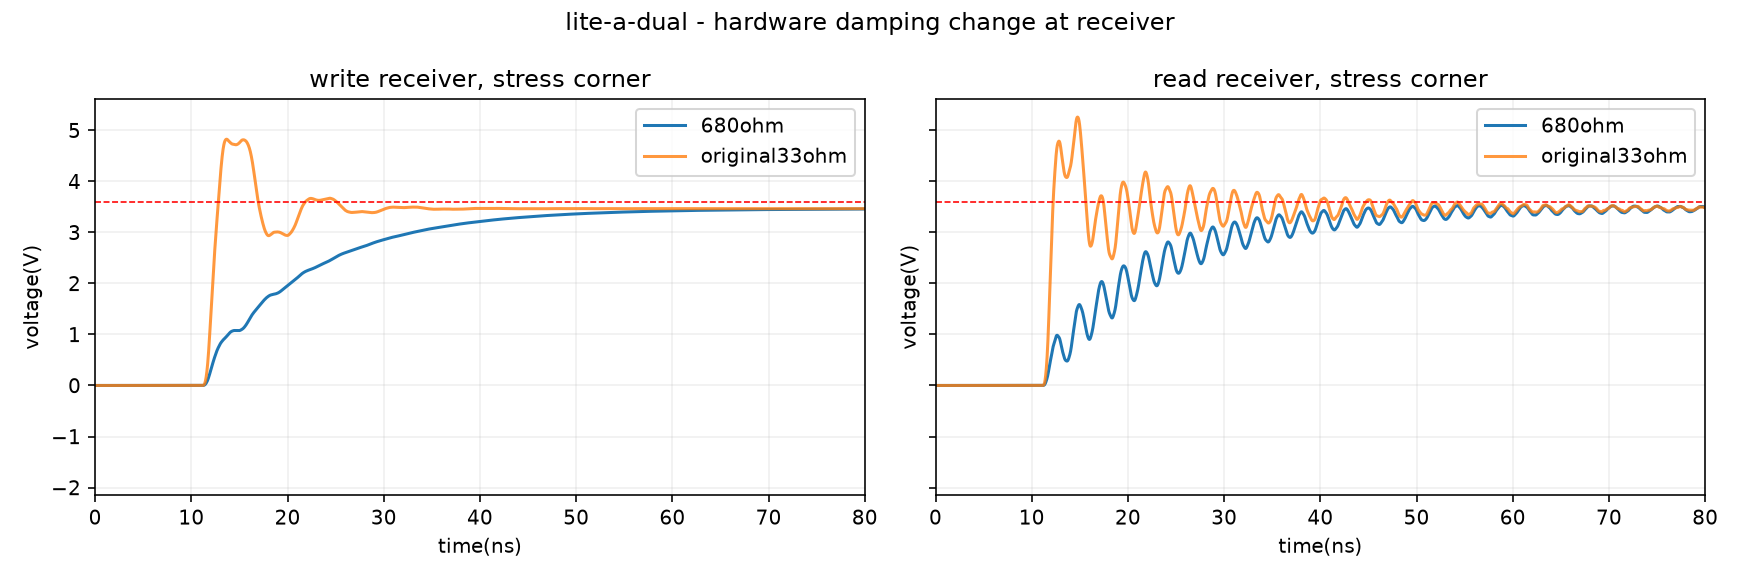
variants/simulation/parallel/lite-a-dual-damping.png
