airpocket-soundman/tab5-tang-primer20k-carrier/spark/design/akizuki-purchase-plan.csv

reference | part | akizuki_code | url | needed_for_two_boards | purchase_units | status | notes
J1 | MJ-179PH | 106568 | https://akizukidenshi.com/catalog/g/g106568/ | 2 | 2 pieces | CAD_ADAPTED_PHYSICAL_FIT_PENDING | Manufacturer-derived custom slots and polarity checked in KiCad and native export; center-positive stabilized12V
SW3 | KSD22 | 108922 | https://akizukidenshi.com/catalog/g/g108922/ | 2 | 2 pieces | CAD_ADAPTED_PHYSICAL_FIT_PENDING | Custom4-pad footprint and schematic; pole1 closes BUCK_EN to GND to stop FPGA; pole2 unused; both open initially
J3 | PH-2x40SG | 100082 | https://akizukidenshi.com/catalog/g/g100082/ | 2 sections of 2x15 | 1 piece | CANDIDATE_MECHANICAL_REVIEW | Two 15-row sections from one 40-row header; allow cutting loss; check Tab5 mating height
JP1 | PH-1x40SG | 100167 | https://akizukidenshi.com/catalog/g/g100167/ | 2 sections of 1x2 | 1 piece | CANDIDATE_MECHANICAL_REVIEW | Cut two 2-pin sections; fit and orientation review before release
JP1 accessory | 2228AG | 103878 | https://akizukidenshi.com/catalog/g/g103878/ | 2 shunts | 1 pack of 20 | KEEP_UNFITTED_INITIALLY | Only pack size available; supplied separately and BUS ARM initially open
Mechanical | M3 hardware | TBD |  | TBD | TBD | ENCLOSURE_DIMENSIONS_PENDING | Purchase from Akizuki after enclosure and spacer lengths are fixed; do not substitute another shop
