airpocket-soundman/tab5-tang-primer20k-carrier/spark/lcsc-priority/lcsc-all-board-parts.csv

LCSC | Quantity per board | Quantity for two boards | References | Value | Assembly preference | URL
C381116 | 1 | 2 | J1 | DC-005-5A-2.0 | JLCPCB assembly; fallback direct LCSC purchase if accepted by design | https://www.lcsc.com/product-detail/C381116.html
C47002391 | 1 | 2 | F1 | PTC 3A hold | JLCPCB assembly; fallback direct LCSC purchase if accepted by design | https://www.lcsc.com/product-detail/C47002391.html
C22452 | 3 | 6 | D1,D2,D4 | SS54 | JLCPCB assembly; fallback direct LCSC purchase if accepted by design | https://www.lcsc.com/product-detail/C22452.html
C699013 | 1 | 2 | D3 | SMBJ15A | JLCPCB assembly; fallback direct LCSC purchase if accepted by design | https://www.lcsc.com/product-detail/C699013.html
C2983388 | 1 | 2 | C1 | 100u/35V | JLCPCB assembly; fallback direct LCSC purchase if accepted by design | https://www.lcsc.com/product-detail/C2983388.html
C5246813 | 1 | 2 | J2 | USB-C PD in | JLCPCB assembly; fallback direct LCSC purchase if accepted by design | https://www.lcsc.com/product-detail/C5246813.html
C970725 | 1 | 2 | U1 | CH224K | JLCPCB assembly; fallback direct LCSC purchase if accepted by design | https://www.lcsc.com/product-detail/C970725.html
C25804 | 5 | 10 | R1,R36,R37,R52,R6 | 10k | JLCPCB assembly; fallback direct LCSC purchase if accepted by design | https://www.lcsc.com/product-detail/C25804.html
C15849 | 1 | 2 | C2 | 1u/50V | JLCPCB assembly; fallback direct LCSC purchase if accepted by design | https://www.lcsc.com/product-detail/C15849.html
C21190 | 5 | 10 | R2,R42,R43,R44,R45 | 1k | JLCPCB assembly; fallback direct LCSC purchase if accepted by design | https://www.lcsc.com/product-detail/C21190.html
C21189 | 2 | 4 | R3,R5 | 0R | JLCPCB assembly; fallback direct LCSC purchase if accepted by design | https://www.lcsc.com/product-detail/C21189.html
C9864 | 1 | 2 | U2 | TPS5430DDAR | JLCPCB assembly; fallback direct LCSC purchase if accepted by design | https://www.lcsc.com/product-detail/C9864.html
C57112 | 1 | 2 | C3 | 10n | JLCPCB assembly; fallback direct LCSC purchase if accepted by design | https://www.lcsc.com/product-detail/C57112.html
C2041333 | 1 | 2 | L1 | 15u/4A | JLCPCB assembly; fallback direct LCSC purchase if accepted by design | https://www.lcsc.com/product-detail/C2041333.html
C22994 | 1 | 2 | R7 | 3.24k | JLCPCB assembly; fallback direct LCSC purchase if accepted by design | https://www.lcsc.com/product-detail/C22994.html
C25803 | 4 | 8 | R41,R47,R48,R8 | 100k | JLCPCB assembly; fallback direct LCSC purchase if accepted by design | https://www.lcsc.com/product-detail/C25803.html
C22809 | 1 | 2 | R9 | 15k | JLCPCB assembly; fallback direct LCSC purchase if accepted by design | https://www.lcsc.com/product-detail/C22809.html
C13585 | 2 | 4 | C4,C5 | 10u/50V | JLCPCB assembly; fallback direct LCSC purchase if accepted by design | https://www.lcsc.com/product-detail/C13585.html
C14663 | 1 | 2 | C6 | 100n/50V | JLCPCB assembly; fallback direct LCSC purchase if accepted by design | https://www.lcsc.com/product-detail/C14663.html
C242173 | 1 | 2 | C7 | 220u/10V POSCAP | JLCPCB assembly; fallback direct LCSC purchase if accepted by design | https://www.lcsc.com/product-detail/C242173.html
C15578 | 1 | 2 | U3 | TLV1117LV33DCYR | JLCPCB assembly; fallback direct LCSC purchase if accepted by design | https://www.lcsc.com/product-detail/C15578.html
C13585 | 1 | 2 | C10 | 10u/16V | JLCPCB assembly; fallback direct LCSC purchase if accepted by design | https://www.lcsc.com/product-detail/C13585.html
C12891 | 1 | 2 | C11 | 22u/10V | JLCPCB assembly; fallback direct LCSC purchase if accepted by design | https://www.lcsc.com/product-detail/C12891.html
C56496 | 1 | 2 | J3 | 2.54-2*15P | JLCPCB assembly; fallback direct LCSC purchase if accepted by design | https://www.lcsc.com/product-detail/C56496.html
C23228 | 15 | 30 | R10,R11,R12,R13,R14,R15,R16,R19,R20,R21,R22,R23,R24,R26,R27 | 680R | JLCPCB assembly; fallback direct LCSC purchase if accepted by design | https://www.lcsc.com/product-detail/C23228.html
C22471982 | 1 | 2 | J4 | SOCKET XDAP-4042044-20401 | JLCPCB assembly; fallback direct LCSC purchase if accepted by design | https://www.lcsc.com/product-detail/C22471982.html
C916313 | 1 | 2 | J5 | HDMI OUT | JLCPCB assembly; fallback direct LCSC purchase if accepted by design | https://www.lcsc.com/product-detail/C916313.html
C1525 | 8 | 16 | C12,C13,C14,C15,C16,C17,C18,C19 | 100n | JLCPCB assembly; fallback direct LCSC purchase if accepted by design | https://www.lcsc.com/product-detail/C1525.html
C23065 | 6 | 12 | R28,R29,R32,R33,R34,R35 | 499R | JLCPCB assembly; fallback direct LCSC purchase if accepted by design | https://www.lcsc.com/product-detail/C23065.html
C4125 | 2 | 4 | R30,R31 | 499R | JLCPCB assembly; fallback direct LCSC purchase if accepted by design | https://www.lcsc.com/product-detail/C4125.html
C293965 | 3 | 6 | U4,U5,U6 | RCLAMP0524P | JLCPCB assembly; fallback direct LCSC purchase if accepted by design | https://www.lcsc.com/product-detail/C293965.html
C315893 | 1 | 2 | F2 | PTC 500mA | JLCPCB assembly; fallback direct LCSC purchase if accepted by design | https://www.lcsc.com/product-detail/C315893.html
C8545 | 4 | 8 | Q1,Q2,Q3,Q4 | 2N7002 | JLCPCB assembly; fallback direct LCSC purchase if accepted by design | https://www.lcsc.com/product-detail/C8545.html
C4190 | 2 | 4 | R38,R39 | 2.2k | JLCPCB assembly; fallback direct LCSC purchase if accepted by design | https://www.lcsc.com/product-detail/C4190.html
C25819 | 2 | 4 | R40,R51 | 47k | JLCPCB assembly; fallback direct LCSC purchase if accepted by design | https://www.lcsc.com/product-detail/C25819.html
C2286 | 4 | 8 | D5,D6,D7,D8 | LED | JLCPCB assembly; fallback direct LCSC purchase if accepted by design | https://www.lcsc.com/product-detail/C2286.html
C480272 | 2 | 4 | SW1,SW2 | TS-1102S-B-D-B | JLCPCB assembly; fallback direct LCSC purchase if accepted by design | https://www.lcsc.com/product-detail/C480272.html
C692500 | 1 | 2 | SW3 | DS-02BLP | JLCPCB assembly; fallback direct LCSC purchase if accepted by design | https://www.lcsc.com/product-detail/C692500.html
C470961 | 2 | 4 | U7,U8 | SN74CB3Q3245PWR | JLCPCB assembly; fallback direct LCSC purchase if accepted by design | https://www.lcsc.com/product-detail/C470961.html
C14663 | 5 | 10 | C20,C21,C22,C23,C24 | 100n | JLCPCB assembly; fallback direct LCSC purchase if accepted by design | https://www.lcsc.com/product-detail/C14663.html
C485802 | 1 | 2 | U9 | TPS3839G33DBZR | JLCPCB assembly; fallback direct LCSC purchase if accepted by design | https://www.lcsc.com/product-detail/C485802.html
C702204 | 1 | 2 | U10 | TPS3839K50DBZR | JLCPCB assembly; fallback direct LCSC purchase if accepted by design | https://www.lcsc.com/product-detail/C702204.html
C124375 | 1 | 2 | JP1 | B-2100S02P-A110 | JLCPCB assembly; fallback direct LCSC purchase if accepted by design | https://www.lcsc.com/product-detail/C124375.html
C31850 | 1 | 2 | R46 | 22k | JLCPCB assembly; fallback direct LCSC purchase if accepted by design | https://www.lcsc.com/product-detail/C31850.html
C20526 | 1 | 2 | Q5 | MMBT3904 | JLCPCB assembly; fallback direct LCSC purchase if accepted by design | https://www.lcsc.com/product-detail/C20526.html
