airpocket-soundman/tab5-tang-primer20k-carrier/spark/lcsc-priority/lcsc-manual-fallback-purchase.csv

Reference | LCSC | MPN | Needed for two boards | Minimum | Multiple | Purchase quantity | Unit USD snapshot | Subtotal USD snapshot | Stock snapshot | URL | Action
J1 | C381116 | DC-005-5A-2.0 | 2 | 5 | 5 | 5 | 0.2633 | 1.3165 | 10590 | https://www.lcsc.com/product-detail/C381116.html | Only if JLCPCB declines assembly; do not double-buy
J3 | C56496 | 2.54-2*15P | 2 | 5 | 5 | 5 | 0.1666 | 0.833 | 9005 | https://www.lcsc.com/product-detail/C56496.html | Only if JLCPCB declines assembly; do not double-buy
JP1 | C124375 | B-2100S02P-A110 | 2 | 20 | 20 | 20 | 0.0302 | 0.604 | 123300 | https://www.lcsc.com/product-detail/C124375.html | Only if JLCPCB declines assembly; do not double-buy
SW3 | C692500 | DS-02BLP | 2 | 5 | 5 | 5 | 0.4588 | 2.294 | 80 | https://www.lcsc.com/product-detail/C692500.html | Only if JLCPCB declines assembly; do not double-buy
JP1 accessory | C5305 | 2.54 | 2 | 50 | 50 | 50 | 0.0099 | 0.495 | 679300 | https://www.lcsc.com/product-detail/C5305.html | Always separate; initially absent
