airpocket-soundman/tab5-tang-primer20k-carrier/spark/single-sided-r4/quotation-2026-10-26/full/manual-purchase.csv

Designator | LCSC Part # | Qty per board | Assembly
J3 | C56496 | 1 | Manual soldering; bottom mating orientation
