airpocket-soundman/tab5-tang-primer20k-carrier/spark/single-sided-r4/full/design/manufacturing/spark-lcsc-review-single-sided-r4-2026-10-26/manual-assembly.csv

Refs | Value | Footprint | Action
J3 | 2.54-2*15P | carrier:PinHeader_2x15_Tab5_Bottom | manual / not in PCBA
H1,H2,H3,H4,H5,H6 | M3 | MountingHole:MountingHole_3.2mm_M3 | manual / not in PCBA
