airpocket-soundman/tab5-tang-primer20k-carrier/variants/lite-c-dnp/population-policy.csv

Reference | Action | Scope
C12 | DNP - retain circuit and footprint | HDMI
C13 | DNP - retain circuit and footprint | HDMI
C14 | DNP - retain circuit and footprint | HDMI
C15 | DNP - retain circuit and footprint | HDMI
C16 | DNP - retain circuit and footprint | HDMI
C17 | DNP - retain circuit and footprint | HDMI
C18 | DNP - retain circuit and footprint | HDMI
C19 | DNP - retain circuit and footprint | HDMI
C2 | DNP - retain circuit and footprint | USB PD
D2 | DNP - retain circuit and footprint | USB PD
F2 | DNP - retain circuit and footprint | HDMI
J2 | DNP - retain circuit and footprint | USB PD
J5 | DNP - retain circuit and footprint | HDMI
Q1 | DNP - retain circuit and footprint | HDMI
Q2 | DNP - retain circuit and footprint | HDMI
R1 | DNP - retain circuit and footprint | USB PD
R2 | DNP - retain circuit and footprint | USB PD
R28 | DNP - retain circuit and footprint | HDMI
R29 | DNP - retain circuit and footprint | HDMI
R3 | DNP - retain circuit and footprint | USB PD
R30 | DNP - retain circuit and footprint | HDMI
R31 | DNP - retain circuit and footprint | HDMI
R32 | DNP - retain circuit and footprint | HDMI
R33 | DNP - retain circuit and footprint | HDMI
R34 | DNP - retain circuit and footprint | HDMI
R35 | DNP - retain circuit and footprint | HDMI
R36 | DNP - retain circuit and footprint | HDMI
R37 | DNP - retain circuit and footprint | HDMI
R38 | DNP - retain circuit and footprint | HDMI
R39 | DNP - retain circuit and footprint | HDMI
R4 | DNP - retain circuit and footprint | USB PD
R40 | DNP - retain circuit and footprint | HDMI
R41 | DNP - retain circuit and footprint | HDMI
R5 | DNP - retain circuit and footprint | USB PD
U1 | DNP - retain circuit and footprint | USB PD
U4 | DNP - retain circuit and footprint | HDMI
U5 | DNP - retain circuit and footprint | HDMI
U6 | DNP - retain circuit and footprint | HDMI
Q5 | DNP - retain circuit and footprint | HDMI
R51 | DNP - retain circuit and footprint | HDMI
R52 | DNP - retain circuit and footprint | HDMI
C24 | DNP - retain circuit and footprint | HDMI
