airpocket-soundman/tab5-tang-primer20k-carrier/cost-study/2026-10-25/廉価版コスト比較と調達案.md

# 廉価版の費用比較とソケット調達案

2026年10月25日。現行d93af0bの回路・基板・BOM・発注データは変更していない。これは別版を設計する前の費用比較であり、新しい回路図・配線・製造データは作成していない。

推奨案は、基本部品化を先に進め、PD入力へ統一、HDMI回路は残して未実装、99×78mmを配置検討の目標とする組み合わせ。パラレル通信、電源断時の信号隔離、両電源監視、Core上DDR3へのアクセス条件を保つ。ソケットは必ずPCBA実装する。

## 見積もりの基準

すべてUSD、5枚合計。送料・税・Core本体・手実装部品・ACアダプタは別。個別案はJLCPCBへ再見積もりを送信した価格ではなく、提供された見積書を基にした比較計算である。

| 項目 | 提示見積もり |
| --- | ---: |
| 基板 | $31.10（技術料25.00＋ボード6.10） |
| 部品 | $54.88 |
| 拡張部品料金 | $52.53 |
| PCBA設定・ステンシル・実装等 | $13.47 |
| 合計 | **$151.98** |

実装数は5枚。重複品番を整理すると35品番、そのうち課金対象Extendedが17品番で、この見積もりでは1品番当たり$3.09となる。個数や枚数ごとの課金ではない。公式掲載の$3.07との差を混ぜず、今回の計算は実見積もりの$3.09を使う。Promotional/Preferred Extendedは表示がExtendedでも料金免除の場合があるため、今後はBasicかどうかだけでなく実際の追加料金も確認する。

ExcelのQ列を単純に足した$65.352は支払対象の部品代ではない。C13585が2行、C14663が2行に重複計上されている表示を一度ずつにまとめ、未選択J4の$6.358を外すと、$65.352−$3.567−$0.546−$6.358=$54.881となり、画面の$54.88と一致する。重複表示の解消を、新たなコスト削減とは数えない。

## ソケットはCore本体とは別

BOMの「Tang Primer 20K Core」というJ4の表記は紛らわしいが、実際の購入品は **CONCRAFT 0705F0BE40F、C367004、204ピンの受け側ソケット**。Core基板本体は元々BOMに含まれていない。Core本体はユーザー支給とし、ソケットはPCBA対象へ戻す。204ピンを手はんだで後付けする節約案は採用しない。

以降、ソケットの部品調達・追加料金・実装・必要な治具/支給手配をまとめた5枚分の追加額を **S** とする。すべての案にSを加える。現在は指定品が在庫なしなので、Sは未確定。未選択行の参考部品代$6.358＋拡張料金$3.09＋204端子×5枚×$0.0016≒$11.08は、在庫があった場合の参考補正であり、今すぐ買える価格ではない。

| 経路 | 確認した情報 | 採用前の条件 |
| --- | --- | --- |
| 指定品0705F0BE40F / C367004 | JLCPCBに品番登録はあるが在庫0表示。同一品の即納購入先は確認できず | JLCPCBの取り寄せ見積もり・納期確認が先。現行PCBを維持できる最優先経路 |
| JLCPCB C22471982 / XDAP-4042044-20401 | 204P DDR3、5.2mm、SMT、Economic/Standard対応。検索で取得した販売表示には306個、1個$1.5524の例がある | 古い取得情報を含むため、5個＋業者指定予備数を注文画面で再確認。高さ、ノッチ方向、端子番号、ランド、固定金具・位置決め穴を照合。治具が必要との販売表示もあり、費用はSへ加算 |
| TE 2-2013022-1を取り寄せ | DigiKeyに在庫表示あり、1個$4.84、最小1個。204P、0.6mmピッチ、行間8.2mm、4mm高 | 同一規格だけで互換としない。図面と現行ランドを照合し、JLC側の買い付け/実装可否を確認 |

C22471982なら参考部品代は5個で約$7.76。料金と204端子の実装を足した最低参考は約$12.48だが、治具・予備数・実際の調達価格が別であり、確定Sとはしない。TE品を海外から支給すると、JLCの現行案内では支給手配に最低$10の輸入取扱費と輸送費等が生じ得る。外で安く買えば必ず安くなるわけではなく、JLC側の直接調達か、在庫のあるソケットを廉価版の基準品にする方を優先する。代替を現行PCBへ無確認で載せる提案はしない。

## 個別の削減方法

| 方法 | 5枚分の削減概算 | 内容と条件 |
| --- | ---: | --- |
| A1 抵抗だけ基本部品化 | 約$9.03 | 課金品番を3種類減らす。下記の合成抵抗へ変更し、必要なランドを別版で追加 |
| A2 3.3V LDOも基本部品化 | A1に約$4.22追加、合計約$13.25 | C5446 XC6206P332MR-Gが候補。低負荷限定、別フットプリント、電源検証が必要 |
| H HDMIをPCBA対象外 | 約$20.75 | 28部品を未実装、Extended5品番の課金が消える。HDMIコネクタは元々PCBA外なので、コネクタ代を二重に引かない |
| P PD入力に統一 | 約$0.24 | J1は元々手実装で見積もりにない。PCBA上は重複入力ダイオード1個が主な削減。共通のPTC・TVS等の保護は残す |
| D 12Vバレル入力に統一 | 約$13.93 | J2・CH224KとPD用抵抗/コンデンサ、OR用ダイオードを除外。ジャックの手配・手実装費は元見積もり同様に別 |
| B 基板を99×78mmへ | 約$1.27〜29.10 | $2特価が適用できれば31.10→2.00。非適用なら技術料25を残し、ボード代だけ面積比例した保守的参考で約29.83 |
| L L1を安いExtendedへ | 約$5.69 | C380054 MS1040-150M候補。部品単価を約$1.38→$0.246へ。Extended料金は残る。新ランド・メーカー仕様照合・電源検証が必要 |

### 最初に進める基本部品化

1. **R7 3.24kΩ**：3.3kΩ C22978 と、100kΩ C25803を2個直列にした200kΩを並列にする案。合成約3.246kΩ、TPS5430設定約4.982V。元の約4.990Vに近く、3.3kΩだけへ置き換える案より設定の変化を小さくできる。追加2部品/枚と実装費を差し引いた削減は約$3.05/5枚。
2. **499Ω 0603/0402**：それぞれBasic 1kΩを2個並列にして500Ωとする案。0603は既存C21190、0402はC11702。元との差は約+0.2%。追加8部品/枚を含めても約$5.99/5枚の削減。ただしHDMIの枝長・左右対称性・ESD周辺の配置を再確認する。HDMIを未実装にする案では、この節約はHへ含まれるので足さない。
3. **U3 TLV1117LV33**：Basic C5446 XC6206P332MR-Gへ変更する条件付き案。セラミック対応はメーカー資料で確認できるが、200mA級のSOT-23であり1A品の置き換えではない。廉価版ではPMOD等の外部給電を使わず、3.3V総負荷50mA以下を設計条件として見積もる。Core自身のFPGA/DDR3電源はCore上にあるため、その大電流をこのLDOへ流す構成ではない。負荷・起動・入出力定格を確認して採用する。単価$0.15を予算仮定とし約$4.22削減。一般的なAMS1117への無検証置換はしない。

R7の3.3kΩと新0402 1kΩの価格には1個$0.0022の予算仮定を使った。分類とメーカー品番は確認済みだが、置換後の価格・余剰購入数量は再見積もりが必要。Basic化は名称だけ合わせず、値・許容差・定格・回路機能を保つ。

L1候補は15µH、4.5A、飽和6A、DCR40mΩの掲載品。現行15µH、4.6A、飽和5A、27mΩと近く、単価効果が大きい。ただしExtendedのままなので「Basic化で追加料金が消える」とは計算していない。

C7 220µF POSCAPは部品代だけで$10.60/5枚と高い。ただしTPS5430の安定性に関わるため、安いMLCCや一般電解へ単純置換しない。現段階で適合する安価品を確定できていないので、削減額へ算入していない。将来の電源回路再設計による上積み余地として残す。

### 基板縮小の判断

公式広告の目安は、標準条件の1〜4層、5枚、**両辺100mm以内**。現行125×78mmは97.5cm²だが長辺125mmのため枠外。面積だけを100cm²未満にしても同じ扱いとは限らない。

99×78mmを第一候補にする。例えば現行座標x=28〜127mmを使う構想なら、M5-BusとCoreの位置を保ち、x=51.06/124.06の4か所のM3取付穴を残せる。一方、x=4.06の2穴と左側の電源・USB・スイッチ部品は移設が必要で、単なる外形切断では成立しない。PD統一とHDMI未実装で空間を作り、4点支持とコネクタの差し込み空間を再検証する。まだ配置を設計したわけではなく、99mmへの収容を保証する段階ではない。

4層と内層GNDは残す。2層化による別の信号品質・電源帰路リスクは今回の節約へ含めない。特価の適用条件・積層・表面処理は見積画面で確認し、解析で使った積層を変更する場合は再検証する。今回の$25の技術料が必ず消えるとは扱わない。

## 組み合わせ比較

Aは抵抗＋条件付きLDOの基本部品化、HはHDMI未実装、Bは99×78mm、PはPD統一、Dはバレル統一。金額は **5枚合計＋必須のソケットPCBA費S**。幅のある行は主にPCB特価の適用/非適用によるもので、正式な再見積価格の誤差範囲ではない。HDMIと499Ω基本部品化を重複して引かない。

| 構成 | 5枚の概算 | 現見積もりからの削減 |
| --- | ---: | ---: |
| 現見積もりにソケットを戻す | $151.98＋S | $0.00 |
| Aのみ | $138.73＋S | $13.25 |
| Hのみ | $131.23＋S | $20.75 |
| Pのみ | $151.74＋S | $0.24 |
| Dのみ | $138.05＋S | $13.93 |
| Bのみ | $122.88〜150.71＋S | $1.27〜29.10 |
| A＋H | $123.96＋S | $28.02 |
| A＋H＋P | $123.72＋S | $28.26 |
| A＋H＋P＋B 推奨 | $94.62〜122.46＋S | $29.52〜57.36 |
| A＋H＋D＋B 最安寄り | $80.93〜108.76＋S | $43.22〜71.05 |

推奨案にL1候補を追加すると、さらに約$5.69下がる。LDO候補を採用しない場合は、Aを含む各案へ約$4.22を戻す。PD案とバレル案の差は約$13.69/5枚、約$2.74/枚。使いやすさを優先するならPDを残す余地は十分ある。

## 全24パターン

| 基本部品化A | HDMI | 基板 | 入力 | 5枚の概算 S別 |
| --- | --- | --- | --- | ---: |
| なし | 実装 | 125×78 | 両入力 | $151.98＋S |
| なし | 実装 | 125×78 | PD | $151.74＋S |
| なし | 実装 | 125×78 | バレル | $138.05＋S |
| なし | 実装 | 99×78 | 両入力 | $122.88〜150.71＋S |
| なし | 実装 | 99×78 | PD | $122.64〜150.47＋S |
| なし | 実装 | 99×78 | バレル | $108.95〜136.78＋S |
| なし | 未実装 | 125×78 | 両入力 | $131.23＋S |
| なし | 未実装 | 125×78 | PD | $130.99＋S |
| なし | 未実装 | 125×78 | バレル | $117.30＋S |
| なし | 未実装 | 99×78 | 両入力 | $102.13〜129.96＋S |
| なし | 未実装 | 99×78 | PD | $101.89〜129.72＋S |
| なし | 未実装 | 99×78 | バレル | $88.20〜116.03＋S |
| あり | 実装 | 125×78 | 両入力 | $138.73＋S |
| あり | 実装 | 125×78 | PD | $138.49＋S |
| あり | 実装 | 125×78 | バレル | $124.79＋S |
| あり | 実装 | 99×78 | 両入力 | $109.63〜137.46＋S |
| あり | 実装 | 99×78 | PD | $109.39〜137.22＋S |
| あり | 実装 | 99×78 | バレル | $95.69〜123.52＋S |
| あり | 未実装 | 125×78 | 両入力 | $123.96＋S |
| あり | 未実装 | 125×78 | PD | $123.72＋S |
| あり | 未実装 | 125×78 | バレル | $110.03＋S |
| あり | 未実装 | 99×78 | 両入力 | $94.86〜122.69＋S |
| あり | 未実装 | 99×78 | PD | $94.62〜122.46＋S |
| あり | 未実装 | 99×78 | バレル | $80.93〜108.76＋S |

## Extended全17品番の扱い

以下は見積書で課金対象だった品番。部品代は5枚分で、余剰購入を含む。全てをBasicへ置換できるという仮定は置かない。

| 部品 | 参照番号 | 現部品代 | 追加料金 | 方針 |
| --- | --- | ---: | ---: | --- |
| GVZ1V107M0608CNVC C2983388 | C1 | $0.3084 | $3.09 | 電圧・容量・リップルを保つ候補は継続調査 |
| 10TPB220M C242173 | C7 | $10.6045 | $3.09 | 安定性を優先して維持、安価品未確定 |
| SMBJ15A C699013 | D3 | $0.6237 | $3.09 | 12V系保護定格を維持 |
| SMD1812-300C-30V C47002391 | F1 | $0.8740 | $3.09 | 単一入力でも保護を維持 |
| 1206L050/15YR-A C315893 | F2 | $2.2670 | $3.09 | Hで未実装 |
| USB4125-GF-A-0190 C5246813 | J2 | $4.5825 | $3.09 | PDなら維持、Dなら除外 |
| SRR1260-150M C2041333 | L1 | $6.9225 | $3.09 | 安価Extended候補Lあり、課金は残る |
| 0603WAF3241T5E C22994 | R7 | $0.0300 | $3.09 | Aで合成抵抗へ |
| 0603WAF4990T5E C23065 | R28,R29,R32,R33,R34,R35 | $0.0600 | $3.09 | Aで1k並列、またはHで未実装 |
| 0402WGF4990TCE C4125 | R30,R31 | $0.0200 | $3.09 | Aで1k並列、またはHで未実装 |
| CH224K C970725 | U1 | $2.5695 | $3.09 | PDなら維持、Dなら除外 |
| TLV1117LV33DCYR C15578 | U3 | $1.8820 | $3.09 | Aで低負荷条件付きXC6206へ |
| RCLAMP0524P C293965 | U4,U5 | $0.6300 | $3.09 | Hで未実装 |
| SRV05-4.TCT C13612 | U6 | $1.1389 | $3.09 | Hで未実装 |
| SN74CB3Q3245PWR C470961 | U7,U8 | $7.6920 | $3.09 | Ioff付き双方向バス機能を維持 |
| TPS3839G33DBZR C485802 | U9 | $2.2015 | $3.09 | 3.08V監視とOE条件を維持 |
| TPS3839K50DBZR C702204 | U10 | $3.0030 | $3.09 | 4.38V監視とOE条件を維持 |

## 次に設計へ進む場合の条件

まずソケットの調達とPCBA可否を確定する。在庫候補を優先する場合は、現行を変更せず別版でそのランドに合わせる。基本部品化を適用し、並行して99×78mmの配置を検討する。電源・バス・Core取付の条件を満たせない縮小は採用しない。HDMIの回路・配線を残す未実装版なら、再実装時に必要な部品表を別管理する。

Linux側c1cd5e4の要求・Device Tree・mock通信バックエンド、GPU側3b1ace3の要求・board_profile・通信RTL、研究計画e4aa69dを再確認した。最低成功はパラレル通信、DDR3読み書き、演算オフロードであり、HDMIは追加目標。物理通信/DMA/DDR3の実機性能を検証済みとは扱わない。電源断保護の削除、74HC245等への機能未確認置換、Core電源の削減は今回の価格案へ含めない。

## 根拠と保存データ

提供されたXLSの読み取り結果、品番単位の正規化表、24案の計算条件は隣のJSONに保存。計算は部品数量と課金品番の集合を分け、余剰購入を含む品番が消える場合だけその全額を引く。残る共通品番は、減る実装数量だけを既存単価で引く。SMT単価は公式$0.0016/端子、窒素等の変動分は維持した保守的計算。新たなメーカー見積もり取得、部品予約、購入は行っていない。

- [PCB価格条件](https://jlcpcb.com/ads/pcb-prototype)
- [PCBA料金](https://jlcpcb.com/help/article/pcb-assembly-price)
- [Basicと追加料金免除部品](https://jlcpcb.com/parts/basic_parts/)
- [0402 1kΩ C11702](https://jlcpcb.com/partdetail/12256-0402WGF1001TCE/C11702)
- [0603 3.3kΩ C22978](https://jlcpcb.com/partdetail/23705-0603WAF3301T5E/C22978)
- [XC6206 Basic C5446](https://jlcpcb.com/partdetail/XC6206P332MR-G/C5446)
- [Torex XC6206仕様](https://product.torexsemi.com/en/series/xc6206)
- [XC6206データシート](https://product.torexsemi.com/system/files/series/xc6206-j.pdf)
- [L1代替15µH 4.5A C380054](https://jlcpcb.com/parts/2nd/Inductors_Coils_Chokes/Molding_Power_Inductors_3741?Manufacturer=COILMX)
- [現行ソケット C367004](https://jlcpcb.com/partdetail/CONCRAFT-0705F0BE40F/C367004)
- [PCBAソケット候補 C22471982](https://jlcpcb.com/partdetail/24195375-XDAP_404204420401/C22471982)
- [TEソケット DigiKey](https://www.digikey.com/en/products/detail/te-connectivity-amp-connectors/2-2013022-1/2300062)
- [TEソケット仕様](https://www.te.com/en/product-2-2013022-1.html)
- [海外からの支給部品](https://jlcpcb.com/help/article/how-to-consign-parts-to-jlcpcb)
