airpocket-soundman/tab5-tang-primer20k-carrier/spark/design/ASSEMBLY_PLAN.md

# Spark版のPCBA・調達計画

2026-10-26。採択前の設計・見積準備。部品の在庫/価格は予約していない。

## 購入先の固定方針

ユーザー指定により、LCSCで購入できない部品は秋月電子へ集約する。DigiKey等への個別発注は追加しない。JLCPCBによるPCBAを最優先とし、手付け用の単品はLCSC、そこで調達できないものは秋月とする。秋月にも適合品がない場合は代替設計を行い、未検証品をそのまま購入しない。Tab5とCoreはユーザー購入の別枠。

秋月の2台分候補と購入単位は `akizuki-purchase-plan.csv` に記録する。J1とSW3はメーカー図面に合わせた専用ランド・回路図変更を反映済み。KiCadとEasyEDA出力のパッド中心、寸法、穴/スロット方向、めっき、マスク開口を照合した。実物の嵌合と組立プレビューは未確認。従来設計・A/B/Cは変更しない。

## 実装方針

| 参照番号/部品群 | 優先工程 | 調達と確認 |
| --- | --- | --- |
| 抵抗、コンデンサ、電源/監視/バスIC、ダイオード、トランジスタ、LED | JLCPCB SMT | 現行BOMの品番を基本。680ΩとHPD修正を反映。Basic化だけを目的に回路条件を変えない |
| J4Core受けソケット | PCBA必須 | C22471982/XDAP-4042044-20401。204端子・固定ランド・向き・高さ・治具・在庫を確認。手付けへ戻さない |
| J2USB-C | PCBA必須 | C5246813/USB4125-GF-A-0190。シェルと信号端子を含む |
| J5HDMI | PCBA必須 | C916313/MOLEX2086581001。19信号端子と4本の固定シェル端子を全て業者はんだ。Economicで完結しなければStandard等で見積 |
| SW1/SW2 | SMTへ変更優先 | 候補XKBTS-1102S-B-D-B/C480272。JLC公式でSMT対応、H5.5mm。メーカー推奨ランドへの変更が必要で、既存Panasonic/秋月ランドへ無確認で載せない |
| SW3FPGA停止用 | 秋月調達・手付け | OTAX KSD22、秋月108922。2回路中1回路のみ使用。7.6mm列間隔・2.54mmピッチ・0.8mm穴の専用ランドへ変更済み。ローカル端子1/4が使用回路、2/3が未接続回路。DC負荷を切るスイッチではなくBUCK_ENの制御。初期は両回路開放、FPGA電源ON。スイッチのON刻印とFPGA動作は逆になるので組立表示へ明記 |
| J3M5-Bus | 裏面THT/選択はんだ優先 | 2×15、2.54mm、ユーザー確認済み鏡像列配列を維持。接点長、プラスチック高さ、向き、スペーサを確認。上面SMTと別工程 |
| JP1BUS ARM | THT優先 | 1×2ヘッダーを実装してもショートピンは別梱包・初期未装着。主催/業者の組立指示へ明記 |
| J1バレル | 秋月調達・手付け | マル信MJ-179PH、秋月106568。メーカー図面に合わせた1×3.5mm長穴、接地端子位置、センタープラスを反映済み。実物適合を確認して発注確定。USBPDとバレルの両入力機能を保持 |
| J6/J7/J8拡張 | 初回DNP | 単独製品としての実演に不要。目的なくヘッダーや部品在庫を増やさない |
| ねじ/スペーサ/カバー | 組立/機構 | PCBAとは別。穴そのものを購入部品にしない。部品高さ・Tab5嵌合を先に確認 |
| Tab5とFPGAモジュール | ユーザー購入・装着 | 支援対象に含めない |

SW1/SW2の公式候補：[JLCPCB](https://jlcpcb.com/partdetail/XKBConnection-TS_1102S_B_DB/C480272)、[LCSC](https://www.lcsc.com/product-detail/C480272.html)。JLC閲覧時にSMT、Economic/Standard対応、在庫表示あり。単価・在庫は注文時再確認。仕様表の温度とデータシートの表記差は用途条件に対して保守的に扱う。

図面は `../sources/TS-1102S-B-D-B_C480272.pdf` に保存。推奨ランドは外形12.00×5.90mm、内側間隔6.80×3.10mm、各パッド2.60×1.40mm、中心X±4.70/Y±2.25mm。上面端子番号と回路図の同電位ペアを照合し、メーカー実装プレビューでも確認する。ボタン高さ変更はカバーの押し子設計へ反映する。

## 見積を分ける

1. PCB5枚、内2枚PCBA：電気回路、必須コネクタ、ボタン、必要なTHT工程、治具/技術料/余剰部品、送料を明細化。
2. 筐体：実物適合後のカバー2個を基準に必要数量を説明。造形サービスの別申請。
3. 自己購入：Tab5、Core、PCBA不可の手付け部品、ねじ/スペーサ、電源アダプタ、税。

PCBA率は「装着予定で確定した部品」に対して計算し、DNP・取付穴・ユーザー支給モジュールを分母に入れない。候補品が実装承認される前に100%PCBAと表記しない。見積CSVには未確定品を空欄のまま隠さず別の候補表で表示する。

現行見積候補はPCBA99部品/41行、手付け4部品（J1/J3/JP1/SW3）。基板上の装着予定103部品に対して計画値96.1%。別梱包ジャンパー・機構品はこの比率に含めない。実装承認済みの率ではない。BOMとCPLの参照番号一致を確認済み。

## 手付け部品の支援

通常の海外Spark支援ではLCSC単品クーポンを発行できないという公式回答がある。LCSC購入候補は調達表に残すが、補助額は0で予算化。JLCの部品ライブラリ購入はPCBA用保管で、単品配送できない。未実装3枚を後で組むための全キットを支援で入手する前提にしない。

## 発注に進める条件

EasyEDA応募資格とデータ作成条件、ERC/DRC/ネット一致、全必須品番・在庫、ソケット/HDMI固定端子と裏面THTの実装工程、極性/端子1/回転、機械寸法、見積数量、クーポン条件を確認した上で材料申請する。承認クーポン受領後7日以内の使用を計画し、支払い後の返金を想定しない。
