airpocket-soundman/tab5-tang-primer20k-carrier/spark/single-sided-r4/lite-a/ASSEMBLY.md

# r4 廉価版A 製造・実装指示

2026-10-26。99×78mm、4層。設計データの製造条件は[order-profile.json](order-profile.json)に記録する。

## 発注ファイルと積層

- PCB：[design/manufacturing/spark-lite-a-lcsc-review-single-sided-r4-2026-10-26/gerbers.zip](design/manufacturing/spark-lite-a-lcsc-review-single-sided-r4-2026-10-26/gerbers.zip)。
- PCBA：同じフォルダーの[jlc-bom.csv](design/manufacturing/spark-lite-a-lcsc-review-single-sided-r4-2026-10-26/jlc-bom.csv)と[jlc-cpl.csv](design/manufacturing/spark-lite-a-lcsc-review-single-sided-r4-2026-10-26/jlc-cpl.csv)を必ず一組で使う。対象は103点・43行。J3は両ファイルから除外済み。
- 指定積層：**JLC04161H-7628、FR-4、板厚1.6mm、外層仕上がり銅厚35µm、内層15.2µm、7628プリプレグ、外層から隣接GND層まで0.2104mm、設計εr=4.4**。
- 提供済み配線幅・間隔・外形を維持する。別積層への置換や、インピーダンス調整を理由にした配線幅の自動変更は設計変更として再確認する。
- 部品表はLCSC番号を部品番号列へ割り当てる。自動マッチによる未確認の代替部品に切り替えない。数量・価格・送料・税・部品在庫は実際の見積もりで確認する。

## 片面SMTと手はんだ

SMTは**表面のみ**。裏面のステンシル・SMT実装は不要。裏面ペースト層は空である。

- **J3/C56496 ×1枚当たり1個**：LCSCから別購入し、ユーザーが裏面から手はんだする。Tab5への嵌合方向、確認済みの鏡像ピン配列を維持する。2.54mmピッチ、接点側6mm、はんだ側3mm、樹脂2.54mm。板厚1.6mmでは尾部が表面へ約1.4mm突出する。実物で嵌合高さ・スペーサー・ねじの干渉を確認してからはんだ付けする。
- **J2 USB-C**：SMT接点だけでなく4本のTHシェル固定脚もはんだ付けする。
- **J5 HDMI/C916313**：19本のSMT接点と4本のTHシェル固定脚をはんだ付けする。
- **J4/C22471982**：204接点と2個のSMT金属保持端子を実装する。2個の定位穴は機械用であり、電気端子ではない。
- **J1/C381116、JP1/C124375**は表面から挿入するTHT実装候補。業者が実装しない場合は同じ選定LCSC部品を別購入し手はんだする。支給・実装対象と手配を合わせ、二重購入を避ける。
- JP1用C5305ショートピンは別梱包し、初回通電では装着しない。Tab5、Core、ケーブル、スペーサー等の機構部品はPCBA対象外。

## 配置座標・回転

リリース用CPLは**公式LCSC/EasyEDAフットプリントの原点・ゼロ角フレームに補正済み**。今回の103実装参照を全て照合した。物理PCBの部品位置や銅箔を動かしたものではない。

CPLのMid X/Yは同梱Gerberのプロット原点基準、単位mm、+X右・+Y上。CADフットプリントの原点・角度と数値が異なる部品がある。`finalize_placement.py`を通していない原点出力で上書きしない。

業者のテープ／リールの実装基準やプレビューは最終的に同梱実装図・端子位置と照合する。公式ライブラリのフレーム照合を、業者による配置承認と同一視しない。

正しい外向き方向は、**DCジャックとUSB-Cの口が左辺、HDMIの口が右辺**。J3は裏向き手はんだである。

## 極性・pin1確認表

以下は**Gerber座標系における実際のPCB端子中心**であり、部品重心やCPL原点ではない。

| 部品 | 端子 | X / mm | Y / mm |
| --- | --- | ---: | ---: |
| C1 | ＋VIN | 10.800000 | 39.000000 |
| C7 | ＋5V / anode | 5.500000 | 27.380000 |
| U1 | pin1 | 17.637500 | 46.500000 |
| U2 | pin1 | 9.300000 | 17.905000 |
| U3 | pin1 | 32.562500 | 66.950000 |
| U4 | pin1 | 79.615000 | 63.250000 |
| U5 | pin1 | 79.615000 | 60.250000 |
| U6 | pin1 | 78.615000 | 55.200000 |
| U7 | pin1 | 33.837500 | 53.425000 |
| U8 | pin1 | 33.837500 | 37.425000 |
| U9 | pin1 | 34.062500 | 18.450000 |
| U10 | pin1 | 39.062500 | 18.450000 |

- C1アルミ電解コンデンサの帯は負極で、pad2/GND側。表の＋VIN/pad1へ逆接しない。
- C7 POSCAPの極性帯は**正極**。表の＋5V/anode/pad1側に合わせる。C1の負極帯と混同しない。
- D1〜D4の帯はcathode/pad1側、LEDのcathodeもpad1側。各選定部品の極性表示と実装図で確認する。
- ICのpin1表示を表と照合する。補正済みCPLの角度を、別のCADゼロ角の解釈で追加回転しない。
- L1は無極性だが、2端子の軸をランドに合わせる。

## U2 PowerPAD・サーマル穴

U2の8個のサーマル穴は公称0.3mm。上面のはんだ開口は2.6×3.1mm（8.06mm²）、裏面の熱拡散銅箔にはペースト・マスク開口を設けない。銅箔専用パッドを追加のはんだ開口として扱わず、提供Gerberのマスクとペーストを維持する。露出パッドとサーマル穴の実装工程は業者の工程審査対象とする。

## 初回評価

主電源スイッチと旧FPGA専用停止SW3はどちらも省略。外部給電が有効な間はキャリア電源が動作する。Tab5内蔵バッテリーの停止制御もない。

Tab5とCoreを外して短絡・極性と電源出力を確認し、電流制限付き電源で初回通電する。ARMは未装着。通信は1MHz、weak drive/SLOW、DATA setup/hold各250ns以上、DIR切替待ち500ns以上から始める。Coreは資料上の通常0.5A条件から評価する。

局所3.3Vは通常10mA以内、外部3.3V負荷なし。50mA負荷急変などの範囲外感度ケースは通常動作条件として扱わない。

実機の嵌合・発熱・HDMI映像・DMA/DDR3・ソフトウェアは製造後のPoC検証対象。現在のファイルチェックを実機動作や業者DFM承認の代替としない。
