airpocket-soundman/tab5-tang-primer20k-carrier/variants/lite-a-dual/manufacturing/lite-a-dual-2026-10-25/assembly-instructions.txt

J5 MOLEX 2086581001 / C916313: full connector PCBA required. Assemble and solder all 19 SMT contacts AND all four through-hole SH shell/mounting tabs. Customer will not solder this HDMI connector. Confirm shell-tab process and full connector assembly in the order preview; if Economic service cannot solder these tabs, quote a service that can. Do not silently omit shell tabs or move J5 back to customer assembly.
J4 Core socket: PCBA required. Core module itself: customer supplied. J6/J7/J8 PMOD/GPIO sockets: excluded from PCBA.
