airpocket-soundman/tab5-tang-primer20k-carrier/variants/lite-c-dnp/manufacturing/poc-lite-c-2026-10-25/assembly-instructions.txt

J5 HDMI and all dedicated HDMI/PD components remain DNP; do not populate them in this order.
SW1/SW2: customer hand solder TS-06104 H4.3mm, Akizuki115969; dedicated new lands. J4 socket PCBA; Core customer supplied. J6/J7/J8 excluded from PCBA.
