airpocket-soundman/tab5-tang-primer20k-carrier/variants/lite-b-barrel/kicad/sim/assembly-bottom.png

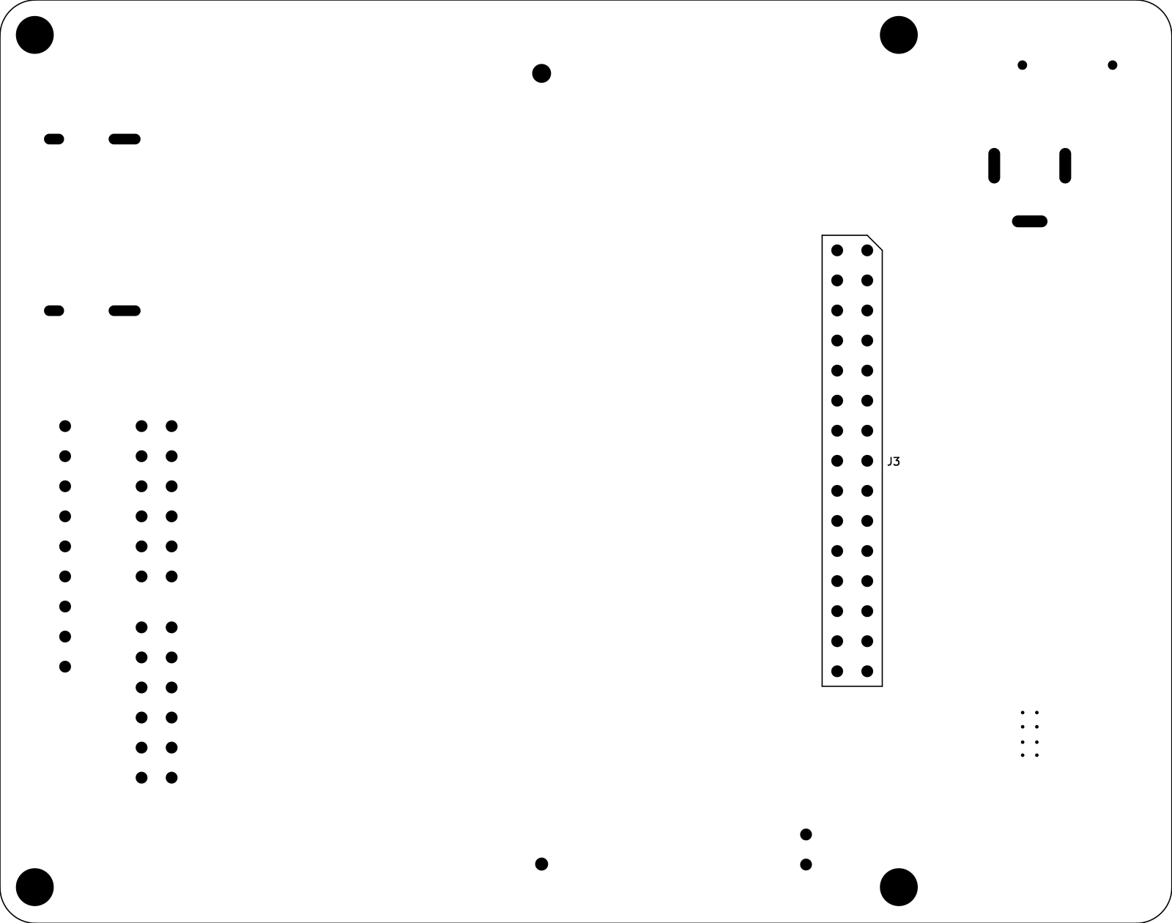
variants/lite-b-barrel/kicad/sim/assembly-bottom.png
