airpocket-soundman/tab5-tang-primer20k-carrier/variants/lite-b-barrel/kicad/sim/assembly-top.png

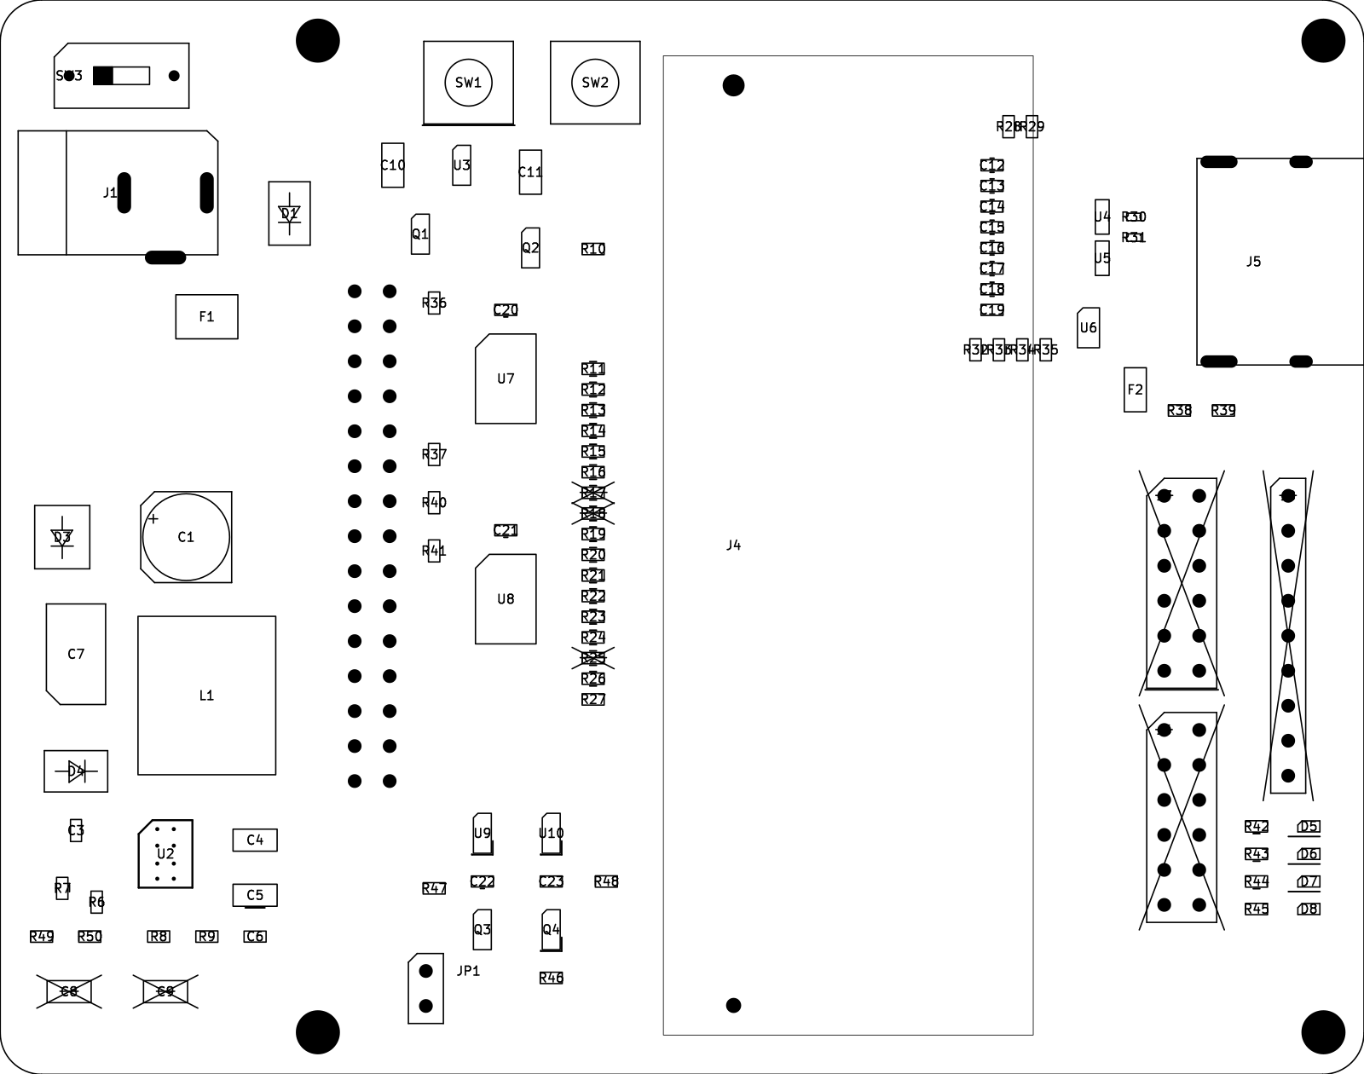
variants/lite-b-barrel/kicad/sim/assembly-top.png
