airpocket-soundman/tab5-tang-primer20k-carrier/variants/lite-c-dnp/assembly-top.png

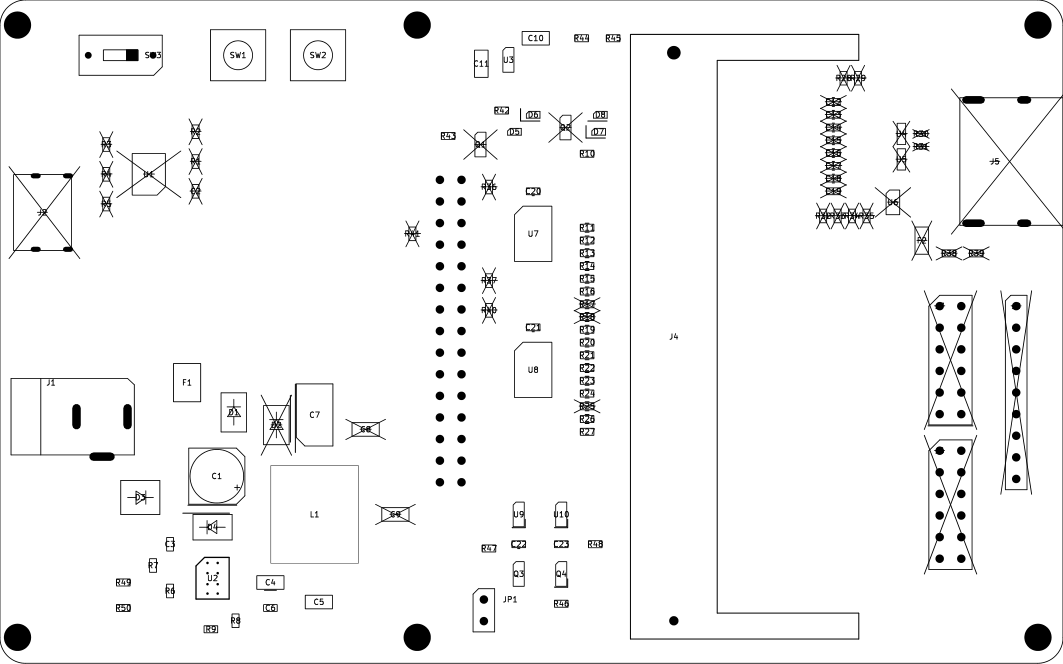
variants/lite-c-dnp/assembly-top.png
