airpocket-soundman/tab5-tang-primer20k-carrier/spark/design/VERIFICATION_STATUS.md

# Sparkフル機能版の開発・検証状況

2026-10-26。125×78mm、4層、HDMI、USB PD12V、バレル12Vを保持。従来版・A/B/Cは保存し、別作業フォルダの883ファイルが開始時のハッシュと一致することを確認した。

## 完了した設計作業

- J1を秋月106568/MJ-179PH専用ランドへ変更。端子1がセンタープラス、端子2/3が接地。図面の1×3.5mmスロット、側端子Y4.9mmを反映。
- SW3を秋月108922/OTAX KSD22へ変更。2回路中1回路でBUCK_ENを接地し、残りを明示的NCとした。7.6mm列間隔、2.54mmピッチ、0.8mm穴、両面マスク開口。未使用端子を避けるBUCK_ENの局所迂回を実施。
- PCBAは99部品・41行。SW1/SW2はC480272、CoreソケットはC22471982、HDMIは固定シェル端子を含めてC916313の業者実装を要求。手付け4部品は秋月へ集約。
- KiCad回路図から出力した実ネットリストの482接続端子をモデルと照合。KiCad設定済みルールの全severity DRCは違反0・未配線0、ERCエラー0。電源・隔離・M5-Bus等の32項目とHDMI導通検査も合格。

## EasyEDA移植

現行プロジェクトは **Tab5 Spark Full PCBA Akizuki Review**、UUID `b7a6783339159b0708ab3bf639c202306b62d83ae5fc2c3bf655e9d774467d8f`。関連付け済み回路図UUID `0c2263c862d746ed`、基板UUID `52caa9452ee66dee`。

使用する保存ファイルは `easyeda/spark-akizuki-migration-review.epro2`。KiCadからの移植であることを明示し、100%EasyEDAで新規作成したとは扱わない。

| 確認 | 結果・証跡 |
| --- | --- |
| 基板の電気・配線照合 | 118部品、622銅箔/機械パッド、136ネット、2472配線、284ビアを照合。位置・幅・穴径の最大差約0.00000138mm。`easyeda/electrical-migration-audit.json` |
| 秋月部品のランド | J1/SW3のパッド中心、銅箔寸法、穴寸法/スロット角度、めっき、マスク開口をローカル図面対応ランドと照合。`easyeda/manual-footprint-audit.json` |
| ネイティブ回路図 | 118部品の値と482接続端子のネット名が一致。NCへの意図しない接続なし。`easyeda/schematic-migration-audit.json` |
| 基板DRC | 0件。KiCadと同じ銅箔間隔0.127mm、穴間隔0.25mm、外形間隔0.3mm、ビア径0.5mm以上/ドリル0.3mm以上を設定。チェックを無効化せず、元のルールと適用後を保存 |
| 回路図チェック | 重大エラー0、警告13。警告の個別分類は残件。APIはこの版では件数のみ返すため、警告0と表記しない |

移植で見つけた問題も記録する。KiCad10の直接インポートでは配線/ネットが欠落するため番号付きネットの互換コピーを使用した。回路図の電源シンボル推論では異なる電源ネットが結合したため、移植用コピーだけを明示的ラベルに変更した。原本の電源シンボルとERC用フラグは保持。失敗した回路図は現行プロジェクトから削除し、修正版へ関連付け直した。

また、このクライアントでは一部属性だけを変更すると部品値等が消える挙動を確認した。全属性を保持した更新へ変更し、出力ネットリストで値・接続を再検証した。`tab5-spark-engineering-review.epro2` と `spark-pcb-migration-review.epro2` は不完全な中間版であり使用禁止。

## シミュレーション

| 対象 | 結果 | 限界 |
| --- | --- | --- |
| 8bitリンク・15信号 | 5コーナー×双方向の150条件を再計算。受信端の電圧条件150/150合格、±5%整定最大91.39ns | 高速駆動コーナー90条件は送信端の電圧条件に不合格。弱駆動/SLOWを必須とし、全条件合格とはしない。固定Ron・分布RLC・IBIS由来容量の近似であり完全なGPIO IBISではない |
| 周期信号 | 1MHzは4/4条件合格。10MHzは遅いコーナーで不合格、20/40MHzは全条件不合格 | 初期1MHz、DATA setup/hold各250ns、DIR切替500ns。GPU目標帯域やDMA性能の実証ではない |
| 5V電源 | 11.4/12/12.6V、PD入力プロファイル、1A負荷感度、低ESR感度の6条件が数値電圧範囲内。Core最小約4.813V | TPS5430平均モデル。TLV1117過渡、完全なスイッチング、CH224K交渉、熱、実物接点は未検証。HDMI/3V3は5V換算60mA仮定 |
| HDMI | 4差動対の主経路スキュー0。742MHz挿入損失約0.79～0.89dB、1.5GHz以下の最悪反射損失約15.5～17.5dB | 近似4ポートモデル。3D電磁界解析・HDMI適合認証・実機映像確認ではない |

最後の変更はSW3のマスク開口追加。抽出した全通信モデル入力が再計算時と完全一致することを `../simulation/parallel/current-binding.json` に記録し、150条件の実行元ハッシュを改ざんせず結果を対応付けた。電源6条件は最終CADのハッシュで再実行した。

## 次に解消する残件

### EasyEDA内の再計算（追記）

API GatewayのブラウザーWorker内へ公式NGspice46 WASMを読み込み、電源6条件と通信150条件を実際に再計算した。製造用回路図全体を自動SPICE化したものではなく、従来の解析用等価回路を同じ条件で再実行した結果である。GUI操作、既存の計算値の結果イベントへの注入、外部PythonでのSPICE代行は行っていない。

電源6条件は電圧範囲内で、電圧指標の差は従来結果に対して最大約0.0173mV。通信150条件は全て数値計算完了、合否分類150/150一致、端子電圧極値の差は最大約0.0253mV、整定時間の差は最大約0.00913ns。受信端150/150合格・送信端60/150合格という従来の制約もそのまま再現した。PD入力モデルの0Ω抵抗を1e-12Ωへ置き換える警告は記録し、物理モデルの問題と混同しない。

周期モデル16条件も再計算し、全閾値判定が一致、1MHzは4/4合格。周期波形の書き出しは10万点上限への対応として計算後に元の出力間隔100psへ補間している。ソルバー条件は変更せず、サンプル電圧の差は最大4.21mV。通信150条件の過渡極値は補間せず比較した。

実行元のコミット・バイナリハッシュ、再現スクリプト、比較表、波形ハッシュ、重ね合わせ図は `../simulation/easyeda-wasm/` を参照。HDMIの4ポート近似解析は従来の外部計算結果であり、EasyEDA内で再実行済みとはしない。解析環境の照合が完了しても、下記の実物・実装・応募資格の残件は解消されない。

### 製造リリースまでの残件

1. EasyEDA回路図の13警告を個別分類し、回路図・基板の更新操作で部品/ネットが意図せず変わらないことを追加確認。
2. 全コネクタ/ソケット/カスタムランドのメーカー実装プレビューと業者DFM。特にJ4とHDMIシェル、実装回転・向き・在庫を確認。
3. Coreカード高さ・挿抜軌跡、Tab5嵌合、スペーサ長、ボタン高さ、カバー干渉と発熱。SCADは機構コンセプトで、造形確定版ではない。
4. KiCadでの設計・解析後の移植がSpark条件を満たすか主催者へ確認。設計完成・未払い見積を添えて材料支援申請し、個別承認後に発注。
5. 製造後は電源単体、Core、低速CRC、DDR3全域試験、実演、HDMIの順で実測。LinuxとGPUは別ソフト/ビットストリーム。

現行のGerber/BOM/CPLは `manufacturing/spark-full-review-2026-10-26/` の見積・レビュー用。未払い見積取得、応募、材料申請、メール送信、注文支払いは未実施。製造リリース済みと扱わない。
