airpocket-soundman/tab5-tang-primer20k-carrier/fpga/validation/npu-autonomous-crc-table-isa-2026-11-08/README.md

# Isolated CRC-table full RV32 ISA proof

Actual RV32IMC soft-float firmware completed all649 nodes /57 Conv /65 logical MatMul with400368 Tile commands and zero hardware Matrix commands.352B BSS was prefilled0xA5 before startup. All1800 output float bits exactly match predeclared RV32 golden9a4e9b9319e2b2592c9c10d2134c97b71226f0bf32e3b4774dfeb71feca6f715. Integer MAC uses independent native oracle; no physical hardware was accessed.

Compared with index32 parent, step-budget slices142253�¨141219 (-0.727%). Read callbacks increased by20668416 (one table read per payload byte); write callbacks unchanged.370 host seconds is not FPGA speed. Static CRC loop improvements do not imply equivalent wholegraph gains. Exact ELF/BIN, all19 build-input hash matches, native176-check CRC proof, source snapshot and full ISA output/log/provenance are preserved. Canonical firmware, host SDK and active hardware were unchanged. Candidate remains offline eligibility only; no deployment or full physical NN pass is claimed.
