airpocket-soundman/tab5-tang-primer20k-carrier/fpga/validation/npu-autonomous-fastmul-fullchip-2026-11-08/failed-place1/pnr.rpt.html

- PnR Messages
- PnR Details
- Resource
  - Resource Usage Summary
  - I/O Bank Usage Summary
  - Clock Resource Usage Summary
  - Global Clock Signals
  - Pinout by Port Name
  - All Package Pins

# PnR Messages

Report Title | PnR Report
Design File | D:\GitHub\airpocket-soundman\tab5-tang-primer20k-carrier-resume-20261106\build\npu-autonomous-root\full-v4-fastmul-place1\npu_ddr\impl\gwsynthesis\npu_ddr.vg
Physical Constraints File | D:\GitHub\airpocket-soundman\tab5-tang-primer20k-carrier-resume-20261106\build\npu-autonomous-root\full-v4-fastmul-place1\source_snapshot\mem\config\mem_bist.cst
Timing Constraints File | D:\GitHub\airpocket-soundman\tab5-tang-primer20k-carrier-resume-20261106\build\npu-autonomous-root\full-v4-fastmul-place1\npu_ddr_initial.sdc
Tool Version | V1.9.11.03 Education
Part Number | GW2A-LV18PG256C8/I7
Device | GW2A-18
Device Version | C
Created Time | Sun Nov 8 20:20:30 2026
Legal Announcement | Copyright (C)2014-2025 Gowin Semiconductor Corporation. All rights reserved.

# PnR Details

Place & Route Process

Running placement: Placement Phase 0: CPU time = 0h 0m 9s, Elapsed time = 0h 0m 9s Placement Phase 1: CPU time = 0h 0m 0.318s, Elapsed time = 0h 0m 0.317s Placement Phase 2: CPU time = 0h 0m 12s, Elapsed time = 0h 0m 12s Placement Phase 3: CPU time = 0h 0m 32s, Elapsed time = 0h 0m 32s Total Placement: CPU time = 0h 0m 55s, Elapsed time = 0h 0m 55s Running routing: Routing Phase 0: CPU time = 0h 0m 0.006s, Elapsed time = 0h 0m 0.006s Routing Phase 1: CPU time = 0h 0m 0.491s, Elapsed time = 0h 0m 0.491s Routing Phase 2: CPU time = 0h 2m 45s, Elapsed time = 0h 2m 45s Routing Phase 3: CPU time = 0h 0m 0s, Elapsed time = 0h 0m 0s ERROR (PR0004) : There are total 0 unrouted nets Total Routing: CPU time = 0h 2m 46s, Elapsed time = 0h 2m 46s Generate output files: CPU time = 0h 0m 0s, Elapsed time = 0h 0m 0s
Total Time and Memory Usage | CPU time = 0h 3m 40s, Elapsed time = 0h 3m 40s, Peak memory usage = 634MB

# Resource

## Resource Usage Summary:

Resource | Usage | Utilization
Logic | 18018/20736 | 87%
--LUT,ALU,ROM16 | 16920(13607 LUT, 3313 ALU, 0 ROM16) | -
--SSRAM(RAM16) | 183 | -
Register | 8461/16173 | 53%
--Logic Register as Latch | 0/15552 | 0%
--Logic Register as FF | 8459/15552 | 55%
--I/O Register as Latch | 0/621 | 0%
--I/O Register as FF | 2/621 | <1%
CLS | 9663/10368 | 94%
I/O Port | 69/207 | 34%
I/O Buf | 62 | -
--Input Buf | 5 | -
--Output Buf | 31 | -
--Inout Buf | 26 | -
IOLOGIC | 16 IDES8_MEM 22 OSER8 20 OSER8_MEM 38 IODELAY | 57%
BSRAM | 1 SP 37 SDPB 8 SDPX9B | 100%
DSP | 6 MULT9X9 2 MULT18X18 1 MULT36X36 10 MULTADDALU18X18 | 61%

## I/O Bank Usage Summary:

I/O Bank | Usage | Utilization
bank 0 | 3/29 | 11%
bank 1 | 6/20 | 30%
bank 2 | 4/20 | 20%
bank 3 | 8/32 | 25%
bank 4 | 19/36 | 53%
bank 5 | 20/36 | 56%
bank 6 | 9/18 | 50%
bank 7 | 0/16 | 0%

## Clock Resource Usage Summary:

Clock Resource | Usage | Utilization
PRIMARY | 4/8 | 50%
LW | 8/8 | 100%
GCLK_PIN | 4/8 | 50%
CLKDIV | 1/8 | 13%
DHCEN | 1/16 | 7%
DLL | 1/4 | 25%
DQS | 2/9 | 23%
rPLL | 1/4 | 25%

## Global Clock Signals:

Signal | Global Clock | Location
sys_clk_d | PRIMARY | TR TL BR BL
user_clk | PRIMARY | TR TL BR BL
core/link/req_t_7 | PRIMARY | TR TL BR
core/adapter/n478_7 | PRIMARY | TR TL BR BL
ip_user_reset | LW | -
core/n466_5 | LW | -
core/n13_5 | LW | -
core/loader/n2811_4 | LW | -
core/loader/multiplier/n1479_5 | LW | -
core/local_cpu/n17172_4 | LW | -
core/local_cpu/cpu/n492_7 | LW | -
core/local_cpu/cpu/pcpi_div/n1783_5 | LW | -
memory_clk | HCLK | BANK4_BANK5_HCLK0 BANK6_BANK7_HCLK0

## Pinout by Port Name:

Port Name | Diff Pair | Loc./Bank | Constraint | Dir. | Site | CFG | IO Type | Drive | Pull Mode | PCI Clamp | Hysteresis | Open Drain | Vref | Single Resistor | Diff Resistor | BankVccio
sys_clk | - | H11/0 | Y | in | IOT27[A] | GCLKT_0 | LVCMOS33 | NA | UP | ON | NONE | NA | NA | NA | NA | 3.3
reset_n | - | T10/3 | Y | in | IOR35[B] | SI/D2 | LVCMOS33 | NA | UP | ON | NONE | NA | NA | OFF | NA | 3.3
arm_sw | - | C7/6 | Y | in | IOL40[B] | - | LVCMOS15 | NA | DOWN | ON | NONE | NA | NA | OFF | NA | 1.5
bus_clk | - | T7/3 | Y | in | IOR29[A] | GCLKT_3 | LVCMOS33 | NA | DOWN | ON | NONE | NA | NA | OFF | NA | 3.3
dir | - | N8/3 | Y | in | IOR40[A] | - | LVCMOS33 | NA | DOWN | ON | NONE | NA | NA | OFF | NA | 3.3
aux[0] | - | N9/3 | Y | in | IOR36[B] | SSPI_CS_N/D0 | LVCMOS33 | NA | DOWN | ON | NONE | NA | NA | OFF | NA | 3.3
aux[1] | - | N7/3 | Y | in | IOR47[B] | RPLL2_C_fb | LVCMOS33 | NA | DOWN | ON | NONE | NA | NA | OFF | NA | 3.3
aux[2] | - | N6/3 | Y | in | IOR51[A] | - | LVCMOS33 | NA | DOWN | ON | NONE | NA | NA | OFF | NA | 3.3
aux[3] | - | P8/3 | Y | in | IOR42[A] | - | LVCMOS33 | NA | DOWN | ON | NONE | NA | NA | OFF | NA | 3.3
ready | - | L9/3 | Y | out | IOR40[B] | - | LVCMOS33 | 8 | DOWN | NA | NA | OFF | NA | OFF | NA | 3.3
led[0] | - | L16/1 | Y | out | IOT34[A] | - | LVCMOS33 | 8 | UP | NA | NA | OFF | NA | NA | NA | 3.3
led[1] | - | L14/1 | Y | out | IOT34[B] | - | LVCMOS33 | 8 | UP | NA | NA | OFF | NA | NA | NA | 3.3
led[2] | - | N14/1 | Y | out | IOT52[B] | - | LVCMOS33 | 8 | UP | NA | NA | OFF | NA | NA | NA | 3.3
led[3] | - | N16/1 | Y | out | IOT52[A] | - | LVCMOS33 | 8 | UP | NA | NA | OFF | NA | NA | NA | 3.3
ddr_addr[0] | - | F7/6 | Y | out | IOL45[A] | LPLL2_T_in | SSTL15 | 8 | NONE | NA | NA | NA | NA | OFF | NA | 1.5
ddr_addr[1] | - | A4/5 | Y | out | IOB2[A] | - | SSTL15 | 8 | NONE | NA | NA | NA | NA | NA | NA | 1.5
ddr_addr[2] | - | D6/5 | Y | out | IOB3[A] | - | SSTL15 | 8 | NONE | NA | NA | NA | NA | NA | NA | 1.5
ddr_addr[3] | - | F8/6 | Y | out | IOL35[A] | - | SSTL15 | 8 | NONE | NA | NA | NA | NA | OFF | NA | 1.5
ddr_addr[4] | - | C4/6 | Y | out | IOL47[A] | LPLL2_T_fb | SSTL15 | 8 | NONE | NA | NA | NA | NA | OFF | NA | 1.5
ddr_addr[5] | - | E6/6 | Y | out | IOL53[A] | - | SSTL15 | 8 | NONE | NA | NA | NA | NA | OFF | NA | 1.5
ddr_addr[6] | - | B1/5 | Y | out | IOB8[A] | - | SSTL15 | 8 | NONE | NA | NA | NA | NA | NA | NA | 1.5
ddr_addr[7] | - | D8/6 | Y | out | IOL38[A] | - | SSTL15 | 8 | NONE | NA | NA | NA | NA | OFF | NA | 1.5
ddr_addr[8] | - | A5/5 | Y | out | IOB7[A] | - | SSTL15 | 8 | NONE | NA | NA | NA | NA | NA | NA | 1.5
ddr_addr[9] | - | F9/6 | Y | out | IOL31[A] | - | SSTL15 | 8 | NONE | NA | NA | NA | NA | OFF | NA | 1.5
ddr_addr[10] | - | K3/4 | Y | out | IOB36[A] | - | SSTL15 | 8 | NONE | NA | NA | NA | NA | NA | NA | 1.5
ddr_addr[11] | - | B7/6 | Y | out | IOL40[A] | - | SSTL15 | 8 | NONE | NA | NA | NA | NA | OFF | NA | 1.5
ddr_addr[12] | - | A3/5 | Y | out | IOB4[A] | - | SSTL15 | 8 | NONE | NA | NA | NA | NA | NA | NA | 1.5
ddr_bank[0] | - | H4/5 | Y | out | IOB26[A] | - | SSTL15 | 8 | NONE | NA | NA | NA | NA | NA | NA | 1.5
ddr_bank[1] | - | D3/5 | Y | out | IOB9[A] | - | SSTL15 | 8 | NONE | NA | NA | NA | NA | NA | NA | 1.5
ddr_bank[2] | - | H5/4 | Y | out | IOB35[A] | - | SSTL15 | 8 | NONE | NA | NA | NA | NA | NA | NA | 1.5
ddr_cs | - | P5/4 | Y | out | IOB50[A] | - | SSTL15 | 8 | NONE | NA | NA | NA | NA | NA | NA | 1.5
ddr_ras | - | R4/4 | Y | out | IOB52[A] | - | SSTL15 | 8 | NONE | NA | NA | NA | NA | NA | NA | 1.5
ddr_cas | - | R6/4 | Y | out | IOB54[A] | - | SSTL15 | 8 | NONE | NA | NA | NA | NA | NA | NA | 1.5
ddr_we | - | L2/4 | Y | out | IOB30[A] | GCLKT_4 | SSTL15 | 8 | NONE | NA | NA | NA | NA | NA | NA | 1.5
ddr_ck | ddr_ck_n | J1,J3/5 | Y | out | IOB27 | GCLKT_5 | SSTL15D | 8 | NONE | NA | NA | NA | NA | NA | NA | 1.5
ddr_cke | - | J2/4 | Y | out | IOB34[A] | - | SSTL15 | 8 | NONE | NA | NA | NA | NA | NA | NA | 1.5
ddr_odt | - | R3/4 | Y | out | IOB48[A] | - | SSTL15 | 8 | NONE | NA | NA | NA | NA | NA | NA | 1.5
ddr_reset_n | - | B9/6 | Y | out | IOL33[A] | - | SSTL15 | 8 | NONE | NA | NA | NA | NA | OFF | NA | 1.5
ddr_dm[0] | - | G1/5 | Y | out | IOB24[A] | - | SSTL15 | 8 | NONE | NA | NA | NA | NA | NA | NA | 1.5
ddr_dm[1] | - | K5/4 | Y | out | IOB40[A] | - | SSTL15 | 8 | NONE | NA | NA | NA | NA | NA | NA | 1.5
data[0] | - | T12/2 | Y | io | IOR17[B] | - | LVCMOS33 | 8 | NONE | NA | NONE | OFF | NA | OFF | NA | 3.3
data[1] | - | T11/2 | Y | io | IOR24[A] | - | LVCMOS33 | 8 | NONE | NA | NONE | OFF | NA | OFF | NA | 3.3
data[2] | - | P11/2 | Y | io | IOR24[B] | - | LVCMOS33 | 8 | NONE | NA | NONE | OFF | NA | OFF | NA | 3.3
data[3] | - | R11/2 | Y | io | IOR17[A] | - | LVCMOS33 | 8 | NONE | NA | NONE | OFF | NA | OFF | NA | 3.3
data[4] | - | M15/1 | Y | io | IOT40[B] | - | LVCMOS33 | 8 | NONE | NA | NONE | OFF | NA | NA | NA | 3.3
data[5] | - | M14/1 | Y | io | IOT40[A] | - | LVCMOS33 | 8 | NONE | NA | NONE | OFF | NA | NA | NA | 3.3
data[6] | - | J16/0 | Y | io | IOT22[A] | - | LVCMOS33 | 8 | NONE | NA | NONE | OFF | NA | NA | NA | 3.3
data[7] | - | J14/0 | Y | io | IOT22[B] | - | LVCMOS33 | 8 | NONE | NA | NONE | OFF | NA | NA | NA | 3.3
ddr_dq[0] | - | G5/5 | Y | io | IOB20[A] | - | SSTL15 | 8 | NONE | NA | NA | NA | INTERNAL | NA | NA | 1.5
ddr_dq[1] | - | F5/5 | Y | io | IOB22[A] | - | SSTL15 | 8 | NONE | NA | NA | NA | INTERNAL | NA | NA | 1.5
ddr_dq[2] | - | F4/5 | Y | io | IOB18[A] | - | SSTL15 | 8 | NONE | NA | NA | NA | INTERNAL | NA | NA | 1.5
ddr_dq[3] | - | F3/5 | Y | io | IOB19[A] | - | SSTL15 | 8 | NONE | NA | NA | NA | INTERNAL | NA | NA | 1.5
ddr_dq[4] | - | E2/5 | Y | io | IOB12[A] | - | SSTL15 | 8 | NONE | NA | NA | NA | INTERNAL | NA | NA | 1.5
ddr_dq[5] | - | C1/5 | Y | io | IOB14[A] | - | SSTL15 | 8 | NONE | NA | NA | NA | INTERNAL | NA | NA | 1.5
ddr_dq[6] | - | E1/5 | Y | io | IOB16[A] | - | SSTL15 | 8 | NONE | NA | NA | NA | INTERNAL | NA | NA | 1.5
ddr_dq[7] | - | B3/5 | Y | io | IOB13[A] | - | SSTL15 | 8 | NONE | NA | NA | NA | INTERNAL | NA | NA | 1.5
ddr_dq[8] | - | M3/4 | Y | io | IOB42[A] | - | SSTL15 | 8 | NONE | NA | NA | NA | INTERNAL | NA | NA | 1.5
ddr_dq[9] | - | K4/4 | Y | io | IOB39[A] | - | SSTL15 | 8 | NONE | NA | NA | NA | INTERNAL | NA | NA | 1.5
ddr_dq[10] | - | N2/4 | Y | io | IOB41[A] | - | SSTL15 | 8 | NONE | NA | NA | NA | INTERNAL | NA | NA | 1.5
ddr_dq[11] | - | L1/4 | Y | io | IOB38[A] | - | SSTL15 | 8 | NONE | NA | NA | NA | INTERNAL | NA | NA | 1.5
ddr_dq[12] | - | P4/4 | Y | io | IOB45[A] | - | SSTL15 | 8 | NONE | NA | NA | NA | INTERNAL | NA | NA | 1.5
ddr_dq[13] | - | H3/4 | Y | io | IOB32[A] | - | SSTL15 | 8 | NONE | NA | NA | NA | INTERNAL | NA | NA | 1.5
ddr_dq[14] | - | R1/4 | Y | io | IOB44[A] | - | SSTL15 | 8 | NONE | NA | NA | NA | INTERNAL | NA | NA | 1.5
ddr_dq[15] | - | M2/4 | Y | io | IOB43[A] | - | SSTL15 | 8 | NONE | NA | NA | NA | INTERNAL | NA | NA | 1.5
ddr_dqs[0] | ddr_dqs_n[0] | G2,G3/5 | Y | io | IOB21 | - | SSTL15D | 8 | NONE | NA | NA | NA | NA | NA | NA | 1.5
ddr_dqs[1] | ddr_dqs_n[1] | J5,K6/4 | Y | io | IOB37 | - | SSTL15D | 8 | NONE | NA | NA | NA | NA | NA | NA | 1.5

## All Package Pins:

Loc./Bank | Signal | Dir. | Site | CFG | IO Type | Drive | Pull Mode | PCI Clamp | Hysteresis | Open Drain | Vref | Single Resistor | Diff Resistor | Bank Vccio
L15/0 | - | in | IOT2[A] | - | UNKNOWN | NA | UP | ON | NONE | NA | NA | NA | NA | 3.3
D16/0 | - | in | IOT4[A] | - | UNKNOWN | NA | UP | ON | NONE | NA | NA | NA | NA | 3.3
E14/0 | - | in | IOT4[B] | - | UNKNOWN | NA | UP | ON | NONE | NA | NA | NA | NA | 3.3
C16/0 | - | in | IOT5[A] | - | UNKNOWN | NA | UP | ON | NONE | NA | NA | NA | NA | 3.3
D15/0 | - | in | IOT5[B] | - | UNKNOWN | NA | UP | ON | NONE | NA | NA | NA | NA | 3.3
E16/0 | - | in | IOT6[A] | - | UNKNOWN | NA | UP | ON | NONE | NA | NA | NA | NA | 3.3
F15/0 | - | in | IOT6[B] | - | UNKNOWN | NA | UP | ON | NONE | NA | NA | NA | NA | 3.3
F13/0 | - | in | IOT8[A] | - | UNKNOWN | NA | UP | ON | NONE | NA | NA | NA | NA | 3.3
G12/0 | - | in | IOT8[B] | - | UNKNOWN | NA | UP | ON | NONE | NA | NA | NA | NA | 3.3
F14/0 | - | in | IOT9[A] | - | UNKNOWN | NA | UP | ON | NONE | NA | NA | NA | NA | 3.3
F16/0 | - | in | IOT9[B] | - | UNKNOWN | NA | UP | ON | NONE | NA | NA | NA | NA | 3.3
F12/0 | - | in | IOT12[A] | - | UNKNOWN | NA | UP | ON | NONE | NA | NA | NA | NA | 3.3
G13/0 | - | in | IOT12[B] | - | UNKNOWN | NA | UP | ON | NONE | NA | NA | NA | NA | 3.3
G15/0 | - | in | IOT13[A] | - | UNKNOWN | NA | UP | ON | NONE | NA | NA | NA | NA | 3.3
G14/0 | - | in | IOT13[B] | - | UNKNOWN | NA | UP | ON | NONE | NA | NA | NA | NA | 3.3
G11/0 | - | in | IOT14[A] | - | UNKNOWN | NA | UP | ON | NONE | NA | NA | NA | NA | 3.3
H12/0 | - | in | IOT14[B] | - | UNKNOWN | NA | UP | ON | NONE | NA | NA | NA | NA | 3.3
G16/0 | - | in | IOT16[A] | - | UNKNOWN | NA | UP | ON | NONE | NA | NA | NA | NA | 3.3
H15/0 | - | in | IOT16[B] | - | UNKNOWN | NA | UP | ON | NONE | NA | NA | NA | NA | 3.3
H13/0 | - | in | IOT18[A] | - | UNKNOWN | NA | UP | ON | NONE | NA | NA | NA | NA | 3.3
J12/0 | - | in | IOT18[B] | - | UNKNOWN | NA | UP | ON | NONE | NA | NA | NA | NA | 3.3
H14/0 | - | in | IOT20[A] | - | UNKNOWN | NA | UP | ON | NONE | NA | NA | NA | NA | 3.3
H16/0 | - | in | IOT20[B] | - | UNKNOWN | NA | UP | ON | NONE | NA | NA | NA | NA | 3.3
J16/0 | data[6] | io | IOT22[A] | - | LVCMOS33 | 8 | NONE | NA | NONE | OFF | NA | NA | NA | 3.3
J14/0 | data[7] | io | IOT22[B] | - | LVCMOS33 | 8 | NONE | NA | NONE | OFF | NA | NA | NA | 3.3
J15/0 | - | in | IOT24[A] | - | UNKNOWN | NA | UP | ON | NONE | NA | NA | NA | NA | 3.3
K16/0 | - | in | IOT24[B] | - | UNKNOWN | NA | UP | ON | NONE | NA | NA | NA | NA | 3.3
H11/0 | sys_clk | in | IOT27[A] | GCLKT_0 | LVCMOS33 | NA | UP | ON | NONE | NA | NA | NA | NA | 3.3
J13/0 | - | in | IOT27[B] | GCLKC_0 | UNKNOWN | NA | UP | ON | NONE | NA | NA | NA | NA | 3.3
K14/1 | - | in | IOT30[A] | GCLKT_1 | UNKNOWN | NA | UP | ON | NONE | NA | NA | NA | NA | 3.3
K15/1 | - | in | IOT30[B] | GCLKC_1 | UNKNOWN | NA | UP | ON | NONE | NA | NA | NA | NA | 3.3
J11/1 | - | in | IOT32[A] | - | UNKNOWN | NA | UP | ON | NONE | NA | NA | NA | NA | 3.3
L12/1 | - | in | IOT32[B] | - | UNKNOWN | NA | UP | ON | NONE | NA | NA | NA | NA | 3.3
L16/1 | led[0] | out | IOT34[A] | - | LVCMOS33 | 8 | UP | NA | NA | OFF | NA | NA | NA | 3.3
L14/1 | led[1] | out | IOT34[B] | - | LVCMOS33 | 8 | UP | NA | NA | OFF | NA | NA | NA | 3.3
K13/1 | - | in | IOT36[A] | - | UNKNOWN | NA | UP | ON | NONE | NA | NA | NA | NA | 3.3
K12/1 | - | in | IOT36[B] | - | UNKNOWN | NA | UP | ON | NONE | NA | NA | NA | NA | 3.3
K11/1 | - | in | IOT38[A] | - | UNKNOWN | NA | UP | ON | NONE | NA | NA | NA | NA | 3.3
L13/1 | - | in | IOT38[B] | - | UNKNOWN | NA | UP | ON | NONE | NA | NA | NA | NA | 3.3
M14/1 | data[5] | io | IOT40[A] | - | LVCMOS33 | 8 | NONE | NA | NONE | OFF | NA | NA | NA | 3.3
M15/1 | data[4] | io | IOT40[B] | - | LVCMOS33 | 8 | NONE | NA | NONE | OFF | NA | NA | NA | 3.3
D14/1 | - | in | IOT44[A] | - | UNKNOWN | NA | UP | ON | NONE | NA | NA | NA | NA | 3.3
E15/1 | - | in | IOT44[B] | - | UNKNOWN | NA | UP | ON | NONE | NA | NA | NA | NA | 3.3
N15/1 | - | in | IOT48[A] | - | UNKNOWN | NA | UP | ON | NONE | NA | NA | NA | NA | 3.3
P16/1 | - | in | IOT48[B] | - | UNKNOWN | NA | UP | ON | NONE | NA | NA | NA | NA | 3.3
N16/1 | led[3] | out | IOT52[A] | - | LVCMOS33 | 8 | UP | NA | NA | OFF | NA | NA | NA | 3.3
N14/1 | led[2] | out | IOT52[B] | - | LVCMOS33 | 8 | UP | NA | NA | OFF | NA | NA | NA | 3.3
P15/1 | - | in | IOT54[A] | - | UNKNOWN | NA | UP | ON | NONE | NA | NA | NA | NA | 3.3
R16/1 | - | in | IOT54[B] | - | UNKNOWN | NA | UP | ON | NONE | NA | NA | NA | NA | 3.3
A4/5 | ddr_addr[1] | out | IOB2[A] | - | SSTL15 | 8 | NONE | NA | NA | NA | NA | NA | NA | 1.5
C5/5 | - | in | IOB2[B] | - | UNKNOWN | NA | UP | ON | NONE | NA | NA | NA | NA | 1.5
D6/5 | ddr_addr[2] | out | IOB3[A] | - | SSTL15 | 8 | NONE | NA | NA | NA | NA | NA | NA | 1.5
E7/5 | - | in | IOB3[B] | - | UNKNOWN | NA | UP | ON | NONE | NA | NA | NA | NA | 1.5
A3/5 | ddr_addr[12] | out | IOB4[A] | - | SSTL15 | 8 | NONE | NA | NA | NA | NA | NA | NA | 1.5
B4/5 | - | in | IOB4[B] | - | UNKNOWN | NA | UP | ON | NONE | NA | NA | NA | NA | 1.5
A5/5 | ddr_addr[8] | out | IOB7[A] | - | SSTL15 | 8 | NONE | NA | NA | NA | NA | NA | NA | 1.5
B6/5 | - | in | IOB7[B] | - | UNKNOWN | NA | UP | ON | NONE | NA | NA | NA | NA | 1.5
B1/5 | ddr_addr[6] | out | IOB8[A] | - | SSTL15 | 8 | NONE | NA | NA | NA | NA | NA | NA | 1.5
C2/5 | - | in | IOB8[B] | - | UNKNOWN | NA | UP | ON | NONE | NA | NA | NA | NA | 1.5
D3/5 | ddr_bank[1] | out | IOB9[A] | - | SSTL15 | 8 | NONE | NA | NA | NA | NA | NA | NA | 1.5
D1/5 | - | in | IOB9[B] | - | UNKNOWN | NA | UP | ON | NONE | NA | NA | NA | NA | 1.5
E2/5 | ddr_dq[4] | io | IOB12[A] | - | SSTL15 | 8 | NONE | NA | NA | NA | INTERNAL | NA | NA | 1.5
E3/5 | - | in | IOB12[B] | - | UNKNOWN | NA | UP | ON | NONE | NA | NA | NA | NA | 1.5
B3/5 | ddr_dq[7] | io | IOB13[A] | - | SSTL15 | 8 | NONE | NA | NA | NA | INTERNAL | NA | NA | 1.5
A2/5 | - | in | IOB13[B] | - | UNKNOWN | NA | UP | ON | NONE | NA | NA | NA | NA | 1.5
C1/5 | ddr_dq[5] | io | IOB14[A] | - | SSTL15 | 8 | NONE | NA | NA | NA | INTERNAL | NA | NA | 1.5
D2/5 | - | in | IOB14[B] | - | UNKNOWN | NA | UP | ON | NONE | NA | NA | NA | NA | 1.5
E1/5 | ddr_dq[6] | io | IOB16[A] | - | SSTL15 | 8 | NONE | NA | NA | NA | INTERNAL | NA | NA | 1.5
F2/5 | - | in | IOB16[B] | - | UNKNOWN | NA | UP | ON | NONE | NA | NA | NA | NA | 1.5
F4/5 | ddr_dq[2] | io | IOB18[A] | - | SSTL15 | 8 | NONE | NA | NA | NA | INTERNAL | NA | NA | 1.5
G6/5 | - | in | IOB18[B] | - | UNKNOWN | NA | UP | ON | NONE | NA | NA | NA | NA | 1.5
F3/5 | ddr_dq[3] | io | IOB19[A] | - | SSTL15 | 8 | NONE | NA | NA | NA | INTERNAL | NA | NA | 1.5
F1/5 | - | in | IOB19[B] | - | UNKNOWN | NA | UP | ON | NONE | NA | NA | NA | NA | 1.5
G5/5 | ddr_dq[0] | io | IOB20[A] | - | SSTL15 | 8 | NONE | NA | NA | NA | INTERNAL | NA | NA | 1.5
G4/5 | - | in | IOB20[B] | - | UNKNOWN | NA | UP | ON | NONE | NA | NA | NA | NA | 1.5
G2/5 | ddr_dqs[0] | io | IOB21[A] | - | SSTL15D | 8 | NONE | NA | NA | NA | NA | NA | NA | 1.5
G3/5 | ddr_dqs_n[0] | io | IOB21[B] | - | SSTL15D | 8 | NONE | NA | NA | NA | NA | NA | NA | 1.5
F5/5 | ddr_dq[1] | io | IOB22[A] | - | SSTL15 | 8 | NONE | NA | NA | NA | INTERNAL | NA | NA | 1.5
H6/5 | - | in | IOB22[B] | - | UNKNOWN | NA | UP | ON | NONE | NA | NA | NA | NA | 1.5
G1/5 | ddr_dm[0] | out | IOB24[A] | - | SSTL15 | 8 | NONE | NA | NA | NA | NA | NA | NA | 1.5
H2/5 | - | in | IOB24[B] | - | UNKNOWN | NA | UP | ON | NONE | NA | NA | NA | NA | 1.5
H4/5 | ddr_bank[0] | out | IOB26[A] | - | SSTL15 | 8 | NONE | NA | NA | NA | NA | NA | NA | 1.5
J6/5 | - | in | IOB26[B] | - | UNKNOWN | NA | UP | ON | NONE | NA | NA | NA | NA | 1.5
J1/5 | ddr_ck | out | IOB27[A] | GCLKT_5 | SSTL15D | 8 | NONE | NA | NA | NA | NA | NA | NA | 1.5
J3/5 | ddr_ck_n | out | IOB27[B] | GCLKC_5 | SSTL15D | 8 | NONE | NA | NA | NA | NA | NA | NA | 1.5
L2/4 | ddr_we | out | IOB30[A] | GCLKT_4 | SSTL15 | 8 | NONE | NA | NA | NA | NA | NA | NA | 1.5
M1/4 | - | in | IOB30[B] | GCLKC_4 | UNKNOWN | NA | UP | ON | NONE | NA | NA | NA | NA | 1.5
H3/4 | ddr_dq[13] | io | IOB32[A] | - | SSTL15 | 8 | NONE | NA | NA | NA | INTERNAL | NA | NA | 1.5
H1/4 | - | in | IOB32[B] | - | UNKNOWN | NA | UP | ON | NONE | NA | NA | NA | NA | 1.5
J2/4 | ddr_cke | out | IOB34[A] | - | SSTL15 | 8 | NONE | NA | NA | NA | NA | NA | NA | 1.5
K1/4 | - | in | IOB34[B] | - | UNKNOWN | NA | UP | ON | NONE | NA | NA | NA | NA | 1.5
H5/4 | ddr_bank[2] | out | IOB35[A] | - | SSTL15 | 8 | NONE | NA | NA | NA | NA | NA | NA | 1.5
J4/4 | - | in | IOB35[B] | - | UNKNOWN | NA | UP | ON | NONE | NA | NA | NA | NA | 1.5
K3/4 | ddr_addr[10] | out | IOB36[A] | - | SSTL15 | 8 | NONE | NA | NA | NA | NA | NA | NA | 1.5
K2/4 | - | in | IOB36[B] | - | UNKNOWN | NA | UP | ON | NONE | NA | NA | NA | NA | 1.5
J5/4 | ddr_dqs[1] | io | IOB37[A] | - | SSTL15D | 8 | NONE | NA | NA | NA | NA | NA | NA | 1.5
K6/4 | ddr_dqs_n[1] | io | IOB37[B] | - | SSTL15D | 8 | NONE | NA | NA | NA | NA | NA | NA | 1.5
L1/4 | ddr_dq[11] | io | IOB38[A] | - | SSTL15 | 8 | NONE | NA | NA | NA | INTERNAL | NA | NA | 1.5
L3/4 | - | in | IOB38[B] | - | UNKNOWN | NA | UP | ON | NONE | NA | NA | NA | NA | 1.5
K4/4 | ddr_dq[9] | io | IOB39[A] | - | SSTL15 | 8 | NONE | NA | NA | NA | INTERNAL | NA | NA | 1.5
L5/4 | - | in | IOB39[B] | - | UNKNOWN | NA | UP | ON | NONE | NA | NA | NA | NA | 1.5
K5/4 | ddr_dm[1] | out | IOB40[A] | - | SSTL15 | 8 | NONE | NA | NA | NA | NA | NA | NA | 1.5
L4/4 | - | in | IOB40[B] | - | UNKNOWN | NA | UP | ON | NONE | NA | NA | NA | NA | 1.5
N2/4 | ddr_dq[10] | io | IOB41[A] | - | SSTL15 | 8 | NONE | NA | NA | NA | INTERNAL | NA | NA | 1.5
P1/4 | - | in | IOB41[B] | - | UNKNOWN | NA | UP | ON | NONE | NA | NA | NA | NA | 1.5
M3/4 | ddr_dq[8] | io | IOB42[A] | - | SSTL15 | 8 | NONE | NA | NA | NA | INTERNAL | NA | NA | 1.5
N1/4 | - | in | IOB42[B] | - | UNKNOWN | NA | UP | ON | NONE | NA | NA | NA | NA | 1.5
M2/4 | ddr_dq[15] | io | IOB43[A] | - | SSTL15 | 8 | NONE | NA | NA | NA | INTERNAL | NA | NA | 1.5
N3/4 | - | in | IOB43[B] | - | UNKNOWN | NA | UP | ON | NONE | NA | NA | NA | NA | 1.5
R1/4 | ddr_dq[14] | io | IOB44[A] | - | SSTL15 | 8 | NONE | NA | NA | NA | INTERNAL | NA | NA | 1.5
P2/4 | - | in | IOB44[B] | - | UNKNOWN | NA | UP | ON | NONE | NA | NA | NA | NA | 1.5
P4/4 | ddr_dq[12] | io | IOB45[A] | - | SSTL15 | 8 | NONE | NA | NA | NA | INTERNAL | NA | NA | 1.5
T4/4 | - | in | IOB45[B] | - | UNKNOWN | NA | UP | ON | NONE | NA | NA | NA | NA | 1.5
R3/4 | ddr_odt | out | IOB48[A] | - | SSTL15 | 8 | NONE | NA | NA | NA | NA | NA | NA | 1.5
T2/4 | - | in | IOB48[B] | - | UNKNOWN | NA | UP | ON | NONE | NA | NA | NA | NA | 1.5
P5/4 | ddr_cs | out | IOB50[A] | - | SSTL15 | 8 | NONE | NA | NA | NA | NA | NA | NA | 1.5
R5/4 | - | in | IOB50[B] | - | UNKNOWN | NA | UP | ON | NONE | NA | NA | NA | NA | 1.5
R4/4 | ddr_ras | out | IOB52[A] | - | SSTL15 | 8 | NONE | NA | NA | NA | NA | NA | NA | 1.5
T3/4 | - | in | IOB52[B] | - | UNKNOWN | NA | UP | ON | NONE | NA | NA | NA | NA | 1.5
R6/4 | ddr_cas | out | IOB54[A] | - | SSTL15 | 8 | NONE | NA | NA | NA | NA | NA | NA | 1.5
T5/4 | - | in | IOB54[B] | - | UNKNOWN | NA | UP | ON | NONE | NA | NA | NA | NA | 1.5
B14/7 | - | in | IOL2[A] | - | UNKNOWN | NA | UP | ON | NONE | NA | NA | NA | NA | 1.8
A15/7 | - | in | IOL2[B] | - | UNKNOWN | NA | UP | ON | NONE | NA | NA | NA | NA | 1.8
C12/7 | - | in | IOL7[A] | LPLL1_T_in | UNKNOWN | NA | UP | ON | NONE | NA | NA | NA | NA | 1.8
B12/7 | - | in | IOL7[B] | LPLL1_C_in | UNKNOWN | NA | UP | ON | NONE | NA | NA | NA | NA | 1.8
B13/7 | - | in | IOL8[A] | LPLL1_T_fb | UNKNOWN | NA | UP | ON | NONE | NA | NA | NA | NA | 1.8
A14/7 | - | in | IOL8[B] | LPLL1_C_fb | UNKNOWN | NA | UP | ON | NONE | NA | NA | NA | NA | 1.8
F10/7 | - | in | IOL11[A] | - | UNKNOWN | NA | UP | ON | NONE | NA | NA | NA | NA | 1.8
B11/7 | - | in | IOL13[A] | - | UNKNOWN | NA | UP | ON | NONE | NA | NA | NA | NA | 1.8
A12/7 | - | in | IOL13[B] | - | UNKNOWN | NA | UP | ON | NONE | NA | NA | NA | NA | 1.8
A11/7 | - | in | IOL15[A] | - | UNKNOWN | NA | UP | ON | NONE | NA | NA | NA | NA | 1.8
C11/7 | - | in | IOL15[B] | - | UNKNOWN | NA | UP | ON | NONE | NA | NA | NA | NA | 1.8
D10/7 | - | in | IOL17[A] | - | UNKNOWN | NA | UP | ON | NONE | NA | NA | NA | NA | 1.8
E10/7 | - | in | IOL17[B] | - | UNKNOWN | NA | UP | ON | NONE | NA | NA | NA | NA | 1.8
D11/7 | - | in | IOL22[A] | - | UNKNOWN | NA | UP | ON | NONE | NA | NA | NA | NA | 1.8
A9/7 | - | in | IOL27[A] | GCLKT_7 | UNKNOWN | NA | UP | ON | NONE | NA | NA | NA | NA | 1.8
C9/7 | - | in | IOL27[B] | GCLKC_7 | UNKNOWN | NA | UP | ON | NONE | NA | NA | NA | NA | 1.8
C8/6 | - | in | IOL29[A] | GCLKT_6 | UNKNOWN | NA | UP | ON | NONE | NA | NA | NA | NA | 1.5
A8/6 | - | in | IOL29[B] | GCLKC_6 | UNKNOWN | NA | UP | ON | NONE | NA | NA | NA | NA | 1.5
F9/6 | ddr_addr[9] | out | IOL31[A] | - | SSTL15 | 8 | NONE | NA | NA | NA | NA | OFF | NA | 1.5
E11/6 | - | in | IOL31[B] | - | UNKNOWN | NA | UP | ON | NONE | NA | NA | NA | NA | 1.5
B9/6 | ddr_reset_n | out | IOL33[A] | - | SSTL15 | 8 | NONE | NA | NA | NA | NA | OFF | NA | 1.5
A10/6 | - | in | IOL33[B] | - | UNKNOWN | NA | UP | ON | NONE | NA | NA | NA | NA | 1.5
F8/6 | ddr_addr[3] | out | IOL35[A] | - | SSTL15 | 8 | NONE | NA | NA | NA | NA | OFF | NA | 1.5
D9/6 | - | in | IOL35[B] | - | UNKNOWN | NA | UP | ON | NONE | NA | NA | NA | NA | 1.5
D8/6 | ddr_addr[7] | out | IOL38[A] | - | SSTL15 | 8 | NONE | NA | NA | NA | NA | OFF | NA | 1.5
E9/6 | - | in | IOL38[B] | - | UNKNOWN | NA | UP | ON | NONE | NA | NA | NA | NA | 1.5
B7/6 | ddr_addr[11] | out | IOL40[A] | - | SSTL15 | 8 | NONE | NA | NA | NA | NA | OFF | NA | 1.5
C7/6 | arm_sw | in | IOL40[B] | - | LVCMOS15 | NA | DOWN | ON | NONE | NA | NA | OFF | NA | 1.5
F7/6 | ddr_addr[0] | out | IOL45[A] | LPLL2_T_in | SSTL15 | 8 | NONE | NA | NA | NA | NA | OFF | NA | 1.5
E8/6 | - | in | IOL45[B] | LPLL2_C_in | UNKNOWN | NA | UP | ON | NONE | NA | NA | NA | NA | 1.5
C4/6 | ddr_addr[4] | out | IOL47[A] | LPLL2_T_fb | SSTL15 | 8 | NONE | NA | NA | NA | NA | OFF | NA | 1.5
B5/6 | - | in | IOL47[B] | LPLL2_C_fb | UNKNOWN | NA | UP | ON | NONE | NA | NA | NA | NA | 1.5
E6/6 | ddr_addr[5] | out | IOL53[A] | - | SSTL15 | 8 | NONE | NA | NA | NA | NA | OFF | NA | 1.5
D7/6 | - | in | IOL53[B] | - | UNKNOWN | NA | UP | ON | NONE | NA | NA | NA | NA | 1.5
T15/2 | - | in | IOR7[A] | RPLL1_T_in | UNKNOWN | NA | UP | ON | NONE | NA | NA | NA | NA | 3.3
R14/2 | - | in | IOR7[B] | RPLL1_C_in | UNKNOWN | NA | UP | ON | NONE | NA | NA | NA | NA | 3.3
P12/2 | - | in | IOR8[A] | RPLL1_T_fb | UNKNOWN | NA | UP | ON | NONE | NA | NA | NA | NA | 3.3
T13/2 | - | in | IOR8[B] | RPLL1_C_fb | UNKNOWN | NA | UP | ON | NONE | NA | NA | NA | NA | 3.3
R12/2 | - | in | IOR11[A] | - | UNKNOWN | NA | UP | ON | NONE | NA | NA | NA | NA | 3.3
P13/2 | - | in | IOR11[B] | - | UNKNOWN | NA | UP | ON | NONE | NA | NA | NA | NA | 3.3
R11/2 | data[3] | io | IOR17[A] | - | LVCMOS33 | 8 | NONE | NA | NONE | OFF | NA | OFF | NA | 3.3
T12/2 | data[0] | io | IOR17[B] | - | LVCMOS33 | 8 | NONE | NA | NONE | OFF | NA | OFF | NA | 3.3
R13/2 | - | in | IOR20[A] | - | UNKNOWN | NA | UP | ON | NONE | NA | NA | NA | NA | 3.3
T14/2 | - | in | IOR20[B] | - | UNKNOWN | NA | UP | ON | NONE | NA | NA | NA | NA | 3.3
M10/2 | - | in | IOR22[A] | - | UNKNOWN | NA | UP | ON | NONE | NA | NA | NA | NA | 3.3
N11/2 | - | in | IOR22[B] | - | UNKNOWN | NA | UP | ON | NONE | NA | NA | NA | NA | 3.3
T11/2 | data[1] | io | IOR24[A] | - | LVCMOS33 | 8 | NONE | NA | NONE | OFF | NA | OFF | NA | 3.3
P11/2 | data[2] | io | IOR24[B] | - | LVCMOS33 | 8 | NONE | NA | NONE | OFF | NA | OFF | NA | 3.3
C6/2 | - | out | IOR25[A] | TDO | UNKNOWN | 8 | UP | NA | NA | OFF | NA | NA | NA | 3.3
B8/2 | - | in | IOR25[B] | TMS | UNKNOWN | NA | UP | ON | NONE | NA | NA | NA | NA | 3.3
A7/2 | - | in | IOR26[A] | TCK | UNKNOWN | NA | UP | ON | NONE | NA | NA | NA | NA | 3.3
A6/2 | - | in | IOR26[B] | TDI | UNKNOWN | NA | UP | ON | NONE | NA | NA | NA | NA | 3.3
N10/2 | - | in | IOR27[A] | GCLKT_2 | UNKNOWN | NA | UP | ON | NONE | NA | NA | NA | NA | 3.3
M11/2 | - | in | IOR27[B] | GCLKC_2 | UNKNOWN | NA | UP | ON | NONE | NA | NA | NA | NA | 3.3
T7/3 | bus_clk | in | IOR29[A] | GCLKT_3 | LVCMOS33 | NA | DOWN | ON | NONE | NA | NA | OFF | NA | 3.3
R8/3 | - | in | IOR29[B] | GCLKC_3 | UNKNOWN | NA | UP | ON | NONE | NA | NA | NA | NA | 3.3
M16/3 | - | in | IOR30[A] | MODE0 | UNKNOWN | NA | UP | ON | NONE | NA | NA | NA | NA | 3.3
B16/3 | - | in | IOR30[B] | MODE1 | UNKNOWN | NA | UP | ON | NONE | NA | NA | NA | NA | 3.3
C15/3 | - | in | IOR31[A] | MODE2 | UNKNOWN | NA | UP | ON | NONE | NA | NA | NA | NA | 3.3
B10/3 | - | in | IOR31[B] | RECONFIG_N | UNKNOWN | NA | UP | ON | NONE | NA | NA | NA | NA | 3.3
A13/3 | - | in | IOR32[A] | READY | UNKNOWN | NA | UP | ON | NONE | NA | NA | NA | NA | 3.3
C13/3 | - | in | IOR32[B] | DONE | UNKNOWN | NA | UP | ON | NONE | NA | NA | NA | NA | 3.3
P10/3 | - | in | IOR33[A] | MI/D7 | UNKNOWN | NA | UP | ON | NONE | NA | NA | NA | NA | 3.3
R10/3 | - | in | IOR33[B] | MO/D6 | UNKNOWN | NA | UP | ON | NONE | NA | NA | NA | NA | 3.3
M9/3 | - | in | IOR34[A] | MCS_N/D5 | UNKNOWN | NA | UP | ON | NONE | NA | NA | NA | NA | 3.3
L10/3 | - | in | IOR34[B] | MCLK/D4 | UNKNOWN | NA | UP | ON | NONE | NA | NA | NA | NA | 3.3
R9/3 | - | in | IOR35[A] | FASTRD_N/D3 | UNKNOWN | NA | UP | ON | NONE | NA | NA | NA | NA | 3.3
T10/3 | reset_n | in | IOR35[B] | SI/D2 | LVCMOS33 | NA | UP | ON | NONE | NA | NA | OFF | NA | 3.3
M8/3 | - | in | IOR36[A] | SO/D1 | UNKNOWN | NA | UP | ON | NONE | NA | NA | NA | NA | 3.3
N9/3 | aux[0] | in | IOR36[B] | SSPI_CS_N/D0 | LVCMOS33 | NA | DOWN | ON | NONE | NA | NA | OFF | NA | 3.3
T9/3 | - | in | IOR38[A] | DIN/CLKHOLD_N | UNKNOWN | NA | UP | ON | NONE | NA | NA | NA | NA | 3.3
P9/3 | - | in | IOR38[B] | DOUT/WE_N | UNKNOWN | NA | UP | ON | NONE | NA | NA | NA | NA | 3.3
C10/3 | - | in | IOR39[A] | SCLK | UNKNOWN | NA | UP | ON | NONE | NA | NA | NA | NA | 3.3
N8/3 | dir | in | IOR40[A] | - | LVCMOS33 | NA | DOWN | ON | NONE | NA | NA | OFF | NA | 3.3
L9/3 | ready | out | IOR40[B] | - | LVCMOS33 | 8 | DOWN | NA | NA | OFF | NA | OFF | NA | 3.3
P8/3 | aux[3] | in | IOR42[A] | - | LVCMOS33 | NA | DOWN | ON | NONE | NA | NA | OFF | NA | 3.3
T8/3 | - | in | IOR42[B] | - | UNKNOWN | NA | UP | ON | NONE | NA | NA | NA | NA | 3.3
M6/3 | - | in | IOR44[A] | - | UNKNOWN | NA | UP | ON | NONE | NA | NA | NA | NA | 3.3
L8/3 | - | in | IOR44[B] | - | UNKNOWN | NA | UP | ON | NONE | NA | NA | NA | NA | 3.3
M7/3 | - | in | IOR47[A] | RPLL2_T_fb | UNKNOWN | NA | UP | ON | NONE | NA | NA | NA | NA | 3.3
N7/3 | aux[1] | in | IOR47[B] | RPLL2_C_fb | LVCMOS33 | NA | DOWN | ON | NONE | NA | NA | OFF | NA | 3.3
R7/3 | - | in | IOR49[A] | - | UNKNOWN | NA | UP | ON | NONE | NA | NA | NA | NA | 3.3
P7/3 | - | in | IOR49[B] | - | UNKNOWN | NA | UP | ON | NONE | NA | NA | NA | NA | 3.3
N6/3 | aux[2] | in | IOR51[A] | - | LVCMOS33 | NA | DOWN | ON | NONE | NA | NA | OFF | NA | 3.3
P6/3 | - | in | IOR53[A] | - | UNKNOWN | NA | UP | ON | NONE | NA | NA | NA | NA | 3.3
T6/3 | - | in | IOR53[B] | - | UNKNOWN | NA | UP | ON | NONE | NA | NA | NA | NA | 3.3
