airpocket-soundman/tab5-tang-primer20k-carrier/docs/validation/rtdetr-performance-budget-2026-11-07/per-layer.csv

node | op | name | A | B | output | conv_tile_commands | matrix_panel_commands | internal_tiles | logical_MAC | engine_cycles | engine_seconds_27MHz | qA_write_bytes | qA_write_calls | qB_dynamic_write_bytes | INT32_C_logical_read_bytes | INT32_C_aligned_reply_bytes | output_FP32_logical_write_bytes
6 | Conv | /model/backbone/conv1/conv1_1/conv/Conv | [1, 3, 640, 640] | [32, 3, 3, 3] | [1, 32, 320, 320] | 1600 | 0 | 1600 | 88473600 | 23347200 | 0.8647111111111111 | 1228800 | 5760 | 0 | 13107200 | 13107200 | 13107200
8 | Conv | /model/backbone/conv1/conv1_2/conv/Conv | [1, 32, 320, 320] | [32, 32, 3, 3] | [1, 32, 320, 320] | 3200 | 0 | 3200 | 943718400 | 238387200 | 8.829155555555555 | 3276800 | 20480 | 0 | 13107200 | 13107200 | 13107200
10 | Conv | /model/backbone/conv1/conv1_3/conv/Conv | [1, 32, 320, 320] | [64, 32, 3, 3] | [1, 64, 320, 320] | 6400 | 0 | 6400 | 1887436800 | 476774400 | 17.65831111111111 | 3276800 | 20480 | 0 | 26214400 | 26214400 | 26214400
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
