airpocket-soundman/tab5-tang-primer20k-carrier/spark/lcsc-lite-a/simulation/easyeda-wasm/results/spark-lite-a-PD-low-ENA.csv

time | vsource#branch | l1#branch | active | en | vin | v33raw | vcore | vout
2.000000000000000042e-08 | -2.379174892749337522e-05 | -1.400000044492729750e-12 | 0.000000000000000000e+00 | 5.171163918996719011e-08 | 2.643039370850526878e-07 | 1.510676754213908533e-17 | 4.871181336773544693e-10 | 4.597499137496123655e-08
4.555743221715290459e-08 | -2.787992485509330209e-05 | -1.400000034522647510e-12 | 0.000000000000000000e+00 | 6.873840756956932962e-08 | 3.513296432714703923e-07 | 1.642569638366346498e-17 | 1.028034187574997474e-09 | 3.493804558098813330e-08
2.233448774166637617e-07 | -6.606626974645091188e-05 | -1.400000004332035030e-12 | 0.000000000000000000e+00 | 2.527196687392616259e-07 | 1.291678323737537304e-06 | 1.499184225118321164e-17 | 2.307550928225160503e-09 | 4.696405525356464529e-09
7.001879928096545946e-07 | -3.736664209466611375e-04 | -1.400000006781756263e-12 | 0.000000000000000000e+00 | 2.064693063318805666e-06 | 1.055287579460898903e-05 | 8.341704126804566875e-18 | 3.055673076876810155e-09 | 7.150269179317134723e-09
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
