airpocket-soundman/tab5-tang-primer20k-carrier/spark/lcsc-lite-a/simulation/easyeda-wasm/results/spark-lite-a-Tab5-1A-budget.csv

time | vsource#branch | l1#branch | active | en | vin | v33raw | vcore | vout
2.000000000000000042e-08 | -1.120116246102831684e-05 | -1.400000045498749396e-12 | 0.000000000000000000e+00 | 2.628382749484062165e-08 | 1.343395645036627879e-07 | 4.992091709421269463e-19 | 4.946967050230009584e-10 | 4.669026910363106608e-08
4.555743221716449174e-08 | -1.134617675646511920e-05 | -1.400000035173002111e-12 | 0.000000000000000000e+00 | 3.310297869495599839e-08 | 1.691930044255292221e-07 | 5.430451432271319981e-19 | 1.044210463851819501e-09 | 3.550705665295588751e-08
2.234151870496202315e-07 | -1.195586945884272168e-05 | -1.400000004549289494e-12 | 0.000000000000000000e+00 | 7.923576500203548978e-08 | 4.049828041816768389e-07 | 4.970321861496112198e-19 | 2.348746932017548888e-09 | 4.831583531305390047e-09
6.035693812855922215e-07 | -1.419608254149551385e-05 | -1.400000007294172035e-12 | 0.000000000000000000e+00 | 1.805331395639548744e-07 | 9.227249475846452668e-07 | 2.701509389507412894e-19 | 2.913680116632023221e-09 | 7.581105392933800390e-09
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
