airpocket-soundman/tab5-tang-primer20k-carrier/spark/lcsc-lite-a/simulation/easyeda-wasm/results/spark-lite-a-Tab5-plus-Core1A.csv

time | vsource#branch | l1#branch | active | en | vin | v33raw | vcore | vout
2.000000000000000042e-08 | -1.332889123899878500e-05 | -1.400000044997154828e-12 | 0.000000000000000000e+00 | 2.927014096257059211e-08 | 1.496029446489257598e-07 | 1.534179824239634151e-17 | 4.946967050223995981e-10 | 4.669026910357430825e-08
4.555743221715290459e-08 | -1.539716572011330664e-05 | -1.400000035090691178e-12 | 0.000000000000000000e+00 | 3.877251153328544407e-08 | 1.981706170882930420e-07 | 1.668897447550423153e-17 | 1.044210463849489333e-09 | 3.550705665278202738e-08
2.234151870385190441e-07 | -3.204917876993562675e-05 | -1.400000004466983408e-12 | 0.000000000000000000e+00 | 1.318859255830603568e-07 | 6.740836284391479803e-07 | 1.527489521739441732e-17 | 2.348746931848292432e-09 | 4.831583528235568111e-09
6.936796168832533318e-07 | -1.140707807618102088e-04 | -1.400000007057265569e-12 | 0.000000000000000000e+00 | 7.419195285438128842e-07 | 3.792033195351900789e-06 | 8.602211636812576780e-18 | 3.118998311203354440e-09 | 7.426242188024751660e-09
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
