airpocket-soundman/tab5-tang-primer20k-carrier/spark/lcsc-lite-a/simulation/easyeda-wasm/results/spark-lite-a-high-supply-hot.csv

time | vsource#branch | l1#branch | active | en | vin | v33raw | vcore | vout
2.000000000000000042e-08 | -5.338489111710378876e-05 | -1.400000012406880081e-12 | 0.000000000000000000e+00 | 1.172317249463109048e-07 | 5.991843797632595877e-07 | 8.496607283047750672e-17 | 1.264418865337849693e-10 | 1.414240458735007259e-08
3.879896622841337084e-08 | -8.266440859478960124e-05 | -1.400000012075698451e-12 | 0.000000000000000000e+00 | 1.921278563592603610e-07 | 9.819868342002989106e-07 | 9.616296496444170248e-17 | 2.379843824187534624e-10 | 1.255066244097934739e-08
2.178125349326289584e-07 | -4.150576412253886849e-04 | -1.400000003134554576e-12 | 0.000000000000000000e+00 | 1.466133351300002122e-06 | 7.493570559942234536e-06 | 1.215998552240096465e-16 | 7.840253035614520610e-10 | 3.594406091781533992e-09
7.107207789833058485e-07 | -2.159159396522281060e-03 | -1.400000001244432336e-12 | 0.000000000000000000e+00 | 1.307545816861361807e-05 | 6.683012040016681485e-05 | 4.006825046809446669e-17 | 9.772986771776091256e-10 | 1.701088226601887801e-09
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
