airpocket-soundman/tab5-tang-primer20k-carrier/spark/lcsc-lite-a/simulation/easyeda-wasm/results/spark-lite-a-ldo-DCbias-minimum.csv

time | vsource#branch | l1#branch | active | en | vin | v33raw | vcore | vout
2.000000000000000042e-08 | -1.409049930377066079e-05 | -1.400000044492729750e-12 | 0.000000000000000000e+00 | 3.094262631901819207e-08 | 1.581512032489347442e-07 | 1.525502352673692525e-17 | 4.871181336773544693e-10 | 4.597499137496123655e-08
4.555743221715290459e-08 | -1.623329491043205841e-05 | -1.400000034522647510e-12 | 0.000000000000000000e+00 | 4.088807798916002337e-08 | 2.089835124482453263e-07 | 1.674200396627085641e-17 | 1.028034187574997474e-09 | 3.493804558098813330e-08
2.233448774166637617e-07 | -3.402591427681400660e-05 | -1.400000004332035030e-12 | 0.000000000000000000e+00 | 1.397209023163522469e-07 | 7.141290655983049509e-07 | 2.045181042638760134e-17 | 2.307550928225160503e-09 | 4.696405525356464529e-09
7.001879928096545946e-07 | -1.267947406777270025e-04 | -1.400000006781756263e-12 | 0.000000000000000000e+00 | 8.192968985301436361e-07 | 4.187517535996082698e-06 | 3.004930019738393703e-17 | 3.055673076876810155e-09 | 7.150269179317134723e-09
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
