airpocket-soundman/tab5-tang-primer20k-carrier/docs/validation/channel-map-2026-11-05/gpio-id-waveform.png

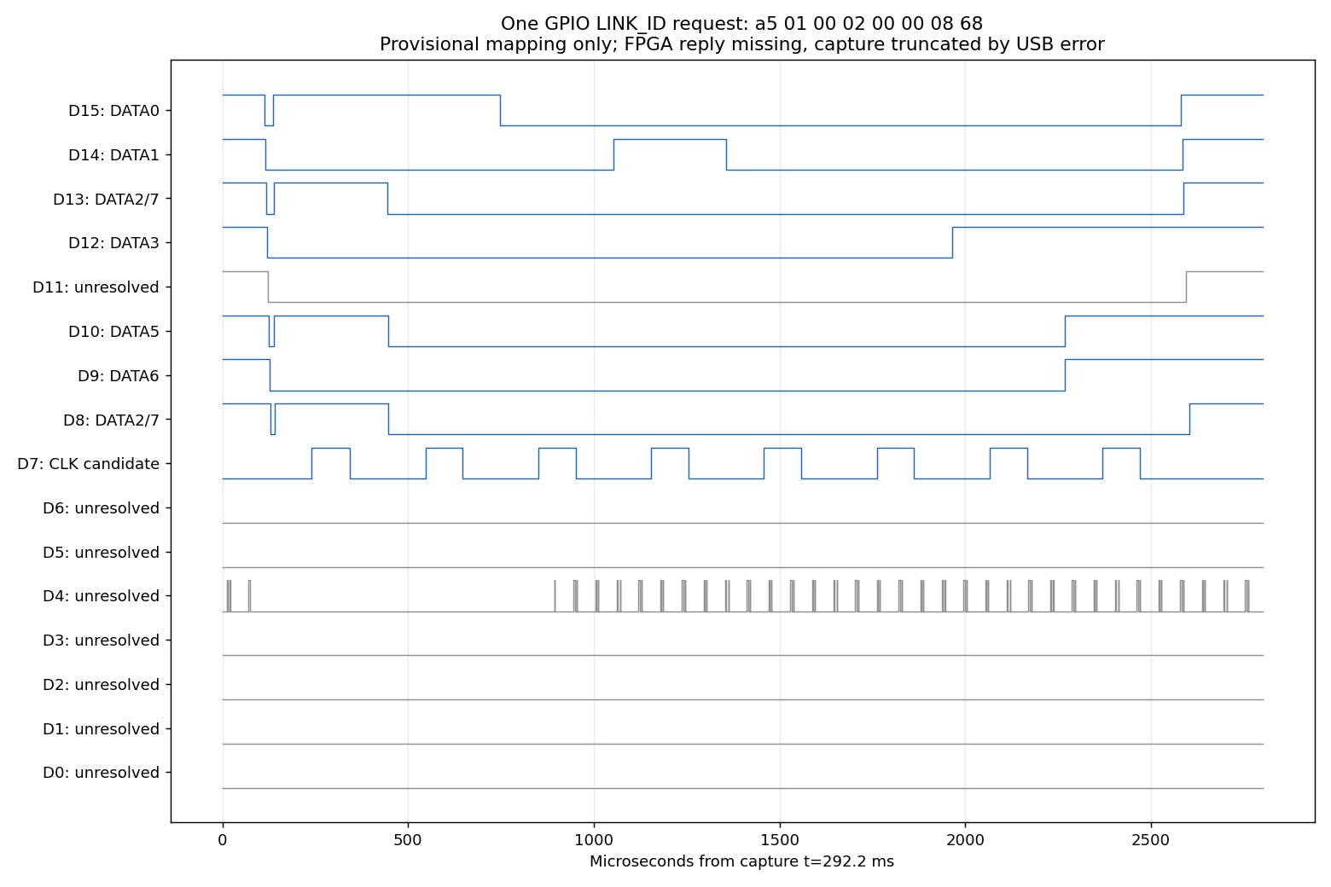
docs/validation/channel-map-2026-11-05/gpio-id-waveform.png
