airpocket-soundman/tab5-tang-primer20k-carrier/fpga/validation/npu-ddr-4e22-2026-11-07/physical/fullmodel-5m/display.png

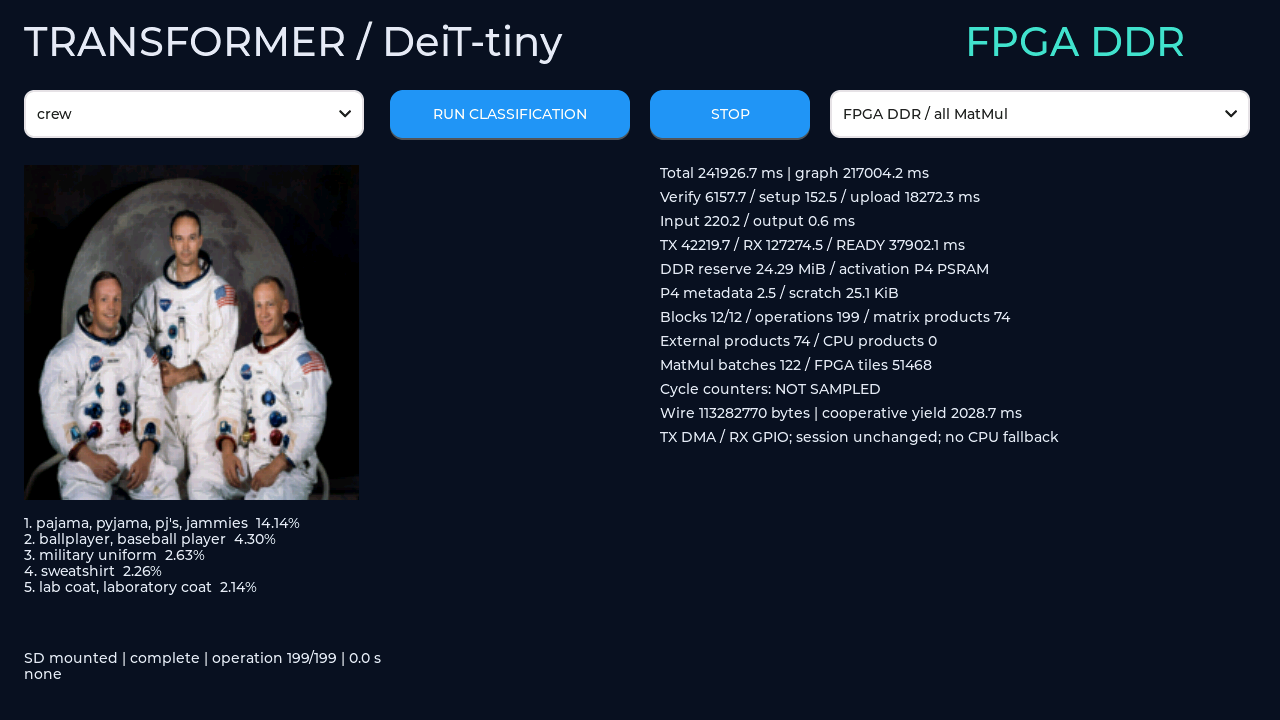
fpga/validation/npu-ddr-4e22-2026-11-07/physical/fullmodel-5m/display.png
