airpocket-soundman/tab5-tang-primer20k-carrier/fpga/validation/npu-ddr-matrix-4e24-physical-2026-11-07/host-physical/4e24-crew-astro-10m/WARM_ASTRO.png

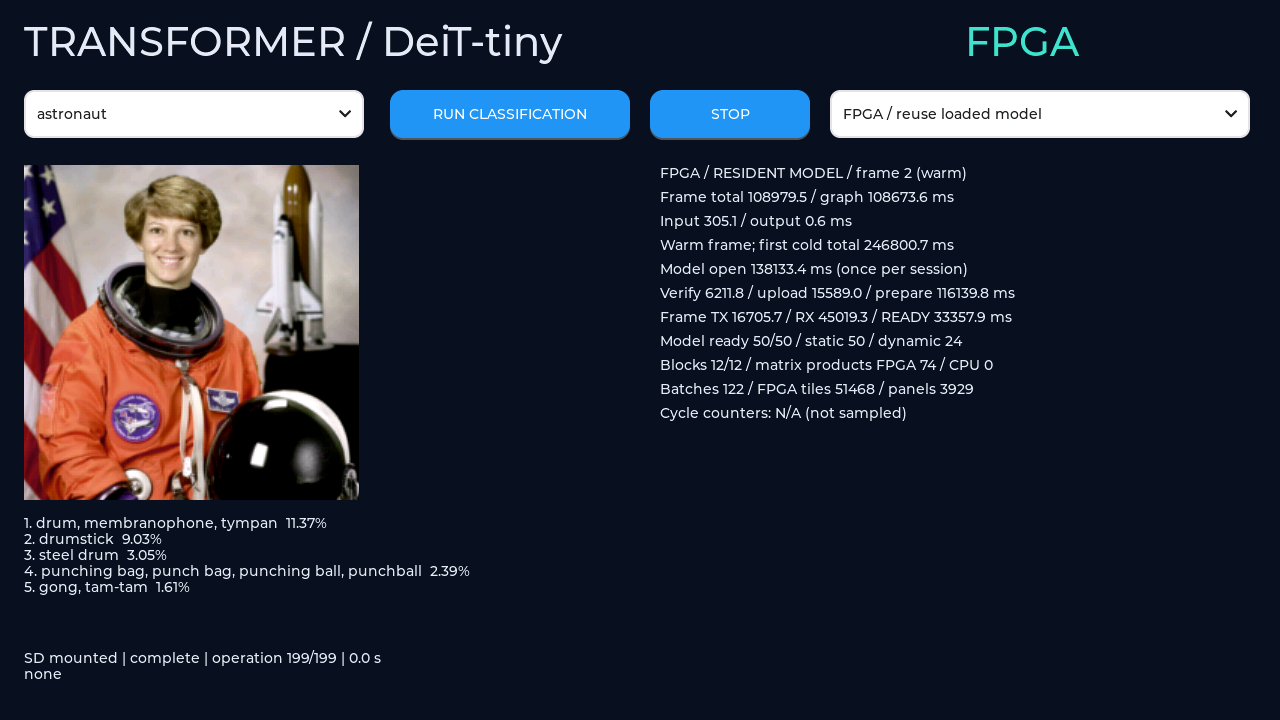
fpga/validation/npu-ddr-matrix-4e24-physical-2026-11-07/host-physical/4e24-crew-astro-10m/WARM_ASTRO.png
