airpocket-soundman/tab5-tang-primer20k-carrier/site/img/evaluation/power/results/lite-a-dual-power.png

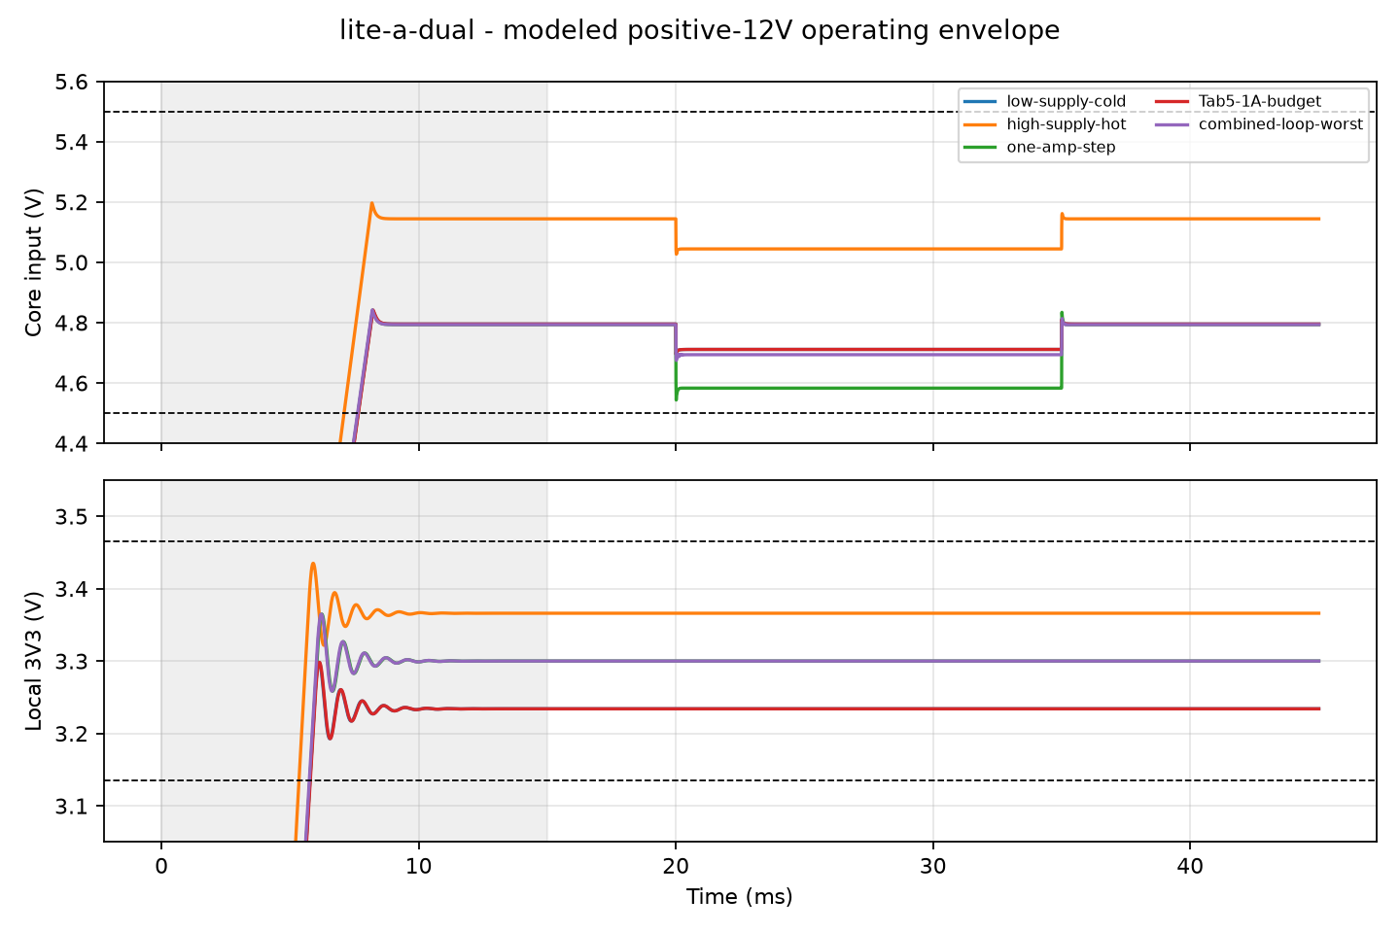
site/img/evaluation/power/results/lite-a-dual-power.png
