airpocket-soundman/tab5-tang-primer20k-carrier/variants/simulation/hdmi/results/lite-a-dual/480p-low_Z_fast-eye.png

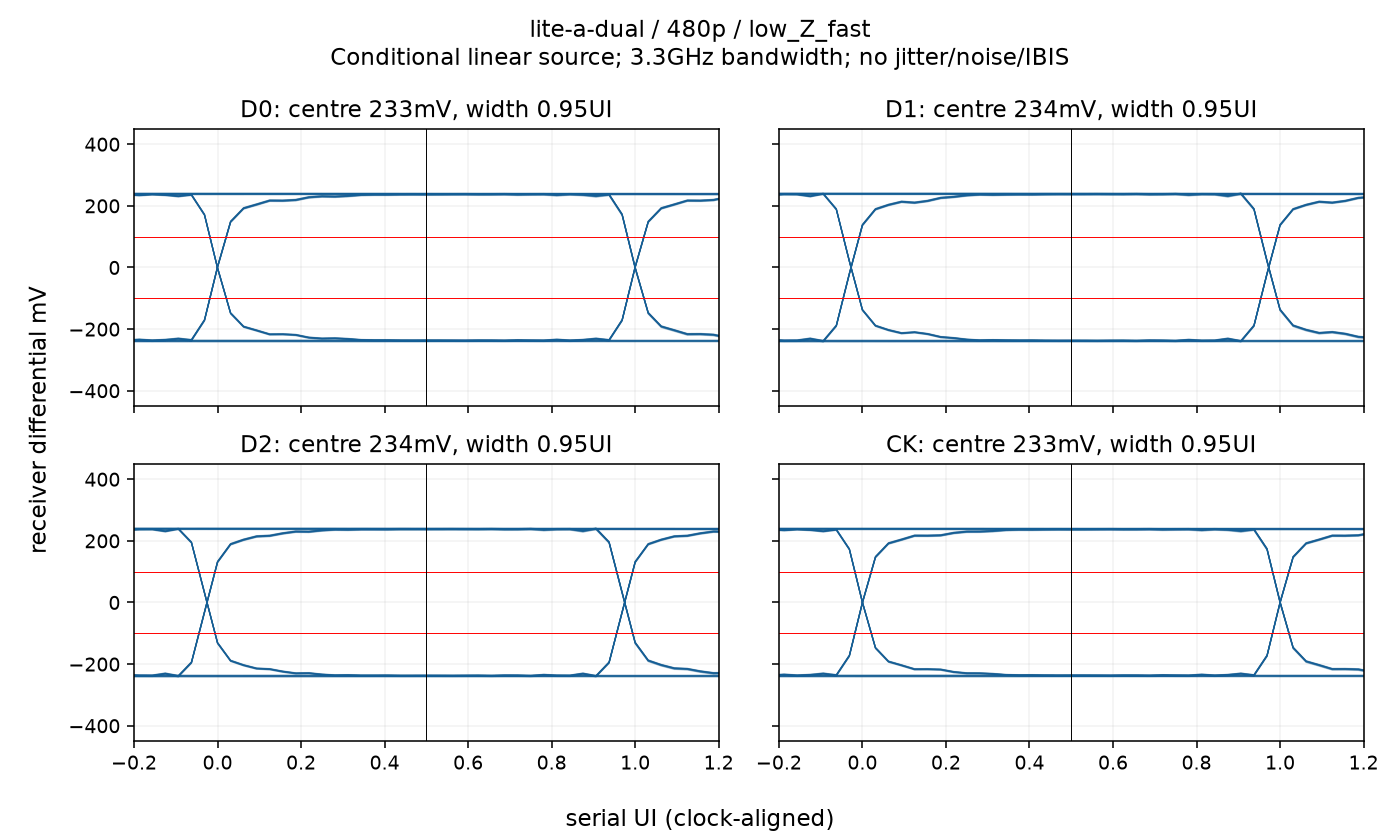
variants/simulation/hdmi/results/lite-a-dual/480p-low_Z_fast-eye.png
