airpocket-soundman/tab5-tang-primer20k-carrier/variants/simulation/hdmi/results/lite-a-dual/480p-nominal-eye.png

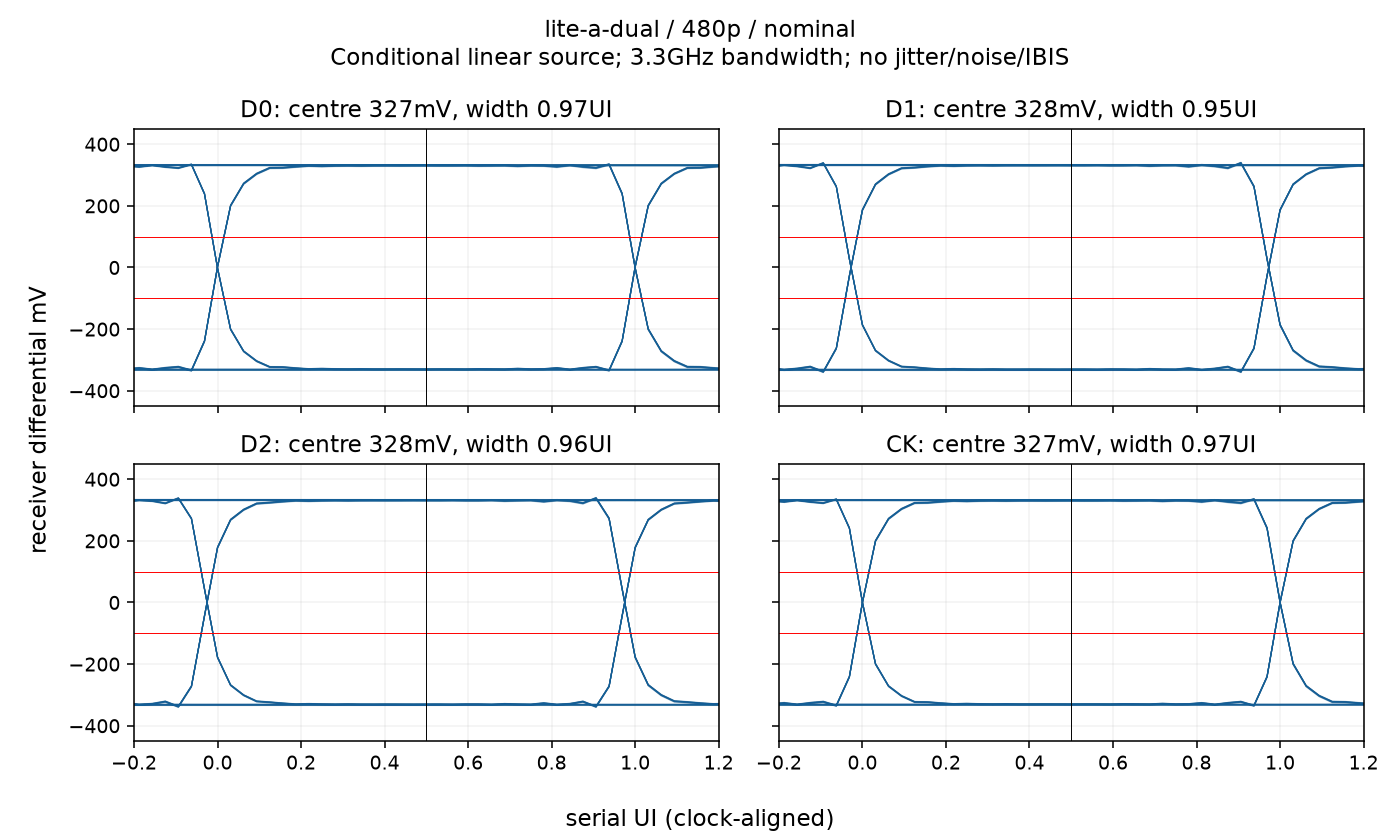
variants/simulation/hdmi/results/lite-a-dual/480p-nominal-eye.png
