airpocket-soundman/tab5-tang-primer20k-carrier/variants/simulation/hdmi/results/lite-a-dual/720p-weak_high_Rs-eye.png

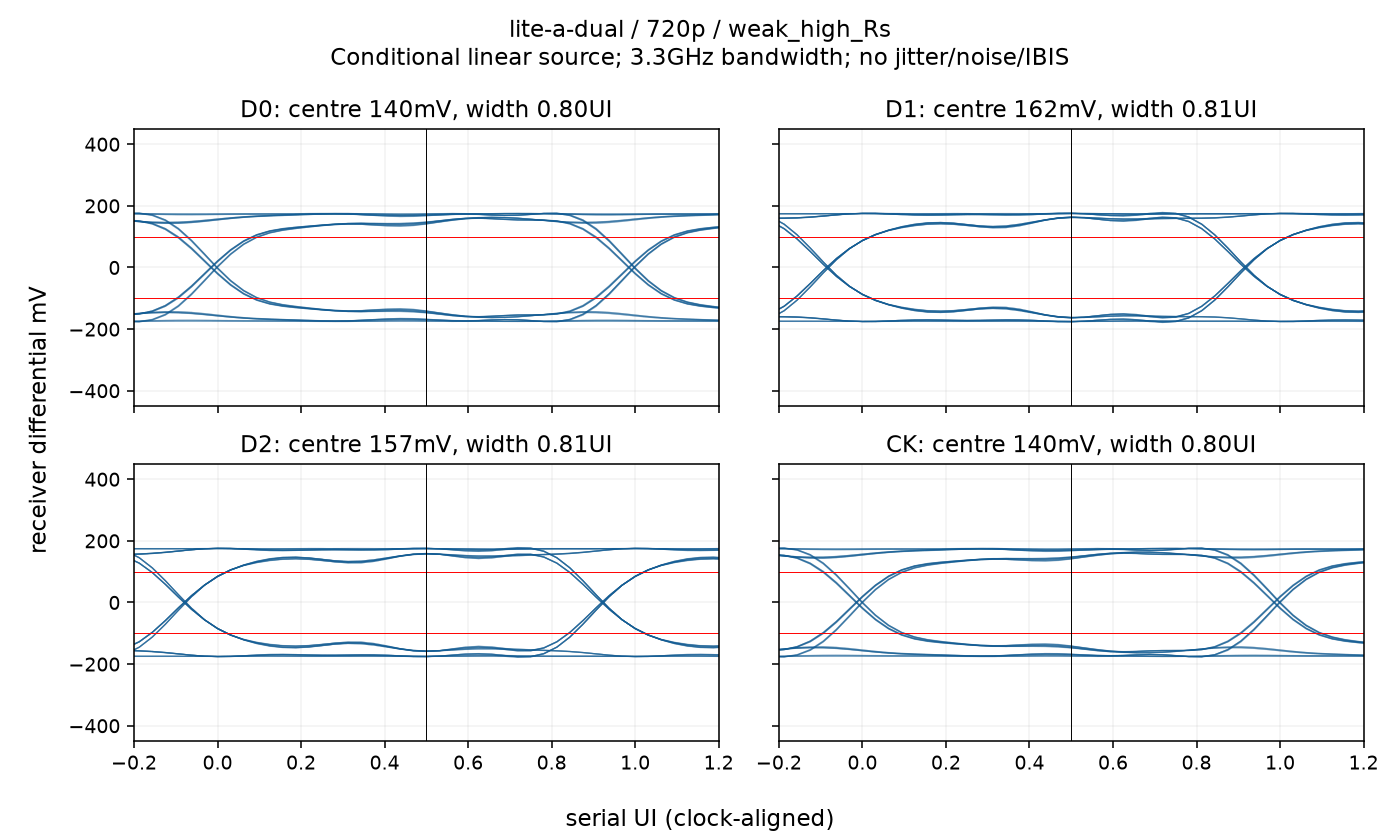
variants/simulation/hdmi/results/lite-a-dual/720p-weak_high_Rs-eye.png
