airpocket-soundman/tab5-tang-primer20k-carrier/variants/simulation/hdmi/results/lite-a-dual/720p-weak_slow_high_Rs-eye.png

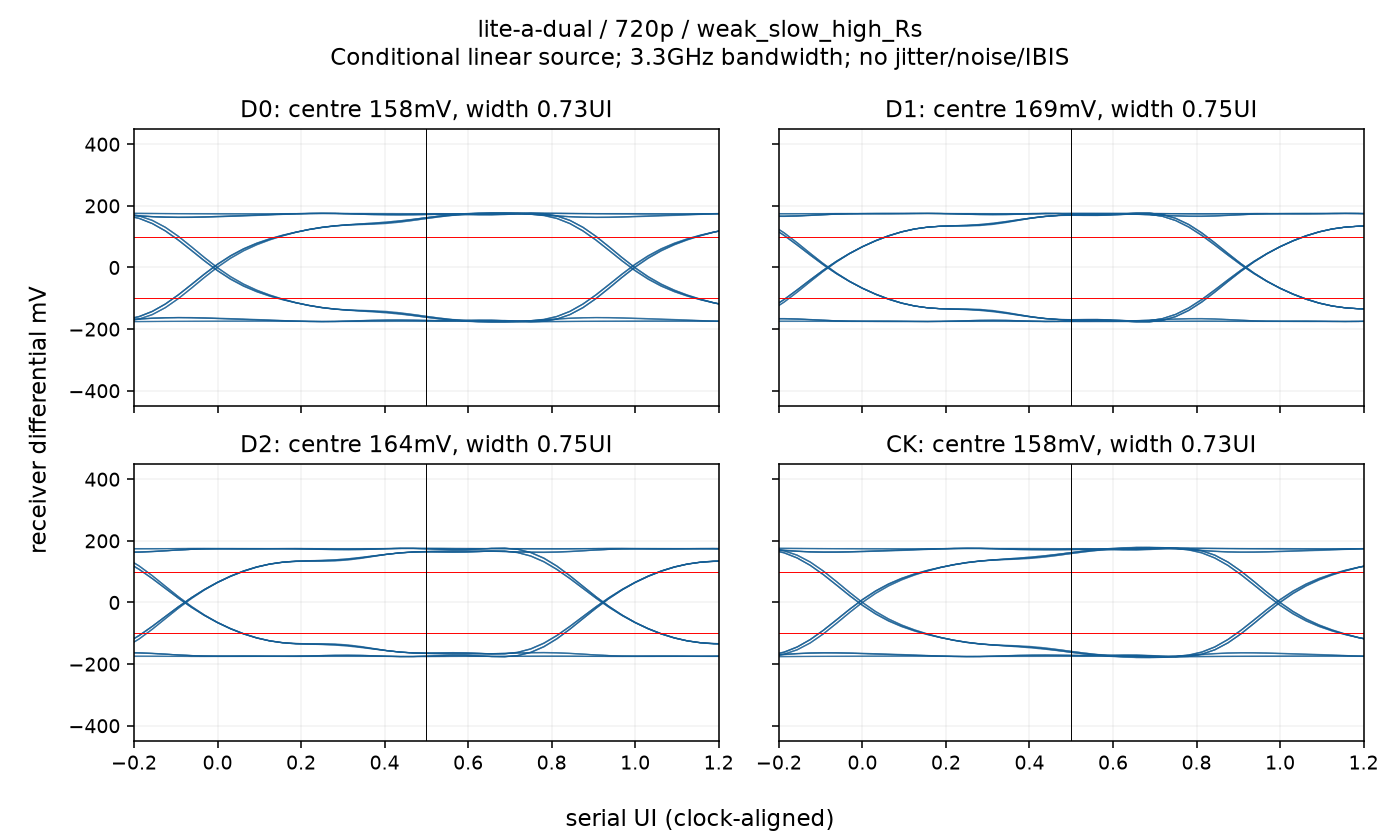
variants/simulation/hdmi/results/lite-a-dual/720p-weak_slow_high_Rs-eye.png
