airpocket-soundman/tab5-tang-primer20k-carrier/variants/simulation/hdmi/results/lite-b-barrel/480p-weak_high_Rs-eye.png

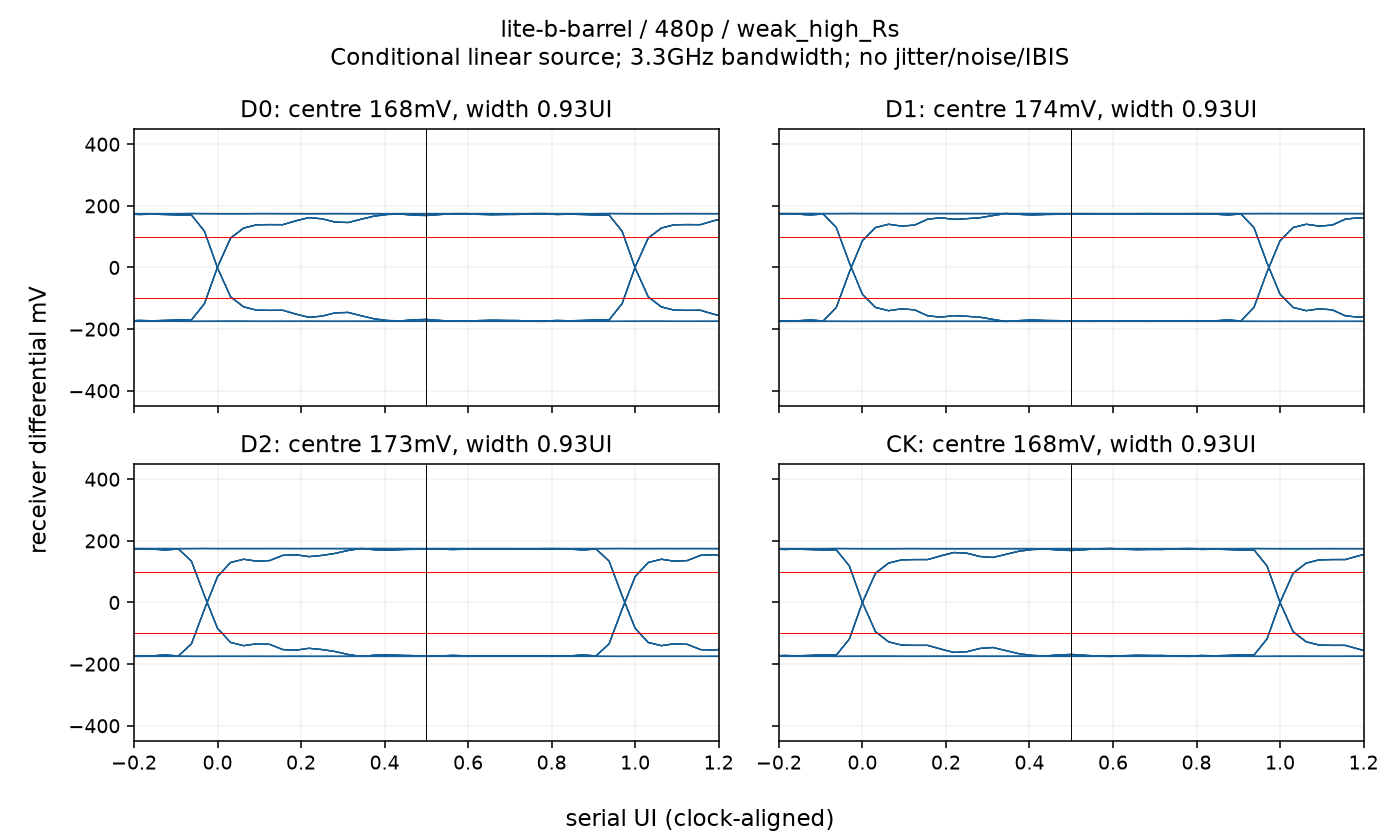
variants/simulation/hdmi/results/lite-b-barrel/480p-weak_high_Rs-eye.png
