airpocket-soundman/tab5-tang-primer20k-carrier/variants/simulation/hdmi/results/lite-b-barrel/720p-low_Z_fast-eye.png

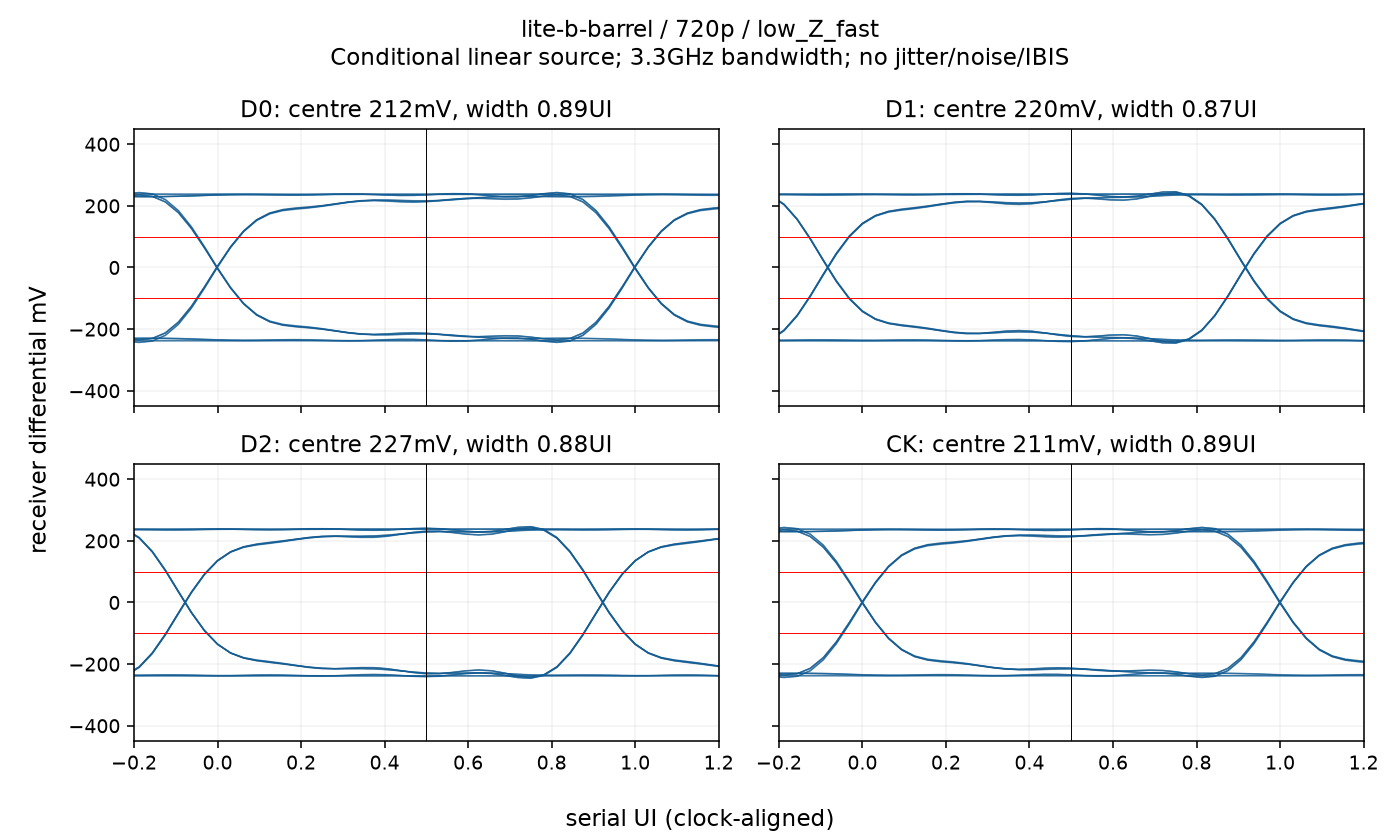
variants/simulation/hdmi/results/lite-b-barrel/720p-low_Z_fast-eye.png
