airpocket-soundman/tab5-tang-primer20k-carrier/variants/simulation/hdmi/results/lite-b-barrel/720p-nominal-eye.png

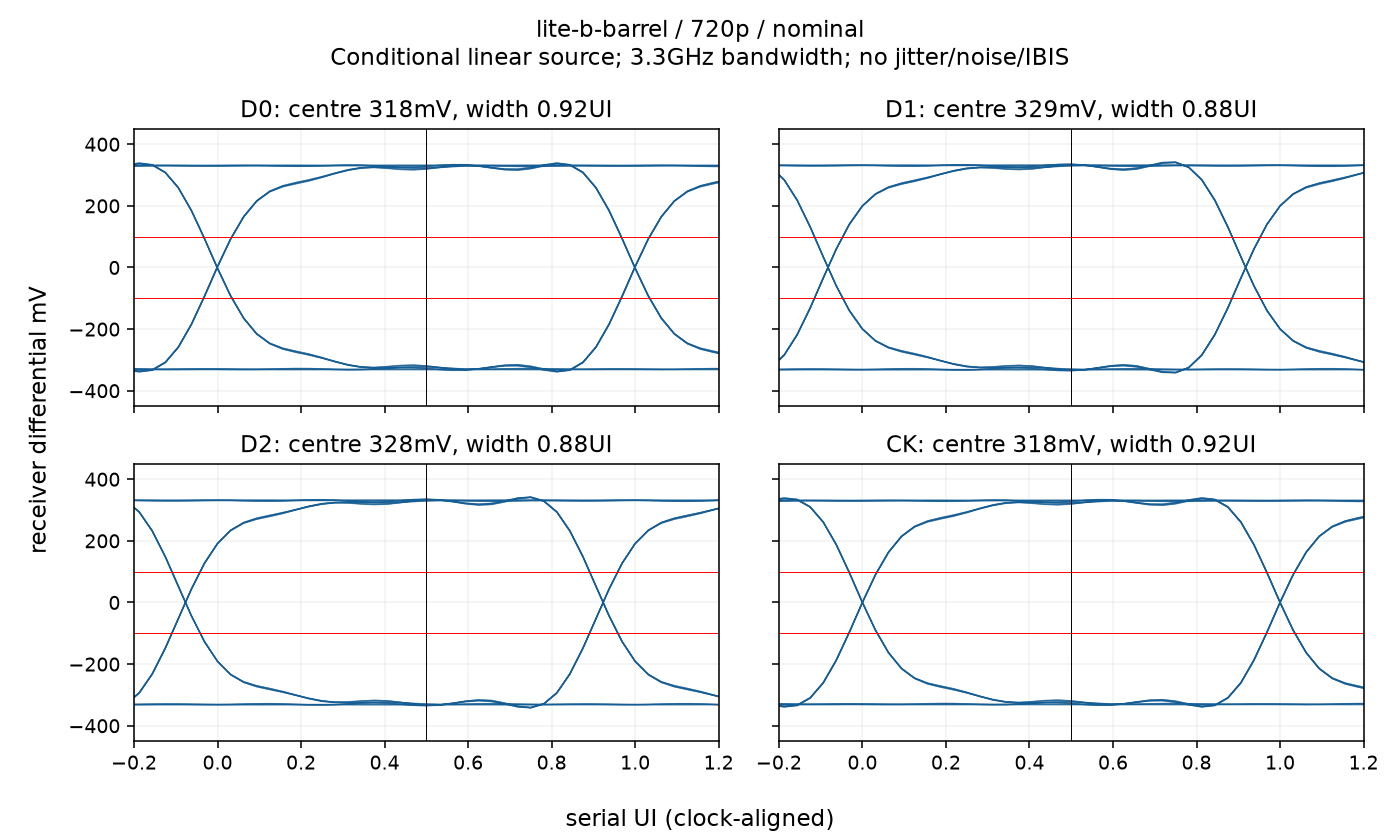
variants/simulation/hdmi/results/lite-b-barrel/720p-nominal-eye.png
