airpocket-soundman/tab5-tang-primer20k-carrier/variants/simulation/hdmi/results/lite-b-barrel/720p-weak_slow_low_Rs-eye.png

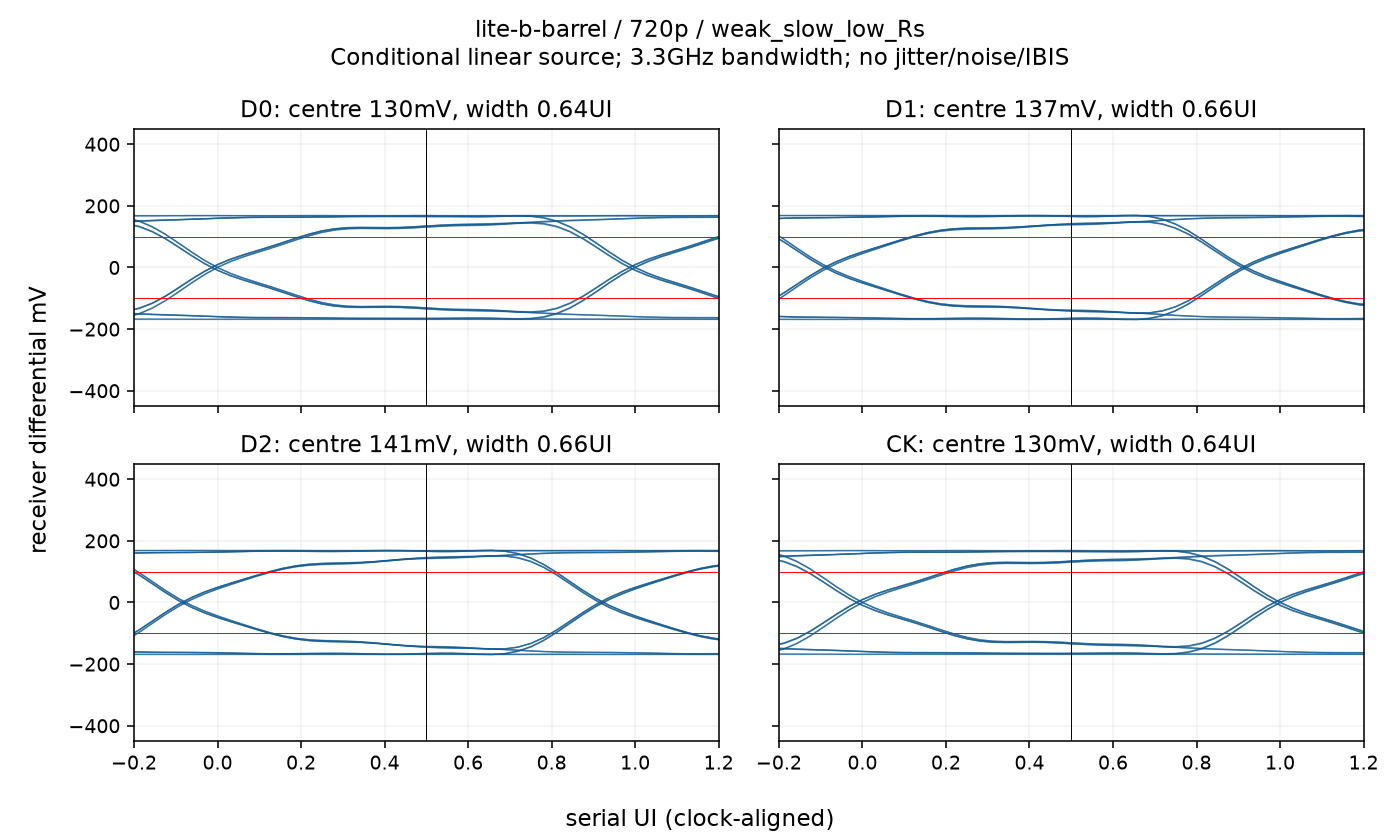
variants/simulation/hdmi/results/lite-b-barrel/720p-weak_slow_low_Rs-eye.png
