airpocket-soundman/tab5-tang-primer20k-carrier/variants/simulation/power/results/lite-b-barrel-power-sequence.png

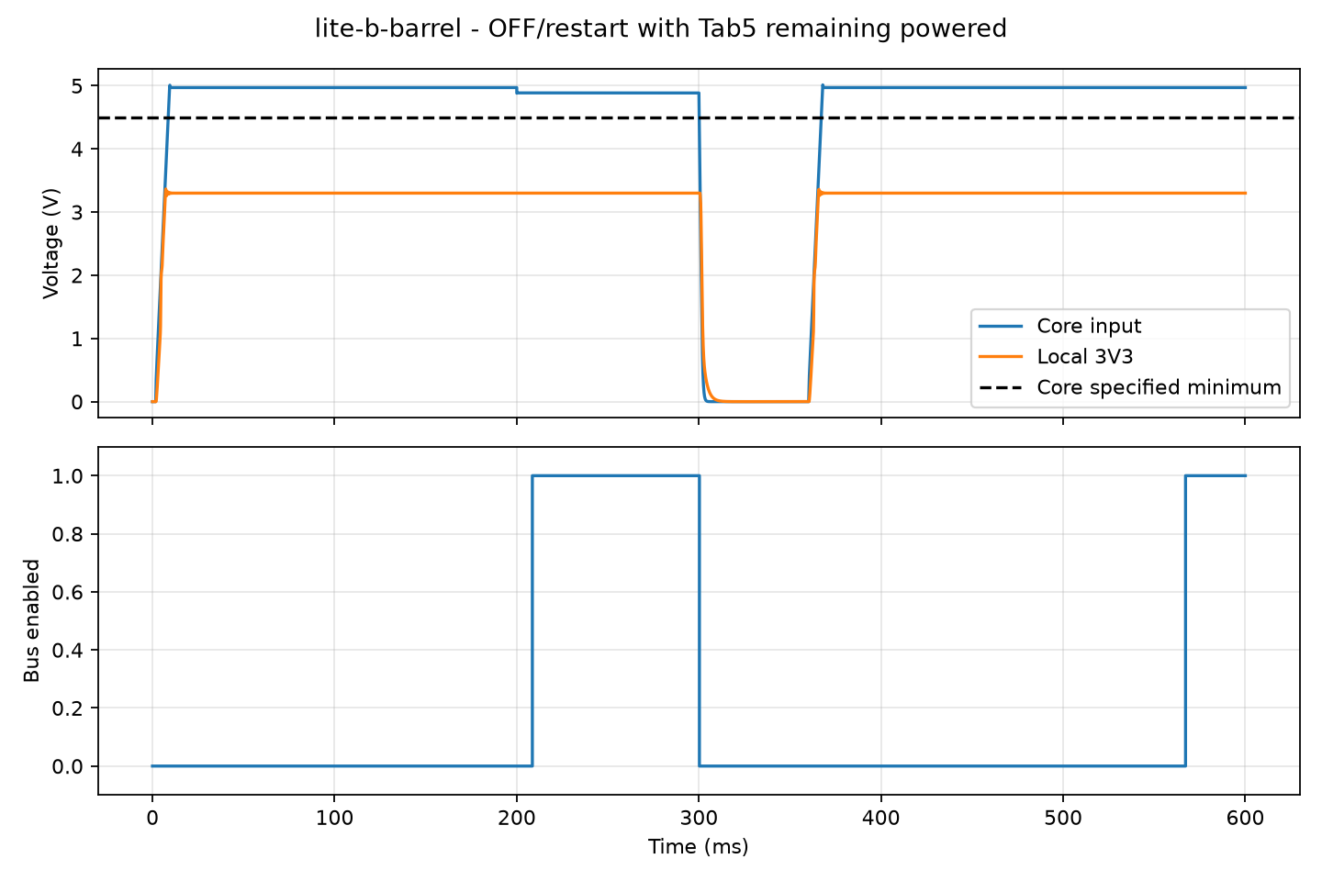
variants/simulation/power/results/lite-b-barrel-power-sequence.png
