airpocket-soundman/tab5-tang-primer20k-carrier/spark/single-sided-r4/full/simulation/hdmi/test.cir

HDMI D0 742500000.0 nominal prbs7 coupled RLGC analytical driver
* Engineering waveform evaluation; not HDMI compliance, IBIS or a cable model.
Vterm vterm 0 3.3
Vsrcp srcp 0 PWL(0 1.2 1.3468013468013e-09 1.2 1.3468013468013e-09 1.2 1.4668013468013e-09 1.55 2.6936026936027e-09 1.55 2.8136026936027e-09 0.85 1.0774410774411e-08 0.85 1.0894410774411e-08 1.55 1.2121212121212e-08 1.55 1.2241212121212e-08 0.85 1.8855218855219e-08 0.85 1.8975218855219e-08 1.55 2.1548821548822e-08 1.55 2.1668821548822e-08 0.85 2.6936026936027e-08 0.85 2.7056026936027e-08 1.55 2.8282828282828e-08 1.55 2.8402828282828e-08 0.85 2.962962962963e-08 0.85 2.974962962963e-08 1.55 3.0976430976431e-08 1.55 3.1096430976431e-08 0.85 3.5016835016835e-08 0.85 3.5136835016835e-08 1.55 4.040404040404e-08 1.55 4.052404040404e-08 0.85 4.3097643097643e-08 0.85 4.3217643097643e-08 1.55 4.4444444444444e-08 1.55 4.4564444444444e-08 0.85 4.8484848484848e-08 0.85 4.8604848484848e-08 1.55 4.983164983165e-08 1.55 4.995164983165e-08 0.85 5.1178451178451e-08 0.85 5.1298451178451e-08 1.55 5.3872053872054e-08 1.55 5.3992053872054e-08 0.85 5.6565656565657e-08 0.85 5.6685656565657e-08 1.55 6.0606060606061e-08 1.55 6.0726060606061e-08 0.85 6.1952861952862e-08 0.85 6.2072861952862e-08 1.55 6.3299663299663e-08 1.55 6.3419663299663e-08 0.85 6.4646464646465e-08 0.85 6.4766464646465e-08 1.55 6.5993265993266e-08 1.55 6.6113265993266e-08 0.85 6.8686868686869e-08 0.85 6.8806868686869e-08 1.55 7.5420875420875e-08 1.55 7.5540875420875e-08 0.85 7.6767676767677e-08 0.85 7.6887676767677e-08 1.55 7.8114478114478e-08 1.55 7.8234478114478e-08 0.85 8.3501683501683e-08 0.85 8.3621683501684e-08 1.55 8.7542087542088e-08 1.55 8.7662087542088e-08 0.85 9.1582491582492e-08 0.85 9.1702491582492e-08 1.55 9.2929292929293e-08 1.55 9.3049292929293e-08 0.85 9.5622895622896e-08 0.85 9.5742895622896e-08 1.55 9.6969696969697e-08 1.55 9.7089696969697e-08 0.85 9.96632996633e-08 0.85 9.97832996633e-08 1.55 1.023569023569e-07 1.55 1.024769023569e-07 0.85 1.037037037037e-07 0.85 1.038237037037e-07 1.55 1.0639730639731e-07 1.55 1.0651730639731e-07 0.85 1.0774410774411e-07 0.85 1.0786410774411e-07 1.55 1.0909090909091e-07 1.55 1.0921090909091e-07 0.85 1.1043771043771e-07 0.85 1.1055771043771e-07 1.55 1.1313131313131e-07 1.55 1.1325131313131e-07 0.85 1.1447811447811e-07 0.85 1.1459811447811e-07 1.55 1.1986531986532e-07 1.55 1.1998531986532e-07 0.85 1.2121212121212e-07 0.85 1.2133212121212e-07 1.55 1.2390572390572e-07 1.55 1.2402572390572e-07 0.85 1.2794612794613e-07 0.85 1.2806612794613e-07 1.55 1.3063973063973e-07 1.55 1.3075973063973e-07 0.85 1.3198653198653e-07 0.85 1.3210653198653e-07 1.55 1.3333333333333e-07 1.55 1.3345333333333e-07 0.85 1.3602693602694e-07 0.85 1.3614693602694e-07 1.55 1.3737373737374e-07 1.55 1.3749373737374e-07 0.85 1.3872053872054e-07 0.85 1.3884053872054e-07 1.55 1.4276094276094e-07 1.55 1.4288094276094e-07 0.85 1.4410774410774e-07 0.85 1.4422774410774e-07 1.55 1.4814814814815e-07 1.55 1.4826814814815e-07 0.85 1.5084175084175e-07 0.85 1.5096175084175e-07 1.55 1.5353535353535e-07 1.55 1.5365535353535e-07 0.85 1.5622895622896e-07 0.85 1.5634895622896e-07 1.55 1.5757575757576e-07 1.55 1.5769575757576e-07 0.85 1.5892255892256e-07 0.85 1.5904255892256e-07 1.55 1.6026936026936e-07 1.55 1.6038936026936e-07 0.85 1.6161616161616e-07 0.85 1.6173616161616e-07 1.55 1.6296296296296e-07 1.55 1.6308296296296e-07 0.85 1.6430976430976e-07 0.85 1.6442976430976e-07 1.55 1.7373737373737e-07 1.55)
Rsrcp srcp txp 50.0
Vsrcn srcn 0 PWL(0 1.2 1.3468013468013e-09 1.2 1.3468013468013e-09 1.2 1.4668013468013e-09 0.85 2.6936026936027e-09 0.85 2.8136026936027e-09 1.55 1.0774410774411e-08 1.55 1.0894410774411e-08 0.85 1.2121212121212e-08 0.85 1.2241212121212e-08 1.55 1.8855218855219e-08 1.55 1.8975218855219e-08 0.85 2.1548821548822e-08 0.85 2.1668821548822e-08 1.55 2.6936026936027e-08 1.55 2.7056026936027e-08 0.85 2.8282828282828e-08 0.85 2.8402828282828e-08 1.55 2.962962962963e-08 1.55 2.974962962963e-08 0.85 3.0976430976431e-08 0.85 3.1096430976431e-08 1.55 3.5016835016835e-08 1.55 3.5136835016835e-08 0.85 4.040404040404e-08 0.85 4.052404040404e-08 1.55 4.3097643097643e-08 1.55 4.3217643097643e-08 0.85 4.4444444444444e-08 0.85 4.4564444444444e-08 1.55 4.8484848484848e-08 1.55 4.8604848484848e-08 0.85 4.983164983165e-08 0.85 4.995164983165e-08 1.55 5.1178451178451e-08 1.55 5.1298451178451e-08 0.85 5.3872053872054e-08 0.85 5.3992053872054e-08 1.55 5.6565656565657e-08 1.55 5.6685656565657e-08 0.85 6.0606060606061e-08 0.85 6.0726060606061e-08 1.55 6.1952861952862e-08 1.55 6.2072861952862e-08 0.85 6.3299663299663e-08 0.85 6.3419663299663e-08 1.55 6.4646464646465e-08 1.55 6.4766464646465e-08 0.85 6.5993265993266e-08 0.85 6.6113265993266e-08 1.55 6.8686868686869e-08 1.55 6.8806868686869e-08 0.85 7.5420875420875e-08 0.85 7.5540875420875e-08 1.55 7.6767676767677e-08 1.55 7.6887676767677e-08 0.85 7.8114478114478e-08 0.85 7.8234478114478e-08 1.55 8.3501683501683e-08 1.55 8.3621683501684e-08 0.85 8.75420875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
Lp52 rp52 p52 4.83460214636e-10
Cgp52 p52 0 1.93384085855e-13
Rgp52 p52 0 110841.639714
Rn52 n51 rn52 0.0230398976868
Ln52 rn52 n52 4.83460214636e-10
Cgn52 n52 0 1.93384085855e-13
Rgn52 n52 0 110841.639714
Rp53 p52 rp53 0.0230398976868
Lp53 rp53 p53 4.83460214636e-10
Cgp53 p53 0 1.93384085855e-13
Rgp53 p53 0 110841.639714
Rn53 n52 rn53 0.0230398976868
Ln53 rn53 n53 4.83460214636e-10
Cgn53 n53 0 1.93384085855e-13
Rgn53 n53 0 110841.639714
Rp54 p53 rp54 0.0230398976868
Lp54 rp54 p54 4.83460214636e-10
Cgp54 p54 0 1.93384085855e-13
Rgp54 p54 0 110841.639714
Rn54 n53 rn54 0.0230398976868
Ln54 rn54 n54 4.83460214636e-10
Cgn54 n54 0 1.93384085855e-13
Rgn54 n54 0 110841.639714
Rp55 p54 rp55 0.0230398976868
Lp55 rp55 p55 4.83460214636e-10
Cgp55 p55 0 1.93384085855e-13
Rgp55 p55 0 110841.639714
Rn55 n54 rn55 0.0230398976868
Ln55 rn55 n55 4.83460214636e-10
Cgn55 n55 0 1.93384085855e-13
Rgn55 n55 0 110841.639714
Rtermp p55 vterm 50
Crxp p55 0 7e-13
Rtermn n55 vterm 50
Crxn n55 0 7e-13
Brxp rx_p 0 V={V(p55)}
Brxn rx_n 0 V={V(n55)}
Bdiff rx_diff 0 V={V(rx_p)-V(rx_n)}
Bsrcdiff src_diff 0 V={V(srcp)-V(srcn)}
.options reltol=.002 abstol=1p vntol=1u method=gear itl4=150
.save v(rx_p) v(rx_n) v(rx_diff) v(src_diff)
.tran 1.3468013468e-11 1.73737373737e-07 0 8.97867564534e-12
.end
