airpocket-soundman/tab5-tang-primer20k-carrier/variants/simulation/parallel/ground-bounce.cir

Eight simultaneous outputs shared return envelope
Ireturn 0 chipgnd PULSE(0 0.032 10n 3e-09 3e-09 40n 100n)
Lreturn chipgnd g 3n
Rreturn g 0 .05
Cfringe chipgnd 0 20p
.tran 10p 100n 0 10p
.save v(chipgnd)
.end
