airpocket-soundman/tab5-tang-primer20k-carrier/variants/simulation/parallel/lite-a-dual-680-write-slow_Cio_bound.cir

Tab5-Core parallel finite-edge distributed RLC sensitivity
.options reltol=1e-5 abstol=1e-12 method=trap
.param pi=3.14159265359
Rtab0 host n2 0.032
Ltab0 n2 n1 4.59282754114e-09
Ctab0 n1 0 6.35685472823e-13
Rtab1 n1 n4 0.032
Ltab1 n4 n3 4.59282754114e-09
Ctab1 n3 0 6.35685472823e-13
Rtab2 n3 n6 0.032
Ltab2 n6 n5 4.59282754114e-09
Ctab2 n5 0 6.35685472823e-13
Rtab3 n5 n8 0.032
Ltab3 n8 n7 4.59282754114e-09
Ctab3 n7 0 6.35685472823e-13
Rtab4 n7 n10 0.032
Ltab4 n10 n9 4.59282754114e-09
Ctab4 n9 0 6.35685472823e-13
Rtab5 n9 n12 0.032
Ltab5 n12 n11 4.59282754114e-09
Ctab5 n11 0 6.35685472823e-13
Rtab6 n11 n14 0.032
Ltab6 n14 n13 4.59282754114e-09
Ctab6 n13 0 6.35685472823e-13
Rtab7 n13 n16 0.032
Ltab7 n16 n15 4.59282754114e-09
Ctab7 n15 0 6.35685472823e-13
Rtab8 n15 n18 0.032
Ltab8 n18 n17 4.59282754114e-09
Ctab8 n17 0 6.35685472823e-13
Rtab9 n17 n19 0.032
Ltab9 n19 header 4.59282754114e-09
Ctab9 header 0 6.35685472823e-13
Rm0 header n21 0.0207965512115
Lm0 n21 n20 4.21389587492e-09
Cm0 n20 0 2.9263165798e-13
Rm1 n20 n22 0.0207965512115
Lm1 n22 swa0 4.21389587492e-09
Cm1 swa0 0 2.9263165798e-13
Lpka swa0 swa 3.553n
Csw_a swa 0 1.1e-11
Rswitch swa swb 9
Csw_b swb 0 1.1e-11
Lpkb swb swb0 3.553n
Riso0 swb0 n24 0.0214592929113
Liso0 n24 n23 4.34818374248e-09
Ciso0 n23 0 3.01957204339e-13
Riso1 n23 n25 0.0214592929113
Liso1 n25 iso 4.34818374248e-09
Ciso1 iso 0 3.01957204339e-13
Rseries iso after_r 680
Lseries after_r after_l .5n
Rf0 after_l n27 0.0273042327907
Lf0 n27 n26 5.53251319196e-09
Cf0 n26 0 3.84202304997e-13
Rf1 n26 n29 0.0273042327907
Lf1 n29 n28 5.53251319196e-09
Cf1 n28 0 3.84202304997e-13
Rf2 n28 n30 0.0273042327907
Lf2 n30 socket_a 5.53251319196e-09
Cf2 socket_a 0 3.84202304997e-13
Lsocket socket_a socket_b 2n
Csocket socket_b 0 1p
Rcore0 socket_b n32 0.032
Lcore0 n32 n31 4.59282754114e-09
Ccore0 n31 0 6.35685472823e-13
Rcore1 n31 n34 0.032
Lcore1 n34 n33 4.59282754114e-09
Ccore1 n33 0 6.35685472823e-13
Rcore2 n33 n36 0.032
Lcore2 n36 n35 4.59282754114e-09
Ccore2 n35 0 6.35685472823e-13
Rcore3 n35 n38 0.032
Lcore3 n38 n37 4.59282754114e-09
Ccore3 n37 0 6.35685472823e-13
Rcore4 n37 n40 0.032
Lcore4 n40 n39 4.59282754114e-09
Ccore4 n39 0 6.35685472823e-13
Rcore5 n39 n42 0.032
Lcore5 n42 n41 4.59282754114e-09
Ccore5 n41 0 6.35685472823e-13
Rcore6 n41 n44 0.032
Lcore6 n44 n43 4.59282754114e-09
Ccore6 n43 0 6.35685472823e-13
Rcore7 n43 n46 0.032
Lcore7 n46 n45 4.59282754114e-09
Ccore7 n45 0 6.35685472823e-13
Rcore8 n45 n48 0.032
Lcore8 n48 n47 4.59282754114e-09
Ccore8 n47 0 6.35685472823e-13
Rcore9 n47 n49 0.032
Lcore9 n49 core 4.59282754114e-09
Ccore9 core 0 6.35685472823e-13
Lvia core recv 4.5e-09
Cvia recv 0 1.5e-12
Vdrive drive 0 PULSE(0 3.135 10n 8e-09 8e-09 5e-06 1e-05)
Rdriver drive dpkg 100
Ldriver dpkg host 2n
Cin core 0 8e-12
Rleak core 0 1e9
.tran 20p 220n 0 20p
.save v(core) v(host) v(swa0) v(swb0)
.end
