airpocket-soundman/tab5-tang-primer20k-carrier/(list of files, drawings)

Other design files:
spark/design/easyeda-final-import.json
spark/design/easyeda-final-info.json
spark/design/easyeda-import-result.json
spark/design/easyeda-project-info.json
spark/design/easyeda/akizuki-drc-result.json
spark/design/easyeda/akizuki-export.json
spark/design/easyeda/akizuki-import.json
spark/design/easyeda/akizuki-rules-aligned.json
spark/design/easyeda/akizuki-rules-before.json
spark/design/easyeda/association-test.json
spark/design/easyeda/board-association.json
spark/design/easyeda/compat-export.json
spark/design/easyeda/compat-import.json
spark/design/easyeda/corrected-board-association.json
spark/design/easyeda/corrected-page.json
spark/design/easyeda/corrected-schematic-import.json
spark/design/easyeda/corrected-source-applied.json
spark/design/easyeda/drc-details.json
spark/design/easyeda/drc-result.json
spark/design/easyeda/electrical-migration-audit.json
spark/design/easyeda/footprint-associations.json
spark/design/easyeda/footprint-map.json
spark/design/easyeda/import-validation.json
spark/design/easyeda/label-export.json
spark/design/easyeda/label-import.json
spark/design/easyeda/manual-footprint-audit.json
spark/design/easyeda/metadata-api-result.json
spark/design/easyeda/netlist-export.json
spark/design/easyeda/pcb-compat-import.json
spark/design/easyeda/pcb-compat-info.json
spark/design/easyeda/project-status.json
spark/design/easyeda/rejected-cleanup.json
spark/design/easyeda/rule-alignment.json
spark/design/easyeda/rules-before.json
spark/design/easyeda/schematic-check.json
spark/design/easyeda/schematic-import.json
spark/design/easyeda/schematic-migration-audit.json
spark/design/easyeda/simulation-api-capabilities.json
spark/design/easyeda/wasm-probe-result.json
spark/design/easyeda/wasm-smoke-test.json
spark/design/kicad/sim/schematic-model-audit.json
spark/lcsc-lite-a/design/easyeda/check-pcb.json
spark/lcsc-lite-a/design/easyeda/check-schematic.json
spark/lcsc-lite-a/design/easyeda/electrical-migration-audit.json
spark/lcsc-lite-a/design/easyeda/export-final.json
spark/lcsc-lite-a/design/easyeda/export-netlist.json
spark/lcsc-lite-a/design/easyeda/footprint-map.json
spark/lcsc-lite-a/design/easyeda/import-result.json
spark/lcsc-lite-a/design/easyeda/import-schematic.json
spark/lcsc-lite-a/design/easyeda/link.json
spark/lcsc-lite-a/design/easyeda/metadata-applied.json
spark/lcsc-lite-a/design/easyeda/native-land-audit.json
spark/lcsc-lite-a/design/easyeda/project.json
spark/lcsc-lite-a/design/easyeda/rules-applied.json
spark/lcsc-lite-a/design/easyeda/schematic-migration-audit.json
spark/lcsc-lite-a/design/kicad/sim/schematic-model-audit.json
spark/lcsc-lite-a/simulation/easyeda-wasm/parallel-api-batch-01.json
spark/lcsc-lite-a/simulation/easyeda-wasm/parallel-api-batch-02.json
spark/lcsc-lite-a/simulation/easyeda-wasm/parallel-api-batch-03.json
spark/lcsc-lite-a/simulation/easyeda-wasm/parallel-api-batch-04.json
spark/lcsc-lite-a/simulation/easyeda-wasm/parallel-api-batch-05.json
spark/lcsc-lite-a/simulation/easyeda-wasm/parallel-api-batch-06.json
spark/lcsc-lite-a/simulation/easyeda-wasm/parallel-api-batch-07.json
spark/lcsc-lite-a/simulation/easyeda-wasm/parallel-api-batch-08.json
spark/lcsc-lite-a/simulation/easyeda-wasm/parallel-api-batch-09.json
spark/lcsc-lite-a/simulation/easyeda-wasm/parallel-api-batch-10.json
spark/lcsc-lite-a/simulation/easyeda-wasm/parallel-api-batch-11.json
spark/lcsc-lite-a/simulation/easyeda-wasm/parallel-api-batch-12.json
spark/lcsc-lite-a/simulation/easyeda-wasm/parallel-api-batch-13.json
spark/lcsc-lite-a/simulation/easyeda-wasm/parallel-api-batch-14.json
spark/lcsc-lite-a/simulation/easyeda-wasm/parallel-api-batch-15.json
spark/lcsc-lite-a/simulation/easyeda-wasm/periodic-api-batch-01.json
spark/lcsc-lite-a/simulation/easyeda-wasm/periodic-api-batch-02.json
spark/lcsc-lite-a/simulation/easyeda-wasm/periodic-api-batch-03.json
spark/lcsc-lite-a/simulation/easyeda-wasm/periodic-api-batch-04.json
spark/lcsc-lite-a/simulation/easyeda-wasm/periodic-api-batch-05.json
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
