airpocket-soundman/tab5-tang-primer20k-carrier/spark/main-power-r2/full/kicad/tab5-fpga-carrier.kicad_sch

## KiCad design spark/main-power-r2/full/kicad/tab5-fpga-carrier.kicad_sch (2026-10-26)

Schematic: tab5-fpga-carrier.kicad_sch

Parts:
C1: 100u/35V; CP_Elec_6.3x7.7; LCSC C2983388
C2, C25: 1u/50V; C_0603_1608Metric; LCSC C15849
C3, C26: 10n; C_0603_1608Metric; LCSC C57112
C4, C5: 10u/50V; C_1206_3216Metric; LCSC C13585
C6: 100n/50V; C_0603_1608Metric; LCSC C14663
C7: 220u/10V POSCAP; CP_EIA-7343-40_Kemet-Y; LCSC C242173
C8, C9: 47u/10V; C_1206_3216Metric; LCSC C96123; not fitted
C10: 10u/16V; C_1206_3216Metric; LCSC C13585
C11: 22u/10V; C_1206_3216Metric; LCSC C12891
C12, C13, C14, C15, C16, C17, C18, C19: 100n; C_0402_1005Metric; LCSC C1525
C20, C21, C22, C23, C24: 100n; C_0603_1608Metric; LCSC C14663
D1, D2, D4: SS54; D_SMA; LCSC C22452
D3: SMBJ15A; D_SMB; LCSC C699013
D5, D6, D7, D8: LED; LED_0603_1608Metric; LCSC C2286
F1: PTC 3A hold; Fuse_1812_4532Metric; LCSC C47002391
F2: PTC 500mA; Fuse_1206_3216Metric; LCSC C315893
H1, H2, H3, H4, H5, H6: M3; MountingHole_3.2mm_M3
J1: DC-005-5A-2.0; BarrelJack_XKB_C381116; LCSC C381116
J2: USB-C PD in; USB_C_Receptacle_GCT_USB4125-xx-x-0190_6P_TopMnt_Horizontal; LCSC C5246813
J3: 2.54-2*15P; PinHeader_2x15_Tab5_Bottom; LCSC C56496
J4: SOCKET XDAP-4042044-20401; DDR3_XDAP_4042044_20401; LCSC C22471982
J5: HDMI OUT; HDMI_A_Molex_208658-1001_Horizontal; LCSC C916313
J6: PMOD1; PinHeader_2x06_P2.54mm_Vertical; not fitted
J7: PMOD2; PinHeader_2x06_P2.54mm_Vertical; not fitted
J8: GPIO pads; PinHeader_1x09_P2.54mm_Vertical; not fitted
JP1: B-2100S02P-A110; PinHeader_1x02_P2.54mm_Vertical; LCSC C124375
L1: 15u/4A; L_Bourns_SRR1260; LCSC C2041333
Q1, Q2, Q3, Q4: 2N7002; SOT-23; LCSC C8545
Q5: MMBT3904; SOT-23; LCSC C20526
R1, R6, R36, R37, R52, R53: 10k; R_0603_1608Metric; LCSC C25804
R2, R42, R43, R44, R45: 1k; R_0603_1608Metric; LCSC C21190
R3, R5: 0R; R_0603_1608Metric; LCSC C21189
R4, R17, R18, R25: 0R; R_0603_1608Metric; LCSC C21189; not fitted
R7: 3.24k; R_0603_1608Metric; LCSC C22994
R8, R41, R47, R48, R54: 100k; R_0603_1608Metric; LCSC C25803
R9: 15k; R_0603_1608Metric; LCSC C22809
R10, R11, R12, R13, R14, R15, R16, R19, R20, R21, R22, R23, R24, R26, R27: 680R; R_0603_1608Metric; LCSC C23228
R28, R29, R32, R33, R34, R35: 499R; R_0603_1608Metric; LCSC C23065
R30, R31: 499R; R_0402_1005Metric; LCSC C4125
R38, R39: 2.2k; R_0603_1608Metric; LCSC C4190
R40, R51: 47k; R_0603_1608Metric; LCSC C25819
R46: 22k; R_0603_1608Metric; LCSC C31850
SW1, SW2: TS-1102S-B-D-B; SW_XKB_TS1102S_C480272; LCSC C480272
SW3: XKB5858-Z-TP-75; LCSC C692487
U1: CH224K; SSOP-10-1EP_3.9x4.9mm_P1mm_EP2.1x3.3mm; LCSC C970725
U2: TPS5430DDAR; TI_SO-PowerPAD-8_ThermalVias; LCSC C9864
U3: TLV1117LV33DCYR; SOT-223-3_TabPin2; LCSC C15578
U4, U5, U6: RCLAMP0524P; DFN2510-10L_RCLAMP0524P; LCSC C293965
U7, U8: SN74CB3Q3245PWR; TSSOP-20_4.4x6.5mm_P0.65mm; LCSC C470961
U9: TPS3839G33DBZR; SOT-23; LCSC C485802
U10: TPS3839K50DBZR; SOT-23; LCSC C702204
U11: TPS22810DRVT; WSON-6-1EP_2x2mm_P0.65mm_EP1x1.6mm; LCSC C2653758

Connections:
+3V3: C11.1, C20.1, C21.1, J6.11, J6.12, J7.11, J7.12, J8.1, Q1.1 (G), Q2.1 (G), R36.1, R37.1, R46.1, R51.1, U3.2 (VO), U7.20 (VCC), U8.20 (VCC)
+5V: C7.1, C8.1, C9.1, C10.1, C23.1, F2.1, J4.4 (+5V), J4.5 (+5V), J4.6 (+5V), J4.7 (+5V), L1.2, R6.1, U3.3 (VI), U10.3 (VDD)
BUCK_BOOT: C3.1, U2.1 (BOOT)
BUCK_EN: R8.2, R9.1, U2.5 (EN)
BUCK_FB: R6.2, R7.1, U2.4 (VSENSE)
BUCK_PH: C3.2, D4.1 (K), L1.1, U2.8 (PH)
BUS_ARM: JP1.2, Q3.1 (G), R47.1
BUS_OE_MID: Q3.2 (S), Q4.3 (D)
BUS_OE_N: Q3.3 (D), R46.2, U7.19 (~OE), U8.19 (~OE)
CC1: J2.A5 (CC1), U1.7 (CC1)
CC2: J2.B5 (CC2), U1.6 (CC2)
CORE_PGOOD: Q4.1 (G), R48.1, U10.2 (~RESET)
DC_IN: D1.2 (A), F1.2
DC_RAW: F1.1, J1.1
F_AUX0: J4.73 (F_AUX0), R11.2
F_AUX1: J4.79 (F_AUX1), R14.2
F_AUX2: J4.95 (F_AUX2), R19.2
F_AUX3: J4.97 (F_AUX3), R20.2
F_BTN0: J4.74 (F_BTN0), SW1.1
F_CLK: J4.52 (F_CLK), R10.2
F_D0: J4.77 (F_D0), R13.2
F_D1: J4.83 (F_D1), R15.2
F_D2: J4.85 (F_D2), R16.2
F_D3: J4.103 (F_D3), R22.2
F_D4: J4.101 (F_D4), R21.2
F_D5: J4.109 (F_D5), R24.2
F_D6: J4.107 (F_D6), R23.2
F_D7: J4.115 (F_D7), R26.2
F_DIR: J4.119 (F_DIR), R27.2
F_EXT35: J4.113 (F_EXT35), R25.2
F_EXT37: J4.89 (F_EXT37), R17.2
F_EXT38: J4.91 (F_EXT38), R18.2
F_HPD: J4.30 (F_HPD), R52.2
F_HSCL: J4.36 (F_HSCL), Q1.2 (S), R36.2
F_HSDA: J4.34 (F_HSDA), Q2.2 (S), R37.2
F_LED0: J4.146 (F_LED0), R42.1
F_LED1: J4.148 (F_LED1), R43.1
F_LED2: J4.152 (F_LED2), R44.1
F_LED3: J4.154 (F_LED3), R45.1
F_RDY: J4.75 (F_RDY), R12.2
GND: C1.2, C2.2, C4.2, C5.2, C6.2, C7.2, C8.2, C9.2, C10.2, C11.2, C20.2, C21.2, C22.2, C23.2, C24.2, C25.2, C26.2, D3.2 (A2), D4.2 (A), D5.1 (K), D6.1 (K), D7.1 (K), D8.1 (K), J1.2, J2.A12 (GND), J2.B12 (GND), J2.SH (SHIELD), J3.1, J3.3, J3.5, J4.2 (GND), J4.3 (GND), J4.8 (GND), J4.9 (GND), J4.13 (GND), J4.14 (GND), J4.19 (GND), J4.20 (GND), J4.25 (GND), J4.26 (GND), J4.31 (GND), J4.32 (GND), J4.37 (GND), J4.38 (GND), J4.43 (GND), J4.48 (GND), J4.49 (GND), J4.54 (GND), J4.55 (GND), J4.60 (GND), J4.61 (GND), J4.66 (GND), J4.71 (GND), J4.72 (GND), J4.127 (GND), J4.128 (GND), J4.133 (GND), J4.134 (GND), J4.138 (GND), J4.139 (GND), J4.144 (GND), J4.145 (GND), J4.150 (GND), J4.151 (GND), J4.155 (GND), J4.156 (GND), J4.161 (GND), J4.162 (GND), J4.168 (GND), J4.172 (GND), J4.173 (GND), J4.178 (GND), J4.179 (GND), J4.184 (GND), J4.185 (GND), J4.189 (GND), J4.190 (GND), J4.195 (GND), J4.196 (GND), J5.2 (D2S), J5.5 (D1S), J5.8 (D0S), J5.11 (CKS), J5.17 (GND), J5.SH, J6.9, J6.10, J7.9, J7.10, J8.2, Q4.2 (S), Q5.2 (E), R3.2, R4.2, R5.2, R7.2, R9.2, R28.2, R29.2, R30.2, R31.2, R32.2, R33.2, R34.2, R35.2, R41.2, R47.2, R48.2, R54.2, SW1.2, SW2.2, U1.11 (GND), U2.6 (GND), U2.9 (GNDPAD), U3.1 (GND), U4.3 (GND), U4.8 (GND), U5.3 (GND), U5.8 (GND), U6.3 (GND), U6.8 (GND), U7.10 (GND), U8.10 (GND), U9.1 (GND), U10.1 (GND), U11.4 (GND), U11.7 (GND)
GPIO0: J4.125 (GPIO0), J8.3
GPIO1: J4.129 (GPIO1), J8.4
GPIO2: J4.131 (GPIO2), J8.5
GPIO3: J4.176 (GPIO3), J8.6
GPIO4: J4.180 (GPIO4), J8.7
GPIO5: J4.182 (GPIO5), J8.8
GPIO6: J4.186 (GPIO6), J8.9
HDMI_5V: F2.2, J5.18 (+5V), R38.1, R39.1, U6.2 (IO2), U6.9 (NC)
HDMI_CKN: C19.1, J4.142 (HDMI_CKN)
HDMI_CKN_C: C19.2, J5.12 (CK-), R35.1, U5.5 (IO4), U5.6 (NC)
HDMI_CKP: C18.1, J4.140 (HDMI_CKP)
HDMI_CKP_C: C18.2, J5.10 (CK+), R34.1, U5.4 (IO3), U5.7 (NC)
HDMI_D0N: C17.1, J4.132 (HDMI_D0N)
HDMI_D0N_C: C17.2, J5.9 (D0-), R33.1, U5.2 (IO2), U5.9 (NC)
HDMI_D0P: C16.1, J4.130 (HDMI_D0P)
HDMI_D0P_C: C16.2, J5.7 (D0+), R32.1, U5.1 (IO1), U5.10 (NC)
HDMI_D1N: C15.1, J4.70 (HDMI_D1N)
HDMI_D1N_C: C15.2, J5.6 (D1-), R31.1, U4.5 (IO4), U4.6 (NC)
HDMI_D1P: C14.1, J4.68 (HDMI_D1P)
HDMI_D1P_C: C14.2, J5.4 (D1+), R30.1, U4.4 (IO3), U4.7 (NC)
HDMI_D2N: C13.1, J4.58 (HDMI_D2N)
HDMI_D2N_C: C13.2, J5.3 (D2-), R29.1, U4.2 (IO2), U4.9 (NC)
HDMI_D2P: C12.1, J4.56 (HDMI_D2P)
HDMI_D2P_C: C12.2, J5.1 (D2+), R28.1, U4.1 (IO1), U4.10 (NC)
HDMI_HPD: J5.19 (HPD), R40.1, U6.5 (IO4), U6.6 (NC)
HDMI_SCL: J5.15 (SCL), Q1.3 (D), R38.2, U6.4 (IO3), U6.7 (NC)
HDMI_SDA: J5.16 (SDA), Q2.3 (D), R39.2, U6.1 (IO1), U6.10 (NC)
HPD_B: Q5.1 (B), R40.2, R41.1
HPD_BUF: C24.1, Q5.3 (C), R51.2, R52.1
ISO_AUX0: R11.1, U7.17 (B2)
ISO_AUX1: R14.1, U7.14 (B5)
ISO_AUX2: R19.1, U7.11 (B8)
ISO_AUX3: R20.1, U8.18 (B1)
ISO_CLK: R10.1, U7.18 (B1)
ISO_D0: R13.1, U7.15 (B4)
ISO_D1: R15.1, U7.13 (B6)
ISO_D2: R16.1, U7.12 (B7)
ISO_D3: R22.1, U8.16 (B3)
ISO_D4: R21.1, U8.17 (B2)
ISO_D5: R24.1, U8.14 (B5)
ISO_D6: R23.1, U8.15 (B4)
ISO_D7: R26.1, U8.13 (B6)
ISO_DIR: R27.1, U8.12 (B7)
ISO_RDY: R12.1, U7.16 (B3)
LED0_A: D5.2 (A), R42.2
LED1_A: D6.2 (A), R43.2
LED2_A: D7.2 (A), R44.2
LED3_A: D8.2 (A), R45.2
MAIN_CT: C26.1, U11.3 (CT)
MAIN_EN: R53.2, R54.1, U11.5 (EN/UVLO)
MAIN_ON: R53.1, SW3.3 (C)
M_AUX0: J3.4, U7.3 (A2)
M_AUX1: J3.10, U7.6 (A5)
M_AUX2: J3.16, U7.9 (A8)
M_AUX3: J3.15, U8.2 (A1)
M_CLK: J3.2, U7.2 (A1)
M_D0: J3.7, U7.5 (A4)
M_D1: J3.9, U7.7 (A6)
M_D2: J3.11, U7.8 (A7)
M_D3: J3.19, U8.4 (A3)
M_D4: J3.20, U8.3 (A2)
M_D5: J3.21, U8.6 (A5)
M_D6: J3.22, U8.5 (A4)
M_D7: J3.23, U8.7 (A6)
M_DIR: J3.26, U8.8 (A7)
M_EXT35: J3.24, R25.1
M_EXT37: J3.14, R17.1
M_EXT38: J3.13, R18.1
M_RDY: J3.8, U7.4 (A3)
P1_0: J4.76 (P1_0), J6.1
P1_1: J4.84 (P1_1), J6.3
P1_2: J4.90 (P1_2), J6.5
P1_3: J4.121 (P1_3), J6.7
P1_4: J4.78 (P1_4), J6.2
P1_5: J4.86 (P1_5), J6.4
P1_6: J4.92 (P1_6), J6.6
P1_7: J4.123 (P1_7), J6.8
P2_0: J4.40 (P2_0), J7.1
P2_1: J4.44 (P2_1), J7.3
P2_2: J4.50 (P2_2), J7.5
P2_3: J4.62 (P2_3), J7.7
P2_4: J4.42 (P2_4), J7.2
P2_5: J4.46 (P2_5), J7.4
P2_6: J4.80 (P2_6), J7.6
P2_7: J4.64 (P2_7), J7.8
PD_CFG1: R3.1, U1.9 (CFG1)
PD_CFG2: R5.1, U1.2 (CFG2)
PD_CFG3: R4.1, U1.3 (CFG3)
PD_PG: U1.10 (PG)
PD_VBUS_S: R2.2, U1.8 (VBUS)
PD_VDD: C2.1, R1.2, U1.1 (VDD)
TAB_3V3: C22.1, J3.12, U9.3 (VDD)
TAB_PGOOD: JP1.1, U9.2 (~RESET)
TAB_RST: J3.6, SW2.1
TAB_SCL: J3.18
TAB_SDA: J3.17
VBUS_PD: D2.2 (A), J2.A9 (VBUS), J2.B9 (VBUS), R1.1, R2.1
VIN: C4.1, C5.1, C6.1, J3.25, J3.27, J3.29, R8.1, U2.7 (VIN), U11.1 (VOUT)
VIN_OR: C1.1, C25.1, D1.1 (K), D2.1 (K), D3.1 (A1), SW3.2 (B), U11.6 (VIN)

Notes on the sheet:
MAIN POWER R2 CANDIDATE - NOT FOR FABRICATION
POWER INPUT: DC barrel + USB-C PD (OR) -> VIN
USB-C PD sink (CH224K, 12V request)
VIN -> +5V buck (TPS5430)
+5V -> +3V3 (peripherals)
M5-BUS header (Tab5-facing side)
Power-off bus isolation + 33R (M=Tab5, ISO=switch, F=FPGA)
HDMI OUT connector + DDC/HPD level shift + ESD
HDMI TMDS 499R bias, ESD
HDMI TMDS AC coupling caps
PMOD x2
FPGA JTAG header
Spare FPGA I/O pads
LEDs / buttons
Mounting holes (Tab5 M3)
Tang Primer 20K Core SODIMM socket (pin names = nets)
Nets: GND +5V +3V3 are power symbols; all other nets connect by label.
M5-Bus pins 28 (5V) and 30 (BAT) are intentionally NOT connected (Tab5 outputs).
Do NOT tie Tab5 5V to the FPGA 5V rail. GND is common.
