airpocket-soundman/tab5-tang-primer20k-carrier/fpga/validation/npu-autonomous-fastmul-fullchip-2026-11-08/failed-place1/device.cfg

set JTAG regular_io = false
set SSPI regular_io = true
set MSPI regular_io = false
set READY regular_io = false
set DONE regular_io = false
set I2C regular_io = false
set RECONFIG_N regular_io = false
set CRC_check = true
set compress = false
set encryption = false
set security_bit_enable = true
set bsram_init_fuse_print = true
set background_programming = off
set secure_mode = false
set program_done_bypass = false
set wake_up = 0
set user_code = 0x00004E30
set format = binary
set power_on_reset_monitor = true
set multiboot_spi_flash_address = 0x00000000
set vccx = 3.3
set vcc = 1.0
set unused_pin = default
