airpocket-soundman/tab5-tang-primer20k-carrier/(commit log)

2026-10-22 docs: initialize shared carrier board design project
2026-10-22 docs: switch to external 12-24V barrel jack feeding both Tab5 and FPGA; battery drive on hold
2026-10-22 kicad: add generated schematic + 4-layer PCB (94/103 nets auto-routed), generators and renders
2026-10-22 site: add KiCad design section with 3D render
2026-10-22 kicad: 103/103 nets routed (rip-up router), DRC clean; BOM; finish script; site update
2026-10-23 kicad: layout v1.0 (Core left of M5-Bus, HDMI bottom edge, pin swap), 106/106 routed, DRC clean; reset/power switch/GPIO pads; docs
2026-10-23 kicad v2.0: Core right of M-Bus, HDMI right edge, official-Dock HDMI circuit (AC coupling/499R/ESD), coupled TMDS pair routing, 121/121 routed, DRC clean; HDMI SI study + docs/site
2026-10-23 site: HDMI simulation evaluation report page; docs: simulation policy/audit record incl. independent-review corrections; sim: corrected channel ordering and 0.13 mm grid, report generators, openEMS c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
2026-10-23 HDMI remediation after independent audit: copper-continuous ESD, short 499R branches, re-routed pairs, re-simulated channel
    - ESD (RClamp0524P, C293965): I/O pins joined to the TMDS line by copper straps, no reliance on part-internal pass-through
    - 499 ohm bias resistors moved next to the tap (branches 2-11.5 mm), routed and modelled as terminated lines
    - route_pcb: roles JSON (main/branch), pair routing, 113/113 nets, DRC 0/0
    - sim: ordered-segment extraction without silent fallback, branch/ESD channel model, continuity check, variants
    - report page, docs (section 10), README, BOM updated; open items disclosed (D1N branch 11.5 mm, 3D uncalibrated)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
2026-10-24 HDMI second-audit remediation (A1-A5): ESD footprint, escape stubs, 4-port P/N model, combined sensitivity, checks, report r3
    - A1: dedicated DFN2510-10L_RCLAMP0524P footprint (GND land 0.30->0.42 mm), symbol IO/NC, datasheet comparison + check_esd_footprint.py
    - A2: router roles stub/strap, check_classification.py (0 unclassified), pad-clipped escape stubs added to the analysed path
    - A3: 4-port P/N ABCD channel model, P/N branches at their own taps, SCD21; short-symmetric-branch comparison
    - A4: Core Z x ESD C matrix; fails -10 dB at Core 85 ohm with ESD >= 0.35 pF (D1)
    - A5: check_continuity pin-number check + exit codes, check_negative.py, manifest_r3.json, D2 inversion doc, README/site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
2026-10-24 HDMI audit A3 retry record: D1 resistor re-placement tried and reverted (branches got longer); report r3 and audit record updated
2026-10-24 fix(audit): validate trace widths interval roles and reviewed via geometry
2026-10-24 Prepare PoC parallel isolation, power and manufacturing candidate
2026-10-24 Link the historical review to current fabrication readiness
2026-10-24 Publish consolidated PCB report with independent review, simulation, BOM and renders
    Add site/pcb-report.html as the latest board report for d93af0b: independent
    re-run of DRC/ERC, pin-level schematic/PCB netlist comparison, all physical
    checks and fault-injection tests, byte-identical reproduction of the TMDS
    channel model, manifest verification, fresh 3D renders, full BOM and the
    review findings (left M3 holes H1/H2 have only 0.46 mm web to the outline).
    review_pcb_report.py and make_pcb_report_page.py regenerate the review JSON,
    renders and page; every page now links the report as latest, older "latest"
    links are relabelled, and the manifest/r3 page are refreshed.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
2026-10-25 Qualify lite variants for conditional PoC fabrication and publish per-board reports
2026-10-25 Fit variant A Akizuki buttons and include HDMI in PCBA
2026-10-25 Align variants B and C with Akizuki buttons and explain A BOM
2026-10-26 Record carrier design baseline and external main-power revision candidates
2026-10-26 Prepare single-sided Spark quotation revision without power switch
2026-10-26 Validate r4 native EasyEDA designs and actual power link HDMI simulations
2026-10-26 Finalize r4 PoC placement frames, order profiles and warning review
2026-10-28 Add Dock jumper bench plan: wiring, draft CST, staged tests, bitstream split
    Map Tab5 M5-Bus D0-7/CLK/READY/DIR/AUX to Tang Primer 20K Dock headers
    J12/J5/J14 using 3.3 V banks only (CLK on T7 GCLKT_3, Bank7 avoided),
    checked against Dock 3714 and Core schematics. Add a Dock-only draft
    CST for the shared link v0 bitstream (ESP-IDF/MeOS/Linux), staged
    bring-up steps, and the GFX/NPU/MEM bitstream split with HDMI/RAMdisk
    coexistence criteria. Not synthesized or hardware-tested.
2026-10-28 Make carrier repo the owner of the FPGA device for all host OSes
    All hosts (ESP-IDF, MeOS, NOMMU Linux) use GFX, NPU, HDMI and RAMdisk,
    so the FPGA side is one shared device. This repository now owns the
    board, the link/command specification, FPGA sources, constraints and
    bitstream configurations; host repositories implement drivers against
    it and record the spec revision they follow.
    - AGENTS/README: new ownership and host repository roles
    - docs: repository roles and reference rules; FPGA device configuration
    (LINK/GFX/NPU/MEM, coexistence defaults and criteria, Tab5 LCD
    readback path, model-specific NPU variants B/C)
    - fpga/: planned layout and migration list; Dock CST moved here
    - c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
2026-10-28 Add remaining-work list after the FPGA device ownership move
2026-10-28 Publish Dock jumper wiring guide with photo and pin diagrams
2026-11-02 Mark active signal and ground pins on Dock overview
2026-11-02 Refresh cached Dock pin diagram using versioned image URL
2026-11-02 Add Dock LINK and GFX bring-up implementation, USB tools and wiring guide
2026-11-03 Add optional CRC-validated LINK training prefix for DMA reception
2026-11-03 Accept bounded extended DMA synchronization captures
2026-11-03 Document fixed-direction DMA research and official framing limits
2026-11-03 Reference staged GPU LAB plan with DMA and frequency work in parallel
2026-11-03 Decode bounded continuous DMA response windows without reconstruction
2026-11-03 Add capability-gated staged triangle batches with exact scalar replay
2026-11-03 Record DDR3 board evidence toolchain qualification and MEM test plan
2026-11-03 Record Standard license probe and official Education DDR candidate
2026-11-03 Qualify Education CLI encrypted DDR sample synthesis and IP generation
2026-11-03 Add isolated pack-only CLK input hysteresis experiment with exact two-fuse qualification
2026-11-03 Preserve clock-filter timing coverage research and alternate-duty model
2026-11-03 Restore complete diagnostic document with hardware stall analysis
2026-11-03 Add output-only coherent DDR controller stall observation
2026-11-03 Preserve deeper diagnostic FS timing pin and tap audit evidence
2026-11-03 Integrate atomic triangle batch into isolated filtered clock candidate
2026-11-03 Qualify exact metadata CDC first stage while retaining remaining hold failure
2026-11-03 Freeze identity-equivalent filtered batch with exact metadata CDC closure
2026-11-03 Issue MEM BIST write command and data together and wait after calibration
    IPUG281 4.4.6 places write data at most one cycle before, in, or one cycle
    after the command. The BIST fired the two channels independently, so data
    ran ahead of the command in every hardware trial (data count exceeded the
    command count by one). The vendor DDR-test fires both in one cycle only
    while cmd_ready and wr_data_rdy are both high, and waits 256 cycles after
    init_calib_complete.
    PAIRED_WRITE (default 1) and CALIBRATION_SETTLE_CYCLES (default 256) are
    added; PAIRED_WRITE=0 keeps the earlier behavior. The bench now runs both
    variants and asserts same-cycle write issue and no enable before settle.
    Not yet tried o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
2026-11-03 Record paired-write MEM candidate, offline build and staged test plan
    Documents where the DDR3 bring-up stops (no write ever reaches the DRAM,
    data accepted one beat ahead of its command), the differences from the
    vendor DDR-test, the offline-built image (setup +0.106ns, hold +0.234ns,
    UserCode 0xB317) and a staged hardware plan with pass criteria. The image is
    SRAM-only intent and has not been run on hardware.
2026-11-03 Record offline host MEM probe build for the paired-write candidate
2026-11-03 Add fractal tile free-clock RTL test and Mandelbrot continuous DMA failure analysis
2026-11-03 Add carrier-board .cst generator checked against the KiCad pin table and PCB
    Generate fpga/constraints/carrier/tab5_carrier_link.cst from
    kicad/core_pin_assignment.csv through the Core SODIMM pin map and an
    Apicula-derived ball/bank table (HDMI and DDR3 excluded). 12 offline tests
    check the result against the pin table, the PCB pad nets (57/57) and the
    chip database. Bank 0/1/7 VCCO is unverified because SODIMM 164/166/170/174
    are open on the carrier; the generator refuses --require-verified until
    that is settled. SDC is a template with unverified placeholder values.
    Record open items in docs and correct the stale SODIMM 73-91 data-pin note.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
2026-11-03 Record hardware stage 1 and 2 results of the paired-write DDR3 candidate
2026-11-03 Checkpoint interrupted Claude work and preserve recovery evidence
2026-11-04 Add handoff document for DMA optimization and speed-up work
2026-11-04 Add DDR3 isolation variant generator (cs0/rst/refwait) and staged hardware procedure
    Sources only; no variant built (Gowin Education not installed on this PC),
    no hardware touched.
2026-11-04 Add general-purpose SIMD compute unit prototype v0 (RTL, model, tests, offline validation)
2026-11-04 Import 4-image hardware results, add pace variant, next-hypothesis and sample-diff analysis
2026-11-04 Add clk400 variant preparation (IP tag flow, PLL 398.25MHz, SDC, mailbox MHz params, gw_sh call order); nothing built
2026-11-04 Add sample-as-is test procedure and clk400 build request to the staged procedure
2026-11-04 Record Sipeed reference result, list diffs vs sample, add sampleip bisect variant (sources only)
2026-11-04 Record sampleip and clk400_notap builds (STA violations recorded as-is); record_variant handles UTF-16 console logs and clk400 clock names
2026-11-04 Record clk400_asyncsdc build; plan for clk400 calibration failure
2026-11-04 Analyze generated-netlist analog settings vs sample (DLL CODESCAL, IODELAY), add clk400dp variant and IP debug-parameter option
2026-11-04 Record sampleip hardware result; policy for adopting the pinned sample IP, timing fixes, stage-3 prep (sampleip_map, row-pad test, fetch/verify script)
2026-11-04 Record sampleip_map hardware results (stage 3), add cold-boot/multi-seed/soak procedure and bandwidth-engine design
2026-11-04 Document pinned old-IP storage and verification; refuse sampleip prepare/build when local IP is missing or modified
2026-11-04 BIST timing structure (PIPELINE 1/2), variants sampleip_map_t1/t2, regression extended; DDR3 integration policy memo (v1 proposal)
2026-11-04 Record sampleip_map_t1/t2/t3 builds: t3 leaves one IP-internal-loop path at -0.164ns
2026-11-04 compute_simd: 3-stage operand/product pipeline closes 54MHz in Gowin STA (1 and 2 lanes)
2026-11-04 PIPELINE=4: registered wants for native enables; sampleip_map_t4 builds with zero STA violations (diagnostic async SDC)
2026-11-04 Add sampleip_map_t4 build records
2026-11-04 Add DDR3 bandwidth measurement engine mem_bw (simulation only; not wired into mem_top, no synthesis/STA/hardware result)
2026-11-04 Record hardware results of sampleip_map_t4: patterns, boundaries, full-range, multi-seed and 10-minute soak
2026-11-04 Record stage-1 results of five regenerated-IP 400MHz variants (none calibrates)
2026-11-04 Wire DDR3 bandwidth engine into mem_top (BW_ENABLE=0 default, bit-identical), burst/strided patterns, Python model, integration bench, probe_mem_bw host script, t4_bw build record
2026-11-04 Fix memv1 image PLL (IDIV_SEL 0->3 was missing: 1593MHz memory clock, IP never calibrated); add STATUS word 7 raw signals, PLL checks in prepare/record; rebuilt image
2026-11-04 Fix bandwidth image STA: shared registered IP enable stage, EN_PIPE, split 64-bit counters (t4_bw2: 0 violations, diagnostic SDC)
    - mem_bw EN_PIPE (0 original, 1 registered enables with identical cycles, 2 BIST PIPELINE=4 style stale-block, 2-cycle spacing; bw_model STEP=2)
    - mem_top BW_SHARED_GATE (ifdef BW_GATES, set by prepare_variant for sampleip_map_t4_bw2): IP cmd/write enables as 4-input functions of ready flags and shared registered gates
    - 16-bit segmented 64-bit counters, cancel removed from next-state cone
    - sampleip_map_t4_bw2: setup/hold/recovery/removal 0 violations (worst setup +0.079ns), USERCODE 0x00AF; BW_ENABLE=0 image unchanged (FS body 4a497b52...)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
2026-11-04 Add MEMV1 high-speed transfer design (PARLIO+DMA), offline
2026-11-04 Add the second 2026-11-05 handoff for the PC move: DDR3 DMA transfer, 25MHz phase windows, remaining tasks
2026-11-04 Verify MEMV1 CANCEL handling and independent DMA clocks on Tab5
2026-11-04 Capture probe mapping and isolate missing READY observation
2026-11-05 Qualify 20MHz reply phase diagnostic against baseline and preserve wire evidence
2026-11-05 Qualify symmetric 5MHz DMA and improve full transfer throughput by reducing guards
2026-11-05 Record DMA pipeline reuse, long-run qualification and RX-only failure diagnostics
2026-11-05 Document DMA pipeline throughput, CPU cost and revision-specific reset audit
2026-11-05 Qualify full-reset DMA pipeline and record rejected UPDATE-only reset optimization
2026-11-05 Qualify retained TX units and balanced 8MHz DMA with official-source references
2026-11-05 Track processing-level speedups, CPU costs and rejected optimizations across iterations
2026-11-05 Report every speedup per request with throughput, milliseconds and CPU-time change
2026-11-05 Record same-firmware cumulative stage costs and four-option 8MHz qualification
2026-11-05 Link GPU benchmark preparation and record DDR camera inference requirements
2026-11-05 Recheck concurrent local main integrations and supersede stale device preparation
2026-11-05 Reject incomplete SLogic captures and preserve provisional remapped probe evidence
2026-11-05 Record completed GPU MEM branch cleanup while retaining board work
2026-11-05 Record post-integration TX experiment limits and stable device restoration
2026-11-06 Prove complete YOLO inference beyond Tab5 PSRAM capacity
2026-11-07 Record physical matrix inference and next DDR chaining resource limits
2026-11-07 test(npu): preserve positive strip trace beside negative control
2026-11-08 Record ESP-IDF autonomous driver versions and live inference gate
